IITA-Proyectos/open-soccer-robocup-team2026/docs/competencia/assets/drafts/fig_arbol_fallos.png

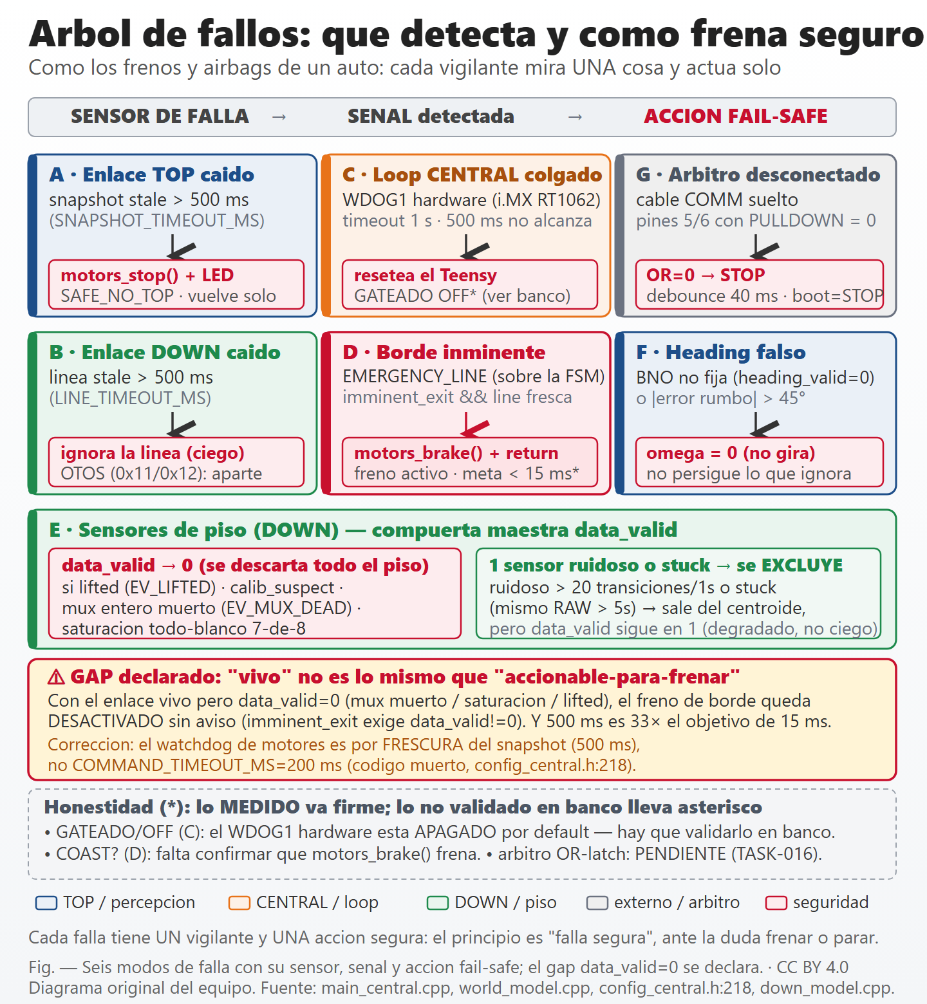
docs/competencia/assets/drafts/fig_arbol_fallos.png
