IITA-Proyectos/open-soccer-robocup-team2026/docs/competencia/assets/drafts/fig_capas_abstraccion.png

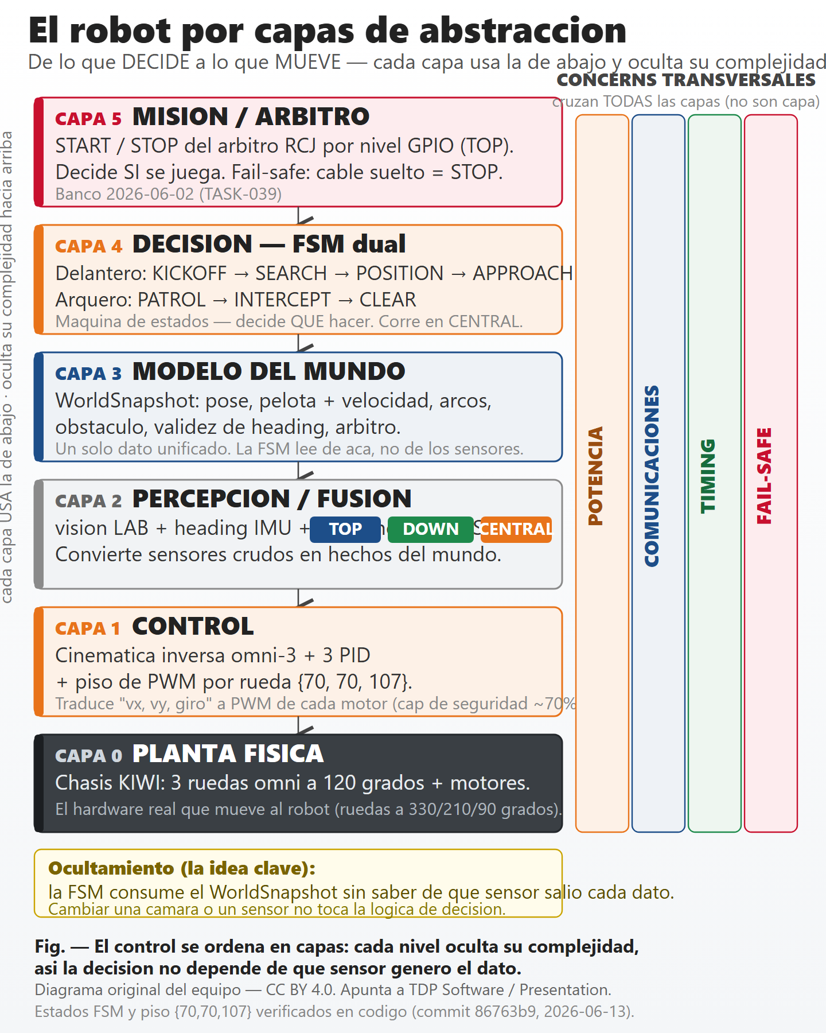
docs/competencia/assets/drafts/fig_capas_abstraccion.png
