IITA-Proyectos/open-soccer-robocup-team2026/hardware/electrical/README.md

# Sistema eléctrico

Documentación de baterías, motores, drivers y distribución de potencia.

## Contenido esperado

- Especificaciones de baterías (tipo, voltaje, capacidad, carga)
- Especificaciones de motores (TT motors, servos, solenoides)
- Drivers de motor (H-bridge, especificaciones, conexiones)
- Diagrama de distribución de potencia
- Cálculos de consumo y autonomía

## Del equipo 2025

Se usaron motores TT con drivers H-bridge. Revisar `legacy/2025-season/` para detalles.
