IITA-Proyectos/open-soccer-robocup-team2026/competition/rules/README.md

# Reglas de la competencia

Documentación de reglas vigentes para la temporada 2026.

## Reglas internacionales

- **[Reglas Soccer 2026 DRAFT](https://robocup-junior.github.io/soccer-rules/2026-soccer-draft-rules/rules.html)** ← USAR ESTAS
- [Reglas Soccer estables (master)](https://robocup-junior.github.io/soccer-rules/master/rules.html)
- [Scoring (puntaje)](https://robocup-junior.github.io/soccer-rules/master/scoring.html)
- [Especificaciones del campo](https://robocup-junior.github.io/soccer-rules/master/field_specification.html)
- [Especificaciones de la pelota](https://robocup-junior.github.io/soccer-rules/master/ball_specification.html)
- [Reglas SuperTeam](https://robocup-junior.github.io/soccer-rules/master/superteam_rules.html)
- [Reglas generales RoboCupJunior](https://junior.robocup.org/robocupjunior-general-rules/)

## NOTA: Nombre de la liga

A partir de 2026, Soccer Open se llama **Soccer Vision** y Soccer Lightweight se llama **Soccer Infrared**. Nuestro equipo compite en **Soccer Vision**.

## Restricciones físicas del robot (Soccer Vision)

| Parámetro | Límite | Recomendación |
|---|---|---|
| Diámetro | **18.0 cm** (cilindro) | ≤17.7 cm para inspecciones suaves |
| Altura | **18.0 cm** | ≤17.7 cm (sin contar handle ni top marker) |
| Peso | **Sin límite** | Minimizar para agilidad |
| Zona captura pelota | **1.5 cm** | ⚠️ Reducido de 3.0cm. Revisar dribbler |
| Voltaje máximo | 48V DC / 25V AC | Puntos de medición accesibles |
| Comunicación | 2.4 GHz, ≤100 mW EIRP | No garantizado |

## Communication Module — OBLIGATORIO

- Provisto por los organizadores en la competencia internacional
- Interfaz: **1 pin GPIO de 2.54mm** (start/stop)
- Alimentación: directo a batería (5.3V-25V) sin switch, 500mA mínimo
- Siempre encendido (incluso con robot fuera del campo)
- Debe estar a ≥1cm del borde exterior
- No cuenta para peso ni altura máxima
- Más info: https://github.com/robocup-junior/soccer-communication-module

## Handle (asa) — OBLIGATORIO

- Debe permitir levantar el robot
- **5 cm de clearance** entre parte más alta del robot y el asa
- Puede exceder el límite de altura
- Su peso cuenta en el total

## Top Marker — OBLIGATORIO

- Círculo plástico blanco, **≥4 cm de diámetro**
- Montado horizontal en la parte superior
- El árbitro escribe números con marcador
- Puede exceder el límite de tamaño
- Sin top marker = no puede jugar

## Documentación obligatoria para RoboCup 2026

| Entregable | Detalle | Deadline estimado |
|---|---|---|
| BOM | Componentes, proveedor, nuevo/reusado, kit/custom, precio | Antes de competencia |
| Poster A1 | 60×84cm, resumen del diseño | Llevar impreso |
| Video técnico | Demo funcional + proceso de diseño | Antes de competencia |
| Portfolio digital | Hardware + software completo | Antes de competencia |
| Código compartido | En GitHub repos oficiales de RoboCupJunior | Antes de competencia |

## Reglas nacionales (Argentina)

- [Reglas nacionales (Google Docs)](https://docs.google.com/document/d/10VgMxnmTzKQiAOIgHjWHb9KzwLUDc66N0ZvooTC_tL8/edit?tab=t.0)

**TODO**: Traducir los cambios de las reglas 2026 al castellano.
