IITA-Proyectos/open-soccer-robocup-team2026/hardware/electronics/MAPA-CONEXIONES-3-PLACAS.md

---
title: "Mapa único de conexiones — las 3 placas (UART + I²C + USB)"
date: 2026-06-02
status: vigente
area: hardware / firmware
tipo: referencia-consolidada
---

# Mapa de conexiones — TOP · CENTRAL · DOWN

> Referencia ÚNICA de qué puerto usa cada placa y para qué. Consolida lo que estaba
> disperso en los pinouts por placa. **La verdad de pines vive en el código**
> (`src/top/pinout_common.h` + `pinout_robotN.h`, `src/central/config_central.h`,
> `src/down/config_down.h`); si algo acá contradice al código vivo, gana el código.

## 0. ⚠️ Lo más importante: "Serial" NO es uno solo

En Teensy hay **dos cosas distintas** que se llaman "serial", y **no chocan entre sí**:

| Nombre | Qué es | Para qué |
|---|---|---|
| **`Serial`** | El **USB** (el conector + cable). Hardware aparte. | **Flashear y monitorear** (`pio device monitor`, `Serial.print` de debug). |
| **`Serial1`…`Serial8`** | Los **UART por pines** del Teensy. | Comunicación **entre placas**. |

👉 **Conclusión clave:** el USB (`Serial`) está **siempre disponible** para programar y
monitorear las **3 placas a la vez**, y **NO consume ningún pin** ni interfiere con los
enlaces entre placas. **No hay ningún UART que "liberar"** para simplificar la
programación — ya es independiente. (Teensy 4.0 tiene 7 UART y la 4.1 tiene 8; sobran.)

---

## 1. UART por placa

### TOP — Teensy 4.0 (master: visión + IMU + ToF + árbitros + fusión)
| Puerto | RX | TX | Conecta con | Baud | Para qué |
|---|----|----|---|---|---|
| **`Serial`** (USB) | — | — | PC | — | flasheo + monitor (debug) |
| **`Serial1`** | 0 | 1 | ← DOWN | 230400 | recibe odometría OTOS (pose + vel) + línea (`LineStatusV2`, broadcast; cacheada, no consumida aún) |
| **`Serial2`** | 7 | 8 | ↔ COMM (ESP32-C6) | 115200 | **partner ESP-NOW / status** (el árbitro NO viene por acá; ver §1.1) |
| **`Serial3`** | 15 | 14 | ← cámara **frontal** (U8) | 19200 | blobs pelota/arcos (11 bytes, contrato v2 CRC8) |
| **`Serial4`** | 16 | 17 | → CENTRAL | 230400 | envía `WORLD_SNAPSHOT` (100 Hz) |
| **`Serial5`** | 21 | 20 | ← cámara **trasera** | 19200 | blobs pelota/arcos (11 bytes, contrato v2 CRC8) |

> **⚠️ FIX 2026-06-02 (Gustavo, banco):** el Teensy 4.0 del TOP **NO expone `Serial7` (28/29)
> en el borde** — son pads SMD traseros, no cableables con header. TASK-204 había puesto el
> enlace a CENTRAL en `Serial7` por error y el TOP **nunca le llegaba** a la CENTRAL
> (`snap_fresh=N`). Mapeo REAL del TOP: **`Serial2` (7/8) = COMM**, **`Serial4` (16/17) =
> CENTRAL**. El lado CENTRAL (Teensy **4.1**) SÍ tiene 28/29 en el borde → su `Serial7` queda igual.

*Libres:* `Serial6` (24/25) no se usa como UART (esos pines los toma **`Wire2`** = LPI2C4, el bus del BNO055 primario; ver §3) · `Serial7` (28/29) = pads traseros del 4.0, **no usables**.

#### 1.1 Árbitro RCJ (START/STOP) — **NIVEL GPIO, no UART**
*(fix 2026-06-02 / TASK-039: el árbitro es NIVEL GPIO en pines 5/6 del TOP, no UART)*

El comando del árbitro RCJ (PLAY/STOP del partido) llega al TOP como **nivel digital GPIO**, **NO por UART**:

| Pin TOP | Señal | Nivel |
|---|---|---|
| **5** | OUT1 (PLAY/STOP) | **0 = juego PARADO · 1 = juego EN CURSO (3.3 V)** |
| **6** | OUT2 (segunda salida — **NO es espejo**: en PLAY sube SOLO uno de los dos) | misma semántica que OUT1; el firmware combina por **OR** |

- Firmware (`src/top/comm_arbiter.cpp`): `read_referee_gpio()` lee los pines 5/6 con `INPUT_PULLDOWN`; `match_running = (pin5 O pin6)` en alto (**OR**). En PLAY el COMM sube **solo uno** de los dos pines (5 *o* 6) y el otro queda en 0 (probado en banco 2026-06-02, Gustavo): por eso el viejo AND nunca daba GO y el OR sí. Sigue siendo *fail-safe*: si se desconecta el cable del COMM, ambos pines leen 0 por el `INPUT_PULLDOWN` → `match_running=false` (STOP).
- El `Serial2` (7/8) del enlace a COMM queda **SOLO para partner ESP-NOW / status**; el viejo frame `COMM_REFEREE_CMD` por UART quedó **obsoleto**.
- ⚠️ **El cambio es solo la FUENTE en el TOP.** El `match_running` / `referee_cmd` sigue viajando **dentro del `WORLD_SNAPSHOT`** que el TOP manda a la CENTRAL; la CENTRAL y la strategy lo consumen igual que antes.

### CENTRAL — Teensy 4.1 sobre Zircon Rev v15 (cerebro: FSM + PIDs + motores)
| Puerto | RX | TX | Conecta con | Baud | Para qué |
|---|----|----|---|---|---|
| **`Serial`** (USB) | — | — | PC | — | flasheo + monitor (debug) |
| **`Serial7`** | 28 | 29 | ← TOP | 230400 | recibe `WORLD_SNAPSHOT` |
| **`Serial1`** | 0 | 1 | ← DOWN | 230400 | recibe `LINE_URGENT` / `LineStatusV2` + odometría OTOS (`Pose2D`/`Velocity2D`, broadcast; OTOS para control de movimiento — Capa 2) |

*Motores:* GPIO directo (INA/INB/PWM), **no UART**. *Kicker:* **no existe** — el robot no tiene kicker físico; el delantero empuja la pelota por inercia (TASK-011 cancelada 2026-06-03).
*✅ Reasignado 2026-05-31 (decisión Gustavo, cableado en banco):* el link a **TOP usa `Serial7` (28/29)** y el de **DOWN usa `Serial1` (0/1)**. Así `Serial2` (pines 7/8) queda **LIBRE para el driver del motor 2 (U17)** → el viejo conflicto **F8/TASK-036 está RESUELTO** (ya no hay UART en 7/8).

### DOWN — Teensy 4.0 (sensores de piso: 32 línea + 2 OTOS)
| Puerto | RX | TX | Conecta con | Baud | Para qué |
|---|----|----|---|---|---|
| **`Serial`** (USB) | — | — | PC | — | flasheo + monitor (debug) |
| **`Serial1`** | 0 | 1 | → CENTRAL | 230400 | difunde línea (`LineStatusV2`) + odometría OTOS (broadcast) |
| **`Serial5`** | 21 | 20 | → TOP | 230400 | difunde línea (`LineStatusV2`) + odometría OTOS (broadcast) |

---

## 2. Enlaces entre placas (las dos puntas)

> Cada enlace usa un **nombre de Serial distinto en cada punta** (son Teensy distintos
> en placas separadas; lo único que importa es el **pin físico + GND común**). Hay dos
> "Serial5" y dos "RX en pin 0" en el sistema — **no colisionan** porque están en placas
> distintas.

| Enlace | TX (placa · puerto · pin) | RX (placa · puerto · pin) | Baud | Estado |
|---|---|---|---|---|
| **TOP → CENTRAL** (snapshot) | TOP · `Serial4` · **pin 17** (TX4) | CENTRAL · `Serial7` · **pin 28** (RX7) | 230400 | 🔧 fix 2026-06-02 (era `Serial7` en el TOP, inexistente en el borde del 4.0) |
| **DOWN → TOP** (línea + odometría OTOS) | DOWN · `Serial5` · **pin 20** | TOP · `Serial1` · **pin 0** | 230400 | ⚠️ sin cablear |
| **DOWN → CENTRAL** (línea + odometría OTOS) | DOWN · `Serial1` · **pin 1** | CENTRAL · `Serial1` · **pin 0** | 230400 | ✅ cable validado (DOWN→CENTRAL OK en banco 2026-06-02) |
| **TOP ↔ COMM** (partner ESP-NOW / status) | TOP · `Serial2` · **7/8** | COMM (ESP32-C6) | 115200 | 🔧 fix 2026-06-02 (era `Serial4`) · el árbitro NO viaja por acá: es NIVEL GPIO en pines 5/6 del TOP (TASK-039, ver §1.1) |
| **cámara frontal → TOP** | cam · UART3 | TOP · `Serial3` · pin 15 | 19200 | ✅ FORMATO OK |
| **cámara trasera → TOP** | cam · UART3 | TOP · `Serial5` · pin 21 | 19200 | ✅ FORMATO OK |

**Siempre:** cada enlace necesita **GND común** entre las dos placas.

---

## 3. I²C (ToF, BNO, OTOS) — NO son UART

I²C es un **bus**: muchos chips comparten **los mismos 2 pines** (SDA + SCL) y se
distinguen por **dirección**, no por pin. "Comparten pines" a propósito. Es un
periférico distinto de los UART y del USB.

### TOP — 3 buses I²C del Teensy 4.0
> **🔧 CORRECCIÓN 2026-06-09 (i2c scan en banco, commit 9da8e9e):** el Teensy 4.0 tiene
> **3 buses I²C**: `Wire` (LPI2C1, pines 18/19) · `Wire1` (LPI2C3, pines 16/17) · `Wire2`
> (LPI2C4, pines **24/25**). El 2º BNO055 del TOP está **físicamente en los pines 24/25**
> (pads traseros, "debajo" del Teensy) = bus **`Wire2`**. El repo lo llamaba mal "Wire1"
> porque 24/25 se confundían con Wire1; el bus real de 24/25 es **`Wire2`**. `Wire1` (16/17)
> queda vacío.

| Bus | SDA | SCL | Chips (dirección) |
|-----|-----|-----|---|
| **`Wire`** (LPI2C1) | **18** | **19** | BNO055 **SECUNDARIO** (0x28) + **4 ToF** VL53L7CX (0x2A · 0x2B · 0x2C · 0x2D) |
| **`Wire2`** (LPI2C4) | **25** | **24** | BNO055 **PRIMARIO** (0x28) — solo en su bus, sin ToF |
| `Wire1` (LPI2C3) | 16 | 17 | **vacío** (pines tomados por Serial4 = UART a CENTRAL) |

- **El BNO055 primario está SOLO en `Wire2` (24/25)** y el secundario comparte `Wire`
  (18/19) con los 4 ToF. Ambos son 0x28 (no chocan porque están en buses distintos).
- **Convención primario/secundario (decisión Gustavo 2026-06-09):** el BNO que está **solo
  en su bus** (`Wire2`, sin ToF) **no sufre contención I²C con los ToF** → es el **más
  confiable** y la **fuente de heading preferida** = **PRIMARIO**. El que comparte bus con
  los 4 ToF es el que se **congela** cuando el read del BNO choca con los ToF → es el
  **respaldo** = **SECUNDARIO**. (Esto define además el fix de fondo de ROBOT1: hoy ROBOT1
  tiene 1 BNO en `Wire` con los ToF = posición "secundaria"; el fix es agregarle un BNO en
  `Wire2` solo, como primario.)
- Los 4 ToF arrancan todos en 0x29 (chocarían) → cada uno tiene una pata **LP** a un
  GPIO (**pines {9, 10, 11, 12}**, eso **NO es I²C**, es GPIO) que al boot los despierta
  de a uno y les reasigna 0x2A..0x2D. ⚠️ Las direcciones **persisten con 3V3** →
  **power-cycle obligatorio** al re-enumerar.
- ⚠️ **pin 10** (LP del ToF[1]) choca con el dipswitch de rol del TOP → resolver (F7).

### CENTRAL — sin I²C
**No hay BNO ni ningún chip I²C en la CENTRAL** (los 2 BNO están en el TOP). El heading
absoluto del robot llega desde el TOP por `WORLD_SNAPSHOT`. *(El módulo `imu_zircon` del
firmware queda como compat: si no hay sensor, `imu_init()` cae por timeout y no se usa.)*

### DOWN — 2 OTOS en 2 buses separados
| Bus | SDA | SCL | Chip (dirección) |
|-----|-----|-----|---|
| **`Wire`** (I²C0) | **18** | **19** | OTOS **U5** (0x17) |
| **`Wire1`** (I²C1) | **17** | **16** | OTOS **U6** (0x17) |

- Los 2 OTOS tienen la **misma dirección fija 0x17** (no se puede cambiar) → **no pueden
  ir en el mismo bus** → van en **dos buses distintos** (`Wire` + `Wire1`). (Es lo
  opuesto a los ToF, que sí reasignan dirección y por eso comparten un bus.)
- Los 32 sensores de línea NO son I²C: son 4 muxes CD4051 con 12 pines SEL (pines 2–13) + 4 entradas ADC.

---

## 4. ¿Hay algún pin compartido problemático?

- **I²C vs UART:** en ninguna placa se pisan. TOP: I²C en 18/19 (`Wire`) + 24/25 (**`Wire2`**, BNO055 primario), UART en 0/1·7/8·14/15·16/17·20/21. DOWN: I²C en 18/19 (`Wire`) + 16/17 (`Wire1`), UART en 0/1·20/21. CENTRAL: sin I²C.
- **USB vs todo:** el USB (`Serial`) es independiente — nunca compite con UART ni I²C.
- **✅ Conflicto 7/8 RESUELTO (2026-05-31):** en la **CENTRAL**, el link DOWN→CENTRAL se movió a `Serial1` (0/1), así que los pines 7/8 quedan para el motor 2 (U17). ⚠️ Ojo: el "7/8" del **TOP** es otra cosa — ahí `Serial2` (7/8) = COMM; son placas distintas, no colisionan.
- **🔧 FIX UART TOP (2026-06-02):** el Teensy 4.0 del TOP no expone `Serial7` (28/29 = back-pads). Mapeo corregido: **COMM → `Serial2` (7/8)**, **CENTRAL → `Serial4` (16/17)**. **No quedan conflictos de UART abiertos.**

---

## 5. Dónde está el detalle por placa (docs canónicos)
- **TOP:** [`top-board-pack/01-pinout-y-hardware.md`](top-board-pack/01-pinout-y-hardware.md) §2.
- **DOWN:** [`down-board-pack/01-pinout-y-posiciones.md`](down-board-pack/01-pinout-y-posiciones.md).
- **CENTRAL:** [`central-board-pack/01-pinout-y-hardware.md`](central-board-pack/01-pinout-y-hardware.md) + `src/central/config_central.h`.
- **Flujo de datos / arquitectura:** [`../../docs/ARQUITECTURA-3-PLACAS-2026.md`](../../docs/ARQUITECTURA-3-PLACAS-2026.md).
- **Protocolo de los enlaces:** `src/shared/proto.h` (START / CRC16 / SEQ / END) + `docs/firmware/CONTRATO-DATOS-*.md`.
