IITA-Proyectos/open-soccer-robocup-team2026/hardware/electronics/top-board-pack/02-funcionalidad.md

---
title: "Placa TOP — Especificación funcional (qué hace y cómo)"
date: 2026-05-24
status: vigente
parte-de: top-board-pack
basado-en: docs/firmware/FIRMWARE-PLACA-ARRIBA.md (curado, separando Nivel 1+2 vivo de Nivel 3+ aspiracional)
---

# Placa TOP — Especificación funcional

> Para el pinout completo del Teensy 4.0 master ver [`01-pinout-y-hardware.md`](01-pinout-y-hardware.md).
> Para el contrato binario del WorldSnapshot que TOP envía a CENTRAL ver [`03-contrato-datos-top.md`](03-contrato-datos-top.md).
> Para el protocolo de las cámaras OpenMV ver [`04-contrato-datos-camaras.md`](04-contrato-datos-camaras.md).
> Para el diseño general de comunicaciones de las 3 placas ver [`05-protocolo-comunicaciones.md`](05-protocolo-comunicaciones.md).
> Para el contexto general de las 3 placas ver [`06-arquitectura-3-placas.md`](06-arquitectura-3-placas.md).

## 1. Qué es la placa TOP

La placa TOP es el **cerebro sensorial** del robot. No toma decisiones tácticas
ni controla motores — su trabajo es **ver, fusionar y entregar conocimiento**.

**Entrega al CENTRAL cada 10 ms (100 Hz)** un único struct `WorldSnapshot`
(27 B, v2) con:
- **Pose propia**: x, y, heading + vx, vy, omega + confianza 0–100.
- **Pelota**: posición + velocidad estimada + confianza. Si no es visible, se
  predice por inercia con confianza decayente.
- **Compañero** (futuro): pose recibida vía ESP-NOW.
- **Rivales** (futuro): hasta 2 oponentes estimados.
- **Arcos**: posiciones fijas conocidas, confirmadas cuando se ven.
- **Comando árbitro**: start/stop/halftime recibido por la placa COMM.
- **Flags**: match_running, in_own_penalty_area, partner_alive, partner_sees_ball, IMU degradado, etc.

## 2. ⚙️ Estado de implementación (lo vivo vs lo aspiracional)

**Esta es la separación más importante del doc**, porque la versión histórica
de `FIRMWARE-PLACA-ARRIBA.md` describe Nivel 3+ ambicioso que NO está
implementado todavía.

| Subsistema | Nivel | Estado | Dónde |
|---|---|---|---|
| Parser OpenMV (2 cámaras) | 1 | ✅ vivo | `firmware/top/cameras.{h,cpp}` |
| Fusión cámaras (front + back, rot 180°, watchdog) | 2 | ✅ vivo + 16 tests | `firmware/shared/cameras_fusion.{h,cpp}` + `firmware/top/cameras_runtime.{h,cpp}` |
| BNO055 dual (lectura + consistencia) | 2 | ✅ vivo | `firmware/top/sensors_imu.{h,cpp}` |
| HC-SR04 (frontal) | 1 | ✅ vivo (bloqueante 25 ms) | `firmware/top/sensors_tof.{h,cpp}` |
| **ToF VL53L7CX** | 4 (HW) | ⚠️ HW OK (enumeran 0x2A..0x2D), firmware lee 1 (Sprint B pendiente) | `firmware/top/sensors_tof.{h,cpp}` |
| Comm con COMM (Serial2) | 1 | ✅ vivo (arbiter) | `firmware/top/comm_arbiter.{h,cpp}` |
| Comm con DOWN (Serial1) | 1 | ✅ vivo | `firmware/top/comm_down.{h,cpp}` |
| Comm con CENTRAL (**Serial4**, fix 2026-06-02) | 1 | ✅ vivo | `firmware/top/comm_central.{h,cpp}` |
| **WorldSnapshot v2 con `ball_vx/vy`** | 2 | ⚠️ struct definido pero `cameras_runtime` no llena los campos (quedan en 0) | `firmware/shared/types.h` + tests `test_central_contract` |
| EKF de pose absoluta | 3 | ⏳ futuro | — |
| Kalman pelota (predicción cuando no se ve) | 3 | ⏳ futuro | — |
| Trilateración con ToF para pose XY | 3 | ⏳ futuro (requiere ToF activos) | — |
| Partner comm (ESP-NOW) | 3 | ⏳ **decisión: NO implementar para Incheon** | `docs/decisions/2026-05-17-comunicacion-inter-robot-superteam.md` |
| Estimación de rivales | 4 | ⏳ futuro (Mundial 2027) | — |

## 3. Responsabilidades funcionales

| # | Responsabilidad | Estado | Frecuencia |
|---|---|---|---|
| R1 | Inicializar y mantener los 2 BNO055 (modo IMUPLUS) | ✅ | 100 Hz |
| R2 | Detectar discrepancias entre los 2 BNO055 | ✅ | 100 Hz |
| R3 | Estrategia de reseteo del IMU ante impacto detectado | ⚠️ parcial | evento |
| R4 | Inicializar y leer los 4 ToF multizona | ❌ STUB | 15–30 Hz |
| R5 | Procesar matriz 8×8 de cada ToF para detectar paredes | ❌ futuro | 15–30 Hz |
| R6 | Trilateración con ToF → pose XY del robot | ❌ futuro | 15–30 Hz |
| R7 | Parser robusto del protocolo OpenMV (2 cámaras) | ✅ | ~30 Hz |
| R8 | Fusionar visión dual (frente + atrás) | ✅ | 30 Hz |
| R9 | Recibir ODOM_POSE/VEL del DOWN | ✅ | 100 Hz |
| R10 | Fusión sensorial EKF → pose propia con confianza | ❌ futuro | 100 Hz |
| R11 | Predicción Kalman de pelota | ❌ futuro | 100 Hz |
| R12 | Estimación de rivales | ❌ futuro | 30 Hz |
| R13 | Comm con placa COMM (recibir árbitros) | ✅ | 100 Hz |
| R14 | Recibir partner via COMM (ESP-NOW) | ❌ no para Incheon | 10 Hz |
| R15 | Construir `WorldSnapshot` y enviar a CENTRAL | ✅ | 100 Hz |
| R16 | Recibir comandos administrativos del CENTRAL | ✅ | eventos |
| R17 | Detección de IMU/cámara fallando | ✅ parcial | continuo |
| R18 | Recovery: degradación elegante si una fuente cae | ✅ | continuo |
| R19 | Diagnóstico USB + LED de estado | ✅ | 1 Hz |
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
