IITA-Proyectos/open-soccer-robocup-team2026/docs/competencia/assets/drafts/fig_arbol_salud.png

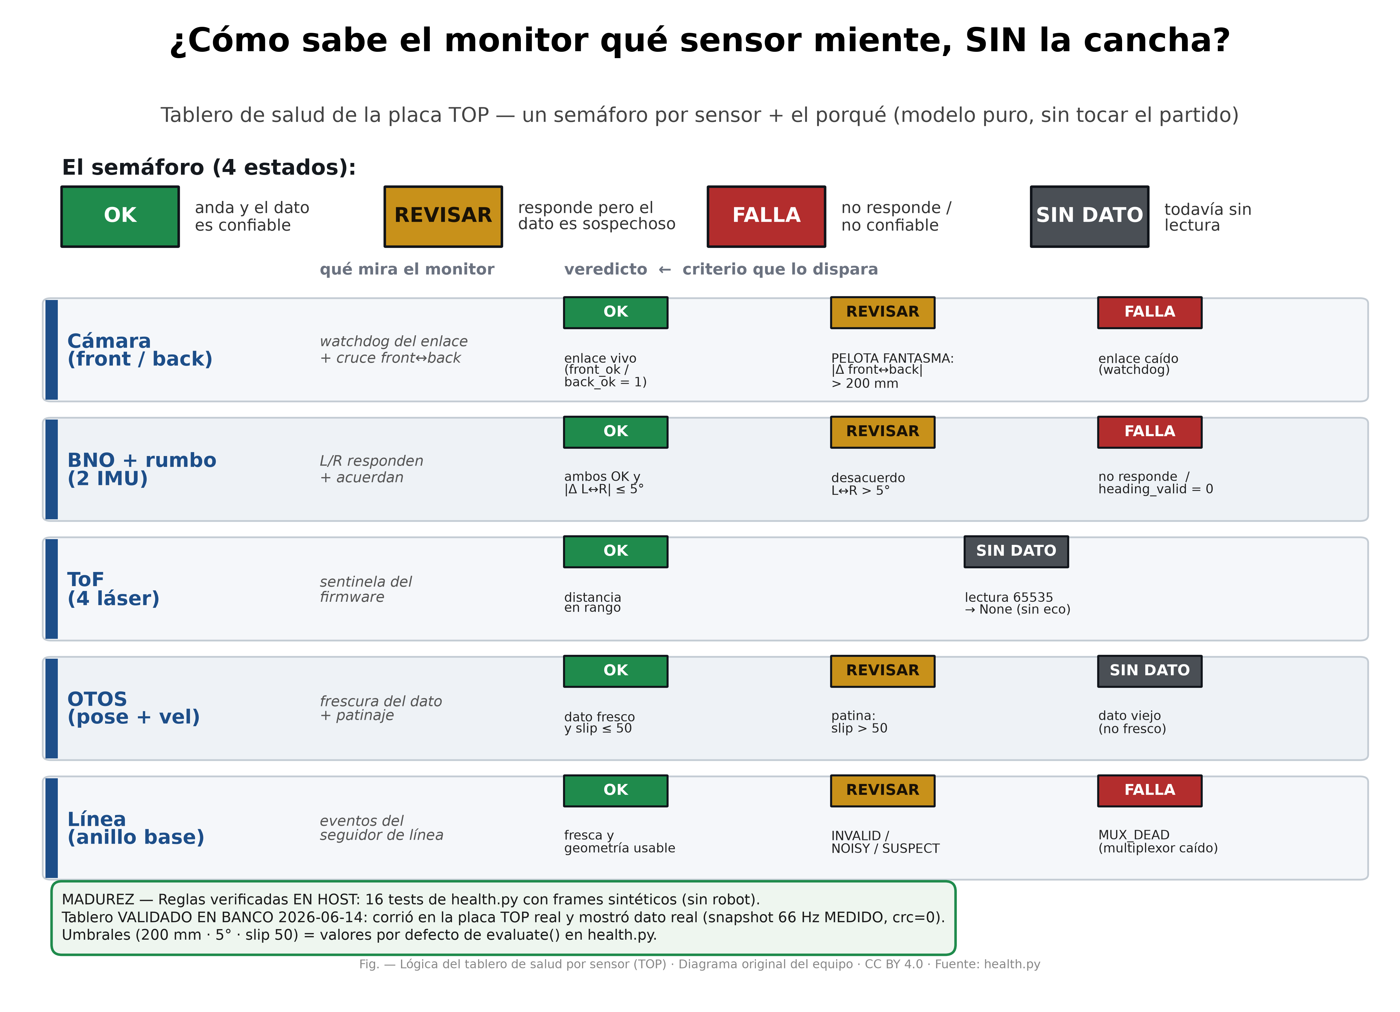
docs/competencia/assets/drafts/fig_arbol_salud.png
