IITA-Proyectos/open-soccer-robocup-team2026/docs/competencia/assets/drafts/fig_electrico_distribucion.png

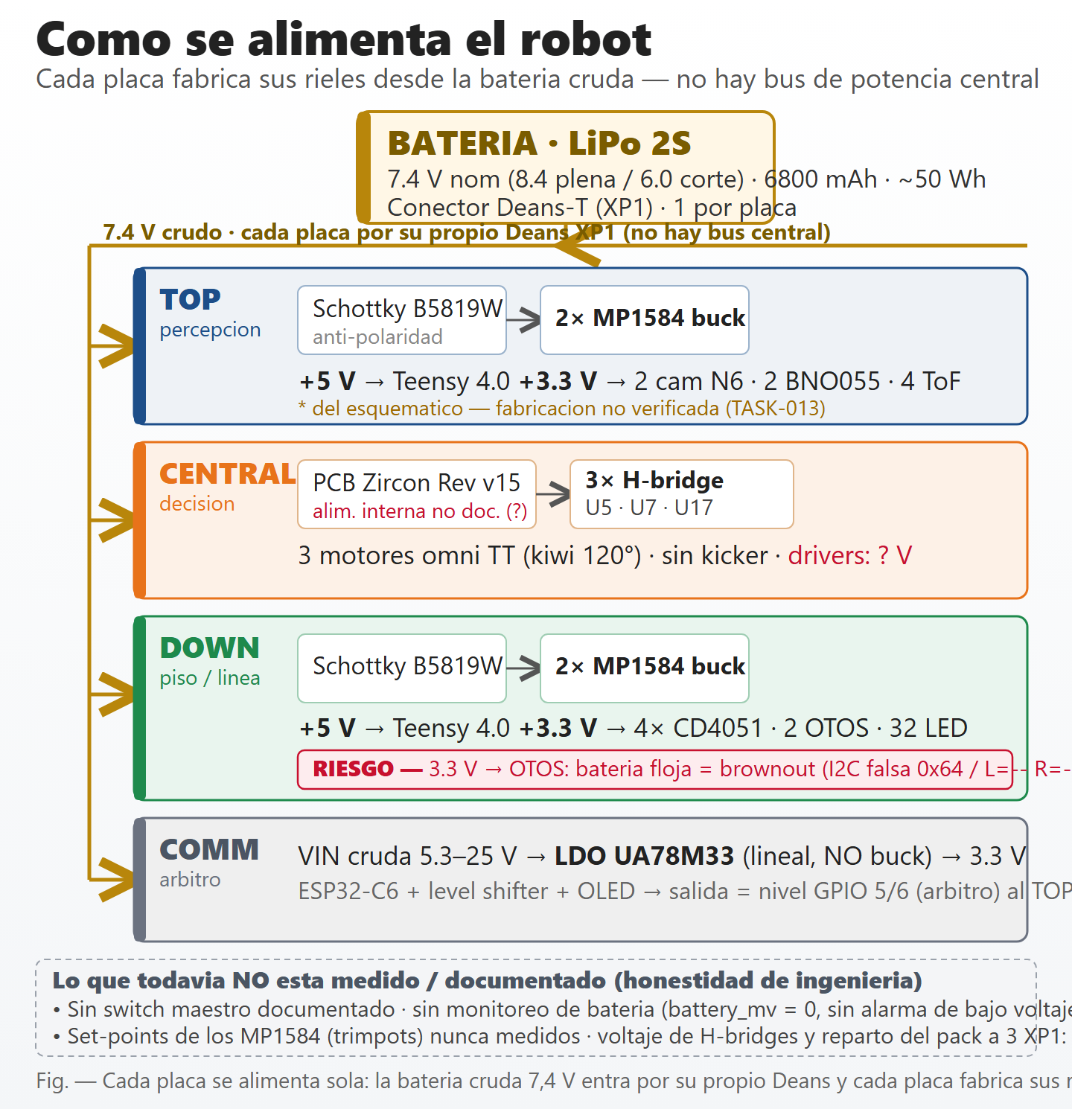
docs/competencia/assets/drafts/fig_electrico_distribucion.png
