IITA-Proyectos/open-soccer-robocup-team2026/docs/competencia/assets/drafts/fig_frame_uart_errores.png

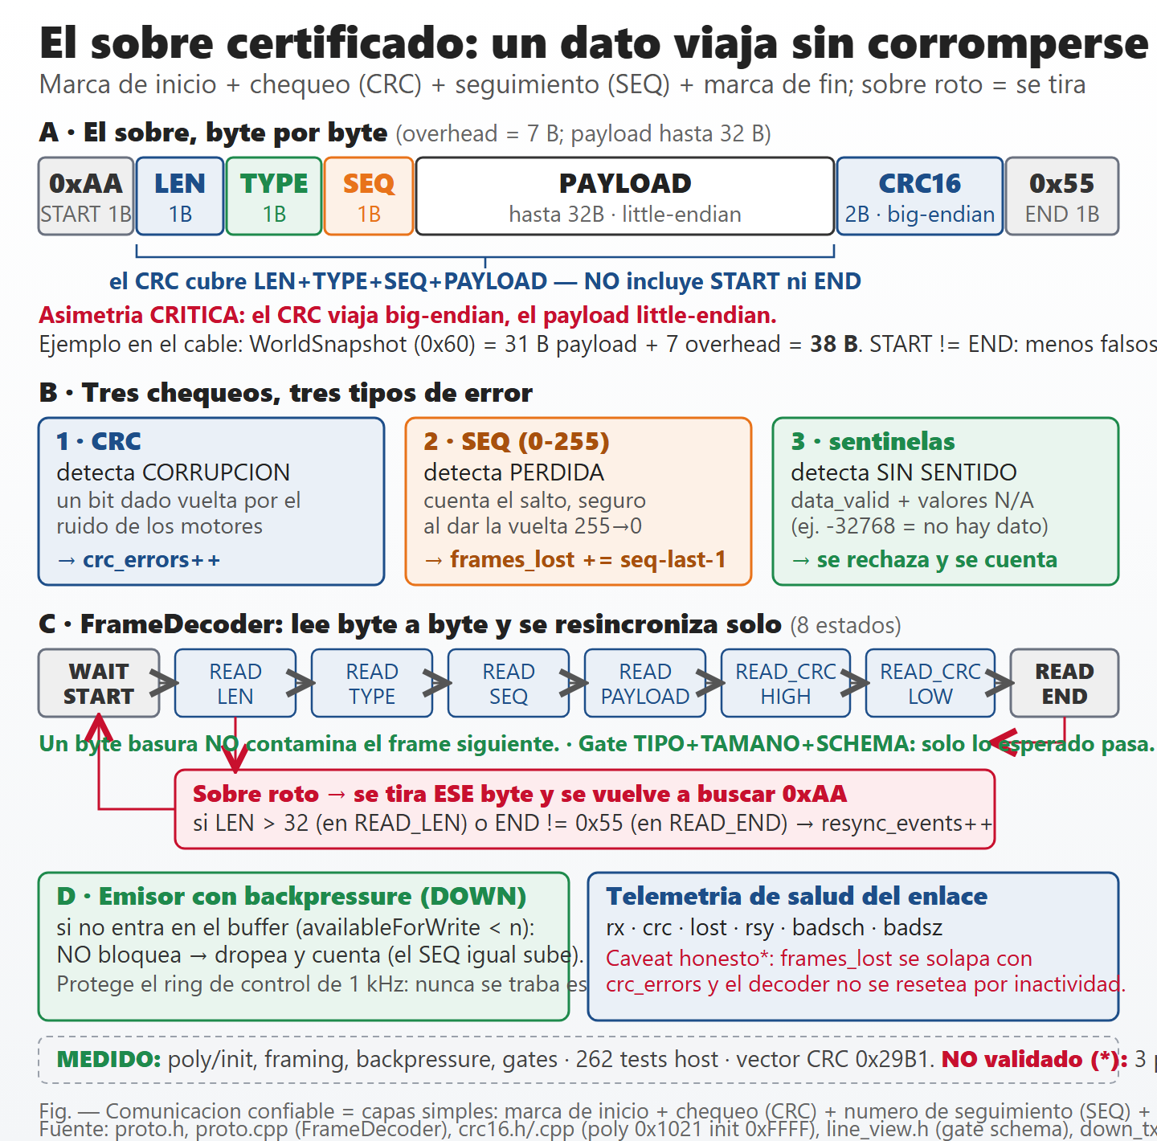
docs/competencia/assets/drafts/fig_frame_uart_errores.png
