IITA-Proyectos/open-soccer-robocup-team2026/docs/competencia/assets/drafts/fig_fsm_dual.png

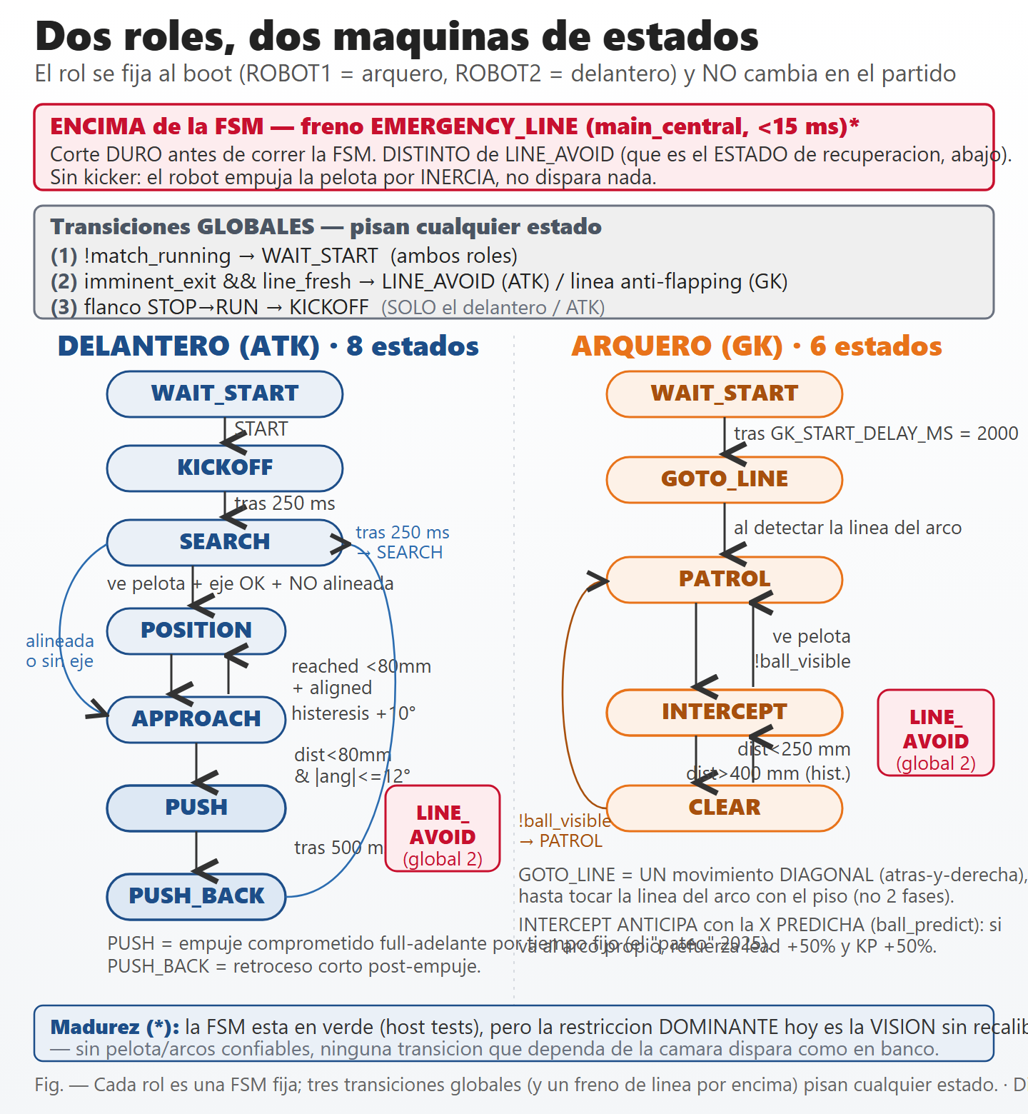
docs/competencia/assets/drafts/fig_fsm_dual.png
