IITA-Proyectos/open-soccer-robocup-team2026/docs/competencia/assets/drafts/fig_funcionamiento_2modulos.png

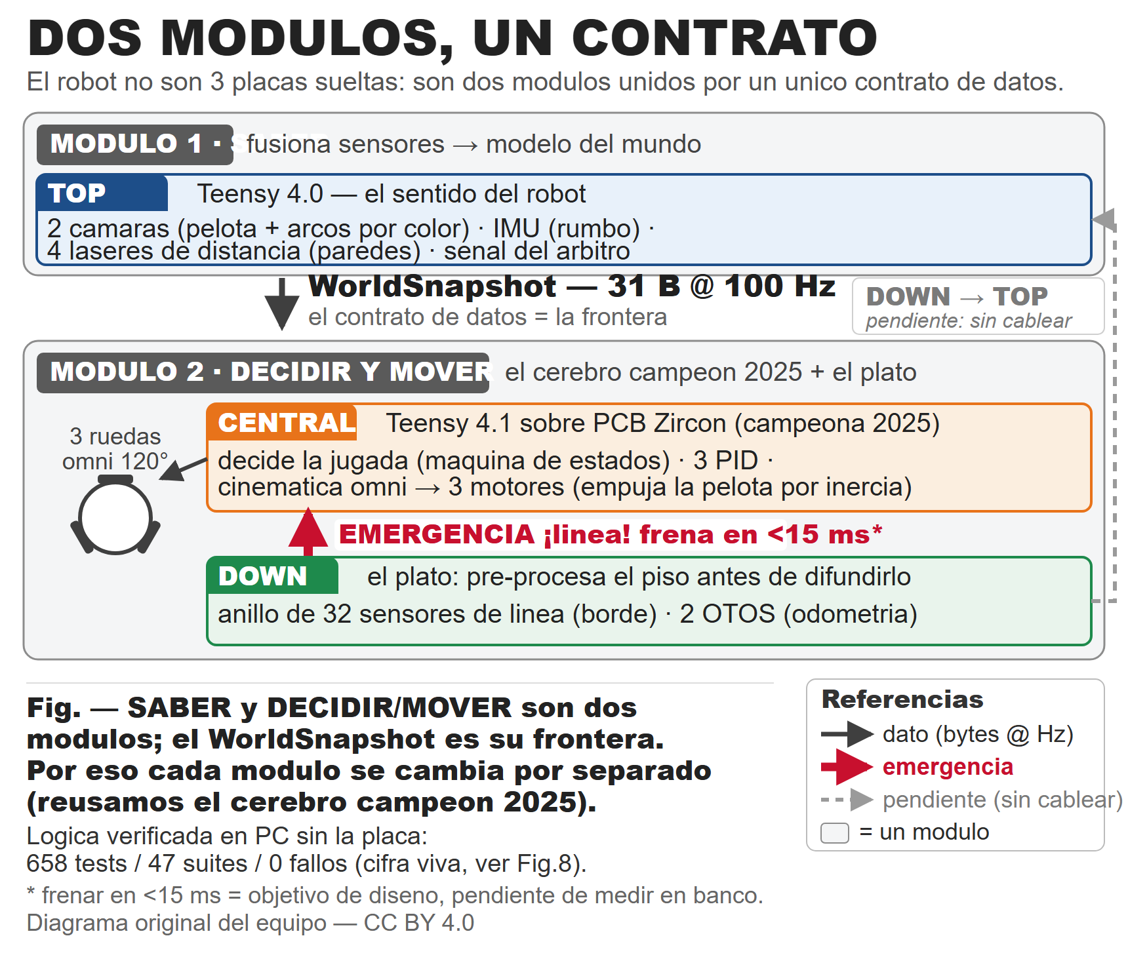
docs/competencia/assets/drafts/fig_funcionamiento_2modulos.png
