IITA-Proyectos/open-soccer-robocup-team2026/docs/competencia/assets/drafts/fig_fusion_snapshot.png

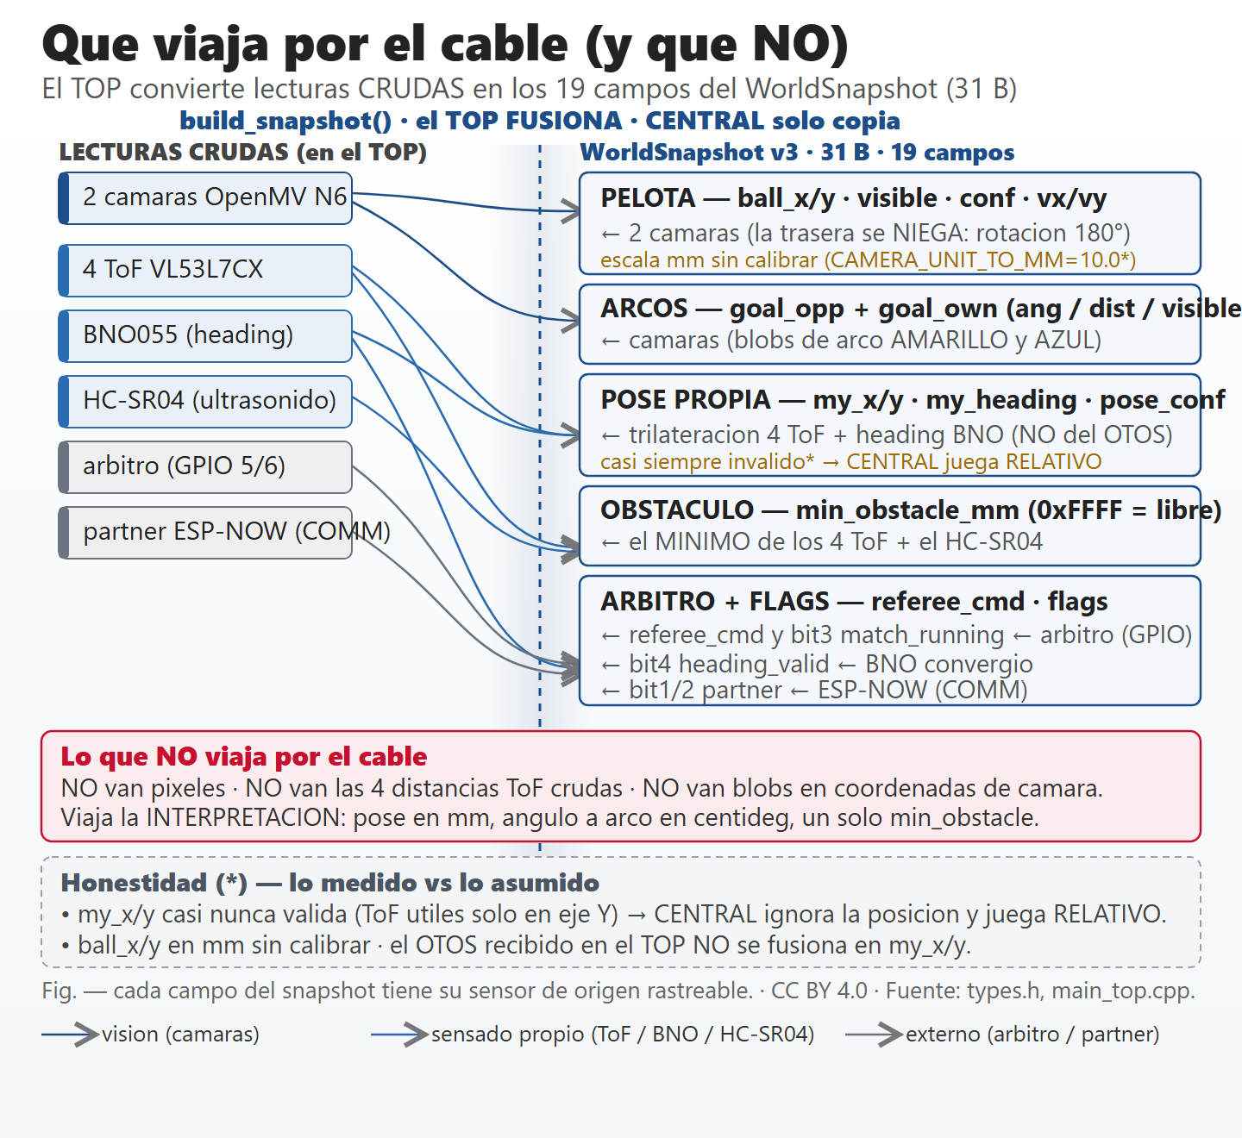
docs/competencia/assets/drafts/fig_fusion_snapshot.png
