IITA-Proyectos/open-soccer-robocup-team2026/docs/competencia/assets/drafts/fig_layout_cobertura.png

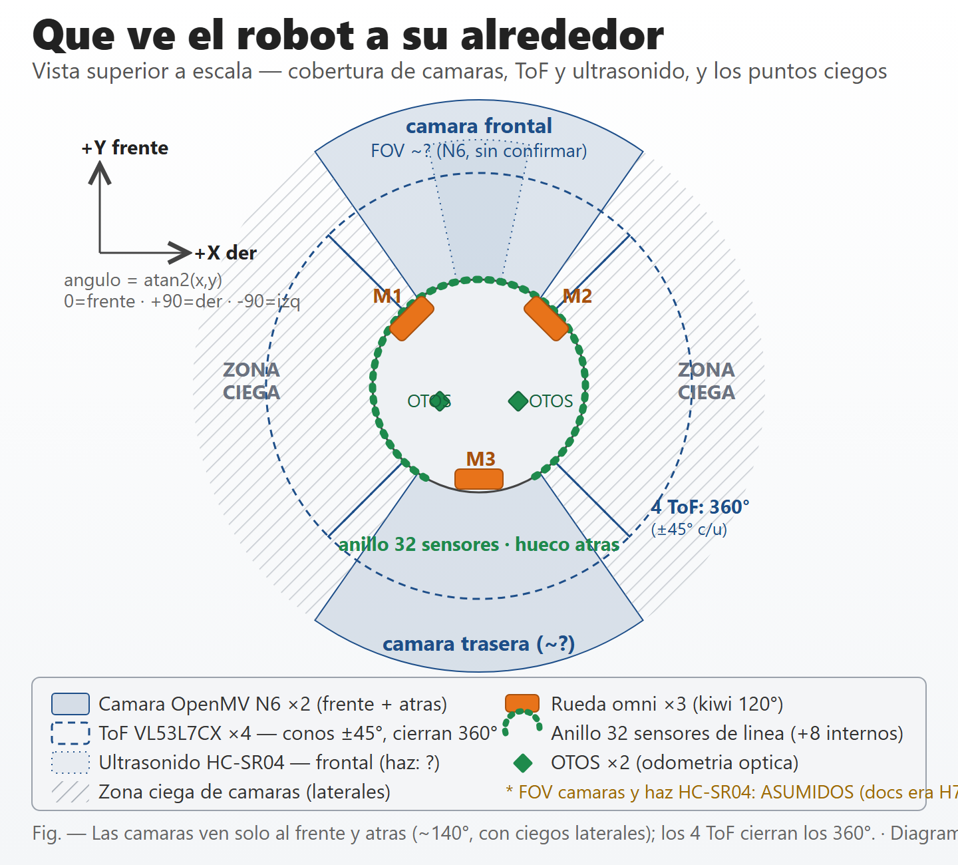
docs/competencia/assets/drafts/fig_layout_cobertura.png
