IITA-Proyectos/open-soccer-robocup-team2026/docs/competencia/assets/drafts/fig_localizacion_fusion.png

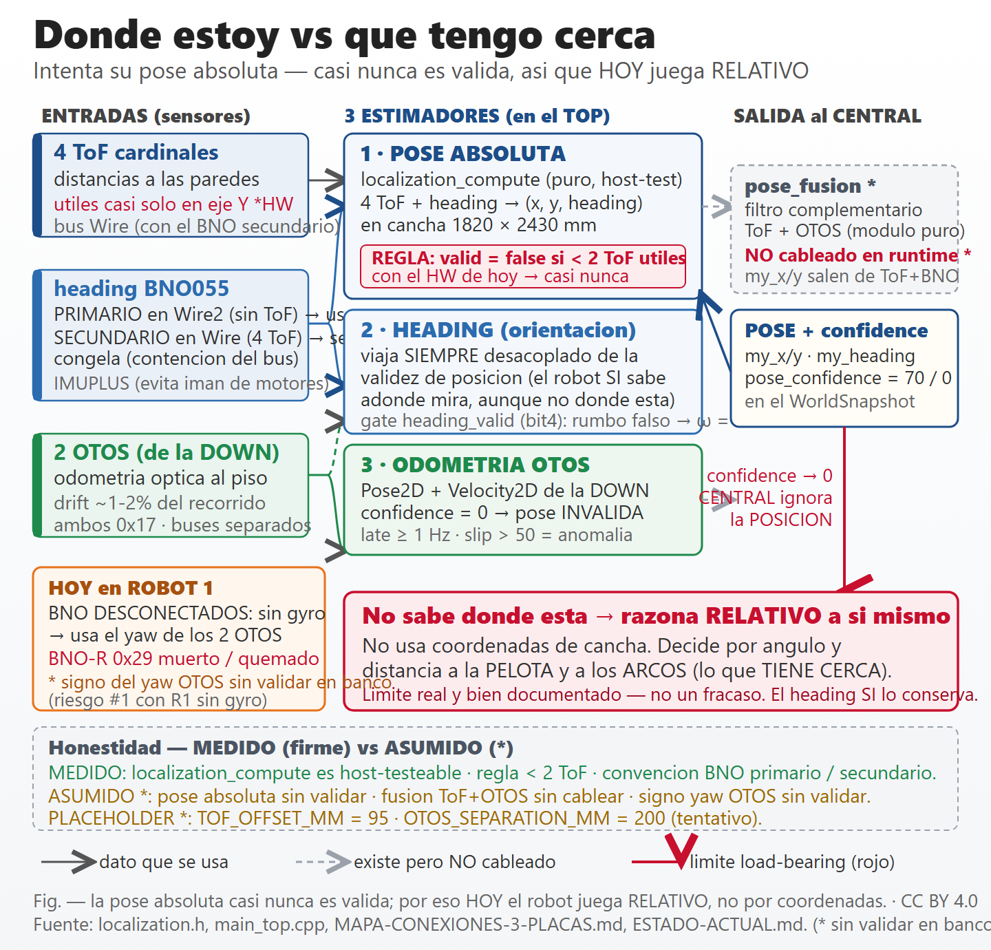
docs/competencia/assets/drafts/fig_localizacion_fusion.png
