IITA-Proyectos/open-soccer-robocup-team2026/docs/competencia/assets/drafts/fig_madurez_escalera.png

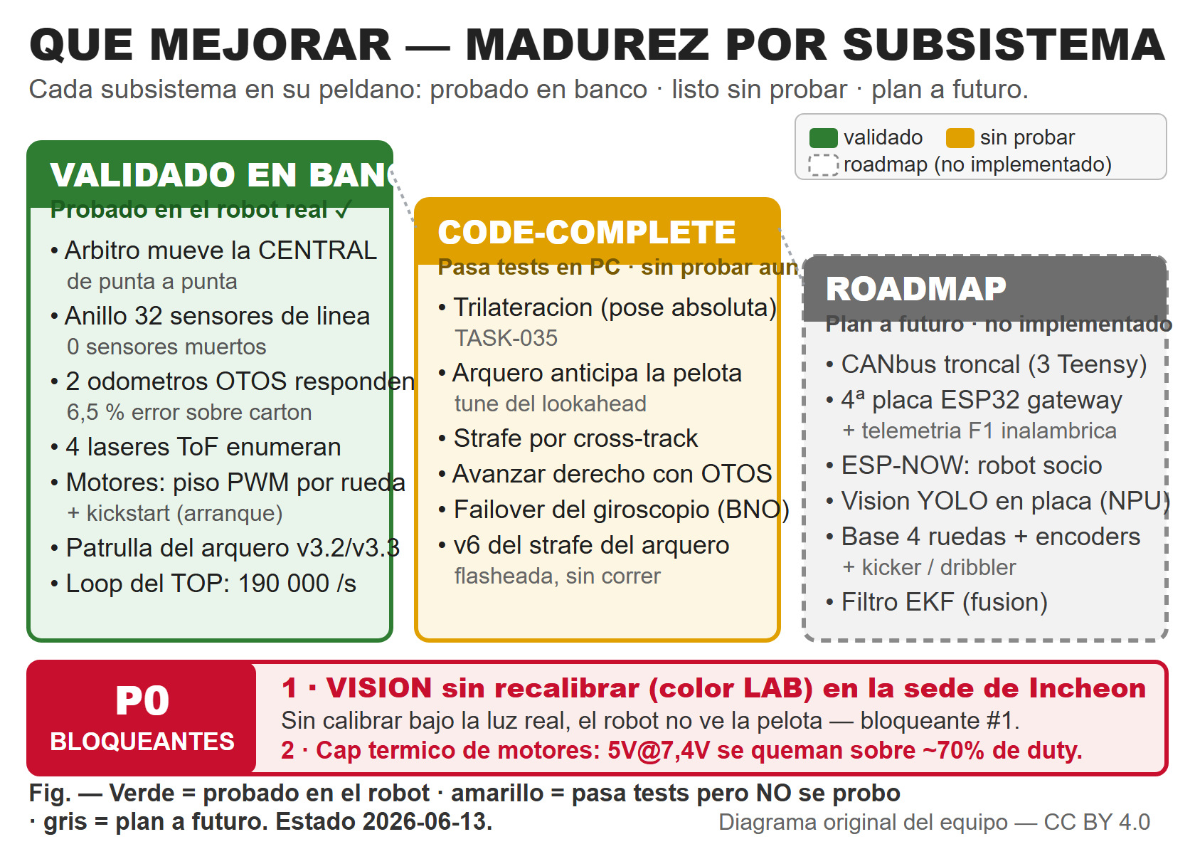
docs/competencia/assets/drafts/fig_madurez_escalera.png
