IITA-Proyectos/open-soccer-robocup-team2026/docs/competencia/assets/drafts/fig_pila_placas_lateral.png

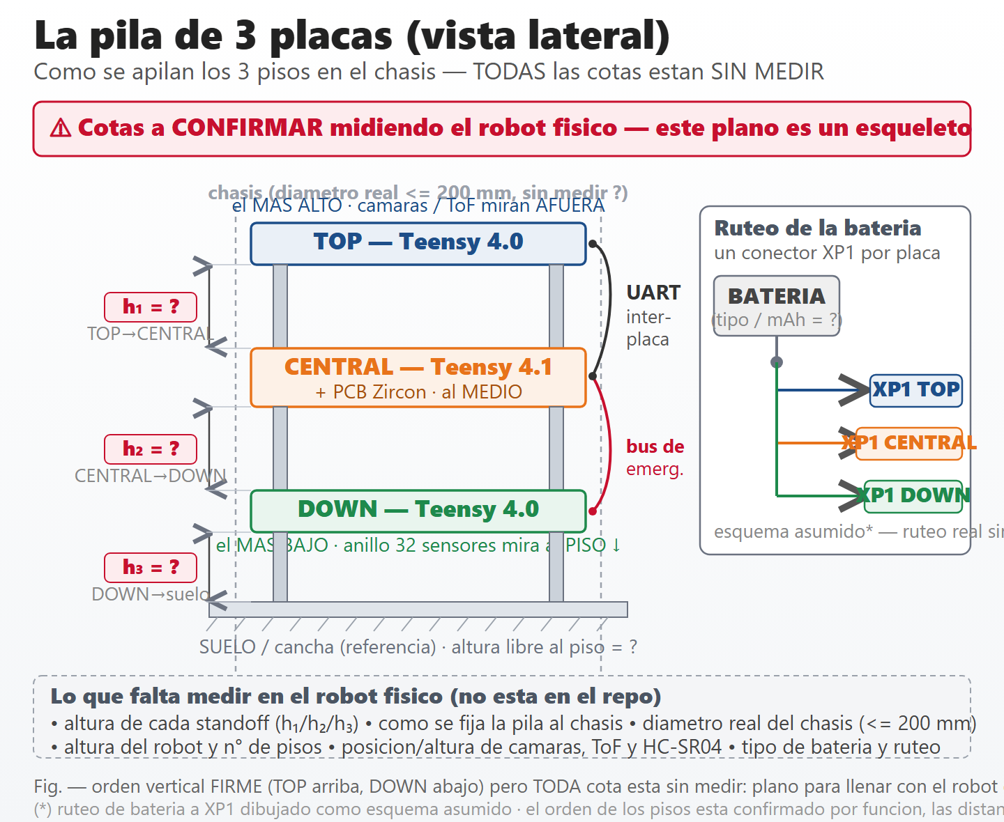
docs/competencia/assets/drafts/fig_pila_placas_lateral.png
