IITA-Proyectos/open-soccer-robocup-team2026/docs/competencia/assets/drafts/fig_pipeline_vision.png

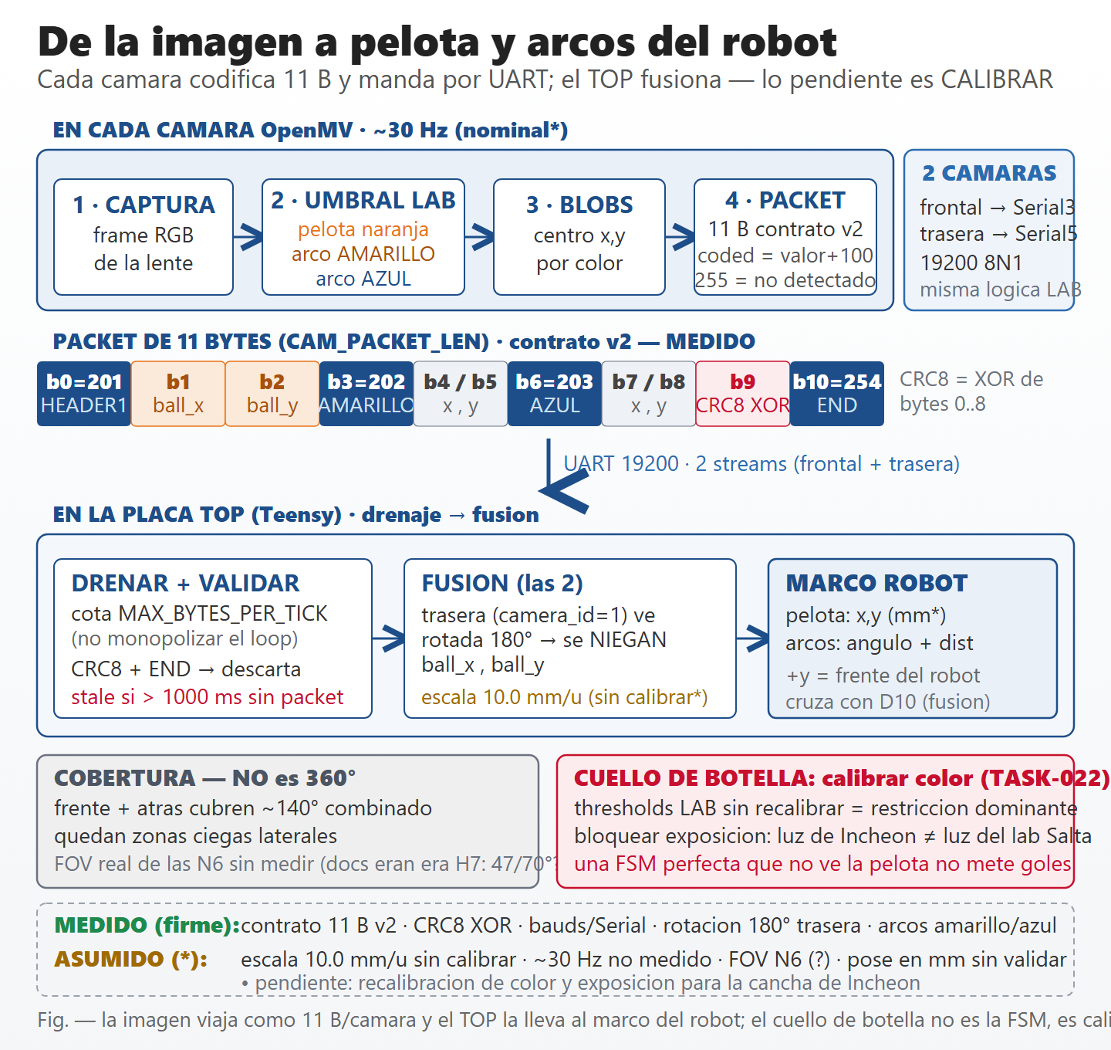
docs/competencia/assets/drafts/fig_pipeline_vision.png
