IITA-Proyectos/open-soccer-robocup-team2026/docs/competencia/assets/drafts/fig_presupuesto_temporal.png

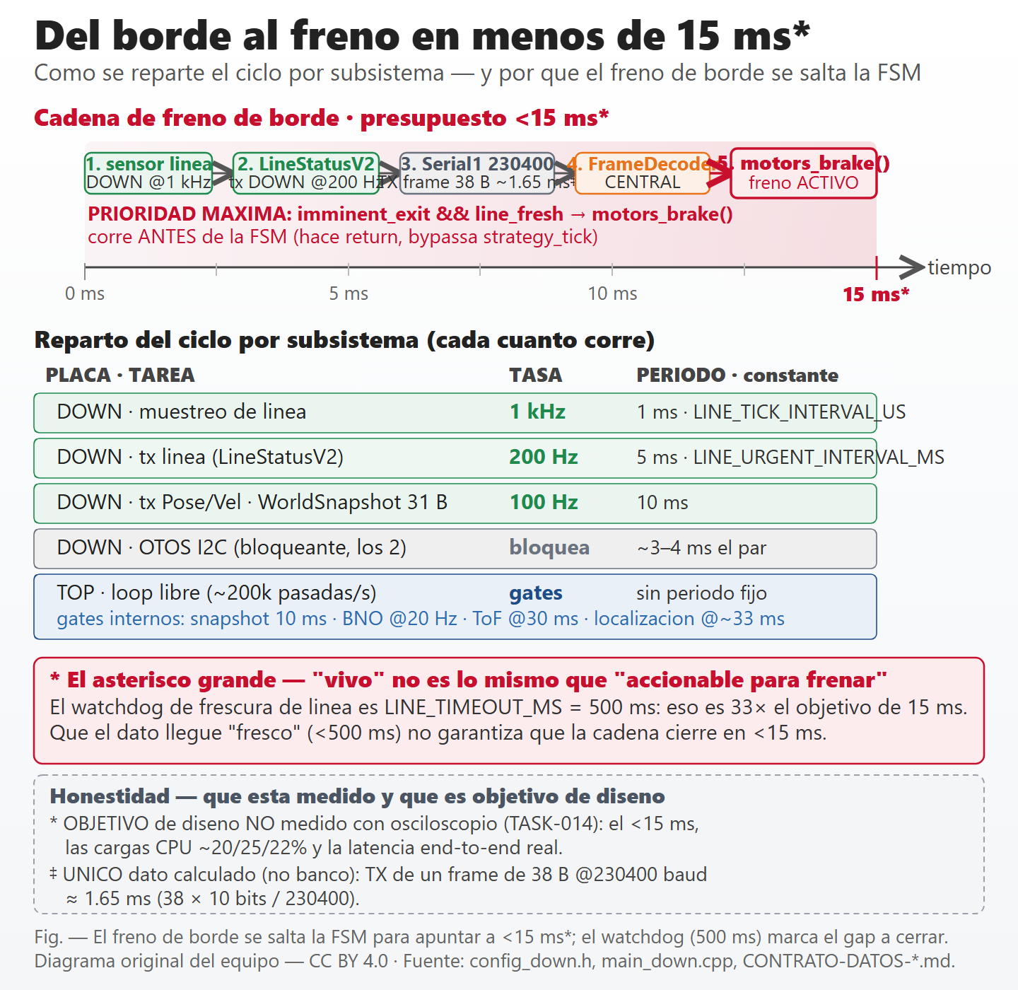
docs/competencia/assets/drafts/fig_presupuesto_temporal.png
