IITA-Proyectos/open-soccer-robocup-team2026/docs/competencia/assets/drafts/fig_r1_vs_r2.png

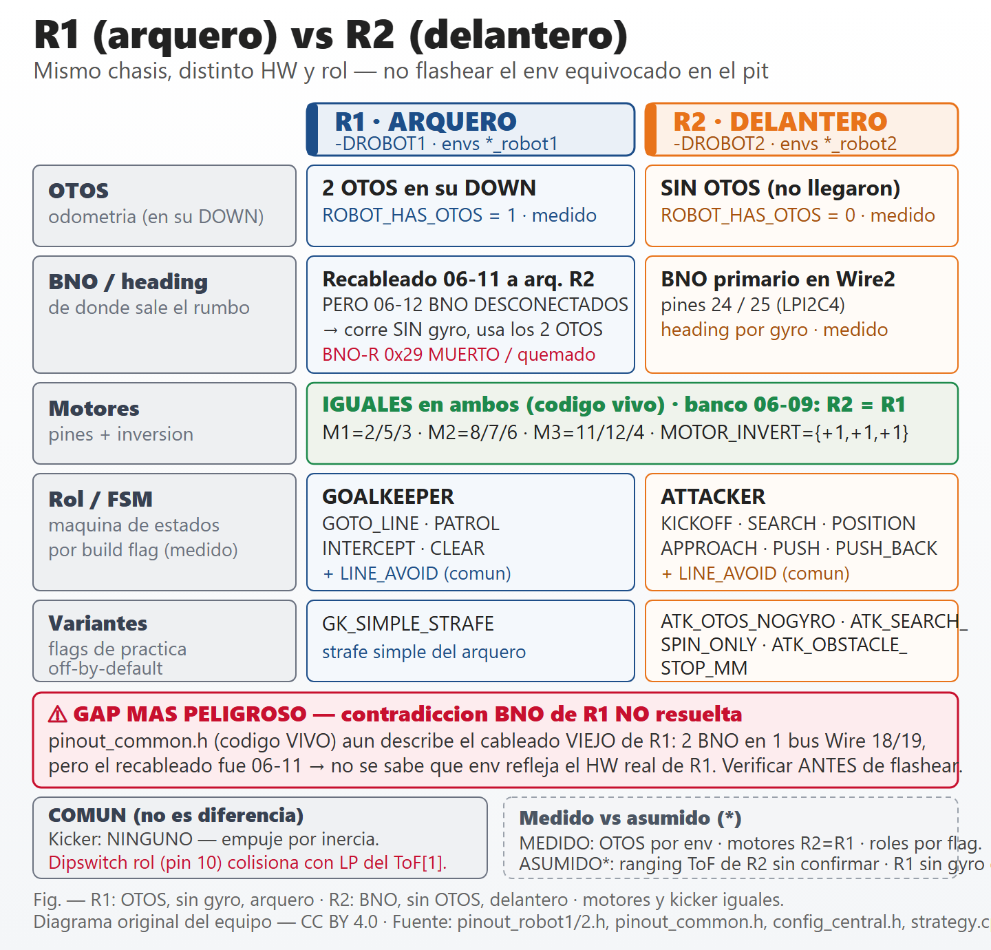
docs/competencia/assets/drafts/fig_r1_vs_r2.png
