IITA-Proyectos/open-soccer-robocup-team2026/docs/competencia/assets/drafts/fig_roadmap_fases.png

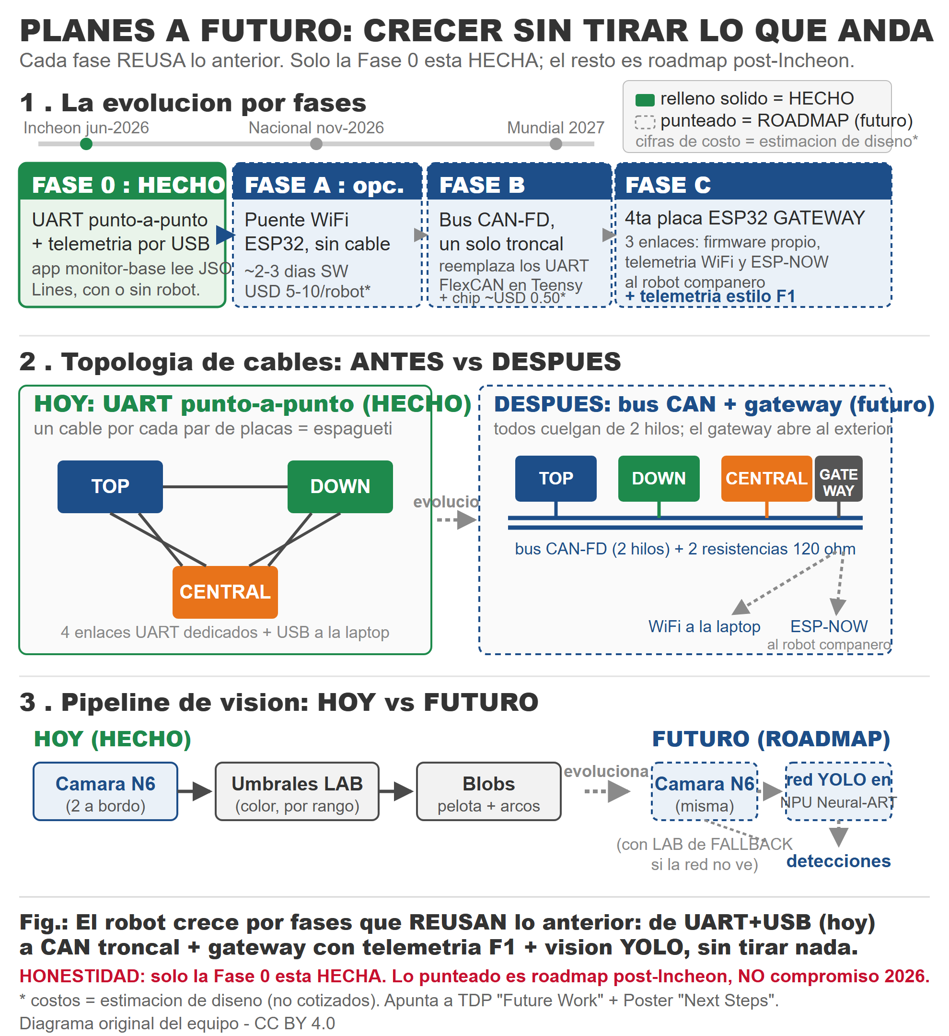
docs/competencia/assets/drafts/fig_roadmap_fases.png
