IITA-Proyectos/open-soccer-robocup-team2026/docs/competencia/assets/drafts/fig_topologia_3placas.png

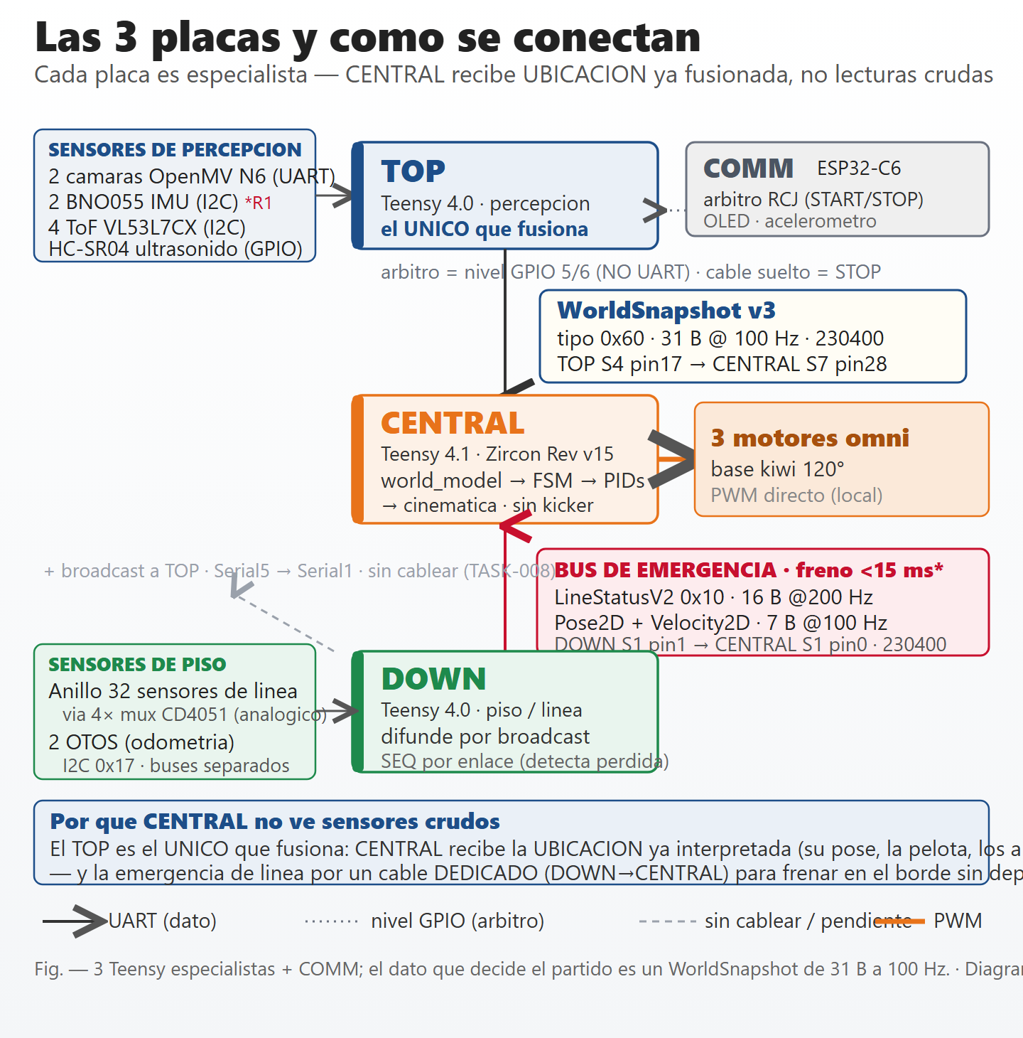
docs/competencia/assets/drafts/fig_topologia_3placas.png
