IITA-Proyectos/open-soccer-robocup-team2026/docs/competencia/assets/drafts/fig_zonas_tof_4x4.png

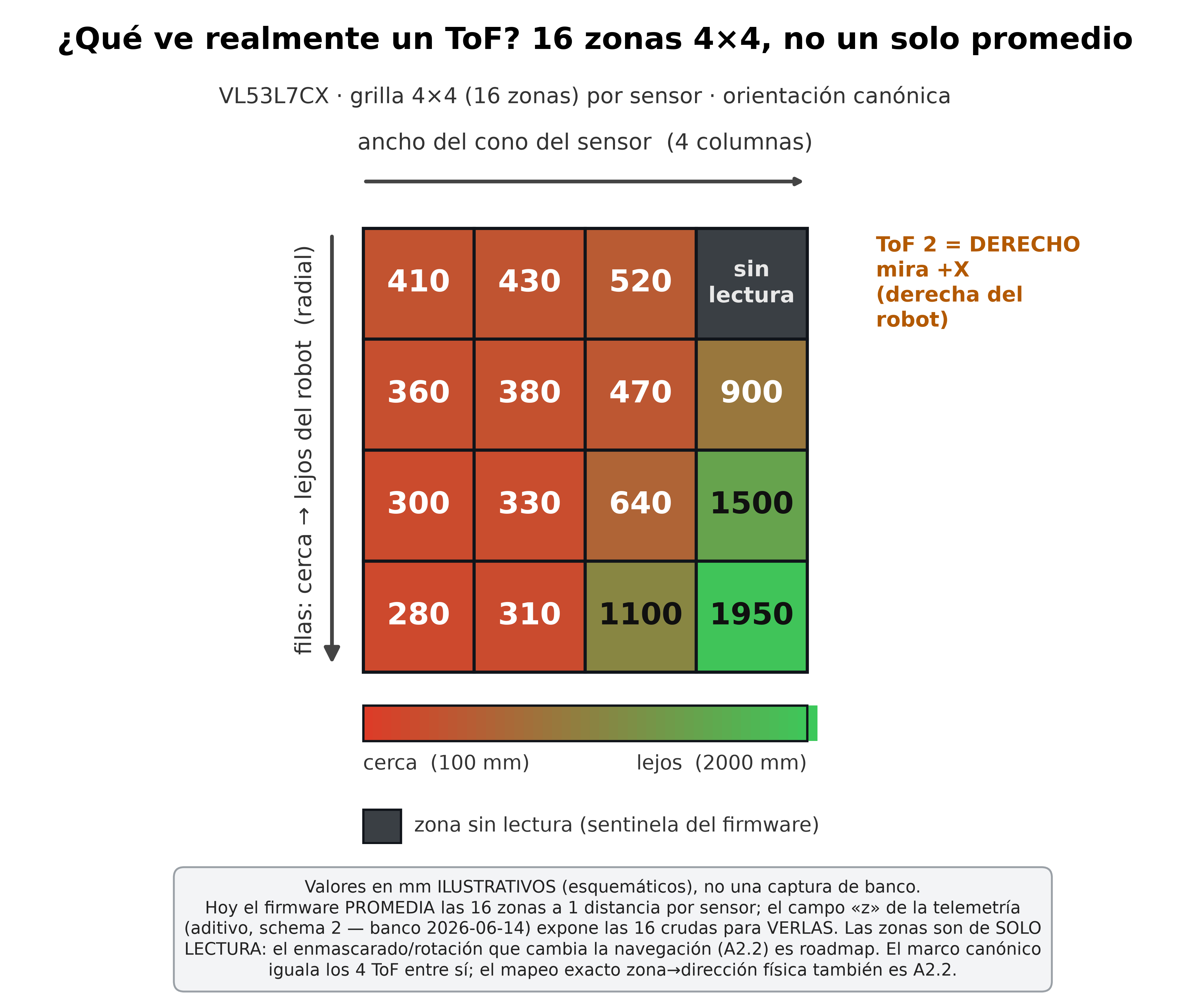
docs/competencia/assets/drafts/fig_zonas_tof_4x4.png
