IITA-Proyectos/open-soccer-robocup-team2026/docs/competencia/assets/fig2_dataflow.png

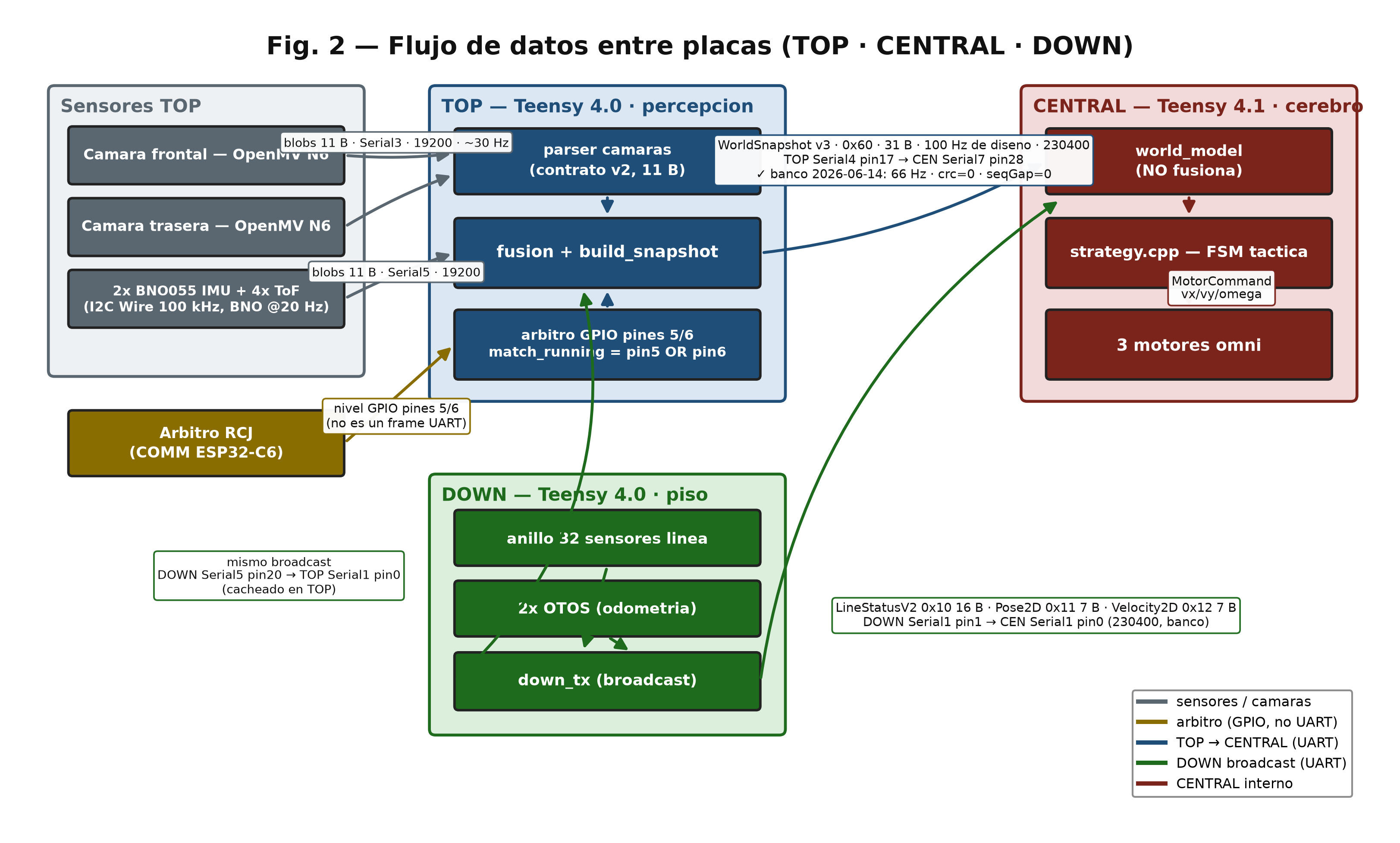
docs/competencia/assets/fig2_dataflow.png
