IITA-Proyectos/open-soccer-robocup-team2026/docs/competencia/assets/fig4_fsm.png

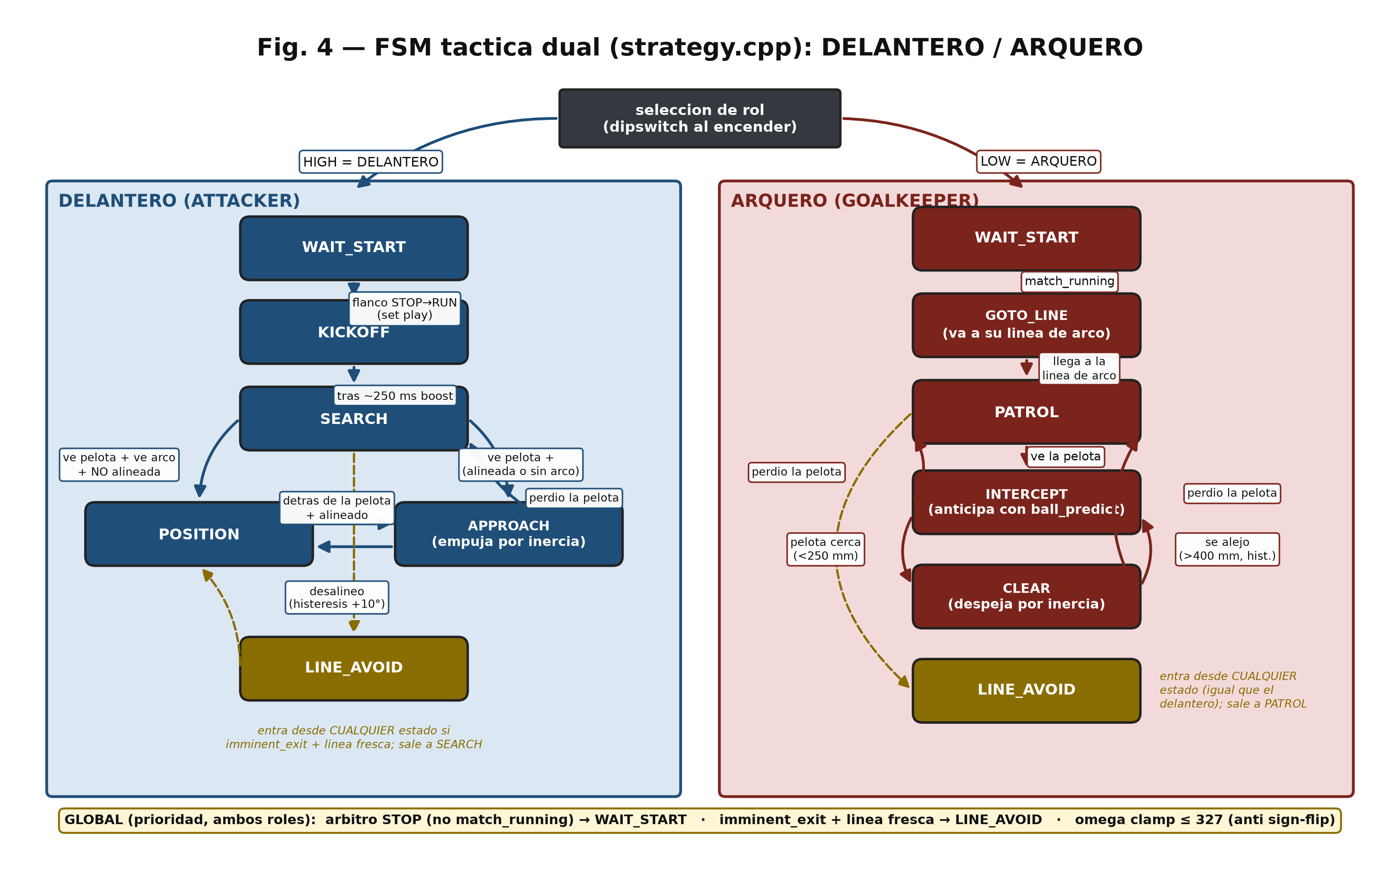
docs/competencia/assets/fig4_fsm.png
