IITA-Proyectos/open-soccer-robocup-team2026/docs/competencia/assets/fig9_otos_error.png

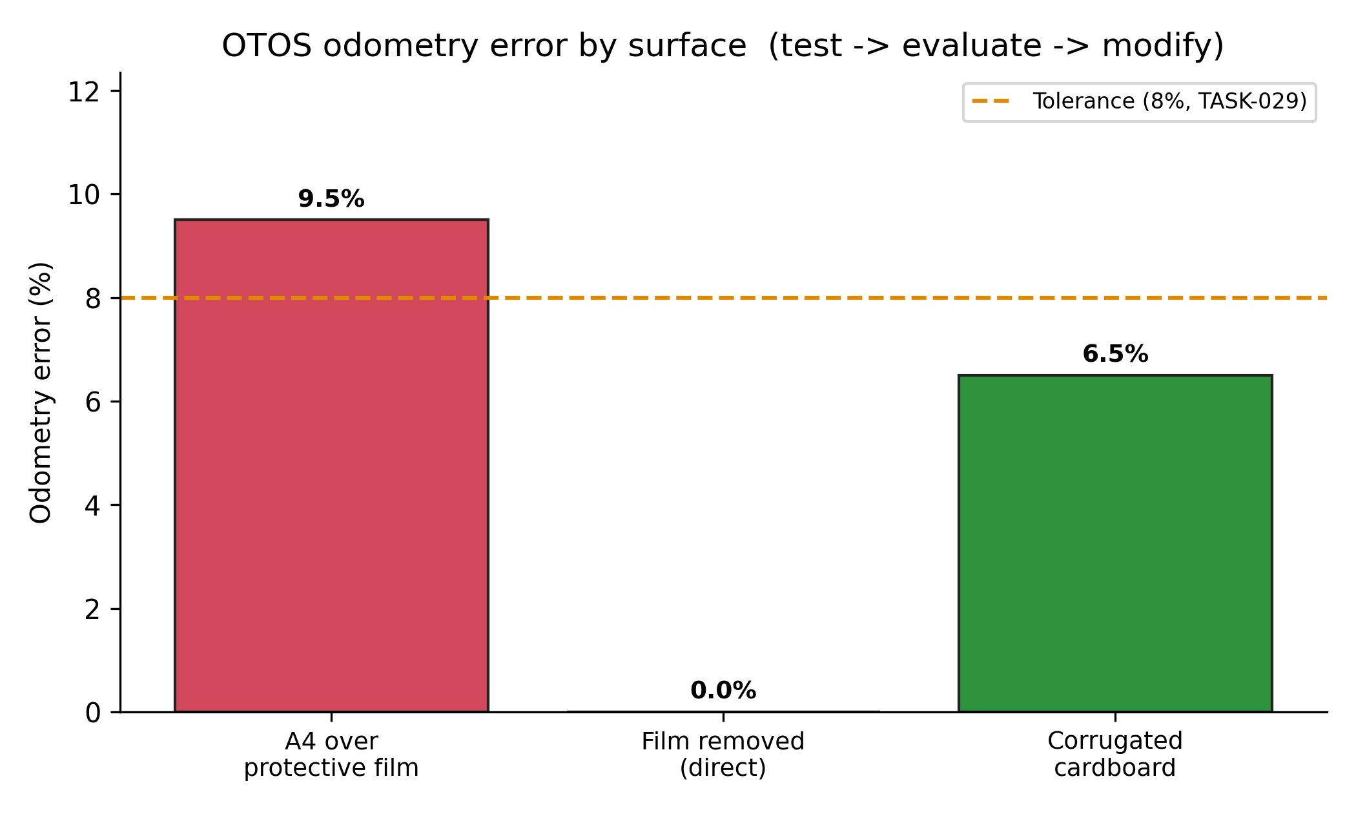
docs/competencia/assets/fig9_otos_error.png
