IITA-Proyectos/open-soccer-robocup-team2026/hardware/electronics/top-board-pack/ground-truth/BOM_Roboliga2026_TOP_2026-04-12.csv

ID | Name | Designator | Footprint | Quantity | Manufacturer Part | Manufacturer | Supplier | Supplier Part | Price
1 | B5819W_C8598 | D1,D2 | SOD-123_L2.7-W1.6-LS3.7-RD-1 | 2 | B5819W SL | CJ(江苏长电/长晶) | LCSC | C8598 | 0.024
2 | 2541WV-06P | U1 | HDR-TH_6P-P2.54-V-M | 1 | 2541WV-06P | HanElectricity(瀚源) | LCSC | C5383115 | 0.02
3 | TOF_#3 | U2,U3,U5,U17 | TOF_#3 | 4
4 | ULTRASOUND_HCSR04 | U6 | HUELLA_HCSR04 | 1
5 | 2541WV-04P | U7 | HDR-TH_4P-P2.54-V-M-1 | 1 | 2541WV-04P | HanElectricity(瀚源) | LCSC | C5383113 | 0.014
6 | UART-CAMERA1 | U8 | UART | 1 | UART |  |  | UART
7 | UART-CAMERA2 | U9 | UART | 1 | UART |  |  | UART
8 | BNO055 COPY | U10,U11 | BNO055 | 2
9 | MP1584EN 4-Pin SIP Module | U12,U13 | MP1584EN-MINI-4-PIN | 2
10 | TEENSY 4.0 | U14 | COMM-TH_34P-L35.6-W17.8-P2.54_C9900133251 | 1 | Teensy 4.0 | null | LCSC | C9900133251
11 | UART_COMM_OUT | U15 | UART | 1 | UART |  |  | UART
12 | UART_COMM_IN | U16 | UART | 1 | UART |  |  | UART
13 | Dean-T-F | XP1 | DEAN-T-F | 1
