IITA-Proyectos/open-soccer-robocup-team2026/hardware/electronics/gerber_file/Placas/Comm/BOM_Board1_PCB1_2026-04-20.xlsx

No. | Quantity | Comment | Designator | Footprint | Value | Manufacturer Part | Manufacturer | Supplier Part | Supplier
1 | 2 | 330nF | C1,C9 | C0805 | 330nF | 0805B334K500NT | FH(风华) | C1740 | LCSC
2 | 7 | 100nF | C2,C3,C4,C5,C6,C7,C11 | C0603 | 100nF | 0603B104K500NT | FH(风华) | C30926 | LCSC
3 | 1 | 100uF | C10 | CAP-SMD_L3.5-W2.8-R-RD | 100uF | CA45-B-6.3V-100uF-K | CEC(振华新云) | C129289 | LCSC
4 | 2 | TS-1088-AR02016 | CONNECT,PROG | SW-SMD_L3.9-W3.0-P4.45 |  | TS-1088-AR02016 | XUNPU(讯普) | C720477 | LCSC
5 | 5 | 10kΩ | R1,R2,R3,R4,R5 | R0603 | 10kΩ | 0603WAF1002T5E | UNI-ROYAL(厚声) | C25804 | LCSC
6 | 2 | 1kΩ | R6,R7 | R0603 | 1kΩ | 0603WAJ0102T5E | UNI-ROYAL(厚声) | C25585 | LCSC
7 | 1 | ESP32-C6-MINI-1-N4 | U1 | WIFIM-SMD_61P-L16.6-W13.2-P0.80-ESP32-C6-MINI-1-N4 |  | ESP32-C6-MINI-1-N4 | ESPRESSIF(乐鑫) | C5736265 | LCSC
8 | 1 | UA78M33CDCYR | U2 | SOT-223_L6.5-W3.5-P2.30-LS7.0-BR |  | UA78M33CDCYR | TI(德州仪器) | C49036 | LCSC
9 | 1 | 2541WV-06P | U3 | HDR-TH_6P-P2.54-V-M |  | 2541WV-06P | HanElectricity(瀚源) | C5383115 | LCSC
10 | 2 | 2541WV-04P | U4,U5 | HDR-TH_4P-P2.54-V-M-1 |  | 2541WV-04P | HanElectricity(瀚源) | C5383113 | LCSC
11 | 1 | TXS0102DCUR | U6 | VSON8_L2.0-W2.3-P0.50-LS3.1-BL |  | TXS0102DCUR | TI(德州仪器) | C53434 | LCSC
12 | 1 | LIS3DHTR | U7 | LGA-16_L3.0-W3.0-P0.50-TL |  | LIS3DHTR | ST(意法半导体) | C15134 | LCSC
