IITA-Proyectos/open-soccer-robocup-team2026/hardware/electronics/gerber_file/Placas/Base/BOM_Roboliga_2026_Futbol_2026-04-20.csv

ID | Name | Designator | Footprint | Quantity | Manufacturer Part | Manufacturer | Supplier | Supplier Part | Price
1 | SparkFun OTOS | U5,U6 | SPARFUN OTOS HEADER | 2 |  | Sparkfun
2 | LED402O | LED32,LED7,LED8,LED9,LED10,LED11,LED12,LED13,LED14,LED15,LED16,LED17,LED18,LED19,LED20,LED21,LED22,LED23,LED24,LED25,LED26,LED27,LED28,LED29,LED30,LED31,LED1,LED2,LED3,LED4,LED5,LED6 | LED-SMD_YLED0402O | 32 | YLED0402O | YONGYUTAI(永裕泰) | LCSC | C28310436 | 0.016
3 | ALSPT19 | F1,F2,F3,F4,F5,F6,F7,F8,F9,F10,F11,F12,F13,F14,F15,F16,F17,F18,F19,F20,F21,F22,F23,F24,F25,F26,F27,F28,F29,F30,F31,F32 | SENSORS-SMD_ALS-PT19 | 32 | ALS-PT19-315C/L177/TR8 | EVERLIGHT(亿光) | LCSC | C146233 | 0.118
4 | 330 | R1,R2,R3,R4,R5,R6,R7,R8,R9,R10,R11,R12,R13,R14,R15,R16,R17,R18,R19,R20,R21,R22,R23,R24,R25,R26,R27,R28,R29,R30,R31,R32 | R0603 | 32
5 | 10k | R33,R34,R35,R36,R37,R38,R39,R40,R41,R42,R43,R44,R45,R46,R47,R48,R49,R50,R51,R52,R53,R54,R55,R56,R57,R58,R59,R60,R61,R62,R63,R64 | R0603 | 32
6 | TEENSY 4.0 | U7 | COMM-TH_34P-L35.6-W17.8-P2.54_C9900133251 | 1 | Teensy 4.0 | null | LCSC | C9900133251
7 | MP1584EN 4-Pin SIP Module | U8,U9 | MP1584EN-MINI-4-PIN | 2
8 | Dean-T-F | XP1 | DEAN-T-F | 1
9 | 100nF | C1,C2,C3,C4,C5,C6 | C0603 | 6
10 | B5819W_C8598 | D1,D2 | SOD-123_L2.7-W1.6-LS3.7-RD-1 | 2 | B5819W SL | CJ(江苏长电/长晶) | LCSC | C8598 | 0.024
11 | CD4051BM | U1,U2,U3,U4 | SOIC-16_L9.9-W3.9-P1.27-LS6.0-BL | 4 | CD4051BM | TI(德州仪器) | LCSC | C353976 | 0.96
12 | 2541WV-04P | U10,U11 | HDR-TH_4P-P2.54-V-M-1 | 2 | 2541WV-04P | HanElectricity(瀚源) | LCSC | C5383113 | 0.015
