IITA-Proyectos/open-soccer-robocup-team2026/docs/competencia/assets/drafts/fig_proceso_constructivo_timeline.png

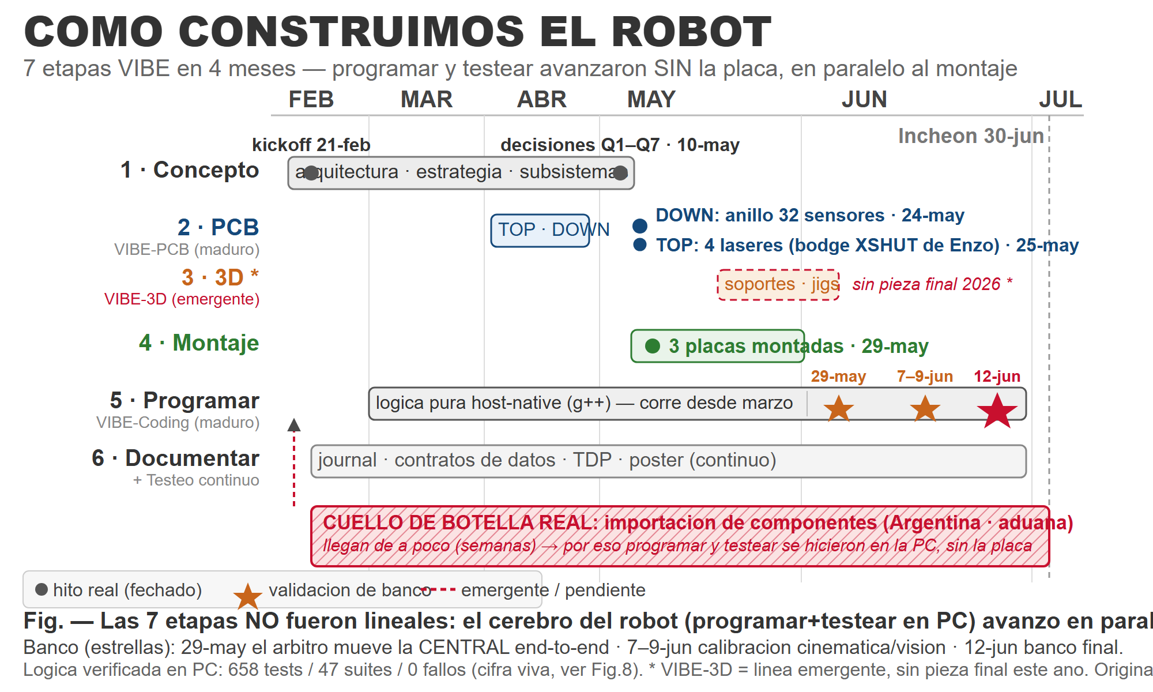
docs/competencia/assets/drafts/fig_proceso_constructivo_timeline.png
