IITA-Proyectos/open-soccer-robocup-team2026/team-tasks/2026-06-06-task-304-down-firmware-debug-telemetria-calibracion.md

---
id: TASK-304
title: "Modo DEBUG/telemetría + calibración automática en el firmware de DOWN (stream USB)"
date_created: 2026-06-06
assigned: [mariaviollaz, gviollaz]
priority: P0
status: in-progress
estimated_hours: 10
blocks: [TASK-305]
status_note: "v1 implementada — módulo+protocolo+test host verde; glue Arduino + env pio-pendientes (banco)"
tags: [firmware, down, tooling, telemetria, calibracion, prioritaria]
---

# TASK-304 — Modo DEBUG/telemetría + calibración en el firmware de DOWN

## 1. Resumen
Agregar al **firmware de competencia de DOWN** un **modo DEBUG** (gateado, byte-idéntico OFF) que **emita telemetría estructurada por USB** y acepte **comandos de calibración**, para que una app de PC (TASK-305) muestre en vivo los 32 sensores de luz, lo que ve de las líneas y **la interpretación real que DOWN manda a CENTRAL** (LineStatusV2).

## 2. Contexto
Es el **próximo desarrollo PRIORITARIO** del equipo (pedido 2026-06-06). Hoy el diagnóstico de línea es por texto (`diag_down`, `diag_down_calibracion`). Queremos ver gráficamente, en banco, moviendo el robot sobre las líneas: (a) que los 32 sensores funcionan, (b) qué líneas ve, (c) **qué LineStatusV2 está enviando** a CENTRAL/TOP. Debe ser un modo del **firmware real** (no un sketch aparte) para ver exactamente lo que el robot "piensa". Diseño completo: `research/in-progress/2026-06-06-diseno-monitoreo-telemetria-usb-y-apps-pc.md`. Conecta con el roadmap de telemetría F1 (CANbus, MEJORAS-PENDIENTES (e) E4) como su versión USB de hoy.

## 3. Pasos concretos
1. Definir el **esquema de telemetría v1** (recomendado: líneas de texto CSV/JSON por frame, versionado). Campos: `raw[32]`, `white[32]`, calib (`carpet[32]`, `white_cal[32]`, `threshold[32]`) y la **LineStatusV2** que arma `dm_update` (line_angle, escape_angle, penetration, cross_track, line_present, sensors, quality, sample_age).
2. Extraer la **serialización del frame de telemetría** y el **parser de comandos** a un **módulo PURO host-testeable** en `src/shared/` (+ su test) — el gate lo verifica. El glue de `Serial` queda en `src/down/`.
3. Agregar el **modo debug** en `main_down.cpp`, gateado por `-DDOWN_DEBUG_TELEMETRY` (DEFAULT OFF → competencia byte-idéntico) y/o activable por comando USB. Cuando activo: emitir el frame a 20–50 Hz por `Serial` (USB CDC, NO los UART inter-placa).
4. Implementar **comandos por USB** (host→DOWN): start/stop stream, calibrar carpet, calibrar blanco, **auto-calib** (capturar min/máx por sensor mientras se pasa el robot por las líneas y computar umbral), **guardar calib a EEPROM**. Reusar `line_ring_calibrate_carpet/white/set_calibration` + `calib_storage`/`ec_*`.
5. Agregar `[env:down_debug_telemetry]` (extends `env:down` + `-DDOWN_DEBUG_TELEMETRY`), aditivo.
6. Documentar el protocolo (esquema versionado) junto al diseño.

## 4. Criterio de cierre
- [ ] `pio run -e down` (competencia) compila y el binario es byte-idéntico al actual (flag OFF). *(pendiente: verificar con pio en banco — el gate host no compila Teensy)*
- [ ] `pio run -e down -t upload` emite el stream por USB a tasa estable (telemetría en el binario de competencia, flag `-DDOWN_USB_MONITOR`; se activa al conectar la app `tools/monitor-base` o con un ENTER en monitor serie crudo). *(glue implementado; pendiente compilar/flashear)* [NOTA 2026-06-13: `down_debug_telemetry` eliminado → usar `down`; ver `platformio.ini`]
- [x] El stream incluye raw[32], white[32], calib y la LineStatusV2 real (la misma que va a CENTRAL). *(cubierto por el módulo puro + golden)*
- [ ] Comandos de calib (carpet/blanco/auto/guardar-EEPROM) funcionan vía USB. *(parser puro listo y testeado; falta validar la ejecución del glue en banco)*
- [x] Módulo puro de (de)serialización del frame con test host en verde (gate). *(`test_telemetry_down`, 16 tests; gate 50 envs / 705 tests / 0 fallos)*
- [x] Protocolo documentado y versionado. *(`docs/firmware/TELEMETRIA-DOWN.md`, schema v1)*

## 5. Notas / decisiones
- **2026-06-07 — v1 implementada.** Arquitectura del diseño (§3) seguida al pie: módulo puro
  host-testeable + glue Arduino gateado + protocolo versionado.
  - Módulo PURO: `src/shared/telemetry_down.{h,cpp}` (serializa snapshot DOWN → 1 línea **JSON
    Lines**; parsea comandos host→firmware con `td_parse_command`).
  - Test host: `test/test_telemetry_down/test_main.cpp` (16 tests, en el gate **50 envs / 705
    tests / 0 fallos**) con **golden frame** byte-idéntico = contrato cross-lenguaje con la app PC.
  - Glue Arduino: `src/down/down_telemetry_serial.{cpp,h}` + env `[env:down_debug_telemetry]`,
    **gateado con `-DDOWN_DEBUG_TELEMETRY`** → competencia byte-idéntico (flag OFF).
  - Contrato: `docs/firmware/TELEMETRIA-DOWN.md` (schema v1, USB CDC `Serial` @115200; anillo de
    32 sensores + LineStatusV2 a CENTRAL + odometría OTOS + comandos STREAM/RATE/CAL/OTOS).
- **Host-verificado:** módulo puro + gate verde. **pio-pendiente (banco):** glue Arduino + env
  (`pio run -e down_debug_telemetry`) — acá no compila Teensy.
- Issues relacionadas: #14 / #15 / #16.

## 6. Cambios de estado
- 2026-06-06 — creada (pending). Pedido del coach como desarrollo prioritario.
- 2026-06-07 — **in-progress / v1 implementada** (módulo + protocolo + test host verde; glue
  Arduino + env `down_debug_telemetry` pendientes de `pio` por el equipo en banco).
