IITA-Proyectos/open-soccer-robocup-team2026/team-tasks/2026-05-10-task-010-verificar-firmware-rcj-esp32c6.md

---
id: TASK-010
title: "Verificar si el firmware oficial RCJ Communication Module es compatible con ESP32-C6 (vs ESP32 clásico)"
date_created: 2026-05-10
date_closed: 2026-05-15
assigned: [virginia, elias]
priority: P0
status: done
estimated_hours: 4
actual_hours: 1
blocks: [TASK-006 (cargar firmware RCJ), homologación Incheon]
tags: [firmware, esp32, comm-board, rcj-official]
depends_on: [TASK-006]
---

# TASK-010 — Compatibilidad firmware RCJ con ESP32-C6

## Por qué importa

El BOM de la placa COMM (revelado hoy 2026-05-10 en el commit `343c420` de Enzo) confirma que el MCU es **ESP32-C6-MINI-1-N4** (Espressif), no el ESP32 clásico.

Diferencias críticas:

| Característica | ESP32 clásico | ESP32-C6 |
|---|---|---|
| CPU | Xtensa LX6 (dual core) | **RISC-V** (single core) |
| Arduino SDK target | `esp32` (default) | `esp32c6` (más nuevo, soporte parcial) |
| WiFi | 4 (802.11n) | **6 (802.11ax)** |
| BLE | 4.2 | **5.0 LE** |
| GPIO | 34 (clásico) | 22 (C6) — **menos pines** |
| Thread / Zigbee | No | Sí |

**El firmware oficial RCJ** (https://github.com/robocup-junior/soccer-communication-module) fue diseñado y testeado en **ESP32 clásico**. Compilarlo para ESP32-C6 requiere:

1. Cambio de target SDK (`espressif32` → `espressif32` con board `esp32-c6-devkitm-1` o similar).
2. Revisar GPIO mapping — el ESP32-C6 tiene menos pines y otras numeraciones.
3. Revisar APIs usadas — algunas librerías clásicas no compilan en RISC-V sin updates.
4. Testear conexión a árbitros oficial (¿el protocolo se mantiene?).

Si la homologación de Incheon exige el firmware oficial **exactamente como está publicado**, hay un problema serio.

## Pasos concretos

### Fase 1 — Investigación (2 horas)

1. Clonar el repo del firmware oficial:
   ```
   git clone https://github.com/robocup-junior/soccer-communication-module
   ```
2. Leer `README.md` del firmware oficial. ¿Mencionan ESP32-C6, o solo ESP32 clásico?
3. Revisar `platformio.ini` o `.ino` files: identificar `board = ...` o `#include` de librerías específicas (`<WiFi.h>` vs `<WiFi_C6.h>`).
4. Buscar issues / PRs del repo oficial: alguien más puede haber portado ya al C6 (esto es lo más probable porque el módulo oficial RCJ pudo haber migrado a C6 también).
5. Verificar en RCJ Forum / Discord si **hay equipos usando C6** ya en competencia 2026 o si el módulo oficial siguió en clásico.

### Fase 2 — Compilación experimental (1 hora)

1. Instalar PlatformIO si no está.
2. Intentar compilar el firmware oficial con `board = esp32-c6-devkitm-1`.
3. Listar errores de compilación. Si son pocos, hay esperanza. Si son muchos (cambios profundos de API), considerar Plan B.

### Fase 3 — Decisión (1 hora)

Según hallazgo, decidir:

- **(a) Plan A**: el firmware oficial soporta C6 → cargarlo y testear (TASK-006).
- **(b) Plan B**: hay port no-oficial documentado → usar ese (verificar que pasa homologación).
- **(c) Plan C**: portar nosotros el firmware oficial al C6 (~2-3 días de trabajo).
- **(d) Plan D**: implementar firmware propio que respete el **protocolo RCJ** del módulo. Más rápido pero hay que documentar bien para homologación.

## Criterio de cierre

- [x] Investigación documentada en `journal/2026-05-15-firmware-comm-c6-flash-procedure.md`.
- [x] Compilación experimental NO requerida — el firmware oficial ya es nativo C6.
- [x] Decisión tomada: **Plan A** (cargar firmware oficial sin modificar).
- [x] TASK-006 actualizado a P0 con el procedure descubierto.

## Notas / decisiones

### 2026-05-15 — TASK cerrada como done (resuelto sin trabajo de portabilidad)

**Resolución**: la premisa de esta TASK era incorrecta. La tabla "ESP32 clásico vs
C6" del cuerpo arriba asumía que el firmware oficial **estaba diseñado para ESP32
clásico**. Eso ya no es cierto desde el 2024-03-29.

**Evidencia**:

1. **Foro oficial RCJ** (mensaje #5 del thread `documentation-communication-module/3269`,
   29-mar-2024):
   > "there will be a few modifications like using ESP32 C6"

   El staff del módulo de comunicación confirma migración a ESP32-C6 desde marzo
   2024. Las revisiones de placa subsiguientes ya son nativas C6.

2. **Firmware actual del repo oficial** (verificado 2026-05-15):
   `firmware/RCj_comm_module/definitions.h` tiene un comentario `//ESP-C5` (típica
   confusión C5/C6 — el chip es C6 según BOM, gerbers y foro), y los pines GPIO
   asignados (2, 3, 7, 8, 9, 10) son consistentes con el mapping del C6.

3. **Estructura del firmware**: Arduino IDE puro (no PlatformIO, no ESP-IDF). El
   `.ino` compila contra Arduino-ESP32 core ≥3.0 con board `ESP32C6 Dev Module`
   directamente — sin port manual.

4. **Versión actual del firmware**: v0.91 (`FW_VERSION_MAJOR=0`, `FW_VERSION_MINOR=91`).

**Conclusión**: NO hace falta portar, NO hace falta evaluar Plan B/C/D. Plan A
(cargar tal cual) es viable y es lo que TASK-006 ahora ejecuta.

**Lo que SÍ quedó pendiente y se movió a TASK-006**: el procedure correcto de
flash (la placa no tiene RESET físico, hay que hacer unplug+BOOT+replug). Eso es
un tema operativo de "cómo entrar al bootloader del C6 sin reset físico", no de
compatibilidad de firmware.

## Cambios de estado

- 2026-05-10: creado por Claude tras descubrir ESP32-C6 en el BOM Comm 04-20.
- 2026-05-15: **cerrada como done**. Premisa incorrecta — el firmware oficial ya
  es nativo C6 desde 2024-03-29. Tiempo real de investigación: 1 h (vs 4 h
  estimadas). TASK-006 absorbe el procedure operativo de flash.
- 2026-05-17: **matiz importante (decisión SE MANTIENE, evidencia corregida).**
  El veredicto sigue siendo correcto: NO hace falta portar, Plan A es viable.
  PERO el soporte C6 **no** está en `master` (master compila para **C5**; el
  comentario `//ESP-C5` NO era typo). El C6 nativo está en un **branch
  dedicado `esp32-c6`** (commit `ffb4e3c`). El pin map que esta TASK pasó a
  TASK-006 era el de C5 y estaba equivocado. Corrección y pin map C6 correcto
  en `journal/2026-05-17-analisis-3-placas-y-correccion-firmware-c6.md` y
  `hardware/electronics/comm-board/`. La TASK queda `done` (la decisión
  Plan A no cambia); la corrección operativa vive en TASK-006.
