IITA-Proyectos/open-soccer-robocup-team2026/docs/pruebas-banco/CAJA-NEGRA.md

# CAJA NEGRA de la CENTRAL — log completo de corridas para análisis y calibración

> **Origen (2026-06-11, Gustavo):** "el delantero se mueve para todos lados, muy
> rápido, no lo puedo probar a ojo y no siempre tengo cancha. Quiero un log de
> corrida COMPLETO que pueda bajar y pasarte para que analices qué está pasando."
> Diseñado como experimento de ingeniería: capturar TODO lo que el robot vio,
> decidió y aplicó, con timestamps, para reconstruir la corrida offline.

## Decisión de diseño: dónde se guarda y por qué

| Opción | Veredicto |
|---|---|
| **RAM + volcado USB post-corrida (v1, IMPLEMENTADO)** | ✅ Cero hardware nuevo, cero riesgo al loop de 100 Hz (escribir en RAM cuesta ~ns), 90 s de historia circular. El USB del Teensy es ~1 MB/s: volcar 90 s tarda <1 s. El "cable lento" no aplica: el cable se conecta DESPUÉS de la corrida (o queda puesto en pruebas de escritorio). |
| microSD en la CENTRAL (fase 2) | La CENTRAL es **Teensy 4.1 con ranura microSD integrada** → sesiones de horas y partidos completos en Incheon. Requiere SdFat + buffer (las escrituras SD tienen picos de 10-50 ms que NO pueden tocar el loop). Se hace post-demo si la v1 queda corta. |
| Streaming USB en vivo | Ya existe para sensores del TOP (`TOP_DEBUG_TELEMETRY` + app `tools/monitor-base`). Sirve en escritorio; en cancha el cable arrastrado molesta. La caja negra lo complementa con la mitad que faltaba: **las decisiones de la CENTRAL**. |
| Radio (ESP32, telemetría F1) | Roadmap 2027 (ya en TDP §4.6) — no para esta semana. |

## Qué graba (cada 20 ms = 50 Hz, los últimos ~90 s)

Una fila por muestra con TODO lo que la CENTRAL ve y hace:

| Columna | Qué es |
|---|---|
| `t_ms` | reloj del robot (millis) |
| `state` | estado FSM exacto (`ATK_SEARCH`, `ATK_POSITION`, `ATK_PUSH`, `GK_PATROL_MOVE`...) |
| `match,snap,ball_vis,goal_vis,hdg_valid,line,imminent` | flags 0/1 (juez, snapshot fresco, pelota/arco vistos, heading válido, línea pisada, borde inminente) |
| `hdg_deg` | rumbo del BNO (vía TOP) |
| `ball_x,ball_y` | pelota en mm, frame robot (lo que las CÁMARAS dijeron) |
| `ball_vx,ball_vy` | velocidad estimada de la pelota (mm/s) |
| `goal_deg` | ángulo al arco rival (cámara) |
| `cmd_vx,cmd_vy,cmd_w_dps` | lo que la FSM ORDENÓ (mm/s y °/s) |
| `pwm1,pwm2,pwm3` | lo que REALMENTE llegó a cada motor (signed, post-pisos/impulso) |
| `line_deg` | ángulo de la línea (DOWN) |
| `min_obst` | obstáculo más cercano (min de 4 ToF + HC-SR04 frontal, mm; 65535 = sin lectura) |
| `emerg` | 1 = esta muestra cayó durante el FRENO DE BORDE (v1.1) |
| `otos_fresh,otos_x,otos_y,otos_hdg` | odometría de piso de DOWN (v1.2, práctica 2026-06-12): pose fresca 0/1, posición en mm desde el arranque y yaw en grados. **En R1 sin BNO, `otos_hdg` ES el rumbo del delantero** — el detector "EMPUJE TORCIDO" del analizador compara el yaw al inicio y fin de cada `ATK_PUSH`. En R2 (sin OTOS) vienen en 0 con `otos_fresh=0`. |
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
