IITA-Proyectos/open-soccer-robocup-team2026/docs/competencia/assets/fig8_test_growth.png

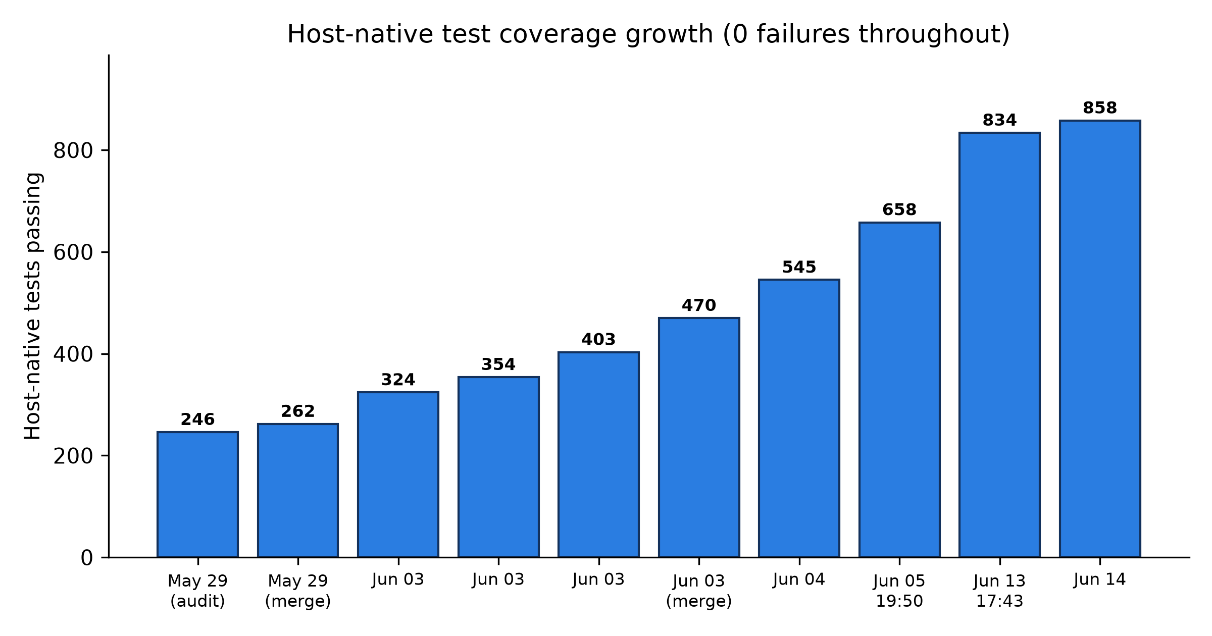
docs/competencia/assets/fig8_test_growth.png
