IITA-Proyectos/open-soccer-robocup-team2026/CHANGELOG.md

# Changelog

Todos los cambios notables en este proyecto se documentan acá.

Formato basado en [Keep a Changelog](https://keepachangelog.com/es/1.0.0/).

> ⚠️ **Este CHANGELOG no es la fuente de verdad del estado del proyecto.** Quedó
> congelado en 2026-03-20 y **no** se mantiene día a día. Para el estado vivo del
> robot y el historial real de trabajo, usar:
> - **[`docs/ESTADO-ACTUAL.md`](docs/ESTADO-ACTUAL.md)** — qué corre hoy, qué bloquea, qué deudas hay.
> - **[`journal/`](journal/)** — diario de ingeniería cronológico (cada sesión deja entrada).
>
> Este archivo se conserva sólo como registro de los hitos iniciales del repo.

## [Unreleased]

### Added
- Estructura de documentación `docs/official/` y `docs/internal/` (2026-03-20)
- Análisis del código del arquero legacy 2025 (2026-03-20)
- Normalización ICRS: LICENSE, CHANGELOG, REFERENCE, issue templates, PR template, traducción automática (2026-03-20)

### Changed
- PR template actualizado según estándar ICRS con sección de IA/fuentes

---

## [0.0.1] - 2026-02-21

### Added
- Estructura inicial del repositorio
- Migración de código legacy temporada 2025
- CONTRIBUTING.md, AI-INSTRUCTIONS.md
- CODEOWNERS, pull_request_template.md
