IITA-Proyectos/open-soccer-robocup-team2026/journal/2026-06-21-arqueromix-patrulla-por-arco-propio.md

---
title: "arqueromix — la patrulla rebota por el ARCO PROPIO (cámara trasera), no por la línea"
date: 2026-06-21
author: "Claude (Opus 4.8, 1M context) — coach, pedido de Virginia (banco)"
status: COMPILA · NO validado en banco · RIESGO marcado (goal_own no validado)
scope: software/teensy/Soccer 2026/src/arqueromix/
tipo: feature-banco
---

# arqueromix — patrulla por arco propio

## Pedido (Virginia)

Cambiar el patrullaje: que NO rebote hasta la línea, sino que rebote cuando vea el **arco propio** a
cierto **ángulo** (= llegar al borde del arco) y se vaya al otro lado. Misma lógica de la línea, pero
con la **cámara trasera** siguiendo el arco propio. **Decisión Virginia (preguntada): REEMPLAZAR la
línea del todo en la patrulla** (riesgo aceptado, ver abajo).
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
