IITA-Proyectos/open-soccer-robocup-team2026/hardware/electronics/down-board-pack/ground-truth/Schematic_Roboliga_2026_Futbol_2026-04-12.pdf

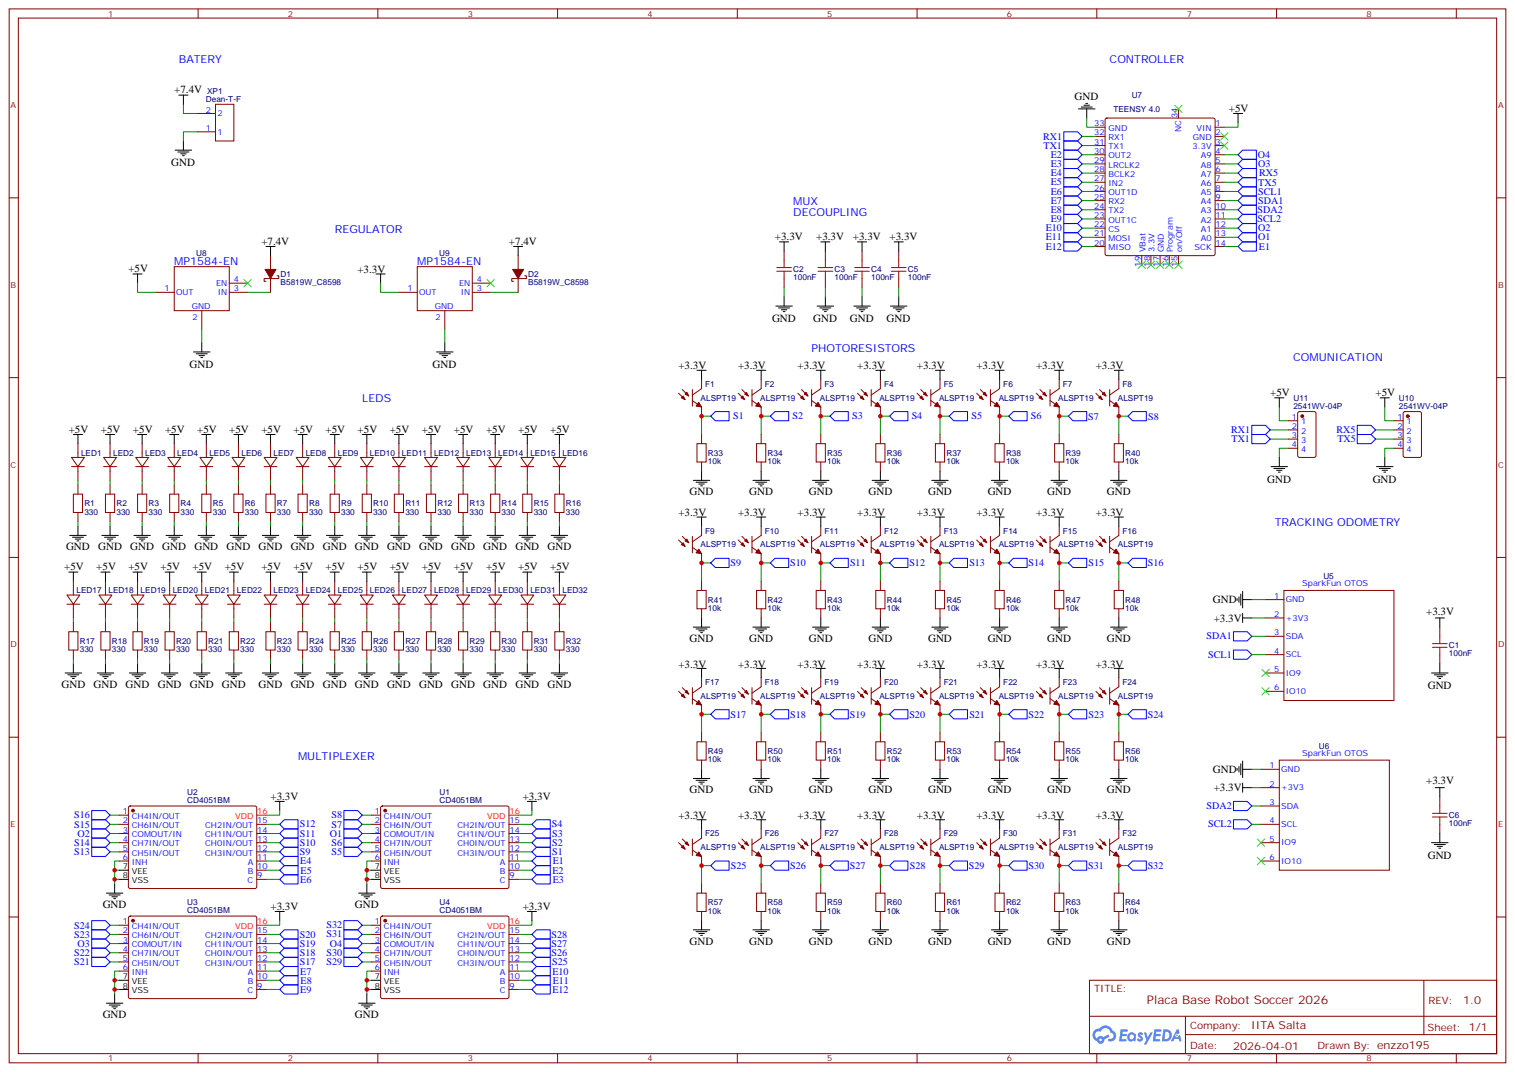
[picture p25: page 1]

on/Off 15 Program 16 GND 17 3.3V 18 VBat 19 NC 34
