IITA-Proyectos/open-soccer-robocup-team2026/hardware/electronics/top-board-pack/ground-truth/Schematic_Roboliga2026_TOP_2026-04-12.pdf

## BATERY

## REGULATOR

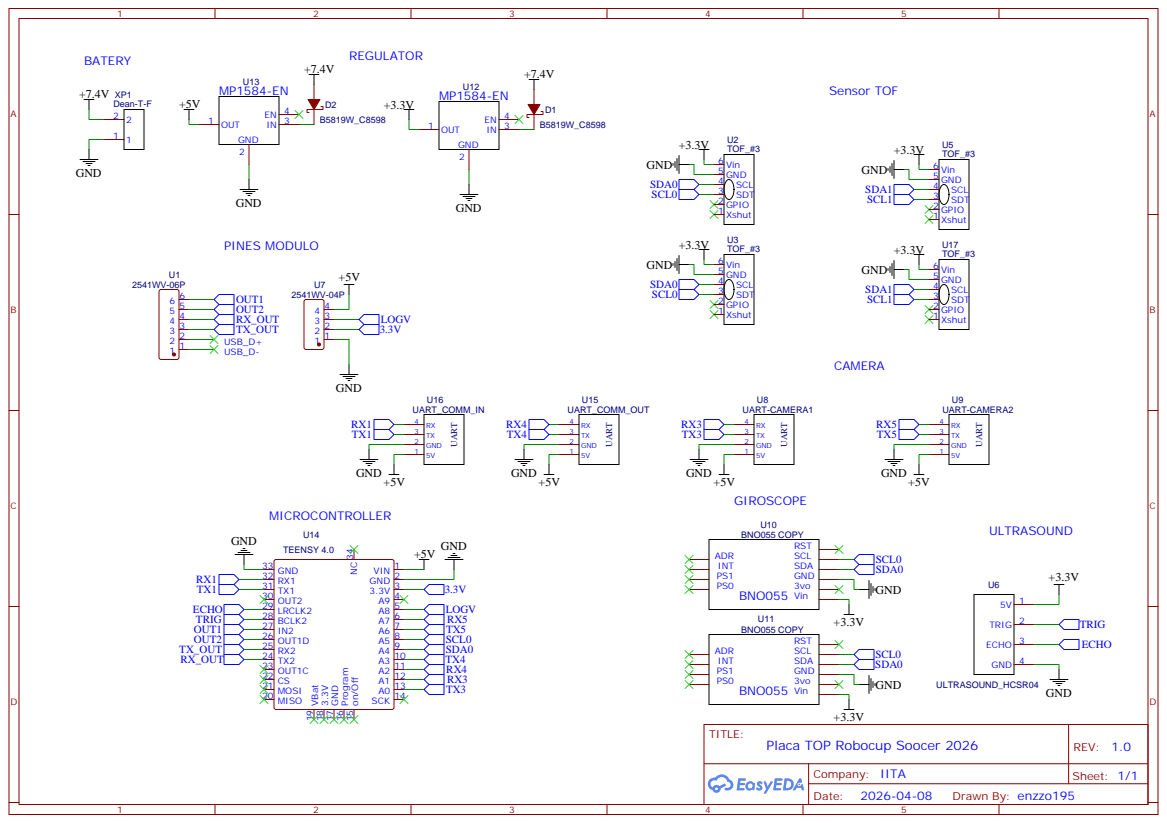
[picture p26: page 1]
