IITA-Proyectos/open-soccer-robocup-team2026/hardware/electronics/Zircon.pdf

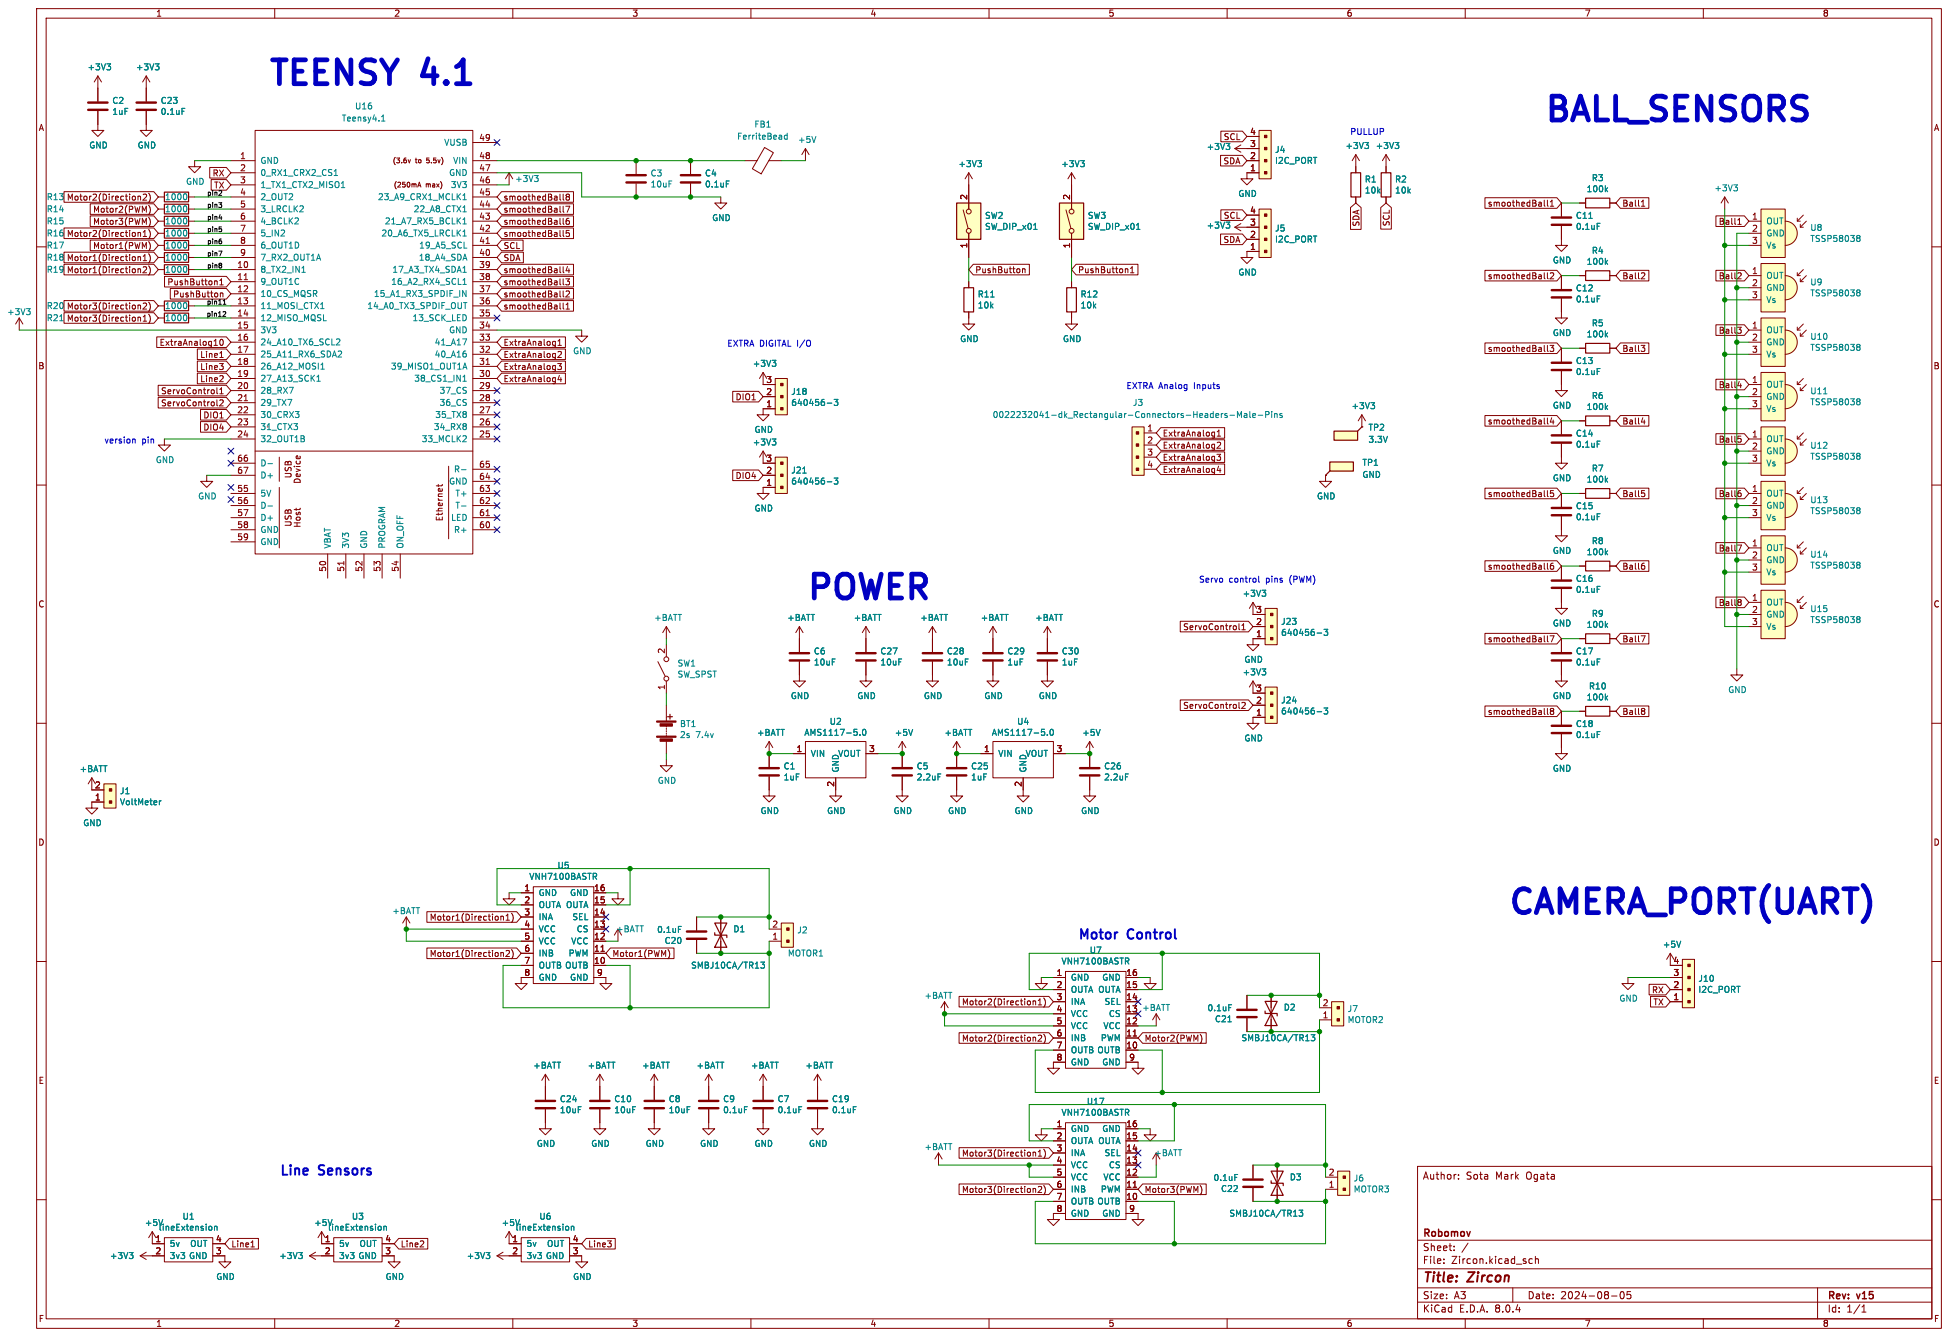
[picture p27: page 1]
