IITA-Proyectos/open-soccer-robocup-team2026/(list of files, drawings)

Other design files:
hardware/electronics/down-board-pack/ground-truth/PCB_PCB_Roboliga_2026_Futbol_2026-04-12.json
hardware/electronics/down-board-pack/ground-truth/SCH_Roboliga_2026_Futbol_2026-04-12.json
hardware/electronics/top-board-pack/ground-truth/PCB_PCB_Roboliga2026_TOP_2026-04-12.json
hardware/electronics/top-board-pack/ground-truth/SCH_Roboliga2026_TOP_2026-04-12.json
