IITA-Proyectos/open-soccer-robocup-team2026/software/teensy/Soccer 2026/src/central/config_central.h

// config_central.h — Constantes del firmware del Zircon (motor server)
//
// El Zircon Rev v15 con Teensy 4.1 ejecuta el firmware "motor server":
//   - Recibe WORLD_SNAPSHOT por Serial7 (pin 28) desde la placa TOP.
//   - Aplica cinemática inversa omni-3.
//   - Aplica PWM a los 3 drivers H-bridge.
//   - Reporta status básico al TOP.
//
// Selección de robot por compilación:
//   pio run -e central_robot1   → arquero (#define ROBOT1)
//   pio run -e central_robot2   → delantero (#define ROBOT2)
//
// Pinout basado en hardware/electronics/mapa-pines-teensy-ambos-robots.md
// (documento del 2026-03-20). NO MODIFICAR sin coordinar con Enzo + verificar
// con el journal 2026-03-20-diferencias-pines-motores-arquero-delantero.md.

#pragma once

namespace iitasoccer {

// ============================================================
// Pinout de motores — depende del robot
// ============================================================
#if defined(ROBOT1)  // Arquero
    constexpr int PIN_INA1 = 2;
    constexpr int PIN_INB1 = 5;
    constexpr int PIN_PWM1 = 3;

    constexpr int PIN_INA2 = 8;
    constexpr int PIN_INB2 = 7;
    constexpr int PIN_PWM2 = 6;

    constexpr int PIN_INA3 = 11;
    constexpr int PIN_INB3 = 12;
    constexpr int PIN_PWM3 = 4;

    // Sentido por motor (+1 normal, -1 invertido por hardware).
    // VALIDADO en banco (María/Elías, diag_central_line_sweep_robot1): el motor 2
    // (driver U17, pines 8/7/6) tiene INA/INB cruzados por HW → va invertido.
    // Fuente: docs/firmware/DIAG-CENTRAL-MOTORS.md + journal 2026-05-29 / 2026-06-01.
    // + RE-CONFIRMADO banco 2026-06-06 (commit 8956d10) tras rearmar el robot: se mueve derecho + esquiva la línea.
    // 🔧 BANCO R1 2026-06-11 (post-REPARACIÓN): el M2 quedó RECABLEADO DERECHO — con la
    // compensación histórica -1 giraba al revés en el piso (y las delanteras se cancelaban
    // entre sí: "apenas se mueven y la trasera les gana"). El -1 era para el cableado
    // PRE-reparación (U17 INA/INB cruzados de fábrica, ver historia abajo). Si alguna vez
    // se recablea como estaba, volver a {+1,-1,+1}.
    constexpr int MOTOR_INVERT[3] = { +1, +1, +1 };
    // Piso de PWM POR RUEDA (deadzone bajo carga). Física (banco R1 06-08 + R2 06-09, Gustavo):
    // el PWM mínimo para que la rueda ARRANQUE depende de la fricción que ve ESA rueda — las
    // DELANTERAS (idx0/idx1) trabajan OBLICUAS a 60° (sus rodillos ruedan de costado) → MUCHA
    // más fricción → necesitan MÁS piso. La TRASERA (idx2/M3) va ALINEADA al strafe → menos
    // fricción. (El PWM NO es proporcional a la velocidad real y es DISTINTO por rueda.)
    // ⚠️ DOBLE HISTORIA del idx2 (trasera) — leer ANTES de tunear:
    // (a) Banco R1 2026-06-08: idx2 se BAJÓ a 42 porque con piso alto el robot ROTABA en el
    //     strafe (la trasera, con menos fricción, se adelantaba a las delanteras).
    // (b) Banco R2 2026-06-09 (diag_central_strafe_robot2_kick, barrido 42→50→70→85→95→100→
    //     105→107): la trasera necesita ~107 para SOSTENER la relación 2:1 de velocidad del
    //     strafe (cinemática: fronts 0.5·vx, rear 1.0·vx). Por ser rueda alineada (menos
    //     fricción que las oblicuas) lo logra con ~1.5x el PWM de las delanteras (107 vs 70),
    //     no 2x.
    // (c) Decisión Gustavo 2026-06-09: R1 PARTE de los valores validados en banco R2.
    // ⚠️ A VERIFICAR EN BANCO R1: si R1 ROTA en el strafe con 107, bajar idx2 GRADUALMENTE
    //    (107→95→85→…); la historia del 42 está en git.
    // 🔧 TUNEAR: delanteras (idx0/idx1) → SUBÍ si no empujan el robot en el piso (70→90…).
    // ⚠️ NO pasar ~150 (motores brushed 5V a 7.4V se queman > ~70%). Orden {M1, M2, M3}.
    constexpr int MOTOR_MIN_PWM[3] = { 70, 70, 107 };  // ✅ BANCO R1 2026-06-11: vuelto a los valores
    // de R2 tras descubrir que el "delanteras débiles" era el M2 RECABLEADO (invert -1→+1, ver
    // MOTOR_INVERT arriba): con M2 al revés las delanteras se cancelaban entre sí. Con 90 las
    // delanteras sobraban (frente girando: ratio 90/107 ≈ 0.84 vs ideal 0.5). {70,70,107} = mix R2.
    // Eficiencia relativa PWM→velocidad por rueda (×100) — para el piso por ESCALADO
    // UNIFORME (-DCENTRAL_FLOOR_SCALE, motor_floor_scale.h). Derivada del banco R2:
    // la trasera alineada rinde ~1.31× más velocidad por PWM que las oblicuas
    // (2:1 de velocidad con 107/70=1.53 de PWM → 2/1.53≈1.31). ⚠️ R1 A VERIFICAR.
    constexpr int MOTOR_EFF_X100[3] = { 100, 100, 131 };
#elif defined(ROBOT2)  // Delantero
    // ✅ BANCO 2026-06-09 (Gustavo, diag_central_motors en robot2 armado): la DISPOSICIÓN
    // resultó IGUAL a ROBOT1 — M1=U5(2/5/3)=delantera-IZQUIERDA · M2=U17(8/7/6)=delantera-
    // DERECHA · M3=U7(11/12/4)=TRASERA — y los 3 giraron HORARIO (desde el centro) con el
    // drive directo del diag (sin inversión). DOS correcciones vs lo que asumía el repo:
    //   1. Los pines NO están rotados (la suposición "U17 = motor 1" venía del delantero
    //      2025 y es FALSA en el robot2 2026 → tabla de pines = la de ROBOT1).
    //   2. El U17 de ESTA placa NO está invertido por HW (en la Zircon de R1 lo
    //      ESTABA hasta el recableado de la reparación 2026-06-11; hoy tampoco) →
    //      MOTOR_INVERT neutro {+1,+1,+1}.
    constexpr int PIN_INA1 = 2;     // M1 = U5  → delantera IZQUIERDA
    constexpr int PIN_INB1 = 5;
    constexpr int PIN_PWM1 = 3;

    constexpr int PIN_INA2 = 8;     // M2 = U17 → delantera DERECHA (acá SIN inversión HW)
    constexpr int PIN_INB2 = 7;
    constexpr int PIN_PWM2 = 6;

    constexpr int PIN_INA3 = 11;    // M3 = U7  → TRASERA
    constexpr int PIN_INB3 = 12;
    constexpr int PIN_PWM3 = 4;

    constexpr int MOTOR_INVERT[3] = { +1, +1, +1 };  // ✅ banco 2026-06-09: los 3 horario sin invertir
    // Piso de PWM por rueda — ACTIVADO en banco 2026-06-09: en el strafe de robot2 la trasera
    // movía pero las DELANTERAS no rompían la inercia (~19 PWM, mitad geométrica del strafe).
    // Mismo síntoma y mismo fix que el arquero. Punto de partida = los valores de R1.
    // 🔧 TUNEAR: delanteras (idx0/idx1) ↑ si no empujan el robot en el piso (70→90…);
    //            trasera (idx2) ↓ si el robot ROTA en el strafe. ⚠️ NO pasar ~150 (queman).
    constexpr int MOTOR_MIN_PWM[3] = { 70, 70, 107 }; // ✅ REVERTIDO 120→107 (banco María 2026-06-14):
    // subir la trasera a 120 EMPEORÓ la medialuna, NO la arregló. El modelo MEDIDO (skill
    // dinamica-omni-3-ruedas) dice que {70,70,107} da strafe DERECHO y estable a 200 mm/s con ω=0
    // (validado banco R2 2026-06-09). Con FLOOR_SCALE, subir el piso de la rueda DOMINANTE del strafe
    // sobre-escala el vector de forma ASIMÉTRICA → yaw parásito direccional = medialuna PEOR. 107 = valor
    // validado; la deriva sistemática residual la cancela el integrador del PFM (env con rumbo).
    // ⚠️ NO pasar ~150 (motores 5V a 7.4V se queman). ⚠️ Afecta R2 arquero Y delantero (config compartida).
    // Eficiencia relativa PWM→velocidad por rueda (×100) — piso por ESCALADO UNIFORME
    // (-DCENTRAL_FLOOR_SCALE, motor_floor_scale.h). ✅ DERIVADA DEL BANCO R2 2026-06-09:
    // la trasera (alineada al strafe) rinde ~1.31× más velocidad por PWM que las
    // delanteras oblicuas: el strafe derecho salió con PWM 107/70 = 1.53 cuando la
    // cinemática pide velocidad 2:1 → eficiencia = 2/1.53 ≈ 1.31.
    // 🔧 A/B BANCO 2026-06-14 (María, arquero SIN BNO): 131→115 = MÁS potencia a la trasera (M3),
    // SIMÉTRICA (bajar la eff → más PWM a la trasera a AMBOS lados; NO toca el piso → SIN la
    // asimetría que metía subir el piso). Objetivo: enderezar el strafe open-loop (deriva ~8°/s,
    // signo sugiere trasera floja). 🔧 TUNEAR: bajar (115→110…) = aún más trasera; si rota al OTRO
    // lado (la trasera se adelanta) → SUBIR de vuelta hacia 131. REVERTIR = 131 (valor medido).
    // Solo afecta builds con -DCENTRAL_FLOOR_SCALE (el arquero). En escape (470) la trasera se capa
    // sola a ~150 (no se quema), solo baja un toque el escape.
    constexpr int MOTOR_EFF_X100[3] = { 100, 100, 115 };
                                                      // OJO: en el strafe la trasera DEBE ir al
                                                      // DOBLE de velocidad que las delanteras
                                                      // (cinemática: fronts 0.5·vx, rear 1.0·vx);
                                                      // los pisos aplanaban esa relación 2:1 → la
                                                      // trasera quedaba lenta y el strafe arquea.
                                                      // Ideal geométrico con fronts=70 → rear=140.
#else
    #error "Debe definirse ROBOT1 (arquero) o ROBOT2 (delantero) en build_flags"
#endif

// ============================================================
// BNO055 — ⚠️ YA NO SE CONECTA EN CENTRAL (2026-05-31).
// Los 2 BNO están en el TOP; el heading llega por WORLD_SNAPSHOT de ARRIBA. Estas
// constantes + el módulo imu_zircon quedan como compat: solo se usan si se compila
// con -DCENTRAL_HAS_LOCAL_BNO (ver main_central.cpp). Default: OFF.
// ============================================================
constexpr int    BNO055_I2C_ADDR    = 0x28;
constexpr int    BNO055_INIT_TIMEOUT_MS = 3000;
constexpr int    BNO055_STABILIZE_MS    = 1000;
constexpr int    BNO055_GYRO_CALIB_MS   = 2000;
constexpr int    BNO055_HEADING_SAMPLES = 10;

// ============================================================
// Cinemática del robot — ÁNGULOS CALIBRADOS 2026-06-08 con la disposición física real (Gustavo).
// (Pendiente SOLO confirmar el SENTIDO en banco con diag_central_strafe; el sentido/identidad de los
//  motores ya estaba validado por MOTOR_INVERT. Ver el detalle en WHEEL_ANGLES_DEG abajo.)
// ============================================================
constexpr float PI_F            = 3.14159265358979323846f;
constexpr float WHEEL_RADIUS_MM = 100.0f;   // distancia del centro a cada rueda

// ✅ CALIBRADO 2026-06-08 con la DISPOSICIÓN FÍSICA REAL (Gustavo): 3 ruedas omni a 120°.
// θ = ángulo de POSICIÓN de cada rueda desde +X (derecha), antihorario (lo que usa inverse_kinematics).
//   M1 (idx0) = delantera IZQUIERDA → posición 150° desde +X
//   M2 (idx1) = delantera DERECHA   → posición  30° desde +X
//   M3 (idx2) = TRASERA (centro)    → posición 270° desde +X
// ⚠️ Los 3 motores giran HORARIO mirados desde el centro (= positivo) → OPUESTO a la convención
// antihoraria de la fórmula → se suma 180° a cada uno: {150,30,270}+180 = {330,210,90}. Eso convierte
// vx/vy en TRASLACIÓN (el viejo {60,-60,180} estaba expresado en eje +Y → la fórmula usa +X → daba
// CÍRCULOS). ⚠️ VERIFICAR SENTIDO en banco con diag_central_strafe_robot1: si traslada AL REVÉS,
// sacar el +180 → {150.0f, 30.0f, 270.0f} (el giro YA queda arreglado igual; esto es solo dirección).
constexpr float WHEEL_ANGLES_DEG[3] = { 330.0f, 210.0f, 90.0f };  // M1=del-IZQ · M2=del-DER · M3=trasera (omni 120°)

// ⚠️ SIGNO DEL TÉRMINO DE GIRO (banco robot2 2026-06-09 — hallazgo clave): el +180°
// sumado a WHEEL_ANGLES corrige la TRASLACIÓN (sin/cos cambian de signo) pero el
// término de giro ω·R de la cinemática NO depende del ángulo → quedó SIN corregir.
// Con motores que giran HORARIO-desde-el-centro a comando positivo, una ω positiva
// (CCW) del cerebro producía rotación física OPUESTA → todo PID de rumbo AMPLIFICABA
// el error en vez de corregirlo (banco: hdg −3.7→−71.5 con el gyro-hold ACTIVO,
// clavándose justo en el bail-out de 45° = la firma de la realimentación positiva;
// explica las J/U/círculos del día y, retroactivamente, parte de los "círculos"
// históricos de robot1). Fix: el mixer invierte ω. Aplica a AMBOS robots (ambos con
// los 3 motores horario validados en banco).
constexpr float OMEGA_SIGN = -1.0f;

// ============================================================
// Control de motores
// ============================================================
constexpr int MAX_PWM           = 255;    // Arduino analogWrite range
constexpr float MAX_SPEED_MM_S  = 1000.0f; // velocidad máxima estimada del robot

// Piso de PWM (deadzone compensation) — porta el IMPULSO_INICIAL del delantero 2025.
// A vx/vy bajos el PWM de rueda cae en la zona muerta del motor → raspa / se queda
// stalled (banco: "a vx=150 solo gira el motor 1"). apply_pwm_floor() (kinematics.h)
// eleva todo PWM no-nulo por debajo del piso hasta ese piso (conservando el signo) y
// manda 0 cuando |pwm| <= MOTOR_PWM_NOISE_THRESH.
//
// ⚠️ EL PISO ES POR RUEDA: MOTOR_MIN_PWM[3] está definido POR-ROBOT arriba, en el bloque
// #if (R2 = {70,70,107} validado banco 2026-06-09; R1 parte de esos mismos valores —
// ⚠️ A VERIFICAR EN BANCO R1, ver la doble historia del idx2 arriba). Es por rueda porque
// la fricción que ve cada una es distinta: las DELANTERAS van oblicuas (más fricción →
// piso más alto) y la TRASERA paralela (menos → piso más bajo, si no se adelanta y rota).
// 🔧 Tuneo del arquero: cambiar MOTOR_MIN_PWM[idx] en la rama ROBOT1 del #if de arriba.
// MOTOR_PWM_NOISE_THRESH (abajo) es global (filtra el jitter del comando para no zumbar parado).
constexpr int MOTOR_PWM_NOISE_THRESH = 5;   // |pwm| <= esto → 0 (filtra ruido, no zumba parado)

// ============================================================
// UARTs inter-placa (reasignados 2026-05-31 — ver MAPA-CONEXIONES-3-PLACAS.md)
//   • TOP→CENTRAL  (WORLD_SNAPSHOT): Serial7  RX7=pin 28, TX7=pin 29
//   • DOWN→CENTRAL (LINE_URGENT):    Serial1  RX1=pin 0,  TX1=pin 1
//   • Serial2 (7/8) queda LIBRE para el driver del motor 2 (U17) → conflicto F8 RESUELTO.
// ============================================================
constexpr long  UART_TOP_BAUD   = 230400;
// #17: las 4 constantes de pin de abajo son INFORMATIVAS (mapa de cableado). En
// Teensy 4.1 los pines de Serial7/Serial1 son FIJOS — comm_top.cpp/comm_down.cpp
// llaman Serial7.begin()/Serial1.begin() sin pasar pines, así que editar estos
// números acá NO reasigna nada. Si cambia el cableado, se cambia de Serial, no el pin.
// ⚠️ 28/29 son los pines de Serial7 EN EL TEENSY 4.1 (esta placa, CENTRAL): ahí SÍ
// son pines de borde reales. En el TOP (Teensy 4.0) NO confundir: el Serial7 del 4.0
// NO sale a pines de borde — son back-pads soldados por debajo, NO existe un "pin 28/29"
// físico en el 4.0. El número 28/29 vale como pin SOLO acá (4.1), no como pin del TOP.
constexpr int   UART_TOP_RX     = 28;  // Serial7 RX7 (TOP→CENTRAL)  [informativo]
constexpr int   UART_TOP_TX     = 29;  // Serial7 TX7                [informativo]
constexpr int   UART_DOWN_RX    = 0;   // Serial1 RX1 (DOWN→CENTRAL) [informativo]
constexpr int   UART_DOWN_TX    = 1;   // Serial1 TX1                [informativo]

// ============================================================
// Timeout de datos (snapshot stale → motors_stop) — NO es un watchdog de HW
// ============================================================
// OJO: esto NO es un watchdog de hardware. Es un TIMEOUT DE FRESCURA DE DATOS.
// El timeout REAL del snapshot vive en world_model.cpp (SNAPSHOT_TIMEOUT_MS = 500 ms):
// si no llega WORLD_SNAPSHOT del TOP en ese tiempo, main_central frena los motores.
// ⚠️ Este timeout SÓLO cubre la MUERTE del TOP (que dejen de llegar snapshots), NO un
// cuelgue del PROPIO loop de CENTRAL: si el loop de CENTRAL se traba, este chequeo vive
// DENTRO del mismo loop colgado y nunca llega a frenar los motores.
// El watchdog de HARDWARE de CENTRAL (que SÍ cubre el cuelgue del propio loop) es el
// WDOG1 del i.MX RT1062, gateado por -DCENTRAL_ENABLE_WDT (ver main_central.cpp,
// env central_robot1_wdt). DEFAULT OFF → sin el flag, el binario es idéntico (audit
// 2026-06-05 R2: WDOG1 portado del TOP a CENTRAL).
// (#15: se removió COMMAND_TIMEOUT_MS=200 — era código muerto + heredado del rol viejo
//  de "motor-server"; la CENTRAL ya NO recibe MotorCommand del TOP, arma el comando local.)
//
// merge 2026-06-03: el bloque KICKER que traía la rama del agente NO se reintegra
// — el robot NO tiene kicker físico (ya removido en main, TASK-011 cancelada). No
// reintroducir PIN_KICKER_SOL / KICKER_*.

// ============================================================
// Arranque manual fail-safe (F3) — SOLO banco, gateado por CENTRAL_ENABLE_MANUAL_START
// ============================================================
// Juez desde la PC para cuando la app del juez no funciona (bench testing):
// con el monitor serie de la CENTRAL abierto, ENTER o 'g' = GO y 's' = STOP
// (la FSM vuelve a WAIT_START y un 'g' nuevo re-arranca la secuencia completa).
// ⚠️ BOTÓN FÍSICO (pin 9): DESHABILITADO POR DEFAULT (fail-safe, 2026-06-14). En ambos
// robots el pulsador onboard del Zircon dio GO espurio (pin clavado / polaridad
// sospechada). El arranque va por el ÁRBITRO (competencia) o el TECLADO serie 'g'/'s'
// (banco) — ninguno usa este pin. El botón SOLO se lee si se compila con
// -DCENTRAL_ENABLE_PHYSICAL_BUTTON (opt-in explícito; ver main_central.cpp). El flag
// viejo CENTRAL_MANUAL_START_NO_BUTTON quedó muerto (el default ya es seguro).
// NUNCA activar CENTRAL_ENABLE_MANUAL_START en competencia (arrancar sin árbitro viola RCJ).
constexpr int PIN_MANUAL_START_BUTTON = 9;

// ============================================================
// LED de estado
// ============================================================
constexpr int PIN_LED_STATUS = 13;  // LED_BUILTIN del Teensy 4.1

}  // namespace iitasoccer
