IITA-Proyectos/open-soccer-robocup-team2026/software/teensy/Soccer 2026/src/arqueromix/amix_config.h

// amix_config.h — Constantes del programa AUTOCONTENIDO "arqueromix".
//
// CONTRATO. Es el HERMANO ARQUERO de centralmix: un PORT del ARQUERO 2025
// (software/_deprecated-2025/robot-arquero/definitivo-arquero_6-9-2026, rama
// #define ROBOT1 = ARQUERO), con el mismo enfoque que centralmix (delantero):
//   - FSM 2025 portada fiel + PRIMITIVAS DE MOTOR DIRECTAS (analogWrite/digitalWrite),
//   - alimentado por TOP/DOWN (NO por los sensores locales del 2025),
//   - SIN world_model (variables planas estilo 2025, ver amix_io.h).
//
// QUÉ REEMPLAZA (pedido de Virginia, igual que el delantero del viernes):
//   - BNO local del 2025        → HEADING del SNAPSHOT del TOP (por serie).
//   - cámara local v1 del 2025  → pelota/arcos del SNAPSHOT del TOP (por serie).
//   - 3 sensores de luz locales → LÍNEA del DOWN (LineStatusV2, por serie).
//
// PINES de motor = ZIRCON ACTUAL (R1 y R2 comparten layout en 2026):
//   M1 = INA2 / INB5 / PWM3   (delantera IZQUIERDA, U5)
//   M2 = INA8 / INB7 / PWM6   (delantera DERECHA,   U17)
//   M3 = INA11 / INB12 / PWM4 (TRASERA,             U7)
//   MOTOR_INVERT = {+1, +1, +1}  (banco 2026, ambos robots)
//
// ⚠️ OJO MAPEO 2025↔2026: el arquero 2025 era #define ROBOT1 con pines
// M1=2/5/3, M2=8/7/6, M3=11/12/4 (FIEL §3.1). Coincide con el layout 2026 → se usan
// esos. Pero el SENTIDO FÍSICO de cada primitiva se RE-VERIFICA en banco (compila != anda).
//
// ⚠️ NO TESTEADO EN HARDWARE. Los valores numéricos son el port 1:1 del 2025
// (docs/internal/ANALISIS-FIEL-ARQUERO-2025.md); el sentido y los umbrales en mm se
// validan/re-tunean en banco (TASK del equipo).

#pragma once
#include <stdint.h>

namespace iitasoccer {
namespace arqmix {

// ============================================================
// Pines de motor — Zircon 2026 (espejo de config_central.h + centralmix/mix_config.h).
// ============================================================
constexpr int AMIX_PIN_INA1 = 2;   // M1 delantera IZQUIERDA (U5)
constexpr int AMIX_PIN_INB1 = 5;
constexpr int AMIX_PIN_PWM1 = 3;
constexpr int AMIX_PIN_INA2 = 8;   // M2 delantera DERECHA (U17)
constexpr int AMIX_PIN_INB2 = 7;
constexpr int AMIX_PIN_PWM2 = 6;
constexpr int AMIX_PIN_INA3 = 11;  // M3 TRASERA (U7)
constexpr int AMIX_PIN_INB3 = 12;
constexpr int AMIX_PIN_PWM3 = 4;

// Sentido por motor ({+1,+1,+1} banco 2026). [0]=M1, [1]=M2, [2]=M3.
constexpr int AMIX_MOTOR_INVERT[3] = { +1, +1, +1 };
constexpr int AMIX_MAX_PWM = 255;

// ============================================================
// ESCALA GLOBAL DE POTENCIA +6% (test María 2026-07-04, gateado -DARQMIX_POWER_106).
// ----------------------------------------------------------------------------------
// Sube TODAS las potencias del camino VIVO del modo quieto en la MISMA proporción (+6%):
// así no cambia la geometría de ningún patrón de movimiento (la relación entre ruedas y
// entre movimientos se conserva), solo la velocidad general. Pedido María: "subir la
// velocidad de forma proporcional".
// El factor se aplica UNA sola vez por valor: en los PWM fijos de las primitivas y en los
// factores `pd` (AMIX_PD_BASE/BALL). A los AMIX_PROP_* NO se les aplica (ya los multiplica
// el `pd` en runtime → sería escalar DOS veces). Tampoco escala: AMIX_ATRAS ni el impulso
// inicial (código muerto en modo quieto), FORWARD_BIAS (off), ROT_MAX/KP_RUMBO (sin uso en
// el camino quieto).
// ⚠️ Con el flag OFF el factor es 1.0 → todos los valores quedan EXACTOS como antes
// (checkpoints 1-7 byte-idénticos). <TITRAR EN BANCO>: si algo se pasa de largo (en
// especial el retroceso a la línea, que se bajó a 80 a propósito), volver al env sin
// este flag o bajar el valor puntual.
// ============================================================
#ifdef ARQMIX_POWER_106
constexpr double AMIX_POWER_SCALE = 1.06;   // +6% parejo a todo el camino vivo
#else
constexpr double AMIX_POWER_SCALE = 1.0;    // sin flag: potencias históricas intactas
#endif
// Redondeo al entero más cercano (con 1.0 devuelve el valor original exacto).
constexpr int amix_pow(int v) { return (int)(v * AMIX_POWER_SCALE + 0.5); }

// ============================================================
// PATRULLA — adproporcional() / aiproporcional() (FIEL §5, código 2025 L186-233).
// Strafe lateral con CORRECCIÓN DE RUMBO en 3 bandas según el signo de `error`
// (error = heading - heading_inicial). Las delanteras (M1,M2) van al MISMO sentido;
// la trasera (M3) al opuesto, y su magnitud cambia por banda para enderezar.
// Valores 2025 (multiplicados por `pd` en runtime). Los comentarios //NN del 2025 eran
// valores ANTIGUOS (no activos) — acá van los ACTIVOS.
// ============================================================
//  Banda CENTRADA (-1 < error < 1):
constexpr int AMIX_PROP_FRONT_CENTER = 50;   // M1 y M2
constexpr int AMIX_PROP_REAR_CENTER  = 89;   // M3
//  Banda error > 0:
constexpr int AMIX_PROP_FRONT_EPOS   = 50;   // M1 y M2 (ambas funciones)
constexpr int AMIX_AD_REAR_EPOS      = 100;  // adproporcional (derecha) M3
constexpr int AMIX_AI_REAR_EPOS      = 40;   // aiproporcional  (izquierda) M3
//  Banda error < 0 (M1 y M2 difieren entre sí):
constexpr int AMIX_PROP_M1_ENEG      = 40;   // "motor derecho" (idx0=M1) 2025
constexpr int AMIX_PROP_M2_ENEG      = 65;   // "motor izquierdo" (idx1=M2) 2025
constexpr int AMIX_AD_REAR_ENEG      = 40;   // adproporcional M3
constexpr int AMIX_AI_REAR_ENEG      = 75;   // aiproporcional M3 — REVERTIDO a 75 (banco Virginia 2026-06-21: la versión 65 + sesgo forward hacía MEDIALUNA a la izquierda → se volvió al estado anterior que andaba mejor). 100→75. (1.875× la derecha=40.)

// `pd` (factor proporcional): patrulla base, ×1.5 con pelota desviada.
// BAJADO 1.0→0.85 (banco Virginia 2026-06-21): patrulla más LENTA (-15%) sin caer en zona muerta (el
// patrón de PWM se escala parejo). ⚠️ NO bajar de 0.80 o las delanteras (piso ~70) stallean → si a
// 0.85 se traba/espasmódico, SUBIR a 0.90 (no bajar).
// (×AMIX_POWER_SCALE: el +6% gateado entra por acá para los strafes — NO tocar los PROP_*.)
constexpr float AMIX_PD_BASE = (float)(0.85 * AMIX_POWER_SCALE);  // 0.85 histórico (0.901 con +6%)
constexpr float AMIX_PD_BALL = (float)(1.5  * AMIX_POWER_SCALE);  // 1.5 histórico (1.59 con +6%)

// SESGO HACIA ADELANTE de la patrulla (pedido Virginia 2026-06-21: el arquero deriva hacia ATRÁS y se
// mete al área/corner; quiere "tendencia a avanzar en la cancha"). Es un micro-empuje RECTO al frente
// sumado al strafe: en la geometría omni-3 (M1 del-IZQ, M2 del-DER, M3 trasera), avanzar = M1=+, M2=-,
// así que el sesgo SUMA al M1 y RESTA al M2 con signos FIJOS (no sigue el signo del strafe). Lo aplican
// ad/aiproporcional → vale en patrulla y en el rebote (ayuda a no quedar atrás). 0 = off.
// ⚠️ A VALIDAR EN BANCO: subir si sigue derivando atrás; bajar si se va para adelante / se sale del arco.
// -DARQMIX_NO_FORWARD_BIAS lo apaga.
// ⚠️ REVERTIDO A OFF por default (banco Virginia 2026-06-21): con el sesgo en 10 el arquero hacía una
// MEDIALUNA a la izquierda (combinado con el rumbo sin corregir bien). Queda como OPT-IN: prender con
// -DARQMIX_FORWARD_BIAS si se quiere experimentar la "tendencia a avanzar".
#ifdef ARQMIX_FORWARD_BIAS
constexpr int AMIX_FORWARD_BIAS_PWM = 10;   // ~3-4% de empuje neto al frente (experimental)
#else
constexpr int AMIX_FORWARD_BIAS_PWM = 0;    // DEFAULT OFF (= comportamiento "de antes", sin medialuna)
#endif

// ============================================================
// Impulso inicial / anti-traba del borde (FIEL §2, L1018-1020 + impulso_*).
// ============================================================
// impulso_inicial (arquero, estado inicial): strafe corto 40 ms para despegarse.
//   2025: M1=M2=90, M3=153. BAJADO 2026-06-21 (banco Virginia): el arranque daba un tirón
//   fuerte; 153 rozaba el techo térmico. Más suave para que el inicio sea prolijo y verificable.
constexpr int AMIX_IMP_INI_FRONT = 70;   // M1, M2 (era 90)
constexpr int AMIX_IMP_INI_REAR  = 110;  // M3 (era 153)

// ============================================================
// Avance / despeje (FIEL §2/§5).
// ============================================================
// avanzar(): M1=100, M2=100(sentido opuesto), M3=0. (L152-154)
constexpr int AMIX_AVANZAR = amix_pow(100);  // 100 histórico (106 con +6%)
// avanzar_patear() (arquero): RAMPA DE ACELERACIÓN como el DELANTERO (centralmix), pedido Virginia
// 2026-06-21 (el despeje fijo asimétrico "no apuntaba bien" → veraba). Sube la velocidad de a pasos
// desde 0 hasta VEL_FINAL → el golpe arranca suave y sale parejo. Patrón SIMÉTRICO M1=+vel, M2=-vel,
// M3=0 = avance RECTO al frente (a diferencia del 250/150 asimétrico del 2025 que torcía).
// Misma receta que el delantero (mix_config.h KICK_*). Potencia moderada (pedido previo de bajarla).
constexpr int AMIX_KICK_VEL_FINAL    = amix_pow(180);  // 180 histórico (191 con +6%) — pico del golpe; subir si no llega a despejar
constexpr int AMIX_KICK_PASO         = 20;   // incremento de PWM por escalón de la rampa
constexpr int AMIX_KICK_INTERVALO_MS = 10;   // ms entre escalones (rampa 0→180 en ~90 ms)
#ifdef ARQMIX_KICK_TRIM
// TRIM DEL GOLPE (test María 2026-07-04, gateado -DARQMIX_KICK_TRIM): en banco el despeje se DESVÍA
// SIEMPRE A LA IZQUIERDA aunque el patrón M1=+vel/M2=-vel es simétrico (asimetría física: eficiencia
// de motores/fricción/peso). Mismo remedio que el delantero (mix_config.h MIX_KICK_FWD_TRIM): un
// diferencial de PWM en la delantera IZQUIERDA (M1) que escala CON la rampa (a mitad de rampa aplica
// la mitad; el valor nominal es el del PICO). SIGNO: se desvía a la IZQUIERDA → trim POSITIVO (la
// izquierda empuja más → endereza); si sobre-corrige y ahora tira a la DERECHA → BAJAR; si con el
// máximo de titración sigue yendo a la izquierda → SUBIR de a 5. <TITRAR EN BANCO>
constexpr int AMIX_KICK_TRIM_PWM = 8;   // PWM extra de M1 en el pico del golpe. TITRACIÓN (banco María
                                        // 2026-07-04): 0 = se iba a la IZQUIERDA · 15 = se pasó (DERECHA)
                                        // → 8 (bisección). Si aún derecha → 5; si volvió a izquierda → 11.
#endif
// PATEANDO_atras_arquero (inline 2025, L1186-1188): retroceso recto M1=ATRAS, M2=ATRAS, M3=0.
constexpr int AMIX_ATRAS = 120;      // retroceso del despeje (PATRULLA) — NO tocar (queda como andaba)
// Retroceso del modo QUIETO — MÁS LENTO que la patrulla (banco Virginia 2026-06-21: a 120 el arquero se
// METÍA en el área chica porque cruzaba la línea por inercia + latencia antes de frenar). Más lento = para
// más JUSTO en la línea sin cruzarla. Separado de AMIX_ATRAS para NO tocar el retroceso de la patrulla.
// ⚠️ A 80 está sobre el piso de las delanteras (70) → se mueve. Si AÚN se mete → bajar a 75; si NO arranca
// (tironea) → subir. <TITRAR EN BANCO>
constexpr int AMIX_ATRAS_QUIETO = amix_pow(80);  // 80 histórico (85 con +6%) ⚠️ el más sensible del +6%: se bajó a 80 para NO cruzar la línea
#ifdef ARQMIX_RETRO_CUT_BALL
// CORTE DEL RETROCESO POR PELOTA (test María 2026-07-04, gateado -DARQMIX_RETRO_CUT_BALL): si mientras
// RETROCEDE tras el despeje (PATEANDO_atras) VE la pelota, CORTA el retroceso y vuelve a esperar_quieto
// (que ya sabe seguirla/posicionarse/despejar). Pedido María: "si ve pelota que corte el retroceso y
// vaya y busque la pelota y se posicione". SOLO aplica al retroceso POST-PATEO — NO al homing del GO
// (al arrancar el partido la pelota está en el centro y SIEMPRE se ve → cortaría el homing y el arquero
// nunca llegaría a su arco). Knob: distancia máxima de la pelota para cortar; 9999 = corta con CUALQUIER
// pelota vista (pedido literal). ⚠️ Riesgo a titrar: con pelota LEJANA visible el arquero no vuelve a la
// línea (queda adelantado). Si en banco se ve eso → BAJAR a ~800-1000 mm (corta solo con pelota cerca).
constexpr float AMIX_RETRO_CUT_DIST_MM = 9999.0f;
#endif
// FRENO DE PATADA (SOLO modo quieto, banco Virginia 2026-06-22): si detecta LÍNEA mientras patea, parar() NO
// alcanza —la INERCIA del golpe lo saca de la cancha—. Da un contra-empuje FUERTE hacia atrás (plugging) por
// un tiempo CORTO para MATAR el impulso y despegarse de la línea, y recién después sigue la secuencia
// post-patada (pausa → orientar → retroceder). Fuerte y corto a propósito.
constexpr int           AMIX_FRENO_PATADA_PWM = amix_pow(200);  // 200 histórico (212 con +6%) — PWM del freno-retroceso (alto = frena rápido). Subir si igual se sale; bajar si rebota mucho atrás.
constexpr unsigned long AMIX_T_FRENO_PATADA   = 250;  // ms del freno (corto, estilo plugging 2025). Subir si no frena a tiempo; bajar si se va de atrás.

// RETROCESO POST-PATEO "HASTA LA LÍNEA + ESCAPE ADELANTE" (SOLO modo quieto, gateado, pedido María 2026-07-01):
// al VOLVER hacia atrás tras patear (PATEANDO_atras) el arquero se metía / cruzaba la línea. FIX espejo del
// HOMING del arranque: (1) el retroceso va HASTA detectar la línea (sin el gate de frescura ni el safety corto
// que lo cortaban antes; queda solo una red anti-cuelgue grande) y (2) al pisar la línea AVANZA al frente HASTA
// despegarse (estado escapar_adelante, condición NO tiempo). Reusa la primitiva/constantes del homing.
#ifdef ARQMIX_RETRO_BRAKE_ON_LINE
// RED DE ÚLTIMO RECURSO del retroceso post-pateo (banco María 2026-07-01): el retroceso termina SÓLO al DETECTAR
// la línea (como el homing del inicio, que "siempre anda bien") — se le SACARON el gate de frescura de DOWN y el
// safety corto de 4 s, que lo cortaban ANTES de pisar la línea. Esto queda SÓLO como red anti-cuelgue: NO debería
// dispararse nunca en juego; sólo evita retroceder infinito si DOWN muriera y la línea NUNCA se viera. Grande a
// propósito (~ el del homing). Para sacarlo del todo (retroceso 100% "hasta la línea") subirlo aún más.
constexpr unsigned long AMIX_T_ATRAS_SAFETY_RETRO = 50000;  // ms (RED, no un corte normal). <banco: no tocar salvo que corte antes de la línea>
// El ESCAPE tras tocar la línea = AVANZAR al frente HASTA despegarse (estado escapar_adelante), espejo del homing:
// reusa las constantes AMIX_T_INICIO_AVANCE_MIN/SAFETY y la primitiva avanzar_inicio() — no necesita propias.
#endif

// ============================================================
// ALINEAR AL ARCO RIVAL antes de despejar (pedido Gustavo 2026-06-21).
// ----------------------------------------------------------------------------------
// Antes de patear, el arquero GIRA en el lugar para apuntar su FRENTE al ARCO RIVAL (goal_opp) y
// despejar HACIA AHÍ (no sólo "lejos / recto"). Quién es el arco rival lo resolvió la placa TOP
// (goal_polarity, por ángulo); el arquero NO pregunta el COLOR. Si NO ve el arco rival, patea
// RECTO al frente (comportamiento del arquero 2025 = fallback). Acotado por tolerancia + timeout
// para no demorar el despeje ni sacar al arquero de su arco.
// ============================================================
constexpr float AMIX_TOL_ARCO_OPP_DEG = 12.0f;  // |áng al arco rival| <= esto → ALINEADO → patea.
                                                // Más amplio = patea antes pero menos preciso. <RE-TUNE>
constexpr int   AMIX_GIRO_ALINEAR_PWM = amix_pow(90);  // 90 histórico (95 con +6%) — PWM del giro de alineación (suave/controlado). <RE-TUNE>
constexpr unsigned long AMIX_T_ALINEAR_OPP = 300; // tope girando: si no logra alinear, patea igual (no
                                                  // demora el despeje). ARRANCA CONSERVADOR (300 ms) para NO
                                                  // sacar al arquero de su arco ni perder la pelota durante el
                                                  // giro; SUBIR en banco si no llega a apuntar. <tunable>
// SENTIDO del giro: ang>0 (arco a la derecha) debe girar para traer el arco al frente. El sentido
// físico de girar() depende del cableado 2026 → se RE-VERIFICA en banco. -DARQMIX_FLIP_GIRO_ALINEAR
// lo invierte si el arquero gira para el lado CONTRARIO al arco.
#ifdef ARQMIX_FLIP_GIRO_ALINEAR
constexpr int AMIX_GIRO_ALINEAR_SIGN = -1;
#else
constexpr int AMIX_GIRO_ALINEAR_SIGN = +1;
#endif

// ============================================================
// Tolerancias de la pelota — POR ÁNGULO (como centralmix usa la cámara). FIX 2026-06-21.
// ----------------------------------------------------------------------------------
// PROBLEMA que arregla (banco Virginia): con umbrales en mm (CENTRADO=30/DESVIO=50/
// CERCANIA=140) la pelota caía en la BANDA MUERTA para la escala REAL del snapshot
// (CAMERA_UNIT_TO_MM=10 sin calibrar) → el FSM hacía parar() → la cámara veía la pelota
// pero el robot NO se movía (freeze).
// FIX: el arquero SIGUE la pelota por su ÁNGULO (g_aio.angulo_pelota_deg = atan2(x,y)),
// que NO depende de la escala — igual que el delantero (centralmix). La banda muerta
// angular es ANGOSTA → el arquero trackea cualquier pelota off-center.
//   angulo_pelota_deg: 0=frente, >0=derecha, <0=izquierda.
// ============================================================
#ifdef ARQMIX_CENTRADO_FINO
// CENTRADO FINO (test María 2026-07-03, gateado): banda muerta angular MÁS ANGOSTA. PROBLEMA que ataca
// (banco María, _evita_lejos): como la banda es POR ÁNGULO, el corrimiento lateral que acepta crece con
// la distancia (≈ distancia × tan(tol): a 8° ≈ 14% → pelota a 1,5 m = hasta ~21 cm corrido y el FSM lo da
// por "centrado"). A 5° el corrimiento baja a ≈ 9% (~13 cm a 1,5 m). Riesgo: banda angosta + piso de PWM
// = "caza" la pelota lejana con micro-strafes que no terminan (oscilación). <TITRAR EN BANCO>: si oscila
// sin parar → subir a 6; si sigue quedando corrido → bajar a 4 (no menos: ruido angular de la cámara). Era 8.
constexpr float AMIX_TOL_CENTRADO_DEG = 5.0f;
#else
constexpr float AMIX_TOL_CENTRADO_DEG = 8.0f;   // |áng| <= esto → ALINEADO (mantiene posición).
                                                // |áng| > esto  → SIGUE la pelota (strafe a su lado).
#endif
constexpr float AMIX_TOL_KICK_DEG     = 30.0f;  // para DESPEJAR: la pelota debe estar dentro de
                                                // este ángulo (más amplio que CENTRADO) Y cerca.
constexpr float AMIX_TOL_CERCANIA_MM  = 250.0f; // DESPEJA si la distancia euclídea a la pelota
                                                // (sqrt(x²+y²)) <= esto. ⚠️ EL knob de tuning
                                                // principal (la escala del snapshot está sin
                                                // calibrar): subir si nunca despeja, bajar si
                                                // despeja de lejos. <RE-TUNE EN BANCO>

// ============================================================
// Tiempos / timeouts del ARQUERO (FIEL §3.5) — ms. Iguales 2025.
// ============================================================
// MOVIMIENTO LATERAL INICIAL (SOLO modo quieto, pedido Virginia 2026-06-21): al GO, ANTES del homing,
// el arquero se mueve un poco a la IZQUIERDA durante este tiempo y recién después va hacia atrás.
constexpr unsigned long AMIX_T_INICIO_LATERAL = 1600;  // cuánto se mueve a la izquierda al arrancar (a ciegas). "un poco".
// AVANCE al BUSCAR la pelota y tocar LÍNEA lateral (SOLO modo quieto, banco Virginia 2026-06-22): en vez de
// seguir lateral (se metía al área), AVANZA al frente. Para despegarse BIEN del borde, sigue avanzando ESTE
// tiempo DESPUÉS de dejar de ver la línea (avance "un poco más grande"). Subir si queda pegado al borde.
#ifdef ARQMIX_BUSCAR_AVANCE_LARGO
// ESCAPE DE LÍNEA AL BUSCAR más GRANDE (test María 2026-07-03, gateado): avanza más tiempo tras tocar la línea
// para despegarse mejor del borde. Subir más si queda pegado; bajar si se mete al campo. Era 400.
constexpr unsigned long AMIX_T_BUSCAR_AVANCE = 500;
#else
constexpr unsigned long AMIX_T_BUSCAR_AVANCE = 400;
#endif

// RE-HOMING POR PÉRDIDA DE PELOTA (test María 2026-07-03, gateado -DARQMIX_REHOME_NO_BALL): si pasan estos ms SIN
// ver la pelota (esperando quieto), el arquero vuelve una vez hacia atrás HASTA detectar la línea + se acomoda
// (escape), y sigue esperando. Subir/bajar para cambiar cada cuánto se re-acomoda si perdió la pelota.
#ifdef ARQMIX_REHOME_NO_BALL
#ifdef ARQMIX_REHOME_RAPIDO
// RE-HOMING RÁPIDO (test María 2026-07-04, gateado -DARQMIX_REHOME_RAPIDO): pedido "pasados 5 segundos
// que no ve la pelota que vaya hacia atrás hasta la línea". Baja el timer 15 s → 5 s, y además el
// retroceso del RE-HOMING corta si VE la pelota (ver amix_fsm.cpp: solo el del re-homing — el homing
// del GO NO corta, porque al arrancar el partido la pelota del centro siempre se ve).
constexpr unsigned long AMIX_T_REHOME_NO_BALL = 5000;   // 5 s sin ver la pelota → re-homing. <TITRAR>
#else
constexpr unsigned long AMIX_T_REHOME_NO_BALL = 15000;  // 15 s sin ver la pelota → re-homing. <TITRAR>
#endif
#endif

// ACOMODARSE antes de quedar quieto (2 estados nuevos, pedido Virginia 2026-06-22): (1) acomodar_linea =
// si TOCA línea (lateral o atrás), despegarse "un poco" hacia el lado OPUESTO; (2) acomodar_orientar =
// re-orientar al FRENTE con el BNO (heading→0, mismo bang-bang que orientar_frente). Así, cuando queda
// quieto, NUNCA está sobre la línea y SIEMPRE mira al frente. Van tras el homing Y tras el retroceso.
constexpr float         AMIX_ACOMODAR_ATRAS_DEG      = 90.0f;  // |line_angle| >= esto → línea ATRÁS → AVANZAR; si no → strafe lateral OPUESTO
constexpr unsigned long AMIX_T_ACOMODAR_LINEA_SAFETY = 1500;   // tope despegándose de la línea (no quedarse atascado)
// SIGNO del lado de la línea: la convención de line_angle del DOWN NO está validada en banco. Si en
// acomodar_linea el arquero despega para el lado EQUIVOCADO → invertir con -DARQMIX_FLIP_ACOMODAR_LINEA.
#ifdef ARQMIX_FLIP_ACOMODAR_LINEA
constexpr float AMIX_ACOMODAR_LINEA_SIGN = -1.0f;
#else
constexpr float AMIX_ACOMODAR_LINEA_SIGN = +1.0f;
#endif
// ORIENTAR AL ARCO RIVAL tras el despeje (SOLO modo quieto). FASE 1 (pedido Virginia 2026-06-21): se
// orienta por GIROSCOPIO (heading_error_deg → 0), NO por cámara (goal_opp se ensucia al girar y llega a
// ~4 Hz). Control BANG-BANG con BANDA ANCHA (skill control-pid-zona-muerta): gira al piso
// (AMIX_GIRO_FRENTE_PWM) o para — nunca pide una corrección por debajo del piso (esa era la zona muerta que
// hacía serpentear). El cero del heading = "mirando al rumbo de colocación" = al arco rival (MISMA
// referencia que el strafe lateral que YA anda). Gateado por heading_valid: sin heading bueno NO gira a ciegas.
constexpr unsigned long AMIX_T_ORIENTAR_SAFETY = 3000;  // tope girando: si no logra orientarse, sigue igual
// BANDA MUERTA de orientación: |heading_error| <= esto → "mirando al oponente", para. ANCHA a propósito:
// a ~4-6 Hz (latencia del heading del TOP) girando al piso el robot rota varios grados por ciclo; una banda
// fina (±2°) haría overshoot y serpenteo. ±8° = misma tolerancia que el resto del arquero
// (AMIX_TOL_CENTRADO_DEG). SUBIR si serpentea alrededor del cero; bajar si queda muy torcido. <TITRAR>
constexpr float AMIX_TOL_ORIENTAR_DEG = 8.0f;
// PWM del giro de orientación (FASE 1: BANG-BANG por giroscopio). Gira a ESTE PWM fijo hacia el rumbo
// objetivo mientras |heading_error| > AMIX_TOL_ORIENTAR_DEG, y para dentro de la banda. Es "continuo y
// lento" (gira al piso del motor) SIN caer en zona muerta (bang-bang, no proporcional fino: o gira al piso
// o para).
// BANCO Virginia 2026-06-21: a 70 giraba continuo pero MUY rápido; bajado a 50 (la velocidad "tal vez está
// bien"). Si TIRONEA (stick-slip = por debajo del piso) → subir de a 5; si gira muy rápido → no se puede más
// lento en continuo (es el piso del motor en rotación). <TITRAR EN BANCO>
constexpr int AMIX_GIRO_FRENTE_PWM = amix_pow(50);  // 50 histórico (53 con +6%) — PWM fijo del giro de orientación (bang-bang). Si tironea, subir; no baja del piso.
// (OBSOLETAS: el giro ya NO es pulsado. Se conservan por si se decide volver al esquema PFM.)
constexpr unsigned long AMIX_T_GIRO_VENTANA = 350;  // [sin uso] ventana del pulso PFM viejo
constexpr unsigned long AMIX_T_GIRO_ON      = 90;   // [sin uso] ON del pulso PFM viejo
// RETROCESO CON RUMBO al arco rival (SOLO modo quieto, pedido Virginia 2026-06-21: al frenar la
// alineación, la INERCIA lo desalineaba; ahora el retroceso MANTIENE el frente al arco rival con un
// control PROPORCIONAL). Guía skill control-pid-zona-muerta: P con BANDA MUERTA + TOPE (sin D contra
// actuador cuantizado; I sólo si deriva). La autoridad de rotación sale del desbalance M1/M2 (el M3
// queda bajo su piso). Valores de arranque ~ los validados del arquero (kp 2.0, trim_max 30).
constexpr float AMIX_KP_RUMBO_OPP    = 2.0f;  // ganancia proporcional (PWM por grado de error al arco rival). Subir si no alcanza a corregir; bajar si serpentea.
constexpr float AMIX_DEADBAND_OPP_DEG = 5.0f; // banda muerta: |áng al arco| < esto → corrección 0 (no perseguir ruido)
constexpr int   AMIX_ROT_MAX          = 30;   // tope de la corrección de rotación (PWM). Sumado al retroceso M1/M2.
// INICIO — homing al área chica (banco Virginia 2026-06-21): retrocede hasta ver la línea del
// área, avanza un poco a ciegas, y recién ahí patrulla.
// ⚠️ SAFETY a 50 s TEMPORAL (pedido Virginia, para observar el retroceso): después bajar a ~4 s.
constexpr unsigned long AMIX_T_INICIO_RETRO_SAFETY = 50000; // TEMP 50 s (era 4000) — bajar luego
// Avance de SALIDA de la línea del área (homing). Banco Virginia 2026-06-21: con tiempo FIJO a veces
// el arquero quedaba muy cerca de la línea de fondo / medio metido en el área chica. FIX: el arranque
// NO termina por reloj — avanza el impulso MÍNIMO y sale recién cuando YA NO PISA la línea (no ve
// blanco), con un TOPE de seguridad para no quedarse trabado si la línea nunca se "apaga". El avance es
// recto al frente (hacia el campo, lejos del fondo) → es la dirección que lo SACA del área.
constexpr unsigned long AMIX_T_INICIO_AVANCE_MIN    = 400;   // REVERTIDO a 400 (volvió al estado que andaba mejor; era 500). Impulso mínimo del avance de salida de la línea. Sube si parpadea la línea / queda cerca del fondo.
constexpr unsigned long AMIX_T_INICIO_AVANCE_SAFETY = 1200;  // TOPE de seguridad: si a los 1200 ms sigue viendo línea, patrulla igual
// VELOCIDAD del avance del homing (el movimiento a ciegas tras detectar la línea). Banco Virginia
// 2026-06-21: "anda de golpe / fuerte" → SOLO se baja la velocidad (90→75... acá 75). MISMO sentido y
// MISMOS 400 ms que el base; lo ÚNICO distinto vs avanzar() es el PWM. 75 queda apenas sobre el piso
// de las delanteras (70): si STUTTEA/no arranca, subir hacia 85; bajar más NO lo hace más suave (zona
// muerta → tironea). Si aún va "de golpe" el tema es el arranque sin rampa, no el PWM (avisar).
constexpr int AMIX_INICIO_AVANCE_PWM = amix_pow(75);  // 75 histórico (80 con +6%)
// Retroceso del homing: primitiva DEDICADA con PWM propio (no acoplada al despeje) y dirección
// flippable. retroceder_inicio() = M1=-PWM, M2=+PWM (= patrón patear_atras = hacia ATRÁS) × SIGN.
// ⚠️ Si al GO el robot va hacia ADELANTE en vez de atrás → flashear con -DARQMIX_FLIP_INICIO_RETRO.
constexpr int AMIX_INICIO_RETRO_PWM = amix_pow(100);  // 100 histórico (106 con +6%) — retroceso de inicio (controlado, no a tope)
#ifdef ARQMIX_FLIP_INICIO_RETRO
constexpr int AMIX_INICIO_RETRO_SIGN = -1;  // invierte la dirección del retroceso de inicio
#else
constexpr int AMIX_INICIO_RETRO_SIGN = +1;
#endif
constexpr unsigned long AMIX_T_PAT_PAUSA_INI = 200;   // PATEANDO_pausa_inicial_arquero
#ifdef ARQMIX_KICK_FAR
// GOLPE MÁS LARGO (test María 2026-07-03, gateado -DARQMIX_KICK_FAR): la pelota va MÁS LEJOS porque el arquero
// EMPUJA más tiempo (misma fuerza AMIX_KICK_VEL_FINAL=180, más duración). Subir más si aún queda corto; bajar
// si el arquero se impulsa demasiado al frente y se despega mucho de su arco. <TITRAR EN BANCO>
constexpr unsigned long AMIX_T_PAT_ADELANTE  = 550;   // golpe MÁS LARGO (era 450)
#else
constexpr unsigned long AMIX_T_PAT_ADELANTE  = 450;   // PATEANDO_adelante_arquero (golpe COMPLETO)
#endif
#ifdef ARQMIX_KICK_SHORT_ON_LINE
// Golpe CORTO cuando el despeje arranca SOBRE la línea (gateado, pedido Virginia 2026-06-29): menos tiempo de
// empuje → menos envión hacia adelante → no se sale de la cancha. ~250 ms (vs 450). Subir si no despeja la
// pelota lo suficiente; bajar si todavía se sale. <TITRAR EN BANCO>
constexpr unsigned long AMIX_T_PAT_ADELANTE_CORTO = 250;
#endif
constexpr unsigned long AMIX_T_PAT_PAUSA     = 1000;  // PATEANDO_pausa_arquero
// (PATEANDO_atras_arquero NO tiene timeout en 2025: retrocede hasta ver blanco. Acá se
//  agrega un timeout de SEGURIDAD para no colgarse — ver amix_fsm. <MEJORA 2026>)
constexpr unsigned long AMIX_T_ATRAS_SAFETY  = 4000;  // tope de seguridad del retroceso (NO estaba en 2025)

// MODO "RETROCESO POR TIEMPO" (test María 2026-07-02, gateado -DARQMIX_RETRO_BY_TIME): en esta cancha la línea
// NO se detecta confiable (el robot da "lifted" / calibración vieja) — así que los DOS retrocesos que dependían
// de la línea pasan a ser por TIEMPO FIJO y NO leen la línea. (1) el retroceso del arranque/homing
// (inicio_retroceder) y (2) el retroceso post-pateo (PATEANDO_atras). El resto del arquero NO cambia.
#ifdef ARQMIX_RETRO_BY_TIME
constexpr unsigned long AMIX_T_INICIO_RETRO_FIXED = 400;   // ms del retroceso inicial (homing) POR TIEMPO. <TITRAR>  (era 1500, bajado a 400 — María 2026-07-02)
constexpr unsigned long AMIX_T_ATRAS_FIXED        = 1300;  // ms del retroceso post-pateo POR TIEMPO. <TITRAR>
#endif

// ============================================================
// Línea (de DOWN) — reemplaza los 3 sensores de luz locales del 2025.
// El 2025 detectaba el borde con s1>=blanco1 || s2>=blanco2 (no s3) durante la
// patrulla, y s1||s2||s3 para "volví a la línea" tras el retroceso. Acá la línea
// llega como line_present/line_depth (amix_io, de DOWN). line_depth>=TRIGGER = tocando.
// ============================================================
constexpr uint8_t AMIX_LINE_DEPTH_TRIGGER = 1;  // ≥1 sensor en blanco = línea presente

// ============================================================
// ANTI-CHOQUE con el ULTRASONIDO (gateado -DARQMIX_AVOID_OBSTACLE, pedido María 2026-07-01).
// ----------------------------------------------------------------------------------
// Si min_obstacle_mm del snapshot del TOP (= min(4 ToF + HC-SR04); top_robot2_pri trae -DTOP_ENABLE_MULTI_TOF)
// detecta algo a <= este umbral al FRENTE, el arquero FRENA y espera (no se mueve hacia el rival, incluido el
// despeje). Cuando el obstáculo se aleja/desaparece (0xFFFF), sigue normal solo. "Frenar y esperar" (decisión
// María), NO retroceder. KILL-SWITCH: 0 = apagado.
// ⚠️ SUPUESTO + CHEQUEO BLOQUEANTE: este anti-choque asume que en R2 min_obstacle es EFECTIVAMENTE sólo el
// ULTRASONIDO (montado alto → no ve la pelota). Eso SÓLO se cumple si los ToF están DESHABILITADOS en la EEPROM
// del TOP; el HC-SR04 no ve la pelota, pero los ToF van más bajo y SÍ podrían verla. **CONFIRMAR EN BANCO** que
// la PELOTA no baja min_obstacle_mm de este umbral (leer snap_min_obstacle_mm por telemetría acercando SÓLO la
// pelota). Si se dispara con la pelota, el arquero no despejaría → deshabilitar/enmascarar los ToF frontales en
// la config del TOP (g_top_cfg.tof[i].enabled/zone_mask), NO se arregla desde acá.
#ifdef ARQMIX_AVOID_OBSTACLE
constexpr uint16_t ARQMIX_OBST_STOP_MM = 150;  // <15 cm al frente → parar y esperar. 0 = apagado. <TITRAR EN BANCO>
#endif


// ============================================================
// Comunicación — enlaces TOP (Serial7) y DOWN (Serial1), 230400 (= comm_top/comm_down).
// ============================================================
constexpr long AMIX_UART_BAUD = 230400;

// ============================================================
// Heading — FUENTE = SNAPSHOT del TOP por default (pedido de Virginia: el BNO se lee
// por serie de la placa superior, NO local). Con -DARQMIX_HEADING_OTOS usa el heading
// crudo del OTOS (Pose2D de DOWN) para A/B. NO se inicializa ningún BNO local.
// ============================================================
#ifdef ARQMIX_HEADING_OTOS
constexpr bool AMIX_HEADING_SOURCE_IS_OTOS = true;
#else
constexpr bool AMIX_HEADING_SOURCE_IS_OTOS = false;  // DEFAULT: heading del TOP (snapshot)
#endif

// SIGNO de la corrección de rumbo de la patrulla (las 3 bandas de error en ad/aiproporcional).
// ✅ VALIDADO EN BANCO (Virginia 2026-06-21): el signo CORRECTO para este robot es -1 (con +1 el
// arquero se daba vuelta 180° mientras patrullaba; con -1 queda derecho). Es el DEFAULT.
// El flag -DARQMIX_HEADING_SIGN_OLD vuelve al +1 viejo (NO usar salvo diagnóstico). Requiere
// heading válido del TOP para que la corrección actúe.
#ifdef ARQMIX_HEADING_SIGN_OLD
constexpr float AMIX_HEADING_CORRECT_SIGN = +1.0f;  // viejo (daba 180°) — solo fallback/diagnóstico
#else
constexpr float AMIX_HEADING_CORRECT_SIGN = -1.0f;  // ✅ CORRECTO (banco Virginia 2026-06-21)
#endif

// ============================================================
// ANTICIPACIÓN (S2) — moverse por el SIGNO de la velocidad de la pelota (banco Virginia 2026-06-22).
// ----------------------------------------------------------------------------------
// PROBLEMA: con la pelota CENTRADA (|áng|≤8°) pero viniendo hacia un lado, el arquero esperaba QUIETO hasta
// que el ÁNGULO cruzaba la banda muerta → reaccionaba 1-2 frames tarde y pasaba por al lado. S2: si la pelota
// se ACERCA con componente LATERAL, arranca el strafe hacia el lado del SIGNO de vx ANTES de que cruce la
// banda. Usa SÓLO el SIGNO (la MAGNITUD de vx/vy NO está calibrada). Gateado por -DARQMIX_ANTICIPA (env
// central_robot2_arqueromix_quieto_anticipa). Default OFF → el candidato de competencia es byte-idéntico.
// ⚠️ Los SIGNOS (qué vx es "derecha", qué vy es "acercándose") NO están validados → flags de inversión.
#ifdef ARQMIX_ANTICIPA
constexpr bool AMIX_ANTICIPA = true;
#else
constexpr bool AMIX_ANTICIPA = false;
#endif
// SIGNO de vx para el LADO: si el arquero anticipa para el lado CONTRARIO → -DARQMIX_FLIP_BALL_VX.
#ifdef ARQMIX_FLIP_BALL_VX
constexpr float AMIX_BALL_VX_SIGN = -1.0f;
#else
constexpr float AMIX_BALL_VX_SIGN = +1.0f;
#endif
// SIGNO de vy para "ACERCÁNDOSE": si anticipa cuando la pelota se ALEJA (al revés) → -DARQMIX_FLIP_BALL_VY.
#ifdef ARQMIX_FLIP_BALL_VY
constexpr float AMIX_BALL_VY_SIGN = -1.0f;
#else
constexpr float AMIX_BALL_VY_SIGN = +1.0f;
#endif
// Umbrales (UNIDADES CRUDAS del snapshot, SIN calibrar) — TITULAR EN BANCO. Evitan reaccionar al ruido de la
// velocidad: subir si anticipa con la pelota casi quieta (falsos positivos); bajar si no reacciona a tiempo.
constexpr float AMIX_ANTICIPA_VX_MIN = 50.0f;  // componente LATERAL mínima para anticipar (|vx| > esto)
constexpr float AMIX_ANTICIPA_VY_MIN = 50.0f;  // componente de ACERCAMIENTO mínima (vy·signo > esto)

#ifdef ARQMIX_EMPUJE_TRASERA
// ============================================================
// EMPUJE CON LA CÁMARA TRASERA (pedido 2026-10-03, gateado -DARQMIX_EMPUJE_TRASERA).
// ----------------------------------------------------------------------------------
// Si la pelota está ATRÁS del arquero (la vio la cámara TRASERA) y el TOP NO ve el arco PROPIO, el arquero
// RETROCEDE empujándola con la cola HASTA DETECTAR LA LÍNEA; después reusa la salida del homing
// (inicio_avanzar → acomodar → esperar). Hoy, con la pelota atrás, sólo se desliza de costado.
// "La vio la trasera" se deduce del ÁNGULO: la CENTRAL no recibe qué cámara la vio, pero las dos cámaras
// miran a lados opuestos → |áng| > 90° sólo puede venir de la trasera. Para que esto sea confiable el TOP
// tiene que darle PRIORIDAD a la delantera (env top_robot2_pri_frontprio): si no, cuando ambas ven
// "pelota" el TOP promedia y el ángulo resultante no dice de qué cámara vino.
// Por qué "sin arco propio": si la trasera VE el arco propio, empujar hacia atrás es empujar hacia el
// arco propio → ahí NO empuja (queda la conducta de hoy: strafe lateral).
// ⚠️ NO validado en banco. Perillas <TITRAR EN BANCO>:
constexpr float         AMIX_EMPUJE_ANG_MIN_DEG = 90.0f;   // |áng pelota| > esto = pelota ATRÁS (de la trasera)
constexpr unsigned long AMIX_T_EMPUJE_SAFETY    = 3000;    // ms: tope si NUNCA ve la línea (no empujar a ciegas para siempre)
constexpr unsigned long AMIX_T_EMPUJE_COOLDOWN  = 2000;    // ms tras terminar un empuje sin poder re-dispararlo:
                                                           // al salir de la línea la pelota queda atrás otra vez →
                                                           // sin esto entraría en loop línea↔adelante. Bajar si tarda
                                                           // en reaccionar a una pelota nueva atrás; subir si "bombea".
#endif

}  // namespace arqmix
}  // namespace iitasoccer
