IITA-Proyectos/open-soccer-robocup-team2026/software/teensy/Soccer 2026/src/shared/pids.cpp

#include "pids.h"

namespace iitasoccer {

// ============================================================================
// Utility
// ============================================================================

float wrap_diff_deg(float a, float b) {
    float d = a - b;
    while (d > 180.0f) d -= 360.0f;
    while (d < -180.0f) d += 360.0f;
    return d;
}

namespace {
    float clamp(float v, float lo, float hi) {
        if (v < lo) return lo;
        if (v > hi) return hi;
        return v;
    }
}

// Convierte grados/s -> centideg/s saturando al rango int16 [-32767, +32767].
// Redondea al entero más cercano y NUNCA cambia de signo (sin overflow/wrap).
//
// Author: Claude Opus 4.8 (Anthropic). Requested-by: Viollaz.
int16_t omega_degps_to_centideg(float omega_deg_s) {
    // Guarda defensiva (SC-01, eval 2026-06-04): un heading corrupto del BNO
    // puede llegar como NaN. Las comparaciones con NaN son TODAS false, así que
    // sin esta guarda el NaN se saltearía los clamps de abajo y `(int16_t)NaN`
    // sería comportamiento indefinido (basura directa al motor). NaN != NaN.
    // ω no-finito ⇒ 0 (sin giro). ±Inf ya satura bien vía los clamps de abajo.
    // Complementa el failover del BNO muerto (IMU-1).
    if (!(omega_deg_s == omega_deg_s)) return 0;
    float centideg = omega_deg_s * 100.0f;
    // Redondeo al entero más cercano conservando el signo.
    centideg = (centideg >= 0.0f) ? (centideg + 0.5f) : (centideg - 0.5f);
    if (centideg > 32767.0f)  return 32767;
    if (centideg < -32767.0f) return -32767;
    return (int16_t)centideg;
}

// ============================================================================
// Heading PID
// ============================================================================

void heading_pid_reset(HeadingPID& pid) {
    pid.integral = 0.0f;
    pid.prev_error = 0.0f;
    pid.primed = false;
}

void heading_pid_set_target(HeadingPID& pid, float target_deg) {
    pid.setpoint_deg = target_deg;
}

float heading_pid_tick(HeadingPID& pid, float current_heading_deg, uint32_t now_ms) {
    // Error con wrap-around.
    float error = wrap_diff_deg(pid.setpoint_deg, current_heading_deg);

    // dt — usar fallback de 10 ms (100 Hz típico) si no hay tick previo.
    float dt = 0.01f;
    if (pid.primed) {
        const uint32_t elapsed = now_ms - pid.last_tick_ms;
        dt = elapsed / 1000.0f;
        if (dt < 0.001f) dt = 0.001f;  // mínimo 1 ms (evitar div by 0)
        if (dt > 0.1f)   dt = 0.1f;    // máximo 100 ms (clamp ante hang)
    }
    pid.last_tick_ms = now_ms;

    // Anti-windup real (conditional integration): acumular tentativamente, pero
    // si el output (pre-clamp) ya está saturado Y el error empuja en la MISMA
    // dirección de la saturación, NO acumulamos este tick (revertimos la suma).
    // Esto evita el windup que producía overshoot al volver al setpoint.
    // El comportamiento NO saturado queda idéntico al clamp simple anterior.
    //
    // Author: Claude Opus 4.8 (Anthropic). Requested-by: Viollaz.
    const float integral_before = pid.integral;
    pid.integral += error * dt;
    pid.integral = clamp(pid.integral, -pid.integral_clamp, +pid.integral_clamp);

    // Derivada (solo si ya tenemos prev_error válido).
    float derivative = 0.0f;
    if (pid.primed) {
        derivative = (error - pid.prev_error) / dt;
    }
    pid.prev_error = error;
    pid.primed = true;

    // Output tentativo (pre-clamp) para decidir conditional integration.
    float output = pid.kp * error + pid.ki * pid.integral + pid.kd * derivative;
    const bool saturated = (output >= pid.output_clamp) || (output <= -pid.output_clamp);
    const bool same_dir = (output > 0.0f && error > 0.0f) || (output < 0.0f && error < 0.0f);
    if (saturated && same_dir) {
        // Revertir la acumulación de este tick y recomputar el output sin ella.
        pid.integral = integral_before;
        output = pid.kp * error + pid.ki * pid.integral + pid.kd * derivative;
    }

    output = clamp(output, -pid.output_clamp, +pid.output_clamp);
    return output;
}

// ============================================================================
// Lateral PID
// ============================================================================

void lateral_pid_reset(LateralPID& pid) {
    pid.integral = 0.0f;
    pid.prev_error = 0.0f;
    pid.primed = false;
}

void lateral_pid_set_target(LateralPID& pid, float target) {
    pid.setpoint = target;
}

float lateral_pid_tick(LateralPID& pid, float measurement, uint32_t now_ms) {
    float error = pid.setpoint - measurement;

    float dt = 0.01f;
    if (pid.primed) {
        const uint32_t elapsed = now_ms - pid.last_tick_ms;
        dt = elapsed / 1000.0f;
        if (dt < 0.001f) dt = 0.001f;
        if (dt > 0.1f)   dt = 0.1f;
    }
    pid.last_tick_ms = now_ms;

    // Anti-windup real (conditional integration) — ver heading_pid_tick.
    // Author: Claude Opus 4.8 (Anthropic). Requested-by: Viollaz.
    const float integral_before = pid.integral;
    pid.integral += error * dt;
    pid.integral = clamp(pid.integral, -pid.integral_clamp, +pid.integral_clamp);

    float derivative = 0.0f;
    if (pid.primed) {
        derivative = (error - pid.prev_error) / dt;
    }
    pid.prev_error = error;
    pid.primed = true;

    float output = pid.kp * error + pid.ki * pid.integral + pid.kd * derivative;
    const bool saturated = (output >= pid.output_clamp) || (output <= -pid.output_clamp);
    const bool same_dir = (output > 0.0f && error > 0.0f) || (output < 0.0f && error < 0.0f);
    if (saturated && same_dir) {
        pid.integral = integral_before;
        output = pid.kp * error + pid.ki * pid.integral + pid.kd * derivative;
    }

    output = clamp(output, -pid.output_clamp, +pid.output_clamp);
    return output;
}

// ============================================================================
// Approach velocity profile
// ============================================================================

float approach_velocity(float distance_mm,
                         float close_threshold_mm,
                         float far_threshold_mm,
                         float max_speed_mm_s,
                         float min_speed_mm_s) {
    if (distance_mm < close_threshold_mm) return 0.0f;
    if (distance_mm >= far_threshold_mm) return max_speed_mm_s;
    // Interpolación lineal entre close y far.
    float range = far_threshold_mm - close_threshold_mm;
    if (range <= 0.0f) return max_speed_mm_s;
    float t = (distance_mm - close_threshold_mm) / range;  // 0..1
    return min_speed_mm_s + t * (max_speed_mm_s - min_speed_mm_s);
}

}  // namespace iitasoccer
