IITA-Proyectos/open-soccer-robocup-team2026/r-d-2027/code/esp32-bridge-firmware/src/main.cpp

// ESP32 Telemetry Bridge v0 — UART ↔ WiFi (UDP).
//
// Lee líneas (JSON Lines) por UART desde el Teensy y las reenvía por UDP al
// laptop. Recibe comandos por UDP del laptop y los reenvía por UART al Teensy.
// Stub opcional de ESP-NOW para inter-robot (apagado por default).
//
// Diseño:
//   - Loop cooperativo, no bloqueante (delay máximo 1 ms).
//   - Buffer software de UART para no perder bursts del Teensy.
//   - Reconexión automática a WiFi si se cae.
//   - LED de diagnóstico (apagado/lento/rápido/fijo según estado).
//
// Ver r-d-2027/specs/esp32-telemetry-bridge-v0-spec.md para la descripción
// completa.

#include <Arduino.h>
#include <WiFi.h>
#include <WiFiUdp.h>
#include "config.h"

#if ESPNOW_ENABLE
  #include <esp_now.h>
  #include <esp_wifi.h>
#endif

#if OTA_ENABLE
  #include <ArduinoOTA.h>
#endif

// ─────────────────────────────────────────────────────────────────────────────
// Estado global
// ─────────────────────────────────────────────────────────────────────────────
static WiFiUDP g_udp_out;     // socket que envía al laptop
static WiFiUDP g_udp_in;      // socket que escucha comandos del laptop
static IPAddress g_target_ip; // resuelve UDP_OUT_TARGET → IP al boot

static HardwareSerial& g_uart = Serial1;  // alias claro

// UART RX state machine (acumula caracteres hasta '\n').
static char     g_rx_line[UART_BUF_SIZE];
static size_t   g_rx_len = 0;

// UDP IN state machine (idem para comandos del laptop).
static char     g_cmd_line[UART_BUF_SIZE];

// Stats
struct Stats {
    uint32_t uart_lines_in   = 0;
    uint32_t udp_out_packets = 0;
    uint32_t udp_in_packets  = 0;
    uint32_t uart_lines_out  = 0;
    uint32_t udp_in_dropped  = 0;   // por filtro o por sobre-largo
    uint32_t wifi_reconnects = 0;
};
static Stats g_stats;
static uint32_t g_last_stats_print_ms = 0;
static uint32_t g_last_traffic_ms = 0;

// ─────────────────────────────────────────────────────────────────────────────
// LED helpers
// ─────────────────────────────────────────────────────────────────────────────
static inline void led_set(bool on) {
    if (LED_ACTIVE_LOW) digitalWrite(LED_PIN, on ? LOW : HIGH);
    else                digitalWrite(LED_PIN, on ? HIGH : LOW);
}

static void led_tick(uint32_t now) {
    // Patrones:
    //   sin WiFi:         apagado
    //   WiFi sin tráfico: parpadeo lento (1 Hz)
    //   tráfico reciente: parpadeo rápido (5 Hz)
    if (WiFi.status() != WL_CONNECTED) { led_set(false); return; }

    const uint32_t since_traffic = now - g_last_traffic_ms;
    if (since_traffic < 500) {
        // 5 Hz: 100 ms on / 100 ms off
        led_set(((now / 100) % 2) == 0);
    } else {
        // 1 Hz: 500 ms on / 500 ms off
        led_set(((now / 500) % 2) == 0);
    }
}
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
