IITA-Proyectos/open-soccer-robocup-team2026/(commit log)

2026-02-21 docs: complete timeline, code review analysis, and additional research topics
    - Detailed week-by-week timeline Feb-Jun 2026 with checkboxes
    - Comprehensive code review of 2025 season (moved to research/completed)
    - Found 6 critical bugs in legacy code documented
    - Added research topics: game strategy, UART protocol improvements
    Author: Claude (Anthropic - Claude Opus 4.6)
    Requested-by: Gustavo Viollaz (@gviollaz)
2026-02-21 feat: sync all updates - team data, rules 2026 analysis, code review, references, timeline
    Syncing IITA-Proyectos repo with all work done today:
    - README: team members, national champions badge, 2026 rules links
    - Rules 2026 analysis COMPLETE: ball-capture zone 1.5cm (was 3.0), comm module mandatory
    - Code review 2025 COMPLETE: 8 bugs found, architecture documented
    - Timeline with real dates: RoboCup 2026 Incheon Jun 30 - Jul 6
    - References: ducc team, TDPs 2025, communication module, Webots sim
    - Backlog: comm module, docs preparation, travel funding, mechanical/vision/electronics
    - Journal: comprehensive kickoff entry
    Requested-by: Gustavo Viol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
2026-02-21 research: complete system architecture analysis — 23 deficiencies, 12 recommendations
    Forensic analysis of all 2025 source code covering:
    - Teensy programs (forward robot, goalkeeper, control)
    - OpenMV vision programs (ball detection, goal detection, UART protocol)
    - Sensor inventory (line sensors, BNO055 gyro, HC-SR04, 8x IR, buttons)
    - Communication protocol (6 bugs identified)
    - Pin conflict map
    - zirconLib library analysis
    - Dribbler integration status
    - Comparison with reference teams (ducc Singapore)
    Findings: 6 critical, 8 high, 9 medium severity issues
    Top 3 priorities: enable gyroscope, redesign UART protocol, verify 1.5cm ball-capture zone
    Author: Claude (Anthropic - Claude Opu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
2026-02-21 research(arquitectura): análisis completo del sistema 2025 — versión final
    Actualización del documento de arquitectura con análisis exhaustivo:
    - 23 puntos de falla documentados (6 críticos, 8 altos, 9 moderados)
    - Tablas completas de pinout Zircon Mark1 vs Naveen1
    - Análisis línea por línea del protocolo UART (3 versiones incompatibles)
    - Inventario de código no migrado del repo 2025
    - Arquitectura de software propuesta para 2026
    - Inventario completo de sensores con estado de uso
    - Mapa de conflictos de pines
    - Recomendaciones priorizadas Feb→Jun 2026
    Reemplaza versión anterior (15KB) con versión completa (28KB).
    Elimina resumen redundante, reemplazado por índice con enlac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
2026-02-21 research(repo): análisis del repositorio — estado, riesgos y plan de acción
    Informe de análisis del repo 2026 cubriendo:
    - Estado actual de la estructura del repositorio
    - Implicancias de reglas 2026 en hardware y software
    - Síntesis del forense 2025 y problemas recurrentes
    - Riesgos principales sin cambios estructurales
    - Plan de acción pragmático "estabilidad primero" (6 pasos)
    - Entregables recomendados (protocol.md, testing, checklist)
    Author: ChatGPT-5.2 Pro (OpenAI)
    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
2026-02-21 research(analisis-cruzado): verificación de hipótesis Claude vs ChatGPT contra código real
    Análisis cruzado que verifica cada hipótesis de ambos análisis contra el
    código fuente real de los repositorios 2025 y 2026:
    - 19 hipótesis confirmadas (73%)
    - 3 parcialmente confirmadas (12%)
    - 1 refutada (colisión header/dato UART - protocolo diseñado correctamente)
    - 3 hallazgos nuevos: conflicto pin RX1 en Naveen1, código migrado
    incompleto (stubs), código de competencia real ausente del repo
    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
2026-03-20 docs: normalizar repo según estándar ICRS
    Referencia: https://github.com/IITA-Proyectos/iita-competition-playbook
    Agregados según ICRS v1.1:
    - LICENSE (MIT)
    - CHANGELOG.md
    - REFERENCE.md (links a playbook, policies, repos hermanos, hardware)
    - .github/ISSUE_TEMPLATE/ (6 forms: bug, feature, hardware-bug,
    research-task, test-protocol, documentation)
    - .github/ISSUE_TEMPLATE/config.yml (link al playbook ICRS)
    - .github/workflows/translate-docs.yml (auto-traducción ES->EN)
    - scripts/translate_docs.py (adaptado de rcj-2026-rescue-line)
    Subsistemas adaptados para Soccer Open (arquero/delantero,
    openmv/vision, zirconlib, comunicacion-uart, etc.)
    Author: Claude (Anthropic - Claude Opus 4.6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
2026-03-20 test: verificar workflow de traducción automática ES->EN
    Archivo de prueba para confirmar que OPENAI_API_KEY y el workflow
    translate-docs.yml funcionan correctamente.
    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
2026-03-20 docs(internal): análisis completo del programa definitivo del delantero
    Análisis de ~900 líneas de código incluyendo:
    - 5 bugs críticos (UART sin sync, rampa de pateo, giróscopo no usado en avance, conflicto zirconLib, headers)
    - 7 problemas de confiabilidad
    - Análisis de legibilidad y estilo (código duplicado masivamente)
    - 5 oportunidades de mejora de desempeño
    - Propuesta de refactoring modular
    - Análisis del programa de visión OpenMV
    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
2026-03-20 docs(internal): análisis completo del programa definitivo del arquero
    Análisis de ~900 líneas incluyendo:
    - 6 bugs críticos (currentYaw raw, gap Yp 3-5, UART, s3 faltante, timeout, zirconLib)
    - 6 problemas de confiabilidad
    - Comparativa detallada arquero vs delantero
    - 7 bugs compartidos a resolver en módulo común
    - Propuesta de estructura unificada para 2026
    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
2026-03-20 docs(internal): análisis técnico completo del giróscopo BNO055
    Investigación a fondo del BNO055 para RoboCup Junior Soccer:
    - Comparativa NDOF vs IMUPLUS (recomendación: usar IMUPLUS por interferencia de motores)
    - 6 problemas identificados en la inicialización actual
    - Procedimiento de inicialización completo propuesto
    - Manejo de drift y recalibración por visión
    - Guardado de offsets en EEPROM (técnica BohleBots)
    - Secuencia de encendido para competencia
    - Referencias externas: datasheets, BohleBots library, foros técnicos
    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
2026-03-20 staging: preparar tests BNO055 para viernes 28/3
    Archivos para probar:
    1. test-bno055-imuplus.ino — test standalone del sensor en IMUPLUS
    2. cambios-bno055-init.md — parches exactos para delantero y arquero
    3. evaluar-bohlebots-bno055.md — evaluación de librería alternativa
    4. README.md actualizado con instrucciones completas de prueba
    Cambios clave:
    - bno.begin() → bno.begin(IMUPLUS) = desactivar magnetómetro
    - Espera de estabilización 1000ms + calibración gyro
    - Promedio de 10 lecturas para heading inicial
    - Timeout en vez de while(1) si BNO055 falla
    - Fix currentYaw→error en arquero
    Ref: docs/internal/giroscopo-bno055-analisis-tecnico.md
    Author: Claude (Anthropic - Claud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
2026-03-20 staging: fix UART sincronización + fix rampa de pateo
    Fix UART (ambos robots + OpenMV):
    - while-peek para descartar bytes basura hasta encontrar header 201
    - Validación de los 3 headers (201+202+203) antes de decodificar
    - Clampeo de coordenadas a 1-200 en OpenMV para evitar colisión con headers
    - Quitar print() que reduce FPS
    Fix rampa de pateo (solo delantero):
    - velocidadActualPateo = 0 antes de entrar a PATEANDO_adelante
    - velocidadActualPateo = 0 antes de entrar a PATEANDO_corto_adelante
    - La rampa de aceleración ahora funciona en CADA patada, no solo la primera
    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
2026-03-20 staging: actualizar README con fix UART y fix rampa de pateo
    Reorganizado en prioridades claras:
    1. Test standalone BNO055
    2. Delantero con TODOS los fixes (gyro + UART + rampa)
    3. OpenMV con clampeo de coordenadas
    4. Arquero con TODOS los fixes (gyro + currentYaw + UART)
    5. (Opcional) BohleBots
    Incluye tabla de documentos de referencia y reglas de prueba.
    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
2026-03-20 docs + staging: cinemática omnidireccional y test de primitivas de movimiento
    docs/internal/cinematica-omnidireccional-movimientos.md:
    - Geometría de ruedas verificada desde código (M1@30°, M2@150°, M3@270°)
    - Modelo cinemático inverso con fórmulas
    - Control PD de heading con giróscopo
    - Función moverRobot(velocidad, dirección, headingObjetivo)
    - Saturación proporcional de motores
    - Problemas y limitaciones sin encoders
    - Referencias académicas (Ribeiro, Rojas FU Berlin, Gregwar, Oliveira)
    staging/shared/test-movimiento-omnidireccional.ino:
    - Programa de test con 9 movimientos secuenciales
    - Botón para avanzar entre tests (3 seg cada uno)
    - Tests: quieto, avanzar, retroceder,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
2026-03-20 staging: agregar test de movimiento omnidireccional con PD heading
    Test interactivo con 9 movimientos secuenciales:
    avanzar, retroceder, lateral, diagonal, girar, orbitar.
    Constantes calibrables: Kp, Kd, L_ROTACION, signos de motor.
    Orden actualizado: BNO055 → movimiento omni → fixes → OpenMV → arquero
    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
2026-03-27 feat(test): implementar cinemática omnidireccional 3 ruedas 120°
    CINEMÁTICA CORRECTA:
    - Fórmula: V_rueda = -sin(θ) * Vx para movimiento lateral
    - Los 3 motores trabajan simultáneamente con diferentes potencias
    - Factores normalizados para que el máximo sea velocidad base
    CONFIGURACIONES PREDEFINIDAS (seleccionar por Serial):
    - 'a' = 30°, 150°, 270° (frontal-der, frontal-izq, trasera)
    - 'b' = 90°, 210°, 330° (frontal, trasera-izq, trasera-der)
    - 'c' = 0°, 120°, 240° (derecha, atrás-izq, atrás-der)
    Para movimiento DERECHA con config A (30°,150°,270°):
    - M1: -0.5 (hacia atrás)
    - M2: -0.5 (hacia atrás)
    - M3: +1.0 (hacia adelante)
2026-03-27 feat(test): programa de ajuste MANUAL de velocidades para movimiento lateral
    - Control individual de velocidad por motor (q/a, w/s, e/f = +10/-10)
    - Invertir dirección de cualquier motor (z, x, c)
    - Modos: 'd'=derecha, 'i'=izquierda, 'l'=loop, 'p'=parar
    - Reset a valores por defecto con '0'
    - Muestra configuración actual para copiar una vez encontrado el balance
    OBJETIVO: Ajustar velocidades hasta que el robot vaya RECTO lateralmente
    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
2026-03-27 fix(test): corregir cinemática - M1 y M2 deben girar en direcciones opuestas
    CINEMÁTICA CORRECTA para movimiento lateral:
    - M1 (frontal): adelante (+1)
    - M2 (frontal): atrás (-1) ← OPUESTO a M1
    - M3 (trasero): lateral (+1)
    Los motores delanteros giran en direcciones opuestas entre sí
    para generar el empuje lateral sin rotación.
2026-03-27 feat(test): agregar giróscopo BNO055 y PID al test lateral
    - Giróscopo BNO055 para leer orientación
    - Control PID para corregir desviaciones (Kp=3.0, Ki=0.05, Kd=0.5)
    - La corrección se aplica a M1 y M2 (motores frontales)
    - Reset del PID al cambiar de dirección
    - Muestra heading y corrección en Serial Monitor
    CINEMÁTICA OMNIDIRECCIONAL (confirmada por María):
    - M1: adelante (+1) para ir a derecha
    - M2: atrás (-1) para ir a derecha ← OPUESTO a M1
    - M3: lateral (+1) para ir a derecha
    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
2026-03-27 fix(movimiento): corregir 3 bugs en PID lateral + documentar lecciones
    - Bug 1: PID se calculaba 2 veces por loop (corrompía derivada)
    - Bug 2: constrain(0,255) mataba rueda en vez de invertir dirección
    - Bug 3: M3 no participaba en corrección de heading
    - Agregado: saturación proporcional de los 3 motores
    - Agregado: signos de rotación como parámetros ajustables
    - Agregado: FACTOR_ROTACION para tunear peso del PID
    - Agregado: serial muestra velocidades individuales M1/M2/M3
    - Agregado: documento lecciones-pid-lateral para referencia de IAs
    Valores calibrados por María (VEL, DIR) se mantienen sin cambio.
    Requested-by: Gustavo Viollaz (@gv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
2026-03-28 feat(skills): create Soccer Open skills library — 5 soccer-specific skills
    Complete skills library adapted for RoboCupJunior Soccer Open 2026:
    skills/SKILL.md:
    - Master index with 5 soccer-specific skills
    - Cross-reference to shared library in robosport repo (33 skills)
    - Comparison table Soccer vs RoboSports
    - Team architecture: arquero + delantero + ESP32 comms
    skills/soccer-match-fsm.md:
    - Match state machine: kickoff, search, attack, defend, reposition
    - Different behaviors per role (goalkeeper vs striker)
    - Inter-robot communication struct (10Hz WiFi/BT)
    - Vision fusion from 2 robots
    - Anti-collision (goalkeeper has priority)
    - Referee communication module (2026 GPIO pin)
    skills/go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
2026-03-28 feat(skills/docs): add OmniDriveBase — high-level API for 3-wheel omni robot
    Complete omnidirectional movement system for RoboCupJunior Soccer:
    skills/omni3-drive-base.md:
    - OmniDriveBase C++ class: Pybricks DriveBase-style API for 3 omni wheels
    - Independent translation + rotation (field-centric with gyro)
    - Continuous commands: drive(speed, dir, heading), drive_field(vx, vy, heading)
    - Blocking commands: move(dir, distance), turn(heading), go_to(x, y, heading)
    - Full inverse kinematics for ANY wheel angle configuration
    - Odometry: encoder forward kinematics + gyro heading
    - Motor speed normalization (prevents saturation)
    - ToF position correction integration point
    - Complete usage examp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
2026-03-28 feat(docs/skills): add LiDAR vs ToF analysis for Soccer 2026
    CRITICAL FINDING: 2026 rules changed — LiDAR/ToF now ALLOWED in Soccer
    Vision (ex-Open) league. Restriction is only for Infrared league.
    docs/lidar-tof-slam-analysis.md:
    - Rule change analysis: 2025 (banned both) vs 2026 (banned IR-only)
    - RPLidar A1 vs 8×VL53L1X: specs, size, cost, precision comparison
    - Why full SLAM doesn't make sense (known map, simple env, moving obstacles)
    - What top teams actually use (PCBWay, RoBorregos, CAMBADA, Tech United)
    - Nobody in Junior Soccer has ever used LiDAR (opportunity or risk?)
    - Recommendation: VL53L1X for 2026, RPLidar for 2027+
    - Known-map localization algorithm (NOT SLAM): wall detec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
2026-03-28 feat(docs/skills): add multi-camera world model — vision fusion, occlusion, team comms
    Complete system for building a unified world model from multiple vision sources:
    docs/multi-camera-world-model.md:
    - Problem analysis: single camera (47° FOV) covers only 13% of field
    - Camera configurations: 1, 2, 4 cameras, and catadioptric mirror
    PCBWay team (3rd world 2022) uses 4 cameras for 360°
    - WorldModel data structure: all entities (me, ball, partner, goals, rivals)
    - Multi-camera fusion: resolve ambiguities when 2 cams see same ball
    (convert to field coordinates, cluster by proximity, weighted average)
    - Occlusion handling: Kalman predict when no camera sees ball,
    confidence decay hi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
2026-03-28 feat(skills): update striker with IITA behavior + add kickoff set plays
    striker-strategy.md — Updated with IITA actual behavior:
    - 4-state FSM: SEARCH → APPROACH → POSITION → PUSH
    - Search: roam field scanning with camera, use partner data if available
    - Approach: go toward ball, switch to position when close
    - Position: calculate behind-the-ball point opposite to rival goal,
    orbit if on wrong side (between ball and goal)
    - Push: drive into ball toward rival goal, fire kicker if equipped
    - Search pattern: rotate 120°, advance, rotate -120°, lateral move
    kickoff-set-plays.md — NEW skill: 5 prepared kickoff plays
    - Play A "Direct Shot": sprint and kick to goal (simplest, most re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
2026-05-10 arquitectura coach + firmware Zircon motor server + cinematica omni-3 + sistema de tareas
    A REVISAR POR ENZO. Generado por IA.
    Cambios principales:
    Marco coach + skills:
    - CLAUDE.md (raiz) con frame coach senior y estrategia multi-temporada.
    - .claude/skills/ con 8 skills: rcj-soccer-coach, vibe-mechanical-design,
    vibe-pcb-design, vibe-robotics-coding, rcj-judging-package,
    hardware-test-protocol, engineering-journal, openmv-vision-tuning.
    - docs/coach-system/2026-05-10-fase-0-setup-design.md (plan de 4 fases).
    Analisis y auditorias (research/in-progress/):
    - auditoria-striker-strategy.md (8 temas-a-analizar contra el codigo viejo
    del delantero, con risk-no-fix / risk-fix / tiempo /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
    [cameras.cpp, cameras.h, config_zircon.h, crc16.cpp, crc16.h, imu_zircon.cpp, imu_zircon.h, kinematics.cpp]
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2026-05-11 firmware DOWN (8 archivos) + TOP batch 1 (config + comm_down + motors + sensors_imu)
    Firmware DOWN (placa base, Teensy 4.0 slave de sensores) — completo:
    - src/down/config_down.h: pinout muxes (A/B/C, 4 ADC, INH), pinout OTOS,
    flags DOWN_NUM_MUXES_CONNECTED y DOWN_NUM_OTOS_CONNECTED para soportar
    placa actual 04-12 (1 mux + 1 OTOS) o placa fixeada (4 muxes + 2 OTOS).
    - src/down/line_ring.h+cpp: anillo de N sensores de luz con multiplexacion
    CD4051. Algoritmo de angulo de linea por weighted average de cosenos+senos
    sobre sensores que ven blanco. Calibracion separada para carpet y blanco.
    Polling 1 kHz desde el main loop.
    - src/down/otos.h+cpp: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
    [comm_down.cpp, comm_down.h, comm_top.cpp, comm_top.h, config_down.h, config_top.h, line_ring.cpp, line_ring.h]
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2026-05-11 analisis profundo arquitectura distribuida 3 placas + propuesta topologia
    Documento solicitado por Gustavo en chat 2026-05-11 (post imagen esquema
    de Enzo del issue #9). Analisis de:
    1. Esquema basico de Enzo (STAR centric) vs alternativas.
    2. Funcionalidades por placa (CENTRAL, TOP, DOWN) con carga estimada,
    responsabilidades primarias / secundarias / lo que NO debe hacer.
    3. Anlisis critico de los 3 pedidos de Gustavo:
    - PID lateral local del arquero en DOWN (3 opciones evaluadas,
    recomendado: DOWN sugiere vx al CENTRAL, CENTRAL aplica).
    - Detecccion fin del area chica (NO posible solo desde DOWN, requiere
    pose absoluta del TOP por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
2026-05-11 docs: arquitectura — todos los PIDs corren en CENTRAL, ABAJO entrega solo measurement
    Cambio de diseño solicitado por Gustavo (chat 2026-05-11):
    mover el PID lateral del arquero de ABAJO a CENTRAL. ABAJO queda como
    sensor puro que entrega measurement (ángulo línea + profundidad signed
    mm); CENTRAL calcula error = setpoint - measurement y aplica el PID.
    Justificación:
    - La latencia es idéntica. El cuello de botella es el UART
    (~700µs para 16 bytes a 230400 baud), no el cálculo PID (~1µs).
    Pasar 'error' o 'output_PID' por UART cuesta lo mismo.
    - ABAJO queda como sensor puro: sin estado de control (integral, error
    previo), sin modos, sin l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
2026-05-11 firmware refactor sub-batch 1: proto + types + DOWN bus emergencia
    Primer sub-batch del refactor hacia "STAR centric con bus de emergencia"
    (arquitectura aprobada por defecto en issue #9 comment, asumido SI).
    Cambios:
    shared/proto.h:
    - MsgTypes reorganizados por destino real (DOWN → ARRIBA: solo OTOS;
    DOWN → CENTRAL: LINE_URGENT bus emergencia; ARRIBA → CENTRAL:
    WORLD_SNAPSHOT nuevo). MsgType ID = 0x10 antes era DOWN_LINE_STATUS,
    ahora se llama LINE_URGENT (mismo wire format, distinto destino).
    - Renombrados: TOP_RESET_OTOS -> CENTRAL_RESET_OTOS,
    TOP_CALIB_LINE -> CENTRAL_CALIB_LINE.
    - Aliases retrocompatibles a nivel namespace para no ro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
    [comm_central.cpp, comm_central.h, comm_down.cpp, comm_top.cpp, main_down.cpp, proto.h, types.h]
2026-05-11 firmware refactor sub-batch 2: CENTRAL master (ex-Zircon ampliado) + TOP cerebro sensorial puro
    Refactor estructural completo del firmware hacia arquitectura "STAR
    centric con bus de emergencia" (issue #9, asumido SI). Compila las
    3 placas (top, central_robot1, central_robot2, down, test_native).
    Renombrados / movidos con git mv (preserva historia):
    - src/zircon/ -> src/central/
    - src/zircon/main_zircon.cpp -> src/central/main_central.cpp
    - src/zircon/config_zircon.h -> src/central/config_central.h
    - src/top/strategy.{h,cpp} -> src/central/strategy.{h,cpp}
    - src/top/world_model.{h,cpp} -> src/central/world_model.{h,cpp}
    Eliminados:
    - src/top/motors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
    [comm_central.cpp, comm_central.h, comm_down.cpp, comm_down.h, comm_top.cpp, comm_top.h, config_central.h, imu_zircon.cpp]
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2026-05-11 docs: FIRMWARE-PLACA-ARRIBA — especificacion funcional completa
    Documento de referencia integral del programa de la placa ARRIBA
    (cerebro sensorial, Teensy 4.0). Cubre TODO lo necesario para construir,
    probar y debuggear el firmware mas complejo del robot.
    Secciones (21 en total):
    1-2. Resumen + hardware (BNO055 x2, ToF VL53L7CX x4 multizona 8x8 SPAD,
    2 camaras OpenMV, HC-SR04, placa COMM ESP32-C6).
    3. Responsabilidades funcionales R1-R20.
    4. Modos de operacion (BOOT, NORMAL, DEGRADED_*, LOST). ARRIBA no
    conoce rol del robot — siempre reporta lo mismo.
    5. Procesamiento IMU dual:
    - Modo IMUPLUS (evita interferencia magnetica de mo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
2026-05-11 fix: test_line_filters usa nuevo campo candidate_active en LiftedDetector
    Sin este fix los tests no compilan — referencia a candidate_since_ms
    que ya no existe en el struct (renombrado en commit 1ac52e0 por el
    bug fix del lifted detector con now_ms=0).
    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
2026-05-15 firmware COMM: procedure de flash descubierto + TASK-010 cerrada + TASK-011 nueva
    A REVISAR POR EQUIPO. Generado por IA.
    Sesion de coach (2026-05-15) investigando por que el equipo no podia cargar el
    firmware oficial RCJ al ESP32-C6-MINI-1 de la placa COMM custom (la que
    construyeron siguiendo los gerbers del repo oficial RCJ).
    Diagnostico cerrado:
    1. El firmware oficial RCJ YA es nativo ESP32-C6 desde 2024-03-29 (confirmado en
    thread del foro RCJ documentation-communication-module/3269 mensaje #5 +
    estructura del repo verificada hoy). NO requiere portar. TASK-010 cerrada.
    2. El boton CONNECT de la placa NO es RESET fisico - va a GPIO10 y el firmware
    lo lee como disconnect-button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
2026-05-17 docs+firmware: sync spec FSM Nivel 2, mapa flujo datos, fix bug OTOS velocity
    Avance en los 3 frentes que Gustavo pidio ("hacer los tres"), priorizados
    por lo que se puede cerrar responsablemente sin red/hardware.
    #2 DOCUMENTACION (cerrado 100%):
    docs/firmware/FIRMWARE-PLACA-CENTRAL.md §8:
    - Sincronizada con la FSM Nivel 2 REAL (commit b10c66d). Antes la spec
    describia SEARCH->APPROACH->POSITION->PUSH_KICK por distancia; el codigo
    hace SEARCH->(POSITION|APPROACH) por ANGULO, KICKOFF implementado,
    kicker dentro de APPROACH, LINE_AVOID como estado, GK_CLEAR con
    histeresis 250/400.
    - Bloque "Estado de implementacion" con tabla Nivel 1/2/3.
    - §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
    [otos.cpp]
2026-05-17 docs(comm): analisis 3 placas + correccion firmware COMM a branch esp32-c6
    Analisis exhaustivo del paquete de fab 2026-04-20 (Base/Comm/Tope).
    ESP32 de la placa COMM confirmado: ESP32-C6-MINI-1-N4 (BOM + netlist).
    Pinout de la COMM recuperado exacto del FlyingProbeTesting.json y
    cruzado con el conector 6P de la placa TOP.
    Correccion P0: el firmware correcto NO es master (compila para C5) sino
    el branch esp32-c6 (commit ffb4e3c), core Arduino-ESP32 3.2.2, pin map
    C6 distinto, BLE RCJs-m_<MAC>. Doc previa (journal 2026-05-15, TASK-006,
    TASK-010) corregida sin borrar (banners + notas fechadas).
    Nuevos docs en hardware/electronics/: componentes+circuito+pinout COMM,
    procedimiento de flash con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
2026-05-18 docs(decision): analisis profundo comunicaciones entre placas + diseno objetivo
    Analisis anclado en codigo real (proto.h, comm_*.cpp, cameras*, config_*).
    proto.h solido/testeado; heartbeat NO explicito; camaras unico enlace sin CRC
    (P0); fail-safe de borde se pierde en silencio si cae DOWN->CENTRAL (P0); SEQ
    no verificado; sin observabilidad; bug frescura boot TOP; ventanas 500ms=50x
    periodo; 5 comm_*.cpp casi iguales; config_central obsoleta (C1). Diseno
    objetivo: proto.h unico, heartbeat explicito + maquina OK/STALE/LOST, acciones
    seguras por LOST, SEQ verificado, buffer limpio, modulo Link unico.
    Requested-by: Gustavo Viollaz (@gviollaz)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
2026-05-18 docs(verificacion): validacion adversarial independiente del protocolo de comms
    2 revisores independientes sobre la propuesta. Diagnostico correcto pero plan
    de accion NO ejecutable como esta. Criticos: bajar fail-safe a 150ms es
    peligroso con loop bloqueante (pulseIn 25ms + I2C) -> RX overflow ~23ms y
    paradas espurias; Serial.clear() agrega fallo nuevo; falta histeresis
    (flapping); "quedarse con el ultimo" pierde imminent_exit y comandos one-shot;
    SEQ da falsos packet-loss tras resync; sin static_assert(sizeof) (23!=24B).
    Orden corregido: PRIMERO loop no-bloqueante + medir periodo real; despues
    ventanas. Banner de advertencia en la propuesta. Acertado: proto.h base, P0
    camara-sin-CRC, P0 bo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
2026-05-18 docs(comms): TASK-014..020 + diseno definitivo robusto/confiable/fail-safe
    7 tareas con plan de prueba corregido (stall + EMI + medicion de loop):
    TASK-014 P0 loop no-bloqueante+medicion (fundacional), 015 P0 CRC camara,
    016 P0 fail-safe borde (OR-latch+precedencia), 017 P1 heartbeat+histeresis+
    SEQ, 018 P1 cota drain sin Serial.clear, 019 P1 robustez arranque,
    020 P2 refactor Link+static_assert.
    Diseno definitivo: arquitectura en 6 capas (defensa en profundidad),
    fail-safe by default, taxonomia STREAM/EVENTO/COMANDO (corazon del arreglo),
    FSM de enlace con histeresis, reticula de precedencia de seguridad, umbrales
    derivados de medicion (no inventados). Indice de tareas actualizado.
    Author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
2026-05-18 docs(comms): Capa 6 recuperacion activa (escalera WDT/peer-reset/reset HW) + TASK-021
    Propuesta del equipo (reset por comando en sentido inverso) analizada y elevada
    a escalera de 3 niveles. Verificado en codigo: canales inversos TOP<->DOWN /
    CENTRAL<->DOWN ya existen; CENTRAL_RESET_TOP anticipado sin implementar; camara
    unidireccional; NO hay WDT de hardware en ninguna placa. El peer-reset falla en
    el peor caso (emisor colgado no lee RX) y no puede recuperar a CENTRAL: por eso
    Nivel 1 = WDT por MCU (primario), Nivel 2 = reset por comando, Nivel 3 = linea
    de reset HW, + convergencia anti-tormenta. Diseno definitivo seccion 5.bis;
    TASK-021 P1 con plan de prueba; indice actualizado.
    Author: C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
2026-05-18 docs(estado): evaluacion critica del firmware + TASK-022..024
    4 auditorias independientes sobre codigo real. Veredicto: NO hay 3 programas
    completos (3 esqueletos que compilan con agujeros P0) ni 2 de camara (1 script
    demo con sentinel roto + crash). Robot NO funciona aun; tests verdes = falsa
    seguridad (logica pura; FSM testeada es replica). P0: UARTs cruzados (inerte),
    sentinel camara (fantasma), OTOS/ToF stub, pose hardcodeada 0, escala camara
    sin calibrar, no arranca sin COMM, polaridad arco hardcodeada (autogol), rol
    nunca leido, build sin doc/CI/lib_deps. Camino critico ~2-3 semanas de banco.
    TASK-022 camara operativa, 023 build/tooling/CI, 024 arranque/rol/polaridad.
    Author: Claude (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
2026-05-18 fix(test): test_proto no compilaba — MsgType::DOWN_LINE_STATUS -> DOWN_LINE_STATUS
    DOWN_LINE_STATUS es un alias constexpr a nivel namespace (proto.h:72), no un
    miembro del enum MsgType. La suite test_proto NO compilaba (contradice
    "tests verdes" de la auditoria). Fix: usar el alias sin calificar (hay
    'using namespace iitasoccer'). Verificado: pio test -e test_native -f
    test_proto = 13/13 PASSED.
    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
2026-05-18 docs(contrato): contratos de datos CENTRAL, TOP y CAMARAS (diseño, gaps)
    Trabajo paralelo (no necesita toolchain). 3 contratos precisos, mismo patron
    que CONTRATO-DATOS-DOWN: que recibe/decide/emite cada uno, layout exacto,
    unidades, sentinelas, reglas de interpretacion, diseño de modulos
    (pura testeable vs HW-bound), gaps citados archivo:linea.
    - CENTRAL: master decisor (no motor-server); 15 gaps; safety lattice.
    - TOP: WorldSnapshot byte-a-byte (calc 23 B), pose hardcodeada 0, 19 gaps.
    - CAMARAS: bug sentinel (0,100) documentado, diseño 2 programas OpenMV.
    Pendiente reconciliar tamaño WorldSnapshot (TOP=23 vs comentario viejo=24)
    via static_assert en codigo (ya en gaps/plan).
    Author: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
2026-05-18 test(down): line_geometry — fix misleading-indentation + add centroide tests
    Fixes de code-review de Task 2: split del doble-while (sin -Wmisleading-
    indentation), 2 tests de centroide (right_side, two_sensor_symmetric),
    estilo de test alineado al repo. Verificado: test_down_geometry 6/6 PASSED.
    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
    [line_geometry.cpp]
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2026-05-18 test(down): line_calib — fix misleading-indentation + test clamp alpha>1
    [line_calib.cpp]
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2026-05-18 fix(build): agregar -I src/shared a envs down/top/central (infra pre-existente)
    Bug pre-existente: ningun binario de firmware compilaba — los .cpp de
    src/{down,top,central} hacen #include "types.h"/"line_filters.h" pero el env
    no tenia src/shared en el include path (solo test_native lo tenia). Agregado
    -I src/shared a env:down/top/central_robot1/central_robot2. Ahora shared +
    framework compilan; queda bloqueante aparte: config_down.h:50 (pines A0-A3 de
    mux, pinout "tentativo" pendiente confirmacion HW — TASK-009). Relac. TASK-023.
    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
2026-05-18 fix(down): config_down.h incluye <Arduino.h> (A0..A6 visibles) — DOWN compila
    Fix seguro NO-semantico: agrega #include <Arduino.h> para que las macros de
    pin A0..A3 (PIN_MUX_OUT) esten declaradas. NO cambia ningun numero de pin —
    la correccion de QUE pin es correcto sigue siendo TASK-009 (pinout tentativo,
    pendiente confirmacion HW). Con esto + el fix de include path, `pio run -e
    down` => SUCCESS (firmware.hex generado).
    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
    [config_down.h]
2026-05-18 fix(down): comm_central llena sample_age_ms real + resetea calib en recalibracion (P1 review)
    [comm_central.cpp]
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2026-05-19 feat(central): play_decision — circular/interceptar/desviar
    Recreado en main: el subagente habia commiteado en el worktree muerto
    claude/vibrant-kalam-237bfc por error de CWD. 5/5 PASSED en main.
    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
2026-05-19 fix(central): field_safety — no preemptar con escape invalido (imminent sin geometria)
    [field_safety.cpp]
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2026-05-19 infra: causa raiz Avast/SSL en PlatformIO (TASK-025) + complemento doc setup
    Re-aporte limpio tras reconciliar una divergencia git (mi sesion trabajo
    sobre base vieja; el equipo avanzo 39 commits en paralelo 17-18 may). El
    commit local 4c09e99 (TASK-013 Avast) colisionaba con el TASK-013 del
    equipo; se reseteo main local a origin/main (commit salvo en branch
    wip-avast-ssl-diagnostic, autorizado por Gustavo) y se re-aporta renumerado.
    Diagnostico (valor real, el equipo no lo tenia):
    - pio test fallaba con HTTPClientError. NO es falta de red (git/WebFetch
    andan toda la sesion). Causa raiz: Avast hace MITM/SSL-scanning
    (SSLKEYLOGFILE -> aswMonFltProx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
2026-05-19 docs(TASK-006): apuntar al clon local de _official_fw (no re-clonar)
    Nota corta al header: el repo oficial RCJ ya esta clonado en
    C:\Users\violl\iitasoccer\_official_fw\ con branch esp32-c6 y commit
    ffb4e3c correctos. Virginia/Elias no necesitan git clone — solo abrir
    Arduino IDE en RCj_comm_module.ino del clon local.
    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
2026-05-20 fix(build): Adafruit_BNO055::OPERATION_MODE_IMUPLUS -> OPERATION_MODE_IMUPLUS
    3 de 4 firmware (top, central_robot1, central_robot2) NO compilaban con
    la version actual de Adafruit_BNO055. La lib define OPERATION_MODE_IMUPLUS
    como enum global de typedef adafruit_bno055_opmode_t, NO como member
    estatico de la clase Adafruit_BNO055. El fix correcto es quitar el
    qualifier de clase.
    Verificado en .pio/libdeps/{central_robot1,central_robot2,top}/Adafruit BNO055/
    Adafruit_BNO055.h linea 70:
    typedef enum {
    ...
    OPERATION_MODE_IMUPLUS = 0X08,
    ...
    } adafruit_bno055_opmode_t;
    Y signatura de begin() linea 285:
    bool begin(adafruit_bno055_opmode_t mode = OPERATION_MODE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
    [imu_zircon.cpp, sensors_imu.cpp]
2026-05-20 journal(validacion): 4 firmware OK + 180/180 tests host PASSED
    Resultado del Plan C Nivel 2 (validation work bajo moratoria): preparar
    entorno para hardware-up.
    Builds (post fix IMU del commit e16e0f5):
    top SUCCESS 9.7s
    down SUCCESS 6.1s
    central_robot1 SUCCESS 7.9s
    central_robot2 SUCCESS 7.4s
    Tests host-native (16 suites, despues que Avast quedo excepcionado
    persistente):
    180 test cases: 180 succeeded in 00:01:01.451
    Primera ejecucion real de toda la suite host-native en esta sesion (hasta
    ahora "verificado por lectura cruzada" porque la excepcion Avast no era
    persistente). Cubre: kinematics, pids, line_filters, proto, cameras_fusion,
    behind_ball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
2026-05-22 journal: equipo replico los 53 tests de DOWN en su maquina (53/53 PASSED)
    Gustavo corrio `pio test -e test_native -f "test_down_*" -f test_line_filters`
    en su PowerShell — 53 test cases, 53 succeeded en 1:21. Primera ejecucion
    del proceso de testing por un integrante humano (no una sesion Claude).
    Confirma que el setup de testing funciona en la maquina del equipo:
    - 7 suites DOWN (calib/encode/geometry/model/surface/tracker + line_filters)
    todas verdes.
    - Primera suite 51s (baja Unity + compila), resto ~1s.
    - Con la excepcion Avast aplicada, PlatformIO baja Unity sin problema.
    Seccion "Replicado por el equipo humano" agregada al journal de validacion
    del 2026-05-19.
    Author: Claude Opu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
2026-05-22 fix(diag_down): compilar con 32 sensores (placa fixeada, 4 muxes)
    El default conservador (DOWN_NUM_MUXES_CONNECTED=1, placa 04-12) mostraba
    solo 8 sensores en el diag. La placa real del equipo es la FIXEADA con los
    4 muxes ruteados (32 sensores) — confirmado por Gustavo: "tenes que leer
    los 32 sensores no 8. Los 32 andan."
    Cambio: agregado -DDOWN_NUM_MUXES_CONNECTED=4 al build_flags del env
    diag_down. El env down (firmware de produccion) se deja con default conservador
    hasta decision del equipo de promover a =4 globalmente.
    Tambien dejado comentado -DDOWN_NUM_OTOS_CONNECTED=2 — descomentar cuando
    se confirme que los 2 OTOS estan soldados.
    Requested-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
2026-05-22 journal+TASK-026: diag DOWN fallo por config_down.h tentativo (no era hardware)
    Postmortem honesto del primer test de hardware con el diag_down (commit
    cc2829a + 33ce303). Conclusion: mi diagnostico anterior (16 sensores muertos,
    bug de mux S0=S4) era INCORRECTO. Enzo confirmo que los 32 sensores fisicos
    andan. La causa real: config_down.h tiene los pines del Teensy a los muxes
    CD4051 marcados literal como "tentativos / a confirmar" desde hace semanas,
    line_ring.cpp los usa sin verificar, y diag_down termino toggleando pines
    inventados — lecturas de pines al aire en vez de los muxes reales.
    Mismo patron de error que con Avast ("no hay red" sin verificar): asumi
    que un valor marcado como t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
    [diag_capture.py]
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2026-05-23 docs(down): aclarar conexiones de la placa DOWN (2 UARTs + 2 I2C) — destinos y direcciones
    El doc del pinout describia las conexiones de datos pero con errores y vaguedad:
    - Serial5 estaba marcado bien pero el formato de payload (LineStatusV2 vs los
    3 frames reales LINE_STATUS/OTOS_POSE/OTOS_VEL) estaba mal.
    - Serial1 estaba marcado como "uso a confirmar - debug? otra placa?". Real:
    va a CENTRAL como bus de emergencia (verificado en down/comm_central.{h,cpp}
    y central/comm_down.{h,cpp}, ambos vivos en el binario hoy).
    - Direccion I2C de los OTOS dicha pero sin explicar POR QUE necesitan dos buses
    separados (ambos 0x17 de fabrica, no seleccionable).
    - Nomenclatura I2C confusa ("I2C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
2026-05-24 docs(down): consolidar pack autocontenido para programar la placa DOWN
    Crea hardware/electronics/down-board-pack/ — un solo lugar con TODO lo
    necesario para que la IA (y humanos nuevos al equipo) puedan programar,
    testear y diagnosticar la placa DOWN sin saltar entre 8 directorios del
    repo. Snapshot curado del 2026-05-24, solo informacion vigente y correcta.
    Contenido del pack (47 archivos, 2.4 MB):
    README.md -> indice del pack + regla de oro +
    indice "pregunta -> doc" + lo que NO
    esta y por que
    01-pinout-y-posiciones.md -> copia del doc canonico del pinout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
    [BOM_Roboliga_2026_Futbol_2026-04-12.csv, PCB_PCB_Roboliga_2026_Futbol_2026-04-12.json, SCH_Roboliga_2026_Futbol_2026-04-12.json]
2026-05-24 docs(central): consolidar pack autocontenido para programar la placa CENTRAL
    Equivalente al down-board-pack pero para la placa CENTRAL (Zircon Rev v15
    + Teensy 4.1, cerebro motor del robot). 40 archivos, 362 KB. Snapshot
    curado del 2026-05-24, solo informacion vigente y correcta.
    Contenido del pack:
    README.md -> indice + regla de oro + indice
    "pregunta -> doc" + diferencias
    explicitas con el pack DOWN
    01-pinout-y-hardware.md -> NUEVO: curado de config_central.h +
    mapa-pines-teensy-ambos-robots.md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
    [behind_ball.cpp, behind_ball.h, comm_down.cpp, comm_down.h, comm_top.cpp, comm_top.h, config_central.h, imu_zircon.cpp]
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2026-05-24 fix(down): aplicar pinout schematic-validado a config_down.h + line_ring.cpp
    Hardware-up del anillo de linea de la placa DOWN (sesion 2026-05-24,
    Gustavo + Claude en ejecucion directa, batería conectada). El verdict del
    diag_capture pasa de 16 muertos a 0 muertos: los 32 sensores de luz fisicos
    responden ahora correctamente al firmware.
    Cambios firmware (los 2 bugs detectados durante el test en banco):
    - config_down.h:51 PIN_MUX_OUT[2,3]: { A2, A3 } -> { A8, A9 }.
    A2/A3 estaban en SCL2/SDA2 del OTOS U6; los pull-ups I2C llevaban
    el ADC a 1023 solido para los muxes U3+U4 (range=[1023-1023] exacto).
    Los pines reales de los ADCs U3+U4 segun schematic son A8/A9.
    - config_down.h: PIN_MU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
    [config_down.h, line_ring.cpp]
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2026-05-24 feat(down): OTOS validados cuantitativamente — 6.5% error sobre 300mm (TASK-029 + TASK-030 cerradas)
    Test cuantitativo final de tracking OTOS post-remocion de lamina
    protectora. Sobre carton corrugado con robot deslizado 300 mm reales:
    OTOS reporta desplazamiento neto de 280.4 mm = **6.5% de error**, bajo
    la tolerancia de 8% (25 mm) definida en TASK-029. Trayectoria
    monotonica sin saltos erraticos.
    Tareas cerradas:
    - **TASK-030 (sacar lamina protectora OTOS) → COMPLETED**.
    Gustavo sacó las 2 laminas en la misma sesion sin esperar la tapa
    de proteccion. Cuidado pendiente: cuando este la tapa, montarla para
    evitar dano físico a los lentes.
    - **TASK-029 (validar precisión OTOS)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
2026-05-24 feat(diag): skeleton diag_top_tof + env [env:diag_top_tof] compilable
    Sketch standalone para validar VL53L7CX frontal U2 de la placa TOP.
    Skeleton minimo (banner + LED heartbeat) que solo prueba que la lib
    vendoreada VL53L7CX se linkea OK con Teensy 4.0. Sigue patron de
    main_diag_down.cpp / [env:diag_down].
    Modos por define (mutuamente excluyentes con #error):
    - DIAG_TOF_MODE_SINGLE
    - DIAG_TOF_MODE_4X4 (default)
    - DIAG_TOF_MODE_8X8
    NO toca firmware TOP vivo (sensors_tof.cpp sigue siendo stub).
    Setup() / loop() reales se completan en commits siguientes.
    Compile gate: pio run -e diag_top_tof => SUCCESS en 7.96s
    (FLASH 25.6KB / RAM1 ~42KB en Teensy 4.0). LDF detecto la lib
    vendoreada sin pa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
    [diag_top_tof.cpp]
2026-05-24 feat(diag): implementar setup() del diag_top_tof — I2C scan + init sensor
    Banner completo + I2C scan en bus Wire ANTES de tocar la lib (asi se
    distingue "no responde I2C" vs "lib falla en init"). XSHUT pin 2 HIGH
    con #ifndef DIAG_TOF_SKIP_XSHUT (fallback documentado). Init de la lib
    con manejo de error que printea causas posibles. Configura resolucion
    segun MODE define y arranca ranging continuo @ 15 Hz.
    Errores de init imprimen diagnostico humano-leible y dejan g_init_ok
    en false; loop() (proximo commit) entra a patron LED de error.
    Nota sobre nombres de API: la lib STM32duino_VL53L7CX expone los
    metodos con prefix vl53l7cx_ (no plain set_resolution). Confirmado en
    lib/STM32duino_VL53L7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
    [diag_top_tof.cpp]
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2026-05-24 feat(diag): implementar loop() + formatters del diag_top_tof
    loop() polla vl53l7cx_check_data_ready, vl53l7cx_get_ranging_data
    y dispatchea al formatter segun MODE compilado:
    - MODE_SINGLE: mean de zonas validas + valid_count
    - MODE_4X4: grilla 4x4 ASCII de distancias en mm
    - MODE_8X8: grilla 8x8 ASCII
    print_cell maneja status 5/6/9 como validos, resto como "XXXX".
    Error pattern LED (3 blinks/s) si init fallo.
    Nota: la lib STM32duino expone check_data_ready y get_ranging_data
    con prefix vl53l7cx_ (verificado en vl53l7cx_class.h:261,271).
    distance_mm es int16_t en el struct (no uint16_t), pero la lib
    clampea negativos a 0 (vl53l7cx_api.cpp:776), asi que el cast
    unsigned en print_singl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
    [diag_top_tof.cpp]
2026-05-24 fix(diag): excluir diag_top_tof.cpp del filter de [env:diag_down]
    Task 4 del plan diag_top_tof agrego un segundo .cpp a src/diag/. El env
    [env:diag_down] usa build_src_filter = +<diag/> (loose) que ahora agarra
    ambos sketches y rompe el link con duplicate setup()/loop().
    Fix: agregar -<diag/diag_top_tof.cpp> al filter de diag_down, siguiendo
    el mismo patron ya usado para -<down/main_down.cpp> en esa misma linea.
    Comentario actualizado.
    Validado: pio run -e diag_down -> SUCCESS. [env:diag_top_tof] sigue OK.
    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
2026-05-25 fix(task): TASK-032 — corregir referencia I2C/Wire1 a Wire I2C0
    El VL53L7CX frontal (U2) esta en bus Wire (I2C0) pines SDA=18/SCL=19,
    NO en Wire1. El error de doc en linea 26 podia confundir al equipo en
    banco hacia el bus equivocado. Texto corregido a "Wire (I2C0 — pines
    SDA=18/SCL=19)". El codigo del sketch y el spec ya eran correctos.
    Detectado por final reviewer del set diag_top_tof.
    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
2026-05-25 fix(diag): diag_top_tof — re-dump diagnostico en error loop cada 2s
    Cuando el init del VL53L7CX falla, el loop() entraba al patron LED de
    error pero quedaba MUDO al Serial. Si el operador conecta el monitor
    DESPUES del setup() (caso comun por timing USB CDC del Teensy: si el
    host no esta listo en 3s, los bytes se descartan), nunca veia el
    motivo del fallo — solo el LED parpadeando.
    Fix: cuando g_init_ok = false, loop() re-imprime el diagnostico cada
    2 segundos (banner, I2C scan fresco, lista de causas comunes con
    remediacion). Garantiza que cualquier monitor que conecte despues
    vea el problema sin tener que re-flashear.
    Detectado en hardware-up del 2026-05-24 con Gustavo: LED en error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
    [diag_top_tof.cpp]
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2026-05-25 fix(diag): DIAG_TOF_SKIP_XSHUT pasa lpn_pin=-1 al constructor de VL53L7CX
    Antes el #ifdef DIAG_TOF_SKIP_XSHUT solo saltaba el toggle manual del
    pin 2 en setup(), pero la lib STM32duino_VL53L7CX seguia haciendo
    pinMode/digitalWrite sobre PIN_XSHUT_TOF_FRONT durante begin() e
    init_sensor() (ver vl53l7cx_class.h:82,95,112,124 que chequean
    `if (lpn_pin >= 0)`).
    Para realmente desactivar el manejo de XSHUT en la lib hay que pasar
    lpn_pin=-1 al constructor. Este commit lo hace condicional al define.
    Para experimento next: build con -DDIAG_TOF_SKIP_XSHUT y ver si init
    del L7CX deja de fallar. Si pasa -> XSHUT mal ruteado fisicamente
    (pin 2 del Teensy NO esta conectado al XSHUT del U2). Si no pasa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
    [diag_top_tof.cpp]
2026-05-25 feat(diag): [env:diag_top_tof_no_xshut] variante con SKIP_XSHUT permanente
    Env hermano de [env:diag_top_tof] que agrega -DDIAG_TOF_SKIP_XSHUT
    al build_flags via extends. Evita el lio con PowerShell env vars
    (PLATFORMIO_BUILD_FLAGS no aplicaba consistentemente en hardware-up
    2026-05-24, sospecha de cache).
    Usar:
    pio run -e diag_top_tof_no_xshut -t upload
    Cuando el experimento SKIP_XSHUT termine y sepamos si el problema
    era LPn, este env queda como referencia historica (no se borra).
    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
2026-05-25 feat(diag): vendorear lib L5CX + sketch hermano para identificar sensor
    Hardware-up 2026-05-24: el equipo compro L5/L7/L8 mezclados sin trazabilidad
    y los carriers Pololu son fisicamente identicos (mismo PCB irs18a). La lib
    L7CX falla con err=255 porque el firmware blob no coincide con el silicon.
    Vendorea STM32duino_VL53L5CX + crea sketch hermano diag_top_tof_as_l5cx que
    prueba el sensor desconocido como L5CX. Si init pasa -> es L5CX. Si falla,
    proximo commit vendorea L8CX.
    Sketch tiene SKIP_XSHUT baked in (lpn_pin=-1) porque ya validamos que el
    toggle XSHUT no era necesario — el carrier no tiene ese pin ruteado al
    Teensy.
    Requested-by: Gustavo Violl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
    [diag_top_tof_as_l5cx.cpp]
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2026-05-25 feat(diag): vendorear Adafruit_VL53L7CX + sketch de control
    Tras 3 horas debugging con las 3 libs STMicroelectronics (L5/L7/L8 todas
    con err=255 o hang), agregamos la otra lib popular del VL53L7CX como test
    de control. Si Adafruit funciona donde ST falla, el problema esta en
    las libs ST (no en hardware ni cableado).
    El usuario va a probar este sketch en 2 setups:
    1. La placa TOP del robot (mismo sensor que estuvo fallando)
    2. Un setup de banco con Teensy 4.0 + VL53L7CX nuevo en protoboard
    (cableado: VIN->3.3V, GND->GND, SDA->pin18, SCL->pin19, otros al aire)
    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
    [diag_top_tof_adafruit.cpp]
2026-05-25 docs(journal): 2026-05-24 hardware-up VL53L7CX frontal + bug raiz en lib ST
    Sesion de 3h debugueando init fallido del VL53L7CX. Probadas 3 libs ST
    (L5/L7/L8), todas fallan. Lib Adafruit funciona en mismo hardware + cableado.
    Bug raiz: STM32duino_VL53L7CX vl53l7cx_platform.h:49-60 — DEFAULT_I2C_BUFFER_LEN
    en Teensy 4.0 desborda en 2 bytes el buffer Wire al cargar el firmware blob.
    Decision: migrar firmware vivo a lib Adafruit.
    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
2026-05-26 docs(top): banner en config_top.h sobre XSHUT no ruteado + actualizar canonicos
    config_top.h::PIN_TOF_XSHUT[] gana un banner aclaratorio explicando
    que los tracks NO existen en TOP rev 1.0 (NC flags explicitos en SCH,
    sin nets en PCB). NO se cambia la linea de codigo — sigue siendo
    {2,3,4,5} marcada como aspiracional. Se cambia cuando se haga el bodge.
    ESTADO-ACTUAL.md: TOP marcado como "1 VL53L7CX vivo, U3/U5/U17 NO sin
    rework". Deuda nueva agregada. Resuelto 2026-05-25 capturado.
    FUENTES-DE-VERDAD.md: nueva fila documentando la limitacion fisica
    XSHUT como deuda canonica.
    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
    [config_top.h]
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2026-05-26 fix(top): aclarar mapeo TOF index + canonizar convencion ejes en FUENTES-DE-VERDAD
    Fix-up del commit 651807f tras code quality review:
    1. Comentario en config_top.h dejaba de referir el array deprecated
    PIN_TOF_XSHUT como source de mapeo. Reemplazado por referencia a
    sensors_tof_get_distance_mm() (la API viva).
    2. Convencion de ejes nueva (FIELD_WIDTH_MM=2430 en X, FIELD_HEIGHT_MM=
    1820 en Y) contradice el doc legacy FIRMWARE-PLACA-ARRIBA.md §6.4
    que usaba la convencion opuesta. Agrega fila en FUENTES-DE-VERDAD.md
    documentando que el spec del Sprint 1 + config_top.h son ahora
    canonicos, y la seccion legacy queda superada.
    Requested-by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
    [config_top.h]
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2026-05-27 feat(diag): diag_localization_live env + sketch para validacion en banco
    Sketch standalone que reusa el modulo localization vivo (init/tick/
    get_pose) y printea pose cada 500 ms. Permite validar la trilateracion
    moviendo el robot a mano sobre la cancha y comparando con metro.
    Requiere bodge XSHUT terminado para usar los 4 TOFs. Sin el bodge,
    solo el TOF[0] frontal devuelve dato — pose.valid sera false la
    mayoria del tiempo.
    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
    [diag_localization_live.cpp]
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2026-05-29 feat(down): MuxWatchdog + EV_MUX_DEAD activado (Tema 1 P0 del research)
    Cierra el gap "EV_MUX_DEAD declarado pero nunca seteado" identificado en
    el research doc 2026-05-24-deteccion-linea-down. Si en Incheon un mux
    CD4051 muere (chip quemado, SEL flotantes, ESD), el robot ahora se entera.
    Detector (line_filters.{h,cpp}):
    - Estructura MuxWatchdog con stuck_start_ms, last_common_value, dead[4].
    - mw_update(raw, n_muxes, sensors_per_mux, now_ms, ...).
    - Heuristica: los 8 sensores de un mux dan EXACTAMENTE el mismo valor
    durante >= 100 ms consecutivos Y ese valor es extremo (<=50 o >=970).
    - Valor extremo filtra falso positivo donde 8 sensores coinciden por azar
    en valor medio (raro pero po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
    [down_model.cpp, down_model.h, line_filters.cpp, line_filters.h]
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2026-05-29 feat(down): sensor_health con exclusion dinamica de ruidoso/stuck (Tema 4 P1)
    Cierra el gap "exclusion dinamica de sensor roto" del research doc.
    Detecta dos modos de falla per-sensor que el filtro espacial existente
    no captura:
    1. RUIDOSO cronico: sensor que oscila blanco<->no-blanco mas de 20 veces
    por ventana de 1 segundo. Causa tipica: soldadura intermitente, ruido
    electrico local, LED desencajado parcialmente del lente.
    2. STUCK: sensor que devuelve EXACTAMENTE el mismo valor RAW durante
    mas de 5 segundos consecutivos. Causa tipica: fototransistor muerto,
    traza partida, sensor desoldado.
    Cuando un sensor entra en cualquiera de esos modos, dm_update lo FILTRA
    del calculo d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
    [down_model.cpp, down_model.h, sensor_health.cpp, sensor_health.h, types.h]
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2026-05-29 feat(top): pinout_robot1.h — config específica del arquero (HAL Sprint A T2)
    Pinout específico de ROBOT 1 (arquero). Contiene:
    - PIN_TOF_XSHUT[4]: pines del Teensy para el bodge XSHUT de Enzo
    (PLACEHOLDER hasta confirmar — actualizar acá y reflashear)
    - TOF_I2C_ADDR_ASSIGNED[4]: direcciones tras enumeración (0x29, 0x2A, 0x2B, 0x2C)
    - ROBOT_HAS_TOF_FRONT/BACK/LEFT/RIGHT: flags (1/0/0/0 al 2026-05-29)
    - ROBOT_HAS_OTOS: 0 (arquero sin OTOS)
    - NUM_TOF_ACTIVE: 2 (frontal + trasero, post-bodge)
    - PIN_ROLE_DIPSWITCH: 10
    NO está incluido por nadie todavía — el dispatch viene en T4 + T5.
    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
    [pinout_robot1.h]
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2026-05-29 feat(top): hardware_profile.h — selector central HAL (Sprint A T4)
    Selector central del HAL. Incluye pinout_common.h primero, despues
    dispatcha a pinout_robot1.h o pinout_robot2.h segun -DROBOT1 o -DROBOT2.
    Si ninguno esta definido, #error con mensaje claro.
    NO esta incluido por nadie todavia — la migracion del wrapper viene en T5.
    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
    [hardware_profile.h]
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2026-05-29 fix(down): atender hallazgos del audit independiente sobre Temas 1-4 (P0+P1)
    Audit independiente (Explore agent 2026-05-29, prompt no-sesgado) sobre
    los 4 commits previos del dia. Encontro:
    - 0 BLOCKER
    - 2 HIGH (millis wrap + bounds check sh_is_healthy)
    - 3 MEDIUM (negligible, pre-existentes, o decision de diseno OK)
    - 1 INFO (data_valid contrato vago)
    Este commit cubre las 2 HIGH + el INFO. Los 3 MEDIUM se dejan documentados
    como "aceptado por design" o "pre-existente fuera de scope".
    FIX HIGH-1: aritmetica wrap-safe en MuxWatchdog y SensorHealth.
    - Problema: millis() en Teensy 4.0 retorna uint32_t y wrappea cada ~49.7
    dias. Las restas como `now_ms - stuck_start_ms` daban valores gigant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
    [down_model.cpp, line_filters.cpp, sensor_health.cpp, sensor_health.h]
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2026-05-29 fix(top): heading del IMU al CENTRAL + HC-SR04 gateado + tests offline (auditoria pre-Incheon)
    Auditoria independiente completa de la placa TOP (cerebro sensorial) a
    pedido de Gustavo, espejo de la auditoria DOWN (02d08ae).
    Verificacion:
    - Suite host-native corrida punta a punta por PRIMERA vez: 246 tests /
    19 envs / 0 fallos, 100% offline. Antes estaba bloqueada porque
    `pio test` baja Unity del registry y Avast lo corta (TASK-025). La
    destrabe compilando los tests directo con g++ contra el Unity
    vendoreado. Dejado como script reusable scripts/run-host-tests.sh.
    - Ambos robots compilan limpio (top_robot1 + top_robot2), 0 warnings.
    3 fixes de firmware (riesgos de mal funcionamiento,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
    [comm_down.cpp, main_top.cpp, sensors_tof.cpp]
2026-05-29 fix(central): ingest de linea DOWN->CENTRAL a LineStatusV2 (P0)
    CENTRAL estaba ciego a la linea: comm_down.cpp exigia
    payload_len == sizeof(LineStatus) (5 B), pero DOWN encodea LineStatusV2
    (16 B). El check 16 == 5 daba false -> se descartaba el 100% de los
    frames de linea. En cancha: el robot no frenaba en el borde, el arquero
    no corria su logica de borde, y LINE_AVOID nunca veia datos.
    Fix (sin tocar el cerebro / strategy.cpp):
    - src/shared/line_view.h (nuevo, header-only, host-clean): helpers puros
    que interpretan LineStatusV2 (lsv2_from_frame valida type==LINE_URGENT
    y payload_len==16 como unico guard de schema; lsv2_imminent_exit gateado
    por data_valid Y !lifted; angle/penetratio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
    [comm_down.cpp, comm_down.h, main_central.cpp, world_model.cpp, world_model.h]
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2026-05-29 feat(central): sentido de giro por motor en diag_central_motors (MOTOR_DIR[])
    El diag solo permitia invertir los 3 motores juntos (-DDIAG_MOTORS_REVERSE).
    En este robot las ruedas omni estan montadas con orientaciones distintas, asi
    que tipicamente un motor necesita girar al reves de los otros.
    Cambio (1 archivo, sin tocar shared ni platformio.ini):
    - Nuevo arreglo MOTOR_DIR[3] = { +1, +1, +1 } (signo por motor, +1 horario /
    -1 antihorario). Default preserva el comportamiento anterior (los 3 horario).
    - apply_wave() ahora aplica DIRECTION_SIGN (global) x MOTOR_DIR[i] (por motor),
    con guard de rango sobre el indice.
    - El banner de arranque imprime el sentido efectivo por motor (M1 M2 M3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
    [diag_central_motors.cpp]
2026-05-29 fix(central): diag_central_motors no avanza solo al arrancar (boot/serial)
    Bug reportado en banco: la FSM saltaba sola WAITING->M1->M2->M3 al arrancar y
    recien se quedaba esperando el boton en M3. Cada motor giraba "un instante".
    Causa: serial_advance_request() avanzaba con CUALQUIER byte. Al abrir el Serial
    Monitor, el USB CDC mete bytes de handshake al conectarse -> se leian como 3
    "apretones" seguidos -> 3 transiciones automaticas. El boton fisico estaba bien
    (por eso esperaba correcto en M3, ya sin bytes entrantes).
    Fix:
    - serial_advance_request(): avanza SOLO con ENTER (\n / \r); los demas bytes se
    drenan sin avanzar. La basura del USB ya no dispara transiciones.
    - setup(): tras lev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
    [diag_central_motors.cpp]
2026-05-29 fix(central): diag_central_motors antirebote anti-ruido + doc operativa
    Segundo bug de banco reportado: tras arrancar un motor, el test NO esperaba
    los apretones siguientes y cascadeaba M1->M2->M3 solo. Causa: el RUIDO
    electrico del motor en el pin 9 generaba flancos de boton falsos (el antirebote
    viejo era debil: aceptaba cualquier cambio con 30 ms entre medio).
    - button_pressed_edge(): antirebote por ESTABILIDAD — la lectura cruda del pin
    debe mantenerse igual DEBOUNCE_MS (subido a 50 ms) para adoptar el cambio;
    los picos cortos de ruido reinician el timer y se descartan.
    - loop(): anti-cascada — ignora disparos los primeros MIN_DWELL_MS (300 ms) de
    cada estado, para que el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
    [diag_central_motors.cpp]
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2026-05-29 fix(hw-truth): UART TOP→CENTRAL es Serial5 (20/21), no Serial2 (7/8)
    Corrección de verdad de hardware (Gustavo, en banco): el diagrama del Teensy 4.0
    tiene doble numeración (externa/interna); vale la INTERNA (GPIO). El conector del
    TOP hacia CENTRAL cae en los pines 20/21 = Serial5, NO en 7/8 = Serial2.
    Firmware (compila OK — top_robot1 SUCCESS, test_native 262/262):
    - src/top/comm_central.cpp: Serial2 -> Serial5 (WORLD_SNAPSHOT a CENTRAL).
    - src/top/cameras_runtime.{cpp,h}: cámara trasera Serial5 -> Serial7 (28/29) para
    liberar Serial5 (PROVISIONAL; confirmar conector U9 con Enzo, TOP no armado aún).
    - src/down/config_down.h: corregido comentario RX/TX de Serial5 (20=TX5, 21=RX5)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
    [cameras_runtime.cpp, cameras_runtime.h, comm_central.cpp, config_down.h]
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2026-05-29 feat(central): panel humano en diag_central_comm_down (display legible)
    El receiver ya leia con el protocolo correcto (FrameDecoder), pero imprimia una
    linea densa de numeros. Ahora muestra un PANEL legible cada 500 ms:
    +=========== LINEA DOWN -> CENTRAL ===========+
    ESTADO : >>> SOBRE LA LINEA <<<
    DIRECCION: > DERECHA (45 grados)
    SENSORES : 04/32 [######------------------]
    PENETRA. : 15 mm [#####-----------]
    CALIDAD : 90/100
    EVENTOS : SALIDA-INMINENTE
    ----------------------------------------------
    ENLACE : 120 frames | 0 CRC err | 0 perdidos | hace 8 ms
    +==============================================+
    - ESTADO grande (fuera/sobre/inminente/levantado/no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
    [diag_central_comm_down.cpp]
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2026-05-31 docs+fix(central): unificar link DOWN->CENTRAL en Serial2/pin7 + pruebas de motores pendientes
    Tras sync de agente/central con main (FF), se unifica el bench del link
    DOWN->CENTRAL en el pin que YA se valido en banco.
    Decision (Gustavo, banco 2026-05-29): el enlace fisico se confirmo en
    Serial2 / pin 7 (par diag_down_send1 + diag_central_recv1, "mandar un 1").
    Mi diag_central_comm_down estaba en Serial7/pin28 (elegido para esquivar el
    conflicto 7/8) -> era el unico distinto. Se alinea a Serial2/pin7:
    - diag_central_comm_down.cpp: #define DOWN_UART Serial2 (era Serial7);
    comentarios + banner a RX2/pin7. El conflicto 7/8 solo aparece moviendo
    motores y este receiver no los maneja -> pin7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
    [diag_central_comm_down.cpp]
2026-05-31 diag(top): 3 sketches ToF bus unico + hallazgo: control LP no llega al Teensy
    Recableado 2026-05-30 (Enzo): 4 ToF VL53L7CX movidos al bus principal Wire
    (18/19) con bodge de la pata LP de cada uno a un pin del Teensy (reusando la
    traza de INT), para liberar Wire1 (24/25) hacia la placa DOWN.
    El bodge es fisico y NO esta en el schematic/PCB del repo, asi que los pines
    LP reales habia que medirlos. Se hicieron 3 sketches de banco (NO firmware de
    competencia, compilan limpio, 0 warnings, offline):
    - diag_top_tof_lp_discover: despierta candidatos de a uno, autodetecta polaridad
    - diag_top_tof_enumerate: estrategia de Gustavo, tolera 1 LP roto
    - diag_top_tof_census: definitivo - prueba AMBAS pol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
    [diag_top_tof_census.cpp, diag_top_tof_enumerate.cpp, diag_top_tof_lp_discover.cpp]
2026-05-31 fix(top): CORRECCION - los 4 ToF SI enumeran en bus unico (bodge LP OK) + quad_live
    Supersede la conclusion del commit 096108a, que era un FALSO NEGATIVO.
    QUE PASO: el censo de 096108a concluyo "ningun LP funciona, solo 1 ToF". Error
    de PROCEDIMIENTO, no de hardware: las direcciones I2C de los VL53L7CX PERSISTEN
    entre resets del Teensy; solo un corte real de energia las vuelve a 0x29. Las
    corridas se hicieron sin power-cycle, asi que el bus arrancaba sucio (ToF
    pegados de corridas previas) y la enumeracion no podia partir de fabrica.
    RESULTADO CORRECTO (banco, tras flashear + POWER-CYCLE): los 4 LP funcionan.
    LP pin 9 -> 0x2A , 10 -> 0x2B , 11 -> 0x2C , 12 -> 0x2D (ACTIVO-ALTO)
    Los 4 T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
    [diag_top_tof_quad_live.cpp]
2026-05-31 docs(top): propagar a TODA la doc el recableado ToF (4 en bus unico, LP {9,10,11,12})
    Sincroniza la documentacion del repo con la realidad de hardware confirmada en
    banco el 2026-05-30: los 4 ToF VL53L7CX cuelgan del bus Wire (18/19) con LP por
    bodge en pines {9,10,11,12} (activo-alto), enumeran a 0x2A/0x2B/0x2C/0x2D, y
    Wire1 (24/25) quedo libre para la placa DOWN.
    Reemplaza en todos lados la info vieja (XSHUT no ruteado / maximo 2 ToF / pines
    2,3,4,5 / direcciones 0x52..0x58 / "2 buses con 2 ToF cada uno" / ToF en STUB).
    Firmware (compila SUCCESS ambos robots):
    - pinout_robot1.h: PIN_TOF_XSHUT={9,10,11,12} confirmados, TOF_I2C_ADDR=0x2A..0x2D,
    ROBOT_HAS_TOF_*=1 (4), NUM_TOF_ACTIVE=4. No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
    [config_top.h, pinout_common.h, pinout_robot1.h, pinout_robot2.h]
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2026-05-31 fix(top): mapeo de posiciones ToF + corrige angulos cruzados der/izq + zonemap
    Posiciones confirmadas en banco (Gustavo, 2026-05-31):
    TOF0=FRENTE(0x2A) TOF1=ATRAS(0x2B) TOF2=DERECHA(0x2C) TOF3=IZQUIERDA(0x2D)
    BUG corregido (P1): TOF_MOUNT_ANGLE_DEG era {0,180,90,270}, que en
    localization.cpp::classify_wall asigna el indice 2 a IZQUIERDA (90=WEST) y el 3
    a DERECHA (270=EAST) -- CRUZADO respecto al hardware real (TOF2=derecha,
    TOF3=izquierda). Con eso la localizacion espejaba la pose en X. Corregido a
    {0,180,270,90}. Compila SUCCESS ambos robots; tests host-native sin cambio
    (es config, no logica).
    Nuevo diag: diag_top_tof_zonemap -- imprime la grilla 8x8 cruda de cada ToF
    para verificar l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
    [diag_top_tof_zonemap.cpp, pinout_common.h, pinout_robot1.h, pinout_robot2.h]
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2026-05-31 diag(top): verificacion BNO055 dual — orientacion + sentido de giro
    Nuevo sketch diag_top_bno (no es firmware de competencia) para verificar en
    banco los 2 BNO055 de la placa TOP, que nunca se probaron juntos (el test
    viejo en staging solo probaba UNO en Wire).
    Que verifica:
    - Init IMUPLUS de AMBOS sensores: LEFT en Wire (18/19), RIGHT en Wire1
    (remap 24/25). Replica la init ya validada de sensors_imu.cpp.
    - Orientacion en vivo (heading Euler de cada uno).
    - SENTIDO DE GIRO: muestra gyro-Z (deg/s) con signo + heading, para resolver
    sin ambiguedad el signo del giro contra la convencion del firmware
    (localization.cpp asume heading+ = giro CCW = izquierda; nadie lo midio aun).
    - Drift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
    [diag_top_bno.cpp]
2026-05-31 fix(top): heading del BNO a convencion CCW-positiva (medido en banco)
    Verificacion del BNO055 en hardware con diag_top_bno (sensor LEFT; el RIGHT
    no esta conectado). Resultado: el chip entrega yaw CW-positivo (girar a la
    DERECHA -> +90), pero el firmware asume CCW-positivo (izquierda sube el
    heading; ver TOF_MOUNT_ANGLE_DEG + localization.cpp::classify_wall). Era un
    bug de signo latente que el propio localization.cpp ya advertia.
    Fix en la FUENTE (un solo punto): sensors_imu.cpp aplica HEADING_SIGN = -1
    al yaw crudo de ambos sensores en sensors_imu_tick(). Desde ahi, todo el
    firmware (snapshot a CENTRAL, localizacion, world_model) recibe heading
    CCW-positivo y consistente. Verificado que NO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
    [sensors_imu.cpp]
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2026-05-31 fix(diag): diag_pose_live compila — define TOF_NO_READING local
    El commit anterior (2af52f1) subio diag_pose_live con un error de compilacion:
    usaba TOF_NO_READING / TOF_MAX_RANGE_MM que viven en sensors_tof.h, no en
    localization.h. Incluir sensors_tof.h arrastraria config_top.h/HAL (exige
    -DROBOT1/2), rompiendo la autonomia del diag. Solucion: definir ambos sentinels
    localmente en el namespace anonimo (mismo valor: 0xFFFF / 4000).
    Compila limpio ahora (FLASH code 48996, 0 warnings). diag_bno_dual_live no
    estaba afectado (ya compilaba).
    Author: Claude Opus 4.8 (Anthropic)
    Requested-by: Viollaz
    [diag_pose_live.cpp]
2026-05-31 feat(vision): scripts N6 listos para flashear (frontal + trasera) + guía de flasheo/calibración
    Port de los templates H7 a OpenMV N6 (módulo sensor → csi). La lógica de
    detección (find_blobs + LAB para pelota naranja/arco amarillo/arco azul) y el
    protocolo de 9 bytes por UART son IDÉNTICOS; bugs P0 ya corregidos (sentinel
    no-blob, clamp anti-crash [0,255], autos WB/gain/exposición OFF). UART, LAB,
    exposición y homografía quedan como bloque "confirmar/recalibrar en banco"
    (sensor PAG7936 de la N6 ≠ el de la H7). LEDs defensivos (no crashean si la API
    difiere). + CAMARAS-N6-FLASHEO-Y-CALIBRACION.md con el procedimiento paso a paso.
    NO probado en hardware (las N6 las tiene el equi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
    [cam-frontal-n6.py, cam-trasera-n6.py]
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2026-05-31 feat(top): modulo puro de fusion dual-BNO (salud/glitch/drift/failover) + EEPROM
    Capa 1 + 2 del aprovechamiento de los 2 BNO055, a pedido de Gustavo.
    Honestidad de diseno: con 2 giroscopos identicos en IMUPLUS (sin magnetometro)
    NO se elimina el drift de yaw de fondo (dos que derivan, promediados, siguen
    derivando). Eso requiere referencia absoluta (paredes ToF / arcos camara) =
    Capa 3 futura. Esta tanda da redundancia, menos ruido, y DETECCION de drift.
    Modulo PURO host-testeable (src/shared/imu_fusion.{h,cpp}):
    - Salud por sensor: OK / DEGRADED / DEAD.
    - Rechazo de glitches/impactos: si el heading salta mas de lo que el propio
    giroscopio justifica (gyro*dt), descarta ese ciclo (con str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
    [imu_fusion.cpp, imu_fusion.h]
2026-05-31 fix(top): conectar firmware vivo a la fusion dual-BNO + drift asimetrico
    Completa y corrige el commit anterior (21fdb85), que agrego el modulo de
    fusion pero cuyo mensaje describia una reescritura de la capa hardware que
    NO habia llegado a disco (los Write se cancelaron al caerse el clasificador
    de Bash a mitad de la tanda). Ademas un test destapo un bug de diseno real
    en la deteccion de drift. Ambas cosas se arreglan aca.
    1) sensors_imu.cpp REESCRITO para DELEGAR al modulo imu_fusion (antes seguia
    con la fusion inline simple). Ahora:
    - lee yaw + gyroZ + calib de cada BNO, presencia por ACK en el bus,
    - corre imu_fusion_update() y publica el heading FUSIONADO,
    - ejecuta los pedi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
    [imu_fusion.cpp, imu_fusion.h, sensors_imu.cpp, sensors_imu.h]
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2026-05-31 fix(vision): cam-frontal-n6 sin LEDs (crasheaban el loop en N6) + flag BRING_UP
    - Quitados los LEDs de diagnóstico: la API de pyb.LED de la N6 difiere del H7 y
    hacía crashear el loop (traceback line _set). Son cosméticos, no hacen falta.
    - Flag BRING_UP (default True): autos WB/gain/exposición en ON para VER imagen y
    calibrar (resuelve el preview negro). En competencia → False (autos OFF + fija).
    - csi API sin cambios (probada: alcanzó FPS 16-19 = snapshot funciona). Quitado
    el import `image` no usado. El main.py viejo de la cámara se pisa al guardar esta.
    [cam-frontal-n6.py]
2026-05-31 fix(vision): cam-frontal-n6 usa módulo `sensor` (csi daba preview NEGRO en la N6)
    Hallazgo en banco (Gustavo): current-generic.py (módulo `sensor`) muestra color en
    la N6 fw 4.8.1, pero la versión con `csi` daba preview negro (misma cámara/luz).
    → El módulo `sensor`, aunque deprecado, FUNCIONA en 4.8.1. Se copia el init exacto
    del generic (sensor.reset/set_pixformat/set_framesize/set_auto_*/skip_frames(2000))
    y se mantienen las mejoras: bugs P0 (sentinel, clamp), sin LEDs, flag BRING_UP.
    Migrar a `csi` queda post-Incheon (cuando se entienda por qué da negro acá).
    [cam-frontal-n6.py]
2026-05-31 fix(vision): cam-frontal-n6 UART → pyb.UART (machine.UART crasheaba en write en la N6) + print de bring-up
    El generic usa pyb.UART(3,19200) y transmite OK; machine.UART(3,19200) construía
    pero crasheaba en uart.write (Traceback línea 152). Mismo patrón que sensor vs csi:
    usar lo que el generic prueba que funciona. + print(packet) gateado por BRING_UP
    para verificar en consola que salen los 9 bytes.
    [cam-frontal-n6.py]
2026-05-31 fix(vision): cam-trasera-n6 mismo arreglo que el frontal (sensor + pyb.UART, sin LEDs, BRING_UP)
    Aplica a la trasera los 3 fixes probados en el frontal: módulo sensor (csi daba
    negro), pyb.UART (machine.UART crasheaba en write), sin LEDs (crasheaban), +
    BRING_UP + print de bring-up. Preserva lo propio: CAM_ID=1, UART→Serial7/U9, y la
    nota de que la rotación 'mira atrás' la hace el TOP (cameras_fusion cam_id=1), no acá.
    [cam-trasera-n6.py]
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2026-06-01 fix(top): swap UART — camara trasera -> Serial5, link CENTRAL -> Serial7 (TASK-204)
    La trasera quedo SOLDADA en Serial5 (pin 21), confirmado en banco con
    diag_top_cameras (FORMATO OK en Serial5, 0 bytes en Serial7). El commit 695e7b0
    la habia movido a Serial7 asumiendo placa sin armar y puso el link a CENTRAL en
    Serial5 -> cruzados. Se revierte ese movimiento (swap):
    - cameras_runtime.cpp/.h: trasera Serial7 -> Serial5 (init + drenado)
    - comm_central.cpp/.h: link TOP->CENTRAL Serial5 -> Serial7 (init/RX/TX)
    - pinout_common.h + main_top.cpp: comentarios UART reconciliados
    - diag_top_cameras.cpp: labels (Serial5=trasera, Serial7=link CENTRAL/TX)
    Lado CENTRAL: sin cambio de firmware (recibe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
    [cameras_runtime.cpp, cameras_runtime.h, comm_central.cpp, comm_central.h, diag_top_cameras.cpp, main_top.cpp, pinout_common.h]
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2026-06-01 fix(top): HC-SR04 movido a TRIG=pin4 / ECHO=pin3 (cableado real en banco)
    Gustavo lo soldo en pin 4 (TRIG) y pin 3 (ECHO) — pines ex-XSHUT ToF, hoy libres
    — no en 6/7. Codigo actualizado:
    - pinout_common.h: PIN_HCSR04_TRIG 6->4, PIN_HCSR04_ECHO 7->3.
    - diag_top_ultrasonic.cpp: PIN_TRIG/PIN_ECHO + cabecera + banner.
    - sensors_tof.cpp: reescrito el comentario del HC-SR04 — el viejo 'conflicto de
    pin 7' (ECHO en Serial2 RX2) YA NO APLICA (pines 3/4 no son UART). Sigue gateado
    OFF por default solo por el pulseIn bloqueante (25ms, TASK-014), no por pines.
    Build: diag_top_ultrasonic + top_robot1 SUCCESS. Docs en commit aparte.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
    [diag_top_ultrasonic.cpp, pinout_common.h, sensors_tof.cpp]
2026-06-01 docs(top): consistencia HC-SR04 (pines 3/4) + swap UART (trasera S5 / CENTRAL S7)
    Actualiza TODA la doc general/canonica del TOP a la realidad confirmada en banco
    2026-05-31, en dos ejes entrelazados:
    1) HC-SR04: TRIG=pin4 / ECHO=pin3 (no 6/7). El viejo 'conflicto pin 7' ya no
    existe (pin 7 libre). Agregada la alerta de 5V en ECHO (Teensy no tolera 5V).
    2) Swap UART (TASK-204): camara trasera en Serial5 (pin 21, FORMATO OK) y link
    TOP->CENTRAL movido a Serial7 (pin 29). Revierte el movimiento provisional del
    2026-05-29.
    Archivos: top-board-pack {01-pinout, 02-funcionalidad, 03-contrato, README},
    cameraBack-pack {01-hardware, README, cam-trasera-n6.py}, CAMARAS-N6-guia,
    docs {ARQUI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
    [cam-trasera-n6.py]
2026-06-01 feat(diag): diag_top_ultrasonic v2 — prueba ambas orientaciones de pin + idle
    El HC-SR04 daba eco~3us (sin eco real). v2 dispara las DOS orientaciones por ciclo
    (T4/E3 y T3/E4) y muestra el idle de cada pin, para distinguir: pines swapeados
    (una orientacion mide) vs sensor sin emitir (ninguna mide, tipico de Vcc=3.3V en
    HC-SR04 clasico) vs ECHO pegado en HIGH. Cabecera aclarada: Vcc=5V + divisor en
    ECHO; NO bajar Vcc a 3.3V (apaga el sensor clasico).
    [diag_top_ultrasonic.cpp]
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2026-06-01 feat(quick-wins): F2 DOWN 4 muxes/2 OTOS (default) + F1 multi-ToF y F3 arranque manual (gateados)
    De la auditoria holistica 2026-05-31. Gate: 287 tests nativos + builds de los 6
    envs (down, top_robot1/2, central_robot1/2, top_robot1_multitof) + compile-check
    de central con CENTRAL_ENABLE_MANUAL_START — todo SUCCESS.
    F2 (DEFAULT, alto impacto): [env:down] ahora -DDOWN_NUM_MUXES_CONNECTED=4 +
    -DDOWN_NUM_OTOS_CONNECTED=2 (placa fixeada, validada en banco 2026-05-24).
    Antes el default era 1 mux = 8 de 32 sensores. down_debug dedup (hereda).
    F1 (GATEADO -DTOP_ENABLE_MULTI_TOF, OFF por default): enumeracion de los 4 ToF
    (0x2A..0x2D, bus Wire, LP {9,10,11,12}) portada de diag_top_tof_quad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
    [config_central.h, main_central.cpp, sensors_tof.cpp, world_model.cpp, world_model.h]
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2026-06-01 docs+fix(central): MAPA-CONEXIONES-3-PLACAS (UART+I2C+USB) + CENTRAL ya no lleva BNO
    Doc nuevo: hardware/electronics/MAPA-CONEXIONES-3-PLACAS.md — referencia UNICA de
    puertos de las 3 placas (aclara que el USB = es independiente de los UART
    Serial1-8 entre placas; no hay nada que 'liberar' para programar/monitorear), + mapa
    I2C (TOP: 2 BNO + 4 ToF en un solo bus Wire; DOWN: 2 OTOS en 2 buses por misma dir 0x17).
    Correccion de hardware (Gustavo): la CENTRAL ya NO lleva BNO — los 2 BNO estan en el
    TOP. El heading viene del WORLD_SNAPSHOT de ARRIBA.
    - main_central.cpp: imu_init() gateado tras -DCENTRAL_HAS_LOCAL_BNO (default OFF) →
    el build normal no toca I2C ni pierde ~3s buscando un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
    [config_central.h, imu_zircon.h, main_central.cpp]
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2026-06-01 feat(central): reasignar UARTs — TOP en Serial7 (28/29), DOWN en Serial1 (0/1), libera 7/8
    Decision Gustavo + cableado en banco 2026-05-31: el link TOP->CENTRAL usa los pines
    28/29 (Serial7) de la CENTRAL. En consecuencia el link DOWN->CENTRAL se mueve a Serial1
    (0/1), liberando Serial2 (pines 7/8) para el driver del motor 2 (U17).
    ==> CONFLICTO F8/TASK-036 (Serial2 vs motor 2) RESUELTO.
    - comm_top.cpp: Serial1 -> Serial7 (recibe WORLD_SNAPSHOT del TOP).
    - comm_down.cpp: Serial2 -> Serial1 (recibe LINE_URGENT del DOWN; incl. los send de
    reset/calib).
    - config_central.h: UART_TOP_RX/TX = 28/29; agregado UART_DOWN_RX/TX = 0/1.
    - diag_central_comm_down.cpp: DOWN_UART Serial2 -> Serial1 + c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
    [comm_down.cpp, comm_top.cpp, config_central.h, diag_central_comm_down.cpp]
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2026-06-01 Arquero seguidor de linea: calibrador DOWN, fix line_ring/EEPROM, cross_track, PID heading
    [comm_central.cpp, diag_central_comm_down.cpp, diag_central_line_sweep.cpp, diag_down_calibracion.cpp, line_ring.cpp, line_ring.h, main_down.cpp]
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2026-06-01 fix(central): diag_central_strafe a OPEN-LOOP — el CENTRAL no tiene BNO
    Correccion (Gustavo): el CENTRAL NO tiene BNO055 (el heading viene del TOP). Mi
    version anterior usaba imu_zircon (BNO local) que NO existe fisicamente -> en la
    placa real imu_init() fallaba siempre. Lo rehago bien:
    - OPEN-LOOP: comanda vx lateral con omega=0. Para un omni-3 con ruedas parejas eso
    es traslacion pura sin rotar (mira al frente). La rotacion residual es deriva y
    NO se corrige (no hay sensor de heading en CENTRAL).
    - Saco la dependencia de imu_zircon + HeadingPID: el sketch solo usa motors_zircon
    + kinematics. Mas liviano y sin el timeout de ~6s del BNO inexistente.
    - Saco los flags de heading-hold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
    [diag_central_strafe.cpp]
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2026-06-02 fix(top): WP-1C recibir linea como LineStatusV2 (lsv2_from_frame), no LineStatus viejo
    [comm_down.cpp, comm_down.h]
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2026-06-02 wip(top): bring-up BNO/ToF — orden init (dim ToF->BNO->enum) + guard 2do BNO + diag
    Orden correcto (receta diag_pose_live): predim_lp duerme ToF -> init BNO -> enumerar ToF. Guard: solo init RIGHT si 0x29 chip-id=0xA0 (no colgar el bus por un 0x29 fantasma). + scan_wire + sondeo chip-id (diag). I2C a 100kHz fue experimento, revertir a 400kHz al resolver el HW. Bus I2C marginal = HARDWARE pendiente -> TASK-040. Co-Authored-By: Claude Opus 4.8 (1M context) <noreply@anthropic.com>
    [main_top.cpp, sensors_imu.cpp, sensors_tof.cpp, sensors_tof.h]
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2026-06-02 fix(top): I2C Wire a 400 kHz (bus sano al sacar el 2do BNO fallado) - boot ~10s + ToF 4/4 en banco
    El 100 kHz era parche de TASK-040 para el bus marginal; la causa real era el 2do BNO (0x29) fallado. Con 1 BNO bueno (0x28) + 4 ToF el bus quedo estable a 400 kHz (validado: diag_top_tof_quad_live = 4/4). Co-Authored-By: Claude Opus 4.8 (1M context) <noreply@anthropic.com>
    [sensors_imu.cpp, sensors_tof.cpp]
2026-06-02 fix(top): mapeo UART corregido - COMM=Serial2 (7/8), CENTRAL=Serial4 (16/17)
    El Teensy 4.0 del TOP NO expone Serial7 (28/29) en el borde (pads SMD traseros). TASK-204 habia puesto el enlace a CENTRAL en Serial7 por error -> el TOP nunca le llegaba a la CENTRAL (snap_fresh=N). Cableado real: Serial2 (7/8)=COMM, Serial4 (16/17)=CENTRAL. Cable TOP pin 17 (TX4) -> CENTRAL pin 28 (RX7, Serial7 del 4.1, que SI es de borde). Incluye diag rxB en comm_top (CENTRAL) + sync de MAPA-CONEXIONES + ESTADO. Co-Authored-By: Claude Opus 4.8 (1M context) <noreply@anthropic.com>
    [comm_arbiter.cpp, comm_arbiter.h, comm_central.cpp, comm_central.h, comm_top.cpp, comm_top.h, main_central.cpp, main_top.cpp]
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2026-06-03 feat(top): arbitro por NIVEL GPIO en pines 5/6 (TASK-039 resuelta)
    El arbitro RCJ llega al TOP como nivel logico (no UART): pin 5=OUT1 (PLAY/STOP), pin 6=OUT2 (espejo). 0=parado, 1=jugando (3.3V), probado en banco. comm_arbiter.read_referee_gpio() lee 5/6 con INPUT_PULLDOWN; match_running = pin5 AND pin6 (fail-safe a STOP). UART Serial2 (7/8) queda solo para partner ESP-NOW. Removido el probe temporal de main_top (queda arb[... p5/6=..] en debug). Cierra el E2E del arbitro (TASK-006/TASK-039). Co-Authored-By: Claude Opus 4.8 (1M context) <noreply@anthropic.com>
    [comm_arbiter.cpp, main_top.cpp]
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2026-06-03 fix(top): arbitro match_running = pin5 OR pin6 (era AND) - en PLAY sube solo 1 pin
    Banco 2026-06-02 (Gustavo): con AND el match nunca daba GO porque en PLAY sube SOLO UNO de los 2 pines del referee (el otro queda en 0). Con OR, si cualquiera dice PLAY el robot juega; en STOP los dos quedan en 0 -> STOP. Sigue fail-safe (desconectado -> ambos 0 con INPUT_PULLDOWN -> STOP). Co-Authored-By: Claude Opus 4.8 (1M context) <noreply@anthropic.com>
    [comm_arbiter.cpp]
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2026-06-03 diag(top): diag_bno_tof + _slow - bisect BNO+ToF en Wire (400/100 kHz) para el heading clavado
    BNO 0x28 leido directo + 4 ToF activos en el mismo bus, sin camaras/HCSR04/fusion. Aisla si el freeze del yaw es por coexistencia BNO+ToF en I2C, y prueba si 100kHz lo arregla. Co-Authored-By: Claude Opus 4.8 (1M context) <noreply@anthropic.com>
    [diag_bno_tof.cpp]
2026-06-03 fix(top): I2C de vuelta a 100 kHz - BNO055 + VL53L7CX NO coexisten a 400 kHz
    Bisect diag_bno_tof (banco 2026-06-02): a 400 kHz con los ToF rangeando, el read multi-byte del BNO se corrompe y el yaw queda CONGELADO; a 100 kHz (diag_bno_tof_slow) el yaw sigue el giro con los 4 ToF activos. Revierte el clock de c95ef5d (que solo se habia validado ToF-solo via quad_live y BNO-solo via diag_bno_left, nunca juntos). Costo: boot del TOP ~40 s (carga firmware de los 4 ToF). Optimizacion futura: cargar ToF a 400 kHz y bajar a 100 kHz para el steady-state. Co-Authored-By: Claude Opus 4.8 (1M context) <noreply@anthropic.com>
    [sensors_imu.cpp, sensors_tof.cpp]
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2026-06-03 fix(top): band-aid contencion BNO+ToF - leer BNO a ~20 Hz (sin ping i2c) -> yaw deja de congelarse
    Validado en banco (diag_top_all 2026-06-02): el heading SIGUE el giro con los 4 ToF + HC-SR04 + camaras activos. Causa: leer el BNO a 100 Hz (4 transacciones/tick) lo hacia chocar con los reads de los ToF en Wire y el read multi-byte se corrompia -> yaw congelado. A 20 Hz + sin el ping i2c_present, las colisiones bajan lo suficiente. Fix de fondo disponible si reaparece: BNO -> Wire1 (bus aparte). Co-Authored-By: Claude Opus 4.8 (1M context) <noreply@anthropic.com>
    [sensors_imu.cpp]
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2026-06-03 feat(top): velocidad de pelota (ball_velocity) + kit calibracion vision N6 (TASK-022)
    Pieza A - estimador puro de velocidad de la pelota (mm/s, marco robot) que enciende bt_classify (antes ball_vx/vy=0 -> siempre BT_STILL):
    - src/shared/ball_velocity.{h,cpp}: diferencias finitas sobre la posicion fusionada, solo deriva al llegar packet nuevo, EMA 0.4, reset al perder la pelota, re-siembra si gap>200ms, getter con clamp int16.
    - cableado en cameras_runtime (cameras_get_ball_vx/vy_mm_s) + 2 lineas en main_top::build_snapshot.
    - TDD: 13 tests test_ball_velocity (RED->GREEN). Suite host 324/26/0. Compilan top_robot1, top_robot2, diag_top_all.
    Pieza B - kit de calibracion LAB para las OpenMV N6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
    [ball_velocity.cpp, ball_velocity.h, calib-lab-n6.py, cameras_runtime.cpp, cameras_runtime.h, main_top.cpp]
2026-06-03 docs(central): fixes pre-banco mitad inferior + journal review GK
    Verificacion pre-banco (no HW): central_robot1 + 3 diag compilan SUCCESS; Serial verificado en codigo (DOWN=Serial1 pin0, TOP=Serial7 pin28; diag y produccion coinciden).
    Fixes de seguridad: removidas refs stale Serial2/pin7 en DIAG-CENTRAL-MOTORS (podian mandar a cablear un pin de motor); corregido comentario OTOS stale en diag_central_strafe.cpp (OTOS ya llega a CENTRAL, v2 local); caveat de cinematica no calibrada (circulos / M2 invertido, hallazgo 2026-06-01) en strafe.cpp + DIAG-CENTRAL-STRAFE.md.
    Solo docs/comentarios + journal; sin cambio de firmware funcional.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
    [diag_central_strafe.cpp]
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2026-06-03 feat: primitivas de navegacion por OTOS y ToF + fix comentarios desactualizados
    Backup de movimiento sin sensores de luz/camaras (modulos PUROS host-testeados, NO cableados a la FSM todavia):
    - src/shared/otos_position.{h,cpp} (10 tests): mover N mm adelante/al costado y parar, por odometria OTOS; rampa de frenado + tolerancia de llegada.
    - src/shared/tof_distance_hold.{h,cpp} (9 tests): acercarse/mantener X mm de una pared por ToF; fail-safe si la lectura es invalida.
    Fix de comentarios que contradecian main:
    - down/comm_central.cpp: el OTOS SI se difunde a CENTRAL (broadcast simetrico; 7/8 RESUELTO).
    - down/otos.{cpp,h}: la lib SparkFun YA esta activa (no comentada); 'Stub' -> 'modo single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
    [ball_velocity.h, comm_central.cpp, main_top.cpp, otos.cpp, otos.h]
2026-06-03 fix(top): freshness al boot en comm_down (last_ms==0 no es fresco)
    El helper fresh() del TOP daba 'fresco' los primeros DOWN_HEARTBEAT_TIMEOUT_MS post-boot porque millis()-0 < timeout, exponiendo el struct cero-inicializado (Pose2D/Velocity2D/LineStatusV2) como dato real. Guard last_ms != 0 (mismo patron que central/world_model.cpp). Hallazgo de la code-review (M1). Compila top_robot1 SUCCESS.
    [comm_down.cpp]
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2026-06-03 chore: limpieza post-kicker (rename, motion_target, flag muerto, comentarios, task banners)
    Hallazgos de las reviews del workflow anterior:
    - rename is_aligned_to_shoot -> is_aligned_to_push (behind_ball, strategy.cpp, strategy_transitions, test_behind_ball): el robot empuja, no patea.
    - motion_target: erradicado MI_KICK + campo MotionCmd.kicker (modulo no cableado) + test_central_motion actualizado.
    - tof_distance_hold: removido el flag muerto stop_if_invalid (sin lectura ToF SIEMPRE frena, fail-safe) + test.
    - otos_position.cpp: comentario de llegada corregido (no chequea t.active; contrato del caller).
    - otos.h y config_down.h: typo de bus I2C OTOS (Wire2 -> Wire1; U5=Wire/18-19, U6=Wire1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
    [behind_ball.cpp, behind_ball.h, config_down.h, motion_target.cpp, motion_target.h, otos.h, strategy.cpp, strategy_transitions.cpp]
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2026-06-03 feat(shared): localizacion TOP — geometria ToF (F1a/F1b) + filtro temporal + fusion OTOS (modulos puros)
    Mejoras de localizacion como logica PURA host-testeable en src/shared/, SIN
    cablear a build_snapshot todavia (eso queda para cuando se valide en cancha
    con datos reales). Generado via workflow multi-agente (diseno -> impl -> tests
    host -> sintesis), verificado de forma independiente.
    3 piezas:
    1. localization.cpp/.h (F1a + F1b) — arregla 2 errores de geometria:
    - F1a: suma TOF_OFFSET_MM (plano-sensor -> centro del robot) a la lectura
    cruda. Critico cuando solo 1 sensor del eje mide (sin opuesto que lo
    cancele). Campo nuevo LocalizationConfig.tof_offset_mm; SI 0 -> legac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
    [pinout_common.h]
2026-06-03 fix(ball_velocity): expirar la velocidad por tiempo (M4)
    ball_velocity_update ahora recibe now_ms: si la pelota sigue visible pero los packets se cortan (sample_ms no avanza) y now_ms-last_ms > max_gap_ms, invalida la velocidad (v=0) en vez de servir una estimacion fantasma hasta 1s (watchdog de camara). Conserva last_x/y/ms + has_point para re-derivar al volver el dato. Caller cameras_runtime.cpp pasa millis(). TDD: 16 tests (3 nuevos de expiry). Host 354/29/0; top_robot1/2 SUCCESS.
    [ball_velocity.cpp, ball_velocity.h, cameras_runtime.cpp]
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2026-06-03 fix(otos): heading dual por promedio circular + slip por velocidad (M2/M3)
    M2 (heading): en modo 2 OTOS, g_heading_deg pasa de atan2(dy,sep) [saturado +/-90, descartaba el heading absoluto] a PROMEDIO CIRCULAR de los headings absolutos pl.h/pr.h (cubre +/-180 con wrap). El atan2(dy,sep) queda solo como diagnostico (otos_get_heading_diag_deg()).
    M3 (slip): g_slip pasa de abs(right_x-left_x) [diferencia de POSICION integrada, monotona, satura a 255] a abs((right_vx-left_vx) - omega*SEPARATION) [diferencia de VELOCIDAD menos la rotacion esperada, mm/s, acotada].
    Sin cambio de conducta: nadie consume hoy heading/slip del OTOS (heading autoritativo = BNO del TOP) y el robot corre con 1 OTOS por d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
    [otos.cpp, otos.h]
2026-06-03 diag(central): veredicto de completitud en diag_central_rx_all (recibe TODO de TOP+DOWN?)
    Extiende el receiver existente con un bloque que responde de frente si la CENTRAL recibe la info COMPLETA: [OK]/[STALE]/[FALTA] + tasa Hz por cada mensaje esperado (DOWN: LineStatusV2+Pose2D+Velocity2D ; TOP: WorldSnapshot), salud por enlace (CRC+seqGap) y un PASS/FAIL global. LED fijo solo si los 4 frescos + ambos enlaces limpios. Pista DOWN-vs-CENTRAL cuando llega LINEA pero no OTOS.
    Doc operativo nuevo DIAG-CENTRAL-RX-ALL.md (cableado pin0/pin28, runbook, tabla de interpretacion) + fila en FUENTES-DE-VERDAD. Compila diag_central_rx_all SUCCESS. NO validado en HW (lo corre el equipo).
    Co-Authored-By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
    [diag_central_rx_all.cpp]
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2026-06-03 diag(central): diag_central_arbitro_strafe - patrulla del arquero gatillada por el arbitro
    Espera START del arbitro (match_running del WorldSnapshot del TOP, Serial7), patrulla lateral 30cm IZQ->pausa 3s->DER->pausa 3s->loop, STOP->frena (inmediato), START->retoma desde IZQ. Fail-safe: snapshot del TOP no fresco = STOP. Override de banco por Serial ('s'=START, 'x'=STOP) para probar el movimiento sin COMM/TOP. OPEN-LOOP (omega=0, distancia por tiempo) + mismos caveats de cinematica que diag_central_strafe (circulos/M2, ver TASK-101).
    Envs diag_central_arbitro_strafe_robot1/2 (compilan SUCCESS) + doc operativo DIAG-CENTRAL-ARBITRO-STRAFE.md + fila en FUENTES-DE-VERDAD. NO validado en HW (lo c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
    [diag_central_arbitro_strafe.cpp]
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2026-06-03 fix(diag): quitar kicker_fire de diag_central_arbitro_strafe (compila post-merge)
    El diag del agente CENTRAL branchó antes de la remoción del kicker y seteaba cmd.kicker_fire (campo ya inexistente en MotorCommand). Quitada la línea (riesgo cero: el robot no tiene kicker). diag_central_arbitro_strafe_robot1/2 SUCCESS.
    [diag_central_arbitro_strafe.cpp]
2026-06-03 fix: 9 correcciones de riesgo cero (comentarios/docs desactualizados) — eval holistica
    Todas verificadas, sin efecto en comportamiento ni build (host 389/0; down/central/top SUCCESS):
    - down_model.cpp:220 n<32 -> n<SENSOR_COUNT (constante equivalente, coherencia).
    - config_central.h: env 'zircon_robot1/2' -> 'central_robot1/2' (no existian); COMMAND_TIMEOUT_MS anotada SIN USO (watchdog real = SNAPSHOT_TIMEOUT_MS 500ms).
    - world_model.h: doc 'expone confidence=0' -> mecanismo real (snapshot_is_fresh()=false -> frena).
    - config_down.h: OTOS_I2C_ADDR anotada SIN USO (la lib la fija).
    - line_ring.h: timing calib ~500ms -> ~320ms (real).
    - comm_top.h (down): send_status envia 2 frames (POSE+VEL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
    [comm_top.h, config_central.h, config_down.h, down_model.cpp, line_ring.h, world_model.h]
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2026-06-03 fix: 3 bugs verificados de la eval holistica (overflow omega CRITICO, partner boot, sample_age)
    Fixes con riesgo de regresion NULO (la conducta vieja era el bug); gate verde 389/0 + 5 envs SUCCESS:
    - CRITICO overflow int16 de omega: HeadingPID.output_clamp 360->327 (pids.h). cmd.omega_centideg_s=omega*100 es int16; 360->36000 desbordaba y el robot giraba a FONDO al reves al saturar el PID (POSITION/APPROACH/GK CLEAR). 327 cabe (32700<32767); el rango normal (omega<<327) no cambia. Verificado: output_clamp no se sobreescribe; g_heading_pid default. test_pids 18/18 OK.
    - ALTO partner_alive falso al boot: comm_arbiter_partner_is_fresh() guard g_partner_last_rx_ms!=0 (mismo patron ya parcheado e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
    [comm_arbiter.cpp, drive_straight.cpp, line_ring.cpp, pids.h]
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2026-06-03 fix(convencion-ejes): corregir ejes de cancha — +Y(arco)=2430 largo, +X(lateral)=1820 corto
    El firmware y CONVENCION-EJES tenian FIELD_WIDTH=2430 en X y FIELD_HEIGHT=1820 en Y: el eje hacia el arco rival (+Y) quedaba con el valor del lado CORTO. Esta invertido respecto al reglamento.
    Verificado contra el field spec oficial RCJ Soccer 2026: cancha de juego 219x158 cm (linea blanca) + 12 cm de outer area por lado = 243x182 cm pared-a-pared. Los arcos van en las paredes cortas, asi que arco-a-arco es el lado LARGO. Los ToF miden a las paredes -> la localizacion usa 2430x1820.
    Cambios: FIELD_WIDTH_MM 2430->1820 (X lateral/corto) y FIELD_HEIGHT_MM 1820->2430 (Y arco-a-arco/largo) en pinout_co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
    [diag_pose_live.cpp, pinout_common.h]
2026-06-03 fix(central-motores): M2 (U17) invertido en produccion + alinear docs al banco
    motors_zircon.cpp manejaba los 3 motores igual (sin inversion por motor) -> M2 corria al reves del arquero validado en banco (Maria/Elias, diag_central_line_sweep: motor2 cruza INA/INB, ROT_M2=-1). Ese era el bug: produccion movia M2 invertido respecto a lo que anduvo.
    config_central.h: nuevo MOTOR_INVERT por robot. ROBOT1={+1,-1,+1} (M2/U17 invertido, validado). ROBOT2={+1,+1,+1} neutro + flag (delantero NO testeado; ahi U17 es el motor 1; pendiente correr diag_central_motors en el delantero). motors_zircon.cpp: apply_pwm_to_motor multiplica el PWM firmado por MOTOR_INVERT[i] antes de manejar INA/INB.
    DIAG-CENT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
    [config_central.h, motors_zircon.cpp]
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2026-06-03 fix(central-motores): ROBOT2 MOTOR_INVERT = ROBOT1 provisorio (pendiente banco)
    Por pedido: ROBOT2 (delantero) queda igual que ROBOT1 ({+1,-1,+1}) como placeholder. Comentado que FALTA VERIFICAR EN BANCO (correr diag_central_motors en el delantero) y que ahi los pines estan rotados: el indice 1 de este array es el driver U7, no el U17; si la inversion real es del driver U17 (indice 0 en el delantero) el array correcto seria {-1,+1,+1}. El banco lo dirime.
    [config_central.h]
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2026-06-03 fix(central): Tier-1 de la auditoria - omega int16, anti-windup, data_valid gates, resync telemetry (TDD host-verde)
    Etapa 2 autonoma (sin intervencion humana, host-testeable). Workflow TDD 2 lanes + integracion central. Suite host: 322 tests / 0 fallos; central_robot1+2 compilan.
    #9 overflow omega: nuevo helper puro omega_degps_to_centideg() en pids (satura a int16, anti sign-flip) + cableado en los 5 sitios de strategy.cpp (5 tests). #29 anti-windup real (conditional integration) en heading/lateral PID (4 tests, camino no-saturado bit-identico). #5/#13 line_view: lsv2_penetration_u8 y lsv2_line_angle_deg honran data_valid (3 tests). #25 surface resync_events del decoder en comm_top/comm_d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
    [comm_down.cpp, comm_down.h, comm_top.cpp, comm_top.h, config_central.h, main_central.cpp, pids.cpp, pids.h]
2026-06-03 fix(down): docs-config — comentarios/docs al dia con la realidad de produccion (audit 2026-06-03, #8 #12 #17 #22 #27)
    #8: config_down.h + platformio.ini ya no dicen 'default 1 mux/1 OTOS' (produccion compila 4/2); se aclara que los #define son fallback. #17: corregido comentario stale 'Wire2/I2C2' (es Wire/Wire1) + nota de que OTOS_SEPARATION_MM=200 es tentativo y solo aplica en modo 2-OTOS. #12: ESTADO-ACTUAL explicita tasas (LINE@200Hz, Pose/Vel@100Hz) y que TOP recibe LINE pero no la consume. #22: nota en types.h LineStatus v1 (legacy) -> umbral vivo sensors_on_line>=6, no el line_ring=3 muerto. #27: FIRMWARE-PLACA-ABAJO al dia (calib la dispara diag_down_calibracion por USB, EEPROM ya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
    [config_down.h, types.h]
2026-06-03 fix(down): line-comm — sample_age timestamp, dead cross_track block, live==tested TX, g_dm init (audit 2026-06-03, #2 #9 #10 #11 #18)
    #2: helper puro lsv2_sample_age_ms (resta unsigned + clamp) + line_ring expone TIMESTAMP del muestreo (line_ring_get_last_sample_us); comm_central deja de restar la duracion del tick (campo ya no pegado en 255). Cubierto por test_down_encode (now/sample, wrap, clamp).
    #9: borrado el bloque #ifdef DOWN_DEBUG_SERIAL que recalculaba cross_track DESPUES del broadcast (codigo muerto, nunca se enviaba); el print de banco ahora lee s.cross_track_mm ya difundido (valor real de dm_update).
    #10: DownModel g_dm{} value-init explicito (no depender del zero-init de .bss)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
    [comm_central.cpp, down_encode.cpp, down_encode.h, down_tx.cpp, line_ring.cpp, line_ring.h]
2026-06-03 fix(down): model — gate adapt por white[], corner+penetration geom real, doc rate sensor_health (audit 2026-06-03, #4 #16 #21 #25 #26 #28)
    #4 (P1): lc_adapt_carpet gatea con white[] (pre-espacial) no validated[], para que un
    sensor blanco array-singleton no contamine el baseline de carpet (auto-cegado del arquero).
    #16/#21: corner detection con sg_fill_angles_deg cuando n==32; penetration usa el K-esimo
    radio mas chico (K=3) en vez del min crudo, robusto a 1-2 internos espurios.
    #25/#26: doc — line_present es per-tick (sin debounce agregado); sensor_health corre a 200Hz
    (no 1kHz), ventanas wall-clock rate-independientes. #28: tests de caracterizacion del stuck.
    Cubierto por test_do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
    [down_model.cpp, sensor_health.h]
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2026-06-03 fix(central): Etapa 2 tanda 2 - OTOS vel freshness (#21) + honestidad de contrato (#16/#19/#41/#23)
    Compile-verified (src/central no host-testeable: usa Arduino/millis, fuera del harness). central_robot1+2 compilan; suite host 322/0 intacta.
    #21 OTOS vel con timestamp propio (world_model) + gateo en strategy KICKOFF/APPROACH: si la vel no esta fresca, no cancelar deriva con dato viejo (degradacion conservadora). #16 nota: accessors expuestos pero NO consumidos por la FSM (trampa para equipo nuevo). #19 referee_cmd marcado reservado/dead - contrato real binario por GPIO. #41 comentario honesto de motors_brake (coast vs brake depende del chip, pendiente #11). #23 semantica de frames_lost (se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
    [comm_down.cpp, motors_zircon.h, strategy.cpp, world_model.cpp, world_model.h]
2026-06-03 fix(down): otos — salud I2C real + fusion heading/slip pura + clamp telemetria (audit 2026-06-03, #6 #7 #13 #14 #15 #17 #19 #20)
    #6/#15: otos_tick chequea el retorno I2C; maquina de salud pura (otos_health.h,
    histeresis+latch) baja ready y confidence cuando un OTOS muere mid-match (antes
    mentia 100/60). #7: heading dual por promedio vectorial (otos_fusion.h) — el viejo
    atan2(dy,sep) saturaba en +-90. #20: slip sobre VELOCIDADES restando |w|*sep (antes
    crecia por drift). #14: omega/vx/vy saturan a int16 (telemetry_sat.h) — antes +6 rad/s
    wrappeaba de signo. #13: otos_reset re-detecta sin recalibrar (recuperacion en caliente).
    #19: sacado el handler CENTRAL_CALIB_LINE del enlace TOP (cal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
    [comm_top.cpp, otos.cpp, otos.h]
2026-06-03 fix(down): main-timing — enviar linea ANTES de otos_tick (audit 2026-06-03, #24)
    Reordena loop(): comm_central_send_line_urgent (200Hz, path de seguridad de borde)
    va ANTES del otos_tick bloqueante (~3-4ms I2C), para no agregarle esa latencia al
    frame de linea. Reorden de operaciones independientes (seguro). La mitigacion
    completa del jitter de 1kHz (bajar tx I2C del OTOS) queda para otro cambio.
    Compila down. NO validado en HW -> banco.
    Requested-by: Maria Viollaz (en la compu de Gustavo @gviollaz)
    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
    [main_down.cpp]
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2026-06-03 feat(vision): tests host del parser de camara + robustez deteccion N6 + kit calib + analisis eje X
    - test_cameras_parser (nuevo, 10 tests): cobertura host del parser src/top/cameras.cpp
    (decode, sentinel, caracterizacion del bug fantasma, resync, header-como-dato, reset).
    Unity-build (include del .cpp) sin tocar run-host-tests.sh ni mover a src/shared.
    - cam-frontal/trasera-n6.py: filtro de forma solo-pelota (is_ball_like por aspect/density,
    fail-open, flag BALL_SHAPE_FILTER), ROI opcional en None (verificar montaje en banco),
    fps en bring-up. Arcos sin filtro de forma. Contrato de 9 bytes INTACTO.
    - calib-lab-n6.py (x2 sincronizados): cicla 3 colores sin re-Run, draw_string, margene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
    [calib-lab-n6.py, cam-frontal-n6.py, cam-trasera-n6.py]
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2026-06-04 feat(top-sensores): ToF stale timeout + watchdog HW (WDOG1) + comentarios al dia
    P1-TOF-STALE: frescura por sensor + timeout 250ms -> un ToF colgado en 80mm expira a TOF_NO_READING en vez de propagarse para siempre como min_obstacle fantasma. Logica pura tof_fresh_or_no_reading host-testeada (10 tests, wrap-safe). P1-WDT: WDOG1 del IMXRT (1s) armado al final del setup (tras los begins lentos ~40s) + feed cada loop -> auto-reset si el I2C se cuelga (sin lib externa: WDT_T4 no vendoreada, Wire.setWireTimeout no existe en el core Teensy). P2-DOC: comentarios stale corregidos (sensors_tof 4 ToF, sensors_imu boot ~10s). El WDT y el glue son Arduino-only -> needs_bench (0 resets espurios en 30min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
    [main_top.cpp, sensors_imu.cpp, sensors_tof.cpp, sensors_tof.h]
2026-06-04 feat(top-enlaces): debounce arbitro + SEQ frames_lost + RX ring 512B
    P1-ARB-DEBOUNCE: debounce por estabilidad (40ms) del GPIO del arbitro (pines 5/6 OR) -> un glitch de EMI de motores ya NO da START espurio en STOP (moverse en STOP es penalizable); fail-safe preservado (boot/cable desconectado -> STOP). P1-SEQ-LINK-HEALTH: consumo de f.seq en RX + contador frames_lost por enlace (COMM/DOWN/CENTRAL); documentado que frames_lost solapa con crc_errors (huecos_de_cable ~= frames_lost - crc_errors). P0-LOOP-HCSR04 (parcial): addMemoryForRead(512B) en el enlace DOWN->TOP para que el ring RX no se desborde en silencio cuando el loop se bloquea (pulseIn HC-SR04 ~12ms). Logica pura (debounce FSM + s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
    [comm_arbiter.cpp, comm_arbiter.h, comm_central.cpp, comm_central.h, comm_down.cpp, comm_down.h]
2026-06-04 feat(gk+camara): activar bt_classify threat + telemetria CRC camara + cleanup docs
    bt_classify THREAT activado en GK_INTERCEPT: ante tiro al arco propio (BT_TO_OWN_GOAL) el arquero anticipa mas (lookahead/max_lead x1.5) y reacciona con mas KP (x1.5); fallback EXACTO byte-identico cuando no hay amenaza / velocidad N/A / sin arco rival visible (verificado por tests). Logica pura gk_threat_response host-testeada. Telemetria: cameras_runtime expone crc_errors/resync agregados (front+back) del parser v2 + diag_top_cameras los imprime por UART para contar errores de enlace de camara en banco. Cleanup: dead-code banner en motion_target, banners de colision de ID TASK-204 en los 2 team-tasks. +1 tes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
    [cameras_runtime.cpp, cameras_runtime.h, diag_top_cameras.cpp, motion_target.cpp, strategy.cpp]
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2026-06-04 fix(firmware): quick-wins seguros del analisis paralelo (SC-01/SI-03/SB-3/VIS-02)
    Aplica los 4 fixes marcados "seguro pre-Incheon" y gate-verificables del
    analisis 2026-06-04 (research/in-progress/2026-06-04-analisis-paralelo-modulos.md).
    Solo modulos puros + camaras; NO toca glue Arduino sin compilar ni strategy.cpp.
    - SC-01 (shared/pids.cpp): guarda NaN en omega_degps_to_centideg. Un heading
    corrupto del BNO (NaN) ya no es UB en el cast a int16 (omega no-finito => 0).
    + 2 tests (NaN => 0, +-Inf satura).
    - SI-03 (shared/proto.cpp): default: reset() en FrameDecoder::feed, red de
    seguridad ante estado corrupto (inalcanzable hoy, mantenibilidad).
    - SB-3 (shared/cameras_fusion.cpp): medi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
    [cam-frontal-n6.py, cam-trasera-n6.py, cameras_fusion.cpp, pids.cpp, proto.cpp]
2026-06-04 feat(diag): observabilidad de glue del analisis paralelo (CC-01 + SI-02)
    Aplica los 2 fixes de glue Arduino marcados seguros, verificados por COMPILACION
    (no por host: el runner solo linkea src/shared). Ambos aditivos, comportamiento
    identico en operacion normal:
    - CC-01 (central/comm_top.cpp+.h, main_central.cpp): contador
    g_snapshot_size_rejects que cuenta WorldSnapshots con payload_len != sizeof
    (una placa con schema viejo tras un deploy wire-breaking v2/v3). Expuesto en la
    telemetria DIAG como badsz=N. Sin esto, en el pit un schema desfasado se ve
    IGUAL que "sin link" -> diagnostico a ciegas.
    - SI-02 (top/comm_central.cpp+.h): gatea Serial4.write por availableForWrite
    antes de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
    [comm_central.cpp, comm_central.h, comm_top.cpp, comm_top.h, main_central.cpp]
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2026-06-04 mejoras(audit): legibilidad + correctitud de codigo y docs (workflow 4 tracks)
    Lote SEGURO de la auditoria paralela 2026-06-04 (tracks: audit critico,
    arquitectura de docs, legibilidad, pendientes). Gate: host 550/40/0, 5 placas OK.
    Codigo (host-verificado):
    - POSE-01: corrige ejes invertidos en pose_fusion (field_width=1820 X lateral,
    field_height=2430 Y arco-a-arco) + ajusta test_pose_fusion. Modulo no cableado.
    - POSE-03: simplifica rama muerta del tie-break en imu_fusion (else pick=a).
    - DC-2: helper puro sat_u8 (NaN/negativo/techo) + uso en down/comm_top.cpp
    (slip_estimate) + 3 tests (547->550).
    Codigo (compile-verificado, behavior-neutral):
    - TOPHAL-01: static_assert(NUM_TOF==4)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
    [cameras_runtime.cpp, comm_arbiter.h, comm_central.cpp, comm_top.cpp, imu_fusion.cpp, main_central.cpp, pinout_common.h, sensors_tof.cpp]
2026-06-04 feat(diag): diag_cam_acceptance — aceptacion de vision recalibrada en banco (TASK-022)
    Sketch de banco NUEVO que valida que la camara (ya recalibrada LAB+homografia)
    reporta la pelota en la posicion correcta. Reusa el PARSER DE PRODUCCION
    (src/top/cameras.cpp, CameraParser v2), asi que valida de paso el contrato de
    camara v2 (11 B, CRC8 + sentinel + END).
    - Lee las 2 camaras (Serial3 frontal / Serial5 trasera @19200) e imprime pelota
    (raw/mm/angulo/distancia) + salud del enlace (pkts/crc/resync) + arcos visibles.
    - Modo aceptacion PASS/FAIL: pelota a una distancia MEDIDA -> se escribe los cm
    por serial -> chequea contra tolerancia (la mayor entre +-5cm y +-10%). f/b/p/r.
    - Ataca el bl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
    [diag_cam_acceptance.cpp]
2026-06-04 fix(central+docs): CC-04 (tick void) + Serial1->Serial7 en CONTRATO-DATOS-CENTRAL
    Items menores de escritorio del backlog de auditoria:
    - CC-04: comm_top_tick()/comm_down_tick() de CENTRAL ahora son void (ningun caller
    usaba el contador de frames procesados; main_central y los diags los llaman como
    sentencia). Compila central_robot1/2 + diag_central_drive/arbitro_strafe.
    - Docs: 3 menciones de comm_top.cpp como "Serial1" corregidas a Serial7 en
    CONTRATO-DATOS-CENTRAL.md (resuelve la contradiccion interna; el doc ya decia
    Serial7 en sus secciones primarias). Las de comm_down.cpp quedan en Serial1 (correcto).
    [comm_down.cpp, comm_down.h, comm_top.cpp, comm_top.h]
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2026-06-04 feat(port-2025): heuristicas portadas del campeon 2025 (deadzone/grace/clear_aim/roundness)
    Port de las heuristicas SEGURAS de los programas anteriores (analisis en
    research/in-progress/2026-06-04-estrategias-anteriores-plan-port.md). Todo
    gated/aditivo/fail-open => el binario de competencia NO cambia. Gate: 44 envs /
    624 tests / 0 fallos; 5 placas compilan; py_compile OK.
    - DEADZONE/BREAKAWAY PWM (Delantero 2025 IMPULSO_INICIAL + CA-01): helper puro
    apply_pwm_floor() en kinematics + aplicado en motors_apply_command +
    MOTOR_MIN_PWM / MOTOR_PWM_NOISE_THRESH = 0 en config_central (DEFAULT 0 = no-op
    => binario identico). +tests. El equipo sube el piso en banco (tipico 25-45)
    para el st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
    [cam-frontal-n6.py, cam-trasera-n6.py, clear_aim.cpp, clear_aim.h, config_central.h, kinematics.cpp, kinematics.h, motors_zircon.cpp]
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2026-06-05 chore(compat): auditoria de compatibilidad — deprecar 2025+diags cumplidos, banners en pack-snapshots, fix comentarios stale
    Mueve programas 2025 incompatibles de raiz (robot-delantero/arquero, zirconLib, vision v1) a software/_deprecated-2025/ con README de advertencia (kicker, parser camara 9B v1, BNO local, sin framing proto.h).
    Mueve 7 diags ToF de bring-up CUMPLIDOS + diag_top_bno (arquitectura I2C vieja Wire1/24-25, BNO derecho 0x29 fallado) a _deprecated/ y quita sus 9 envs de platformio.ini (59->50). Reemplazos vigentes: diag_top_tof_quad_live, diag_bno_dual_live, diag_bno_left.
    Agrega ~75 banners 'SNAPSHOT CONGELADO 2026-05-24 — NO FLASHEAR' a los pack-snapshots (hardware/elec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
    [ball_velocity.h, behind_ball.cpp, behind_ball.h, calib_storage.cpp, calib_storage.h, cam-frontal-n6.py, cam-trasera-n6.py, cameras_fusion.cpp]
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2026-06-05 fix(reliability+docs): auditoría coach 2026-06-05 batch 1 — heading_valid en vivo, colchones RX, test omega-clamp + correcciones de docs de contrato
    R1 (HIGH reliability): heading_valid del WorldSnapshot ahora sale de la fusión EN VIVO (sensors_imu_get_heading_valid → g_fusion.fused_valid), no del readiness al boot. Byte-idéntico en op normal, pero cierra el agujero: si el único BNO se cae/congela en runtime, CENTRAL deja de navegar con heading muerto. Es la plomería que hace efectivo al freeze-detector (R3) cuando se active en banco.
    Confiabilidad: addMemoryForRead (colchón RX) en central/comm_down.cpp (Serial1, recibe el freno de borde a 200Hz) y en top/cameras_runtime.cpp (Seri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
    [cameras_runtime.cpp, comm_down.cpp, config_central.h, main_top.cpp, sensors_imu.cpp, sensors_imu.h, types.h]
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2026-06-05 fix(reliability): auditoría coach 2026-06-05 batch 2 — watchdogs HW gated, loop monitor, gk-clamp defensivo, CPU línea, helpers + tests
    Workflow paralelo de 4 tracks, todo GATEADO/ADITIVO (binario de competencia byte-idéntico hoy). R2 — watchdog de hardware WDOG1 portado a CENTRAL (main_central.cpp, #ifdef CENTRAL_ENABLE_WDT) y DOWN (main_down.cpp, #ifdef DOWN_ENABLE_WDT), default OFF: si el loop del master de motores (o DOWN) se cuelga, auto-resetea en vez de dejar los motores corriendo. Se activa tras validar boot en banco.
    loop_monitor.h (módulo PURO + test_loop_monitor): supervisor de loop-time (max/EMA, wrap-safe) cableado en main_central para detectar degradación antes del cu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
    [comm_down.cpp, config_central.h, config_down.h, drive_straight.h, line_geometry.h, line_ring.cpp, main_central.cpp, main_down.cpp]
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2026-06-05 fix(reliability+test): auditoria coach 2026-06-05 batch 3 — tail de escritorio (puro/gateado, gate 652/47/0)
    Workflow multi-agente, dueno unico por archivo, verificacion central (gate host).
    Cero cambio en el binario de competencia; sin tocar strategy.cpp/types.h/platformio.ini.
    - test(contract): golden round-trip + offsets del WorldSnapshot v3 (test_central_contract).
    Atrapa reorders de campos del mismo tamano que static_assert(sizeof==31) no detecta
    (verificado con mutation test swap ball_x/ball_y -> falla). Cierra worldsnapshot/snapshot-v3
    no-golden-roundtrip-test.
    - fix(localization): normaliza el wrap del heading de salida (bno-offset -> (-18000,18000])
    y satura los casts/pro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
    [config_central.h, strategy_transitions.h]
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2026-06-06 banco 2026-06-06: linea DOWN valid=1 + line-avoidance del arquero
    - comm_central.cpp: calib_min_margin 120->40 (el 120 era inalcanzable para los
    sensores reales de ROBOT1; valid=1 estable validado en banco)
    - diag_down_calibracion.cpp: MIN_MARGIN 80->40 (alineado con el firmware)
    - diag_central_line_sweep.cpp: arranque/stop por ENTER, heading-hold usando el
    OTOS de la base (DOWN), centrado y rumbo con signos corregidos, y line-avoidance
    por angulo de escape (huye siempre del lado opuesto a la linea)
    Validado en banco por Maria (ROBOT1) 2026-06-06.
    [comm_central.cpp, diag_central_line_sweep.cpp, diag_down_calibracion.cpp]
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2026-06-07 feat: modo PRUEBA fase 1 (nucleo puro) + estado de calib en la app + OS de calibracion (r-d-2027) + checklist Incheon
    Workflow de 4 hilos: (1) src/shared/bench_mode.{h,cpp} + test/test_bench_mode (maquina de estados PURA del modo PRUEBA/COMPETENCIA fail-safe: heartbeat+timeout+magic, revierte a COMPETENCIA; 10 tests incl. 2 ADVERSARIALES; gate 52/727/0). Cero glue: no toca ningun binario de competencia. (2) tools/monitor-base: boot_status.py + tests; las 3 GUIs anteponen '[Calibracion: EEPROM / FAIL-SAFE]' a la barra de estado para tener certeza de que cargo cada placa. (3) r-d-2027/decisions: decision de diseno del OS de calibracion (descentralizado + config-as-code + fail-safe + por-ToF in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
    [bench_mode.cpp, bench_mode.h]
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2026-06-07 fix(arquero): GOTO_LINE traslada SIN rotar (omega=0) — la orientacion la hace PATROL
    El GOTO_LINE ponia omega de orientacion-al-frente ademas de la diagonal: la omega domina la cinematica (el termino omega*R se suma IGUAL a las 3 ruedas) y el robot 'giraba' en vez de trasladar. Ahora GOTO_LINE es traslacion pura (diagonal atras-derecha) y PATROL orienta al llegar. NOTA: la traslacion sigue dependiendo de WHEEL_ANGLES_DEG (tentativo / TASK-101); validar con diag_central_strafe_robot1.
    [strategy.cpp]
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2026-06-08 docs(vision): fix comentario header trasera (usa la H compartida, no 'su propia H')
    [cam-trasera-n6.py]
2026-06-08 fix(top/ROBOT1): deconflict BNO/ToF en bus Wire + detector de freeze ON -> arregla yaw congelado en produccion
    Banco 2026-06-08: el BNO de ROBOT1 comparte el bus Wire con los 4 ToF; en produccion (loop mas cargado que el diag) el read del BNO caia pegado a un read de ToF y el yaw se CONGELABA (mismo mecanismo que el band-aid de 20Hz). HW sano (diag_top_all lo prueba); ROBOT2 ya tiene el BNO en Wire1 (no aplica).
    main_top.cpp (gateado TOP_BNO_TOF_DECONFLICT, solo ROBOT1; ROBOT2 byte-identico via #else): corre el ToF primero y SALTEA el read del BNO en la pasada donde corrio un ToF -> el read del BNO queda aislado en el bus (sigue a 20Hz, solo se corre la fase). platformio.ini [env:top_robot1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
    [main_top.cpp]
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2026-06-08 experiment(top/ROBOT1): noInterrupts() alrededor del read del BNO (hipotesis: interrupciones del ultrasonico/UART lo corrompen)
    Hipotesis Gustavo: el read multi-byte del BNO se corrompe en main_top por las interrupciones del HC-SR04 / UARTs (carga alta) y por eso anda en el diag (carga baja) pero no en produccion. Flag TOP_BNO_READ_NOINTERRUPTS (ROBOT1, gateado): envuelve los 3 reads del BNO en noInterrupts()/interrupts() (~2ms/tick @20Hz). Trade-off: puede perder algun byte de UART (recuperable por CRC; el DOWN puede mostrar mas seqGap). WDOG1 1s de backstop. Si destraba el yaw -> esa era la causa; si no -> fix de fondo BNO a bus aparte (Wire1).
    Gate host 742/53/0 (no toca src/shared). NO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
    [sensors_imu.cpp]
2026-06-08 revert(top/ROBOT1): quitar noInterrupts del BNO (probado, NO destrabo el yaw)
    El experimento noInterrupts no devolvio el heading (hdg=0/flags=0x0 igual). Junto con 100kHz+20Hz+deconflict, los 4 band-aids de software fallaron -> NO eran las interrupciones; es la contencion del BNO055 en el bus Wire compartido bajo la carga de main_top. Se quita el flag + el codigo (con IRQ off un read trabado podria colgar el loop). FIX DE FONDO pendiente: BNO a bus I2C aparte (como ROBOT2).
    [sensors_imu.cpp]
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2026-06-08 fix(central): slow-mo a 0.7 (0.4 quedaba bajo el stiction del motor -> no se movia)
    [motors_zircon.cpp]
2026-06-08 fix(central): WHEEL_ANGLES calibrados con disposicion fisica real {330,210,90} (arregla los circulos)
    Gustavo dio la disposicion fisica: M1=delantera IZQUIERDA, M2=delantera DERECHA, M3=trasera (omni 120 grados), los 3 motores giran horario desde el centro. La formula inverse_kinematics usa theta=posicion desde +X antihorario: M1=150, M2=30, M3=270. Como los motores giran horario (opuesto a CCW de la formula), +180 -> {330,210,90}. El viejo {60,-60,180} estaba expresado en eje +Y -> la formula usa +X -> daba circulos (strafe salia como rotacion). Tambien se corrigio el comentario que tenia M1/M2 izq/der al reves.
    Gate host 742/53/0. ⚠️ VERIFICAR SENTIDO en banco (diag_central_strafe_rob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
    [config_central.h]
2026-06-08 fix(central): MOTOR_MIN_PWM=40 (piso de PWM) — en strafe las ruedas delanteras quedaban bajo el stiction (~19 PWM) y no arrancaban
    Con {330,210,90} el strafe anda (M3 atras se mueve) pero M1/M2 (delanteras) reciben la mitad del PWM (~19, geometria del strafe a 60 grados) y no arrancan. MOTOR_MIN_PWM=40 (estaba 0/OFF) las eleva por encima del arranque. Trade-off conocido: el piso sobre-excita las delanteras (necesitan 19, reciben 40) -> puede meter algo de rotacion en el strafe (el PID de linea lo corrige; fix de fondo = mejores motores).
    [config_central.h]
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2026-06-08 refactor(central): MOTOR_MIN_PWM POR RUEDA (int[3]) reemplaza piso unico + MOTOR_GAIN
    Idea de Gustavo en banco: el piso (PWM minimo de arranque) depende de la friccion de cada rueda, asi que debe ser por rueda. Las delanteras van OBLICUAS (60 grados, rodillos de costado) -> mas friccion -> piso mas alto (70). La trasera va PARALELA al strafe -> arranca con menos -> piso mas bajo (42); con el mismo piso que las delanteras se adelantaba y rotaba. Reemplaza el piso unico (int) + la ganancia por rueda (MOTOR_GAIN) por una sola perilla: MOTOR_MIN_PWM[3] por-robot (ROBOT1={70,70,42}, ROBOT2={0,0,0} neutro). Mismo efecto que floor70+gain0.6 en el strafe, pero un solo concepto y fisicamente correcto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
    [config_central.h, motors_zircon.cpp]
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2026-06-08 feat(motion): Capas 1-2 del control de movimiento 2026 (modulos PUROS host-testeados) + plan
    Modulos nuevos en src/shared (PUROS, sin Arduino, tiempo/estado como parametros, host-testeables; NADIE los llama aun -> binario de competencia IDENTICO): gk_motion_speed (Capa 1: cuenta inversa PWM-objetivo->velocidad de comando + clamp al cap ~150; reproduce el ratio arquero 2025 front55/rear110 sin tocar la cinematica), motor_kickstart (Capa 2a: impulso inicial anti-inercia x1.8 por 40ms capeado a 153, gateado), motor_brake (Capa 2b: plugging/reversa x1.1=275/187 capeada a 150 + freno anticipado de la trasera 66ms x VEL/100). Tests Unity: +3 envs / +26 tests -> gate host 56 envs / 768 tests / 0 fa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
    [gk_motion_speed.cpp, gk_motion_speed.h, motor_brake.cpp, motor_brake.h, motor_kickstart.cpp, motor_kickstart.h]
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2026-06-10 docs+config: corregir Wire1->Wire2 del 2do BNO del TOP + convencion BNO primario(Wire2 solo)/secundario(Wire+ToF)
    Banco robot2 2026-06-09 confirmo (diag_top_i2c_scan, commit 9da8e9e) que el 2do BNO esta en Wire2 (24/25, LPI2C4), NO Wire1 (el repo los confundia; Wire1=16/17). Workflow de 3 agentes corrigio 25 docs+mirrors (dejando el Wire1 LEGITIMO del DOWN/OTOS intacto) + se documento la convencion: BNO PRIMARIO = el SOLO en Wire2 (sin ToF, no se congela) / SECUNDARIO = el que comparte Wire con los 4 ToF. Config vivo: robot2.h IMU_BNO_BUS {0,1}->{2,0} (idx0=PRIM Wire2, idx1=SEC Wire) + sensors_tof.h. PENDIENTE (proximo, gateado ROBOT2): el READ real en src/top/sensors_imu.cpp (leer el primar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
    [config_top.h, main_top.cpp, robot2.h, sensors_imu.cpp, sensors_imu.h, sensors_tof.h, types.h]
2026-06-10 fix(top): renombrar WIRE1_SCL/SDA_PIN(24/25) -> WIRE2_* + nota types.h (24/25 = Wire2 LPI2C4, no Wire1)
    Cierra el mislabel Wire1<->24/25 del lado TOP en el codigo vivo (pinout_common.h + types.h). Las constantes WIRE1_SCL_PIN/WIRE1_SDA_PIN NO tenian NINGUN consumidor (grep en todo el arbol Soccer 2026 = solo la definicion) -> rename byte-identico garantizado. types.h: la nota era del BNO bus del TOP (24/25), corregida a Wire2 nativo (sin remap). NO se toco el Wire1 LEGITIMO del DOWN/OTOS (16/17). ROBOT1 (top_robot1) byte-identico: solo comentarios + constante muerta renombrada, cero cambio de comportamiento. Gate host VERDE (types.h en src/shared recompila igual). ⚠️ Confirmar byte-diff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
    [pinout_common.h, types.h]
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2026-06-10 fix(central): motores ROBOT2 calibrados en banco - pines IGUALES a R1 (no rotados) + MOTOR_INVERT neutro {+1,+1,+1}
    Banco 2026-06-09 (Gustavo, diag_central_motors en robot2 armado): M1=U5(2/5/3)=delantera-IZQUIERDA, M2=U17(8/7/6)=delantera-DERECHA, M3=U7(11/12/4)=TRASERA, los 3 HORARIO desde el centro con drive directo. Dos correcciones: (1) la suposicion 'drivers ROTADOS, U17=motor 1' (heredada del delantero 2025) es FALSA en robot2 2026 -> tabla de pines = R1; (2) el U17 de la Zircon de R2 NO esta invertido por HW (el de R1 si) -> MOTOR_INVERT={+1,+1,+1} (diferencia real entre placas). WHEEL_ANGLES {330,210,90} ya era comun y aplica igual (misma disposicion fisica). MOTOR_MIN_PWM de R2 que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
    [config_central.h, robot2.h]
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2026-06-10 feat(central): rol ARQUERO sobre hardware de robot2 (robot1 en reparacion) - envs central_robot2_arquero(+_slow)
    Robot1 necesita reparacion -> el arquero se prueba en el cuerpo de robot2. El rol estaba atado a -DROBOT1, que tambien selecciona el HW de R1 (MOTOR_INVERT {+1,-1,+1}) -> flashear central_robot1 en robot2 inviertiria el M2 (la Zircon de R2 no tiene la inversion HW). Fix: override gateado -DCENTRAL_FORCE_ROLE_GOALKEEPER en main_central.cpp (glue, no toca strategy.cpp; default OFF -> binarios de competencia identicos) + envs central_robot2_arquero y central_robot2_arquero_slow (heredan TODO el hardware validado de central_robot2 y solo fuerzan el rol GK). TOP/DOWN sin cambios (top_r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
    [main_central.cpp]
2026-06-10 fix(central): GOTO_LINE recto atras (el diagonal daba circulos con los pisos) + plan paso-a-paso arquero-en-robot2
    Banco 2026-06-09 (Gustavo, central_robot2_arquero_slow): GOTO_LINE diagonal daba CIRCULOS y al detectar linea movimiento erratico a gran velocidad. Revision critica 3 lentes: CAUSA 1 (diseno) = patrullar con setpoint cross_track=0 (centrado SOBRE la linea) dispara EV_IMMINENT_EXIT (>=6 sensores) -> flapping PATROL<->LINE_AVOID violento sin histeresis; LineStatusV2 no distingue linea del area vs cancha. CAUSA 2 (matematica) = velocidades GK 150-250 mm/s bajo los pisos {70,70,107} -> direcciones aplastadas (x3.7-5.4 con slow-mo); minimo fiel ~420 mm/s; omega clamp 327 domina a vx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
    [strategy.cpp]
2026-06-10 feat(central): arquero Fase 0 completa - gyro hold (cascada de orientacion) + fix de eje cross_track->vy + anti-flapping + velocidades fieles (diseno Gustavo)
    Implementa el diseno de Gustavo (banco 2026-06-09): (1) GYRO HOLD - cascada de orientacion gk_orient_omega: arco propio visible -> de espaldas al arco (absoluto); solo heading valido -> PID al rumbo 0 del boot (mirando al frente SIN depender de la camara); nada -> w=0. Aplica en GOTO_LINE (recto-atras estabilizado por gyro: inestable por geometria con trasera=0), PATROL e INTERCEPT. Tope w<=10 grados/s (GK_ORIENT_OMEGA_MAX): con los pisos, w>11 hace saltar la trasera de 0 a 107 PWM (bang-bang); a <=10 la trasera queda bajo el umbral de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
    [strategy.cpp]
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2026-06-10 tune(central): trims anti-deriva del retroceso del arquero (banco: deriva suave a la derecha yendo atras)
    La deriva yendo atras tiene 2 componentes: (a) TRASLACIONAL (desliza de costado mirando al frente - el gyro NO la ve; asimetria de fuerza M1 vs M2) -> GK_GOTO_LINE_VX_TRIM_MM_S = -15 (empuje suave a la izquierda; tope fisico +-19 mm/s: mas y la componente de la trasera supera el umbral de ruido 5 PWM -> el piso la dispara a 107 = patada); (b) DE RUMBO (rota despacio, PID topeado a 10 grados/s corrige con atraso) -> GK_GOTO_LINE_HEADING_TRIM_DEG (default 0; sesga el rumbo objetivo, + = CCW). gk_orient_omega gana el parametro target_trim_deg (default 0 -> resto de los call sites identicos)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
    [strategy.cpp]
2026-06-10 fix(central): retroceso del arquero a GYRO PURO con bail-out 45 grados (banco: hacia una J/U) + vx-trim a 0 para aislar variables
    Banco 2026-06-09 4ta pasada: el retroceso empezo a hacer J/U creciente (antes era deriva suave). Diagnostico: una curva CRECIENTE = PID con realimentacion positiva (signo del heading de robot2 SIN confirmar) o target basura (la cascada podia perseguir el angulo del arco propio de la camara TRASERA - jamas validado - durante la reversa). Fix: (1) nuevo gk_gyro_hold_omega = rama 2 pura (solo gyro, nunca camara) para AMBAS fases de GOTO_LINE; (2) BAIL-OUT: si |error de rumbo| > 45 grados -> w=0 (un error que crece con el PID activo = signo invertido/heading basura ->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
    [strategy.cpp]
2026-06-10 fix(central): orientacion por camara DESHABILITADA en el arquero (GK_CAMERA_ORIENT_ENABLED=false) - el signo del gyro R2 se confirmo CORRECTO en banco
    Banco 2026-06-09: girado a la IZQUIERDA a mano el hdg SUBE (+62) = signo del heading de robot2 CORRECTO (CCW+; HEADING_SIGN=-1 vale). Por descarte, la J/U del retroceso la causaba la rama (1) de la cascada: el target derivado del angulo del ARCO PROPIO visto por la camara TRASERA (jamas validado en banco; la homografia se calibro para DISTANCIAS de la frontal). Fix: GK_CAMERA_ORIENT_ENABLED=false -> el arquero (GOTO_LINE+PATROL+INTERCEPT) se orienta SOLO por gyro (tracking confirmado suave +-90 por la cadena TOP->CENTRAL). Re-habilitar tras va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
    [strategy.cpp]
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2026-06-10 feat(central): FIX DE FONDO de los pisos - escalado UNIFORME + eficiencia por rueda (banco: el arquero perdia el frente patrullando)
    Banco 2026-06-09: a velocidad de patrulla el clamp por-rueda dejaba las 4 ruedas clavadas en su piso -> la correccion de gyro (w<=10) se COMIA entera -> cero autoridad de rumbo -> el arquero perdia completamente el frente y terminaba yendo a cualquier lado. FIX ESTRUCTURAL (F0.e del plan): modulo PURO motor_floor_scale (h/cpp + 7 tests verdes): (1) eficiencia relativa por rueda MOTOR_EFF_X100={100,100,131} (derivada del banco R2: strafe derecho con PWM 107/70=1.53 cuando la cinematica pide velocidad 2:1 -> trasera 1.31x mas eficiente); (2) piso por ESCALADO UNI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
    [config_central.h, motor_floor_scale.cpp, motor_floor_scale.h, motors_zircon.cpp]
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2026-06-10 fix(central): floor_scale - las componentes AUXILIARES no definen el escalado (banco: latigazos girando a lo loco) + delay de arranque 2s
    Banco 2026-06-09 (4ta iteracion arquero): tras detectar la linea giraba sobre su eje varias veces a maxima potencia. BUG en la politica de escalado uniforme: la componente AUXILIAR de omega en la trasera durante el avance (~14 PWM, sobre el ruido pero lejos de su piso 107) exigia k~8 -> el cap termico recortaba -> latigazo a maxima potencia con giro (limit cycle del PID sobre planta no lineal). FIX: solo las ruedas PRINCIPALES (>=35% de la mayor) definen k; las auxiliares que no llegan a su piso van a 0 (su aporte lo llevan las principales con proporciones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
    [motor_floor_scale.cpp, strategy.cpp]
2026-06-10 fix(central): OMEGA_SIGN=-1 - el termino de giro estaba INVERTIDO (causa raiz de las J/U/circulos) + tope de giro en CLEAR
    HALLAZGO CLAVE del log de banco 2026-06-09 (monitor CENTRAL): durante GOTO_LINE el hdg fue -3.7 -> -71.5 CON el gyro-hold activo y se clavo justo en el bail-out de 45 = firma inequivoca de REALIMENTACION POSITIVA. Causa raiz: el +180 sumado a WHEEL_ANGLES corrige la traslacion (sin/cos cambian de signo) pero el termino de giro omega*R NO depende del angulo -> quedo sin corregir: con motores horario-desde-el-centro, omega positiva (CCW) producia rotacion fisica OPUESTA -> todo PID de rumbo amplificaba el error. Explica las J/U/circulos del dia y retroactivamente parte de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
    [config_central.h, motors_zircon.cpp, strategy.cpp]
2026-06-10 feat(central): env central_robot2_arquero_patrol (-DGK_IGNORE_BALL) - validar la patrulla sin que la pelota secuestre el test
    Banco 2026-06-09 (post OMEGA_SIGN): el fix del signo FUNCIONA (retroceso -14 max vs -71 antes, recupera hacia 0) pero el log mostro PATROL->CLEAR->INTERCEPT en loop: la pelota visible (real o falso positivo naranja) secuestra el test de patrulla, el rumbo queda a +-90 de las maniobras de despeje y el strafe robot-frame sale adelante/atras en el campo. Nuevo env de banco con -DGK_IGNORE_BALL (PATROL nunca transiciona a INTERCEPT) para validar retroceso+despegue+patrulla+limites de pose aislados; la prueba CON pelota sigue en central_robot2_arquero. Gate host VERDE; pio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
    [strategy.cpp]
2026-06-10 feat(central): PATRULLA v3 SEGMENTADA mover-parar-corregir (banco: el strafe continuo acumulaba yaw ~80 grados/s imbatible en movimiento)
    Log de banco 2026-06-09 (env _patrol, sin pelota): durante PATROL el hdg giro continuo horario ~80 grados/s (+20->-72->+144->+49->-60 con wrap) = yaw FISICO del strafe sostenido (sesgo del mix de pisos + reversas), imposible de pelear con correccion en movimiento (tope 40). El patron VALIDADO del banco (diag de strafe 'anda bien') era MOVER-PARAR-MOVER. PATROL v3: tramo de strafe 1.2s (hold suave + limites por pose cortan el tramo) -> freno 300ms (mide rumbo QUIETO, re-arma el impulso) -> si quedo chueco >15 grados: PULSOS de rotacion pura (3ms/grado, 60-2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
    [strategy.cpp]
2026-06-10 fix(central): centro de patrulla AUTO-CAPTURADO al llegar al puesto (banco: dos tramos al mismo lado + giro - la ventana fija 910 no coincidia con la cancha)
    Banco 2026-06-09 (patrulla v3 ya lateral): los tramos salian SIEMPRE al mismo lado + giros entre medio. Causa: la ventana de patrulla con centro hardcodeado x=910 no coincide con la x real del puesto en la cancha de Gustavo -> el robot siempre se creia fuera de la ventana por el mismo lado -> direccion identica cada tramo. Fix: el centro se AUTO-CAPTURA con la x de la pose al terminar el posicionamiento (fin de GK_ADVANCE: recien despegado de SU linea frente a SU arco) -> ventana centrada en el puesto real, cero calibracion de cancha; f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
    [strategy.cpp]
2026-06-10 feat(central): juez desde la PC - GO/STOP por monitor serie (banco: la app del juez no funciona)
    ENTER o 'g' = GO, 's' = STOP en el monitor USB de la CENTRAL. Gateado por CENTRAL_ENABLE_MANUAL_START, agregado SOLO a los envs de banco del arquero (central_robot2_arquero/_slow/_patrol). STOP devuelve la FSM a WAIT_START -> un 'g' nuevo re-corre la secuencia completa (delay 2s incluido) sin tocar la bateria. En COMPETENCIA el flag no se define: el GO/STOP real llega de la app del juez por GPIO 5/6 del TOP (OR fail-safe) -> snapshot -> CENTRAL. Doc: docs/pruebas-banco/ARQUERO-EN-ROBOT2-PLAN.md seccion 'Juez desde la PC'.
    [config_central.h, main_central.cpp]
2026-06-10 feat(central): patrulla v3.2+v3.3 PEGADA A LA LINEA (rebote lateral + re-enganche) + pulsos para heading lento
    Sesion de banco 2026-06-10 con Gustavo, iterado sobre hardware real. (1) REBOTE POR LINEA (v3.2): la patrulla mantiene el sentido tramo tras tramo y al tocar la linea blanca LATERAL que ve DOWN invierte; pose del TOP queda de limite secundario y tope de 3 tramos de fail-safe; el router avanzar-al-tocar solo dispara con linea ATRAS. (2) PEGADA A LA LINEA (v3.3): margen del avance post-linea 350->100 ms (con ~10 cm el anillo JAMAS veia la linea y el rebote no podia guiar) + sub-fase RE-ENGANCHE: si en una parada no ve la linea retrocede suave (200 mm/s, tope 700 ms) hasta re-verla. (3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
    [strategy.cpp]
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2026-06-10 perf(top): ToF round-robin - UN VL53L7CX por tick, no los 4 (loop del TOP ~6 Hz -> esperado ~20-25 Hz)
    MEDIDO en banco 2026-06-10 (Gustavo, panel [TOP] de robot2): loop +3 por linea de 500 ms = ~6 Hz, contra cientos de disenio. Causa: los 4 getRangingData() del VL53L7CX en la misma pasada — cada uno trae un bloque grande de resultados por Wire a 100 kHz (decenas de ms) ~160 ms bloqueado por vuelta. Efectos medidos: WorldSnapshot a ~4 Hz en la CENTRAL (heading 250-500 ms viejo -> ping-pong de pulsos del arquero, J/U de reversa) + resyncs de camaras (RX rozando overflow). Fix: round-robin 1 sensor por tick (TOF_TICK_INTERVAL_MS=30) -> cada sensor se refresca cada ~120 ms (ranging interno 15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
    [sensors_tof.cpp]
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2026-06-10 docs: revision integral coach 2026-06-10 - 14 docs corregidos + 2 TASKs nuevas + reporte completo en journal
    Revision multi-agente (4 lentes + verificacion adversarial de bugs). CORREGIDO (inconsistencias doc vs codigo, verificadas una por una): CLAUDE.md (worktrees: mergear en soccer-main, el dir historico quedo en agente/vision - trampa real verificada con git worktree list), ESTADO-ACTUAL (lee 1 ToF -> 4; HAL Sprint B resuelto), RUNBOOK 3.2 (motores R2 validados), MAPA-CONEXIONES (camaras 9->11 bytes v2; OUT2 = OR no espejo), MOTION-CONTROL-PLAN (R2 superado), DOWN.md (margen 80->40), ENTREVISTA-PREP (pisos {70,70,42}->{70,70,107}), README (arbol software/ real), REFERENCIAS-POR-ROBOT (do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
    [main_top.cpp, pinout_robot1.h, pinout_robot2.h]
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2026-06-10 fix(top): env top_robot1_oscint (BNO con oscilador interno) - reanimacion del BNO-L de robot1 congelado por golpe + estado HW de R1 documentado
    Banco escritorio 2026-06-10 noche (Gustavo, robot1): CAMARAS x2 ANDAN (v2 ya flasheado, pkts subiendo, resync=0, pelota trackeada por ambas) pero el BNO-L quedo con el yaw CONGELADO tras el golpe de hace unos dias: ackea I2C (imu_L=Y) pero hdg clavado en -160.2 girandolo a mano. El BNO-R sigue muerto de antes (esperado). Sospecha tecnica: setExtCrystalUse(true) en sensors_imu.cpp:200 conmuta al cristal externo de 32 kHz - si el golpe lo dano, la fusion pierde el reloj y las salidas se congelan con el chip vivo (falla clasica del BNO055). Nuevo flag g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
    [sensors_imu.cpp]
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2026-06-10 fix(top): deconflict BNO/ToF por TIEMPO (no por pasada) + plan B BNO1-en-Wire2 para robot1 (freeze NO era el chip)
    Banco demo 2026-06-11 manana: el BNO trasplantado desde robot2 (sano) congelo IDENTICO al original en robot1 -> el freeze es del ENTORNO del bus Wire compartido, no de los chips (el repo ya lo decia: platformio nota 2026-06-08 'el software no resuelve la contencion... fix de fondo: bus aparte'; el diagnostico golpe-mato-al-BNO de anoche queda en duda - retestear el viejo post-demo). Ademas el deconflict por-pasada quedo ROTO con el loop nuevo: a ~200k pasadas/s la 'proxima pasada' llega 5 us despues del ToF -> reads pegados igual. FIX A (software, en top_robot1 ya): cuarentena T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
    [main_top.cpp, sensors_imu.cpp]
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2026-06-10 feat(central): CAJA NEGRA de corridas - log completo 50 Hz en RAM + volcado CSV por USB (envs *_bb)
    Pedido Gustavo 2026-06-11: el delantero se mueve rapido y para todos lados, imposible diagnosticar a ojo y sin cancha. Disenio v1 (experimento de ingenieria, doc en docs/pruebas-banco/CAJA-NEGRA.md): ring buffer en RAM2/DMAMEM de la Teensy 4.1 (4500 muestras x 36 B ~ 158 KB = ultimos ~90 s a 50 Hz, CERO impacto en el loop de 100 Hz) con la cadena completa sensado->decision->actuacion: estado FSM, flags (match/snap/pelota/arco/heading/linea/imminent), heading, pelota x/y/vx/vy, angulo arco, comando vx/vy/omega, PWM REAL por motor (nuevo getter motors_get_applied_pwm, post-pisos/kickstart), angu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
    [blackbox.cpp, blackbox.h, main_central.cpp, motors_zircon.cpp, motors_zircon.h]
2026-06-11 fix(top): env top_robot2_pri (BNO primario-solo) - el soft-resync arrastro el primario sano hacia el secundario CONGELADO (banco R1 recableado)
    Banco 2026-06-11, robot1 recableado a arquitectura R2: el BNO secundario (Wire, comparte bus con ToFs) se congelo en produccion (-142.4) y el arbitro de deriva del imu_fusion eligio al sensor CONGELADO como referencia (un frozen es perfectamente estable) y re-alineo al primario sano hacia el valor muerto: hdg 0.0 -> -142.4 clavado tras '[IMU] soft-resync sensor 0'. BUG real del soft-resync (tema-a-analizar post-demo: detectar freeze ANTES de arbitrar deriva; el detector TOP_ENABLE_BNO_FREEZE_DETECT existe pero esta OFF por falsos-DEAD). Mitigacion pa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
    [sensors_imu.cpp]
2026-06-11 fix(central): ROBOT1 post-reparacion - M2 RECABLEADO DERECHO (MOTOR_INVERT {+1,-1,+1} -> {+1,+1,+1}) + pisos {70,70,107} validados en piso
    Banco nocturno 2026-06-10/11 (Gustavo, robot1 reconstruido, diag_central_arbitro_strafe_robot1 en piso real): (1) el M2/U17 quedo recableado DERECHO en la reparacion -> la compensacion historica -1 lo invertia (sintoma: las delanteras se cancelaban entre si, 'apenas se mueven y la trasera les gana'); invert ahora neutro {+1,+1,+1}, historia documentada por si se recablea como estaba. (2) Pisos: se probo 90/90/107 persiguiendo el sintoma del M2 (frente giraba: ratio 0.84 vs ideal 0.5) y se VOLVIO a {70,70,107} = mix validado de robot2, que con el M2 correg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
    [config_central.h]
2026-06-11 audit(global): M2 de R1 garantizado en TODOS los programas + barrida de 18 docs invertidos + logging v1.1 (caja negra emerg+metadata, analizador PC)
    Auditoria global 2026-06-11 (13 agentes + verificacion adversarial), pregunta de Gustavo: el error del M2 era puntual o general? VEREDICTO: puntual del cableado fisico, fix GENERAL via el embudo motors_zircon::apply_pwm_to_motor (todos los central_robot* y diags de strafe/arbitro/drive lo heredan) — con 2 excepciones de pines-directos corregidas: (1) diag_central_line_sweep::motor2() tenia el cruce INA/INB hardcodeado del cableado VIEJO de R1 (movia el M2 al reves en AMBOS robots con el hardware de hoy) -> motor2=espejo de motor1 + banner re-v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
    [blackbox.cpp, blackbox.h, config_central.h, diag_central_drive_straight.cpp, diag_central_line_sweep.cpp, diag_central_motors.cpp, main_central.cpp, motors_zircon.cpp]
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2026-06-12 banco(maria/r2): monitor USB en competencia + fix sensores debiles + arquero strafe v6 PFM + skills de control + app calibracion guiada
    Sesion de banco completa de Maria Virginia con ROBOT 2 (2026-06-12). Detalle
    en journal/2026-06-12-banco-maria-r2-strafe-monitor-usb-calibracion.md.
    VALIDADO EN HARDWARE HOY:
    - Boton onboard Zircon (pin 9) clavado = GO permanente -> flag
    CENTRAL_MANUAL_START_NO_BUTTON + envs *_nobtn (validado banco).
    - MONITOR USB EN EL BINARIO DE COMPETENCIA de DOWN (TASK-306, pedido Maria):
    -DDOWN_USB_MONITOR en envs down/down_robot2 — dormido al boot, streamea con
    la app (PING keepalive), SE APAGA SOLO a ~3 s sin host (sacar el cable =
    modo partido, sin reflash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
    [comm_central.cpp, comm_central.h, down_model.cpp, down_model.h, down_telemetry_serial.cpp, down_telemetry_serial.h, line_calib.cpp, line_calib.h]
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2026-06-13 fix(down+monitor): saturación de sensibilidad + visual + 6 hallazgos de revisión adversarial
    CAMBIOS PEDIDOS POR GUSTAVO (banco 2026-06-13, probado en IDE):
    - SATURACIÓN: el slider de sensibilidad ahora SATURA en los extremos. Causa raíz
    doble: (1) el mapeo limitaba el umbral a [carpet,white] (±100 solo llegaba justo a
    carpet/white); (2) la app pintaba "ve blanco" desde el white_bits del line_ring,
    que usa el PUNTO MEDIO e ignora la sensibilidad (vive en dm_update). Fix:
    * line_calib: mapeo SATURANTE — total<0 interpola punto_medio→0 (a -100, umbral 0
    = TODOS blanco); total>0 interpola punto_medio→(2*white-carpet) (a +100, ninguno).
    * gui.py: "ve blanco" = raw >= umb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
    [comm_central.cpp, down_telemetry_serial.cpp, eeprom_calib.h, line_calib.cpp, line_calib.h]
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2026-06-13 docs(down): equivalencia competencia<->debug verificada + fix comentario/doc stale
    Verificacion adversarial (workflow 5+1 agentes) de que la calibracion fina v3
    (persistencia + deshabilitar + sensibilidad) se comporta IGUAL en el binario de
    competencia (down/down_robot2) que en down_debug_telemetry, que el equipo valido
    en banco sobre R1 real.
    Veredicto: minor_channel_differences_safe, confianza alta, 0 divergencias de logica.
    - Todo el path esta gateado por OR (DOWN_DEBUG_TELEMETRY || DOWN_USB_MONITOR) y
    [env:down] define DOWN_USB_MONITOR; boot (comm_central_load_persisted_calib) y
    dm_update son ungated -> corren en los 3 envs. Diferencias = solo de CANAL
    (monitor arranca dormido, ap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
    [down_telemetry_serial.cpp]
2026-06-13 feat(down): restaurar stream-desde-boot en down_debug_telemetry (monitor crudo)
    El monitor serie crudo no mostraba valores sobre la base: down_debug_telemetry
    habia quedado DORMIDO al heredar DOWN_USB_MONITOR de [env:down] (TASK-306, 06-12),
    asi que solo la app (STREAM ON + PING) lo despertaba. Retroceso del flujo de banco.
    Fix (pedido de Gustavo): precedencia DOWN_DEBUG_TELEMETRY > DOWN_USB_MONITOR via un
    macro interno DOWN_MONITOR_SLEEPY = (USB_MONITOR && !DEBUG_TELEMETRY).
    - down_debug_telemetry (banco): stream ON desde el boot, SIN auto-apagado -> el
    monitor crudo ve valores sin la app. Banner "[DOWN-TELEM] ... stream ON desde boot".
    - down / down_robot2 (competencia): DORMIDO, byte-I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
    [down_telemetry_serial.cpp]
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2026-06-14 fix(central): boton fisico de arranque DESHABILITADO por default (fail-safe)
    Pedido de Gustavo: en los DOS robots el pulsador onboard del Zircon (pin 9) dio
    problemas (se sospecha logica/polaridad invertida; el 2026-06-12 quedo CLAVADO -> GO
    permanente). Politica fail-safe: desactivar el boton fisico en TODOS los programas;
    el arranque va por el ARBITRO o por comandos por SERIE.
    Cambio de DEFAULT en el codigo (no por-env, para cubrir tambien programas futuros):
    - src/central/main_central.cpp: el pinMode(pin9) y el digitalRead(PIN_MANUAL_START_BUTTON)
    ==LOW -> GO pasaron de #ifndef CENTRAL_MANUAL_START_NO_BUTTON a #ifdef
    CENTRAL_ENABLE_PHYSICAL_BUTTON (opt-in que NINGUN env define -> bot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
    [config_central.h, main_central.cpp]
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2026-06-14 feat(top): A2.1 — config persistente de sensores en EEPROM (deshabilitar camara/BNO/ToF/US + ubicacion ToF)
    Fail-safe del Monitor de Posicionamiento (TASK-206): apagar un sensor que manda
    basura (la pelota fantasma de la camara dual) y que persista en la EEPROM de la TOP.
    - src/shared/top_config.{h,cpp} (PURO): struct TopConfig (enables cam F/B, BNO L/R,
    US, ToF entero + bearing por ToF; campos de zonas/rotacion A2.2 reservados) +
    serialize/deserialize byte-a-byte LE + CRC16-CCITT + defaults no-op. 12 tests host.
    - src/top/top_eeprom_config.{h,cpp} (glue Arduino): offset 368 (tras calib IMU
    [320,367]); EEPROM.update byte a byte; g_top_cfg global; load deja defaults si invalida.
    - ma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
    [cameras_runtime.cpp, main_top.cpp, sensors_imu.cpp, sensors_tof.cpp, top_config.cpp, top_config.h, top_eeprom_config.cpp, top_eeprom_config.h]
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2026-06-14 fix(central): arquero strafe — escape OPUESTO a la entrada + mas largo + signo de seguimiento de pelota
    Banco Maria 2026-06-14 (2a iteracion):
    - ESCAPE: la direccion ahora es -dir_simple (OPUESTO al sentido de entrada), NO por
    angulo de linea (que se lee mal rotado y a veces escapaba HACIA la linea). + dura
    mas: GKS_ESCAPE_MS 600->900.
    - PELOTA (GK_SIMPLE_BALL): el seguimiento iba al reves -> GK_BALL_TRACK_SIGN=-1
    (constante para re-flipear en banco si aun va al reves). Eje X camara<->strafe.
    pio SUCCESS (strafe_bb + strafe_cam_bb). NO validado en placa.
    [strategy.cpp]
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2026-06-14 tune(central): arquero strafe — escape mas largo (1700ms) + direccion robusta al rumbo (la_field)
    Banco Maria 2026-06-14 (3a iteracion):
    - ESCAPE: GKS_ESCAPE_MS 1300->1700, GKS_ESCAPE_SPEED 420->470 (la trasera satura ~420,
    el lever util es la duracion).
    - DIRECCION DE ESCAPE: clasificar la linea "de atras" en el MARCO CANCHA (la_field =
    la + heading) en vez del marco robot. Asi, rotado, ya no confunde una lateral con la
    de atras y deja de "meterse mas" al ir a la izquierda. (flip + por - si saliera al reves.)
    pio SUCCESS. NO validado en placa. La rueda trasera floja en lateral = motores (config
    compartida), tema-a-analizar aparte.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
    [strategy.cpp]
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2026-06-14 diag(central): env arquero strafe con PFM de rumbo APAGADO — aislar causa de la "medialuna"
    Banco Maria 2026-06-14. El diag_central_strafe (open-loop, omega=0) "anda derecho"; el
    arquero le suma el control de rumbo PFM y arquea. Hipotesis: la medialuna es el PFM
    sobre-corrigiendo, NO los motores (las band-aids de trasera/tiempo no la arreglaron).
    Flag -DGK_STRAFE_NO_PFM = omega=0 en el strafe + sin RESQUARE. env
    central_robot2_arquero_strafe_cam_noheading. Si va derecho -> era el PFM; si arquea -> motores.
    pio SUCCESS. Experimento de diagnostico, NO competencia.
    [strategy.cpp]
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2026-06-14 fix(central): freno de borde anti-latch — el arquero quedaba TRABADO sobre su linea
    Root cause (caja negra v1.2, banco Maria 2026-06-14, env noheading): el arquero se
    clavaba 5+ s sobre la linea izquierda. NO era el motor ni GKS_ESCAPE_MS.
    Mecanismo probado con el CSV: el FRENO DE BORDE (main_central.cpp, EMERGENCY_LINE)
    tiene prioridad sobre la FSM: si world_model_imminent_exit() && line_fresh -> motors_brake()
    + return, salteando strategy_tick(). En la linea izquierda imminent_exit quedaba en 1 ->
    se frenaba y se hacia return en CADA vuelta -> la huida (fase ESCAPE) NUNCA corria -> el
    robot no se movia -> la linea seguia inminente -> DEADLOCK (emerg=1 todo el tramo del log,
    state=ESCAPE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
    [main_central.cpp]
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2026-06-14 fix(central): revertir piso trasera 120->107 (medialuna) + pelota solo-centrar
    MEDIALUNA (banco Maria 2026-06-14, "esta PEOR"): el modelo MEDIDO (skills
    dinamica-omni-3-ruedas + control-pid-zona-muerta) dice que {70,70,107} da strafe
    DERECHO y estable a 200mm/s con omega=0 (validado banco R2 2026-06-09). En una
    sesion anterior subi la trasera 107->120 creyendo que "no compensaba" — al reves:
    con FLOOR_SCALE, subir el piso de la rueda DOMINANTE del strafe sobre-escala el
    vector de forma ASIMETRICA -> yaw parasito direccional = medialuna PEOR. La caja
    negra lo mostraba: trasera 140 a un lado, 120 (=piso) al otro, mismo |vx|. REVERTIDO
    a 107 (valor validado). La deriva sistematica residual la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
    [config_central.h, strategy.cpp]
2026-06-14 TASK-211: TA-2 carga de los ToF a 1 MHz (bench env opt-in top_robot2_pri_1mhz)
    Continua TASK-210 (TA-1, 400 kHz ya validado en banco: boot ~40 s -> ~14,4 s).
    TA-2 sube SOLO la carga del firmware a 1 MHz (Fast Mode Plus) para recortar otros
    ~4 s (tof_init ~12 s -> ~8 s esperado). Opt-in + fallback, sin tocar produccion:
    - sensors_tof.cpp: constante TOF_INIT_CLOCK_FAST_HZ=1000000; en el path MULTI,
    gateado por -DTOP_TOF_INIT_1MHZ, intenta 1 MHz y si falla RESETEA el sensor por
    LP y recae a 400 kHz (TA-1), con log por sensor. Sin el flag = byte-identico a TA-1.
    - platformio.ini: env de banco top_robot2_pri_1mhz (= top_robot2_pri + el flag).
    Compila OK: top_robot2_pri (SUCCESS, sin cambios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
    [sensors_tof.cpp]
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2026-06-14 fix(central): gate anti-pelota-fantasma en el centrado del arquero
    Banco Maria 2026-06-14 (caja negra v1.2, piso 107): el arquero se salia de la linea
    para los DOS lados. Root cause (probado con el CSV): la camara/TOP reporta una pelota
    FANTASMA clavada en saturacion (ball_x=1000, ball_y=1000) VISIBLE incluso con el robot
    QUIETO al boot, que SALTA de +1000 a -1000 con velocidades desbordadas (ball_vx=+-32768).
    El centrado (correcto) la persigue a izq y der -> fuera de la linea a ambos lados. NO es
    el centrado: persigue un sensor roto (pelota fantasma = 2 camaras promediadas en la TOP).
    Fix CENTRAL (mitigacion): gate GK_BALL_MAX_ABS_X_MM=900 -> ignora detecciones implausibles
    (|x|>=900mm o d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
    [strategy.cpp]
2026-06-14 docs(central): corregir "fantasma" -> pelota REAL con fusion saltarina (correccion Maria)
    Maria aclaro que HABIA una pelota real en la cancha; mi diagnostico "fantasma" fue
    errado (la lei constante en (1000,1000) al boot, pero una pelota real quieta da eso).
    El dato duro que QUEDA: la posicion reportada salta de +1000 a -1000 en 20 ms (t=15443
    -> 15463), imposible para una pelota real -> la FUSION de las 2 camaras de la TOP es lo
    no-confiable, no la existencia de la pelota. El gate (|x|>=900) y el fix de TOP (sticky)
    siguen siendo correctos; solo se corrige el encuadre en comentarios. Sin cambio funcional.
    [strategy.cpp]
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2026-06-14 fix(central): invertir signo del centrado de pelota del arquero (-1 -> +1)
    Banco Maria 2026-06-14: el arquero VE la pelota pero se ALEJA (corrige al lado
    contrario), no busca quedar de frente. GK_BALL_TRACK_SIGN estaba en -1 (fix viejo
    que quedo al reves); +1 -> va HACIA la pelota (bx>0 -> strafe derecha -> bx->0,
    queda enfrentada). Si volviera a alejarse, -1. pio SUCCESS (noheading + bb).
    [strategy.cpp]
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2026-06-14 feat(central): delantero R1 LINE_AVOID - despegue real con margen (replicado del arquero)
    Reemplaza el retroceso por tiempo CIEGO (4s fijos) por el patron del arquero
    (GK_ADVANCE, banco 2026-06-09): escapa un minimo (atraviesa la saturacion
    "todo blanco" del medio donde line_detected da false), sigue hasta que la linea
    deje de verse y se mantenga limpia un margen (si la re-ve, reinicia), con tope
    de seguridad. Arregla el "queda trabado en la linea" + loop escape-toque.
    Constantes nuevas: ATK_LINE_AVOID_MIN_MS=800, ATK_LINE_CLEAR_MARGIN_MS=300,
    ATK_LINE_AVOID_MAX_MS=3000. Var g_atk_line_clear_ms.
    SIN VALIDAR EN BANCO (solo compila SUCCESS). OJO: si el signo del escape esta
    invertido en R1,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
    [strategy.cpp]
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2026-06-15 tune(central): +potencia trasera M3 SIMETRICA via eff 131->115 (A/B banco Maria, sin BNO)
    Pedido Maria: mas potencia al M3 para enderezar el strafe open-loop. Lever LIMPIO = la
    eficiencia (eff_x100[2] 131->115 = mas PWM a la trasera a AMBOS lados), NO el piso (que
    metia asimetria y ya empeoro en open-loop, 18 vs 8 deg/s). Signo de la deriva sugiere
    trasera floja. A/B: si endereza, bien; si rota al otro lado, subir de vuelta; revertir=131.
    [config_central.h]
2026-06-15 feat(camaras): traer calibracion de camara de Elias (homografia + balance de blancos)
    De origin/elias se toman SOLO los 2 archivos de camara (camaras-openmv/main.py +
    cameraBack-pack/calibrar la matriz de homografia.md). El central .cpp de esa rama (base
    MUY vieja, strategy.cpp 1684 lineas) se EXCLUYE a proposito: hubiera revertido el laburo
    de hoy. main no habia tocado la carpeta de camara -> se toman limpios. Credito: Elias.
    [main.py]
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2026-06-15 feat(central): lazo de control del arquero - fast-BNO + amortiguacion PD (gateados)
    Analisis del lazo del arquero (medialuna): latencia del rumbo es la causa dominante (lazo 100 Hz vs BNO 20 Hz). Doc nuevo CONTROL-ARQUERO-LATERAL-Y-LATENCIAS.md (fila en FUENTES + journal).
    Dos mejoras OFF-by-default (binario de competencia intacto):
    P0 TOP_BNO_FAST (sensors_imu.cpp): BNO primario aislado Wire2 a 100 Hz (no 20) -> atraso ~35-70ms a ~15-30ms. #error exige TOP_BNO_PRIMARY_ONLY. Env top_robot2_pri_fastbno.
    P1 GK_PFM_RATE_DAMP: modulo puro heading_rate.h (velocidad de giro de muestras frescas) + termino kd_rate en pfm_heading.h (D de un PD), cableado en el strafe (GK_PFM_KD_RATE=0.30). Env cen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
    [sensors_imu.cpp, strategy.cpp]
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2026-06-15 feat(rt): integracion gateada del analisis RT — quick-wins CENTRAL + pose_fusion TOP + motor_slew
    Cablea parte del analisis RT al firmware vivo, TODO gateado off-by-default →
    binarios de competencia byte-identicos. Gate host 937/67/0 (sin cambios: glue
    Arduino, los modulos puros ya tenian sus tests).
    A) Quick-wins CENTRAL
    - A1 CENTRAL_DEBUG_SERIAL: gatea el bloque Serial.print de 500 ms del loop
    (pico de jitter). Flag DEFINIDO en central_robot1/2 → byte-identico hoy;
    borrarlo en banco saca el jitter.
    - A2 CENTRAL_TOP_RX_BIGBUF: addMemoryForRead(512) en Serial7 (TOP→CENTRAL),
    hoy 64 B. Default OFF = 64 B = binario de hoy.
    B) TOP estimacion
    - pose_fusion+pose_filter cable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
    [comm_top.cpp, main_central.cpp, main_top.cpp]
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2026-06-15 feat(top): cierre del estimador — pose_fusion numericamente correcto (rot_lut + seed-gate + heading_valid) + clamp drive_straight
    Cierre host-testeable de la placa TOP (pedido: terminar TODOS los modulos).
    Workflow de inventario (10 agentes + verif. adversarial) separo lo terminable
    host-testeable del glue Arduino de banco. Verdad central HONESTA: el pipeline de
    competencia ya esta vivo/byte-identico; el grueso del remanente es glue (ISR/DMA/
    timer/Wire) de banco. Lo terminable host-testeable = 3 agujeros NUMERICOS del
    estimador pose_fusion (cableado pero MAL al girar) + 1 clamp. Gate 993/71/0.
    H1 (bug #8) — des-rotacion del delta OTOS:
    - src/shared/rot_lut.h NUEVO: sin/cos Q12 de circ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
    [drive_straight.cpp, drive_straight.h, main_top.cpp]
2026-06-15 fix(top): imu_cross_validate exige CONSENSO entre refs independientes antes de MALO (gap H4/H5) + tests
    Endurecimiento del nucleo de salud del heading (TASK-212 Fase 1). Al revisar para
    H4/H5 (cobertura de borde) el coverage existente ya era fuerte (test_pose_filter
    cubre jump-gate/hold/median; test_cameras_parser cubre CRC8/bit-flips/resync) → NO
    se padea con tests redundantes. Pero se halló y cerro un GAP de correctitud real:
    - xval escalaba a MALO con n_indep>=2 SIN verificar que las 2 refs independientes
    (OTOS+camara) coincidan ENTRE SI. La spec de TASK-212 lo pide: "si discrepan, NO
    vetar, solo bajar score" (una puede mentir: camara por strafe/homografia, OTOS por
    patinazo). A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
    [imu_cross_validate.h]
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2026-06-16 feat(top): COMPLETAR programacion del glue de cross-validacion del heading (TASK-213) — gateado
    Pedido de Gustavo: completar la PROGRAMACION antes de testear ("no puedo compilar/
    banco NO es excusa para no programar"). Hecho: la cross-validacion de salud del
    heading ahora CORRE en el firmware, gateada off-by-default (binario de competencia
    byte-identico via --gc-sections con los flags OFF). Workflow de diseno del glue
    (8 agentes) + verificacion adversarial. Hallazgo: la arquitectura no-bloqueante
    ISR/DMA/timer es POST-Incheon; el centinela+xval corren ENTEROS en contexto de loop.
    PURO (host-tested, gate 1003/0):
    - imu_cross_validate.h: FIX sentinel_fresh_timeout_ms=1300 (sin esto la rama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
    [cameras_runtime.cpp, cameras_runtime.h, comm_down.cpp, comm_down.h, imu_cross_validate.h, main_top.cpp, sensors_imu.cpp]
2026-06-16 @ fix(top): TOP_BNO_TOF_GAP_MS visible en ambas ramas del #if/#else (xval no compilaba)
    El #define vivia DENTRO de la rama #if TOP_BNO_TOF_DECONFLICT (R1), pero el
    #else del centinela R2 (main_top.cpp:449) tambien lo usa -> con
    -DTOP_ENABLE_BNO_SENTINEL el env top_robot2_pri_xval no compilaba
    ("TOP_BNO_TOF_GAP_MS was not declared in this scope").
    Subo el #ifndef/#define ARRIBA del #if/#else para que lo vean las dos ramas.
    Cero cambio de codigo generado: es una macro (sin efecto en byte-identidad de
    top_robot1/2/pri). Verificado: pio run -e top_robot2_pri_xval SUCCESS +
    pio run -e top_robot2_pri SUCCESS (binario de competencia intacto).
    Cazado compilando localmente (pio Core 6.1.19 SI esta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
    [main_top.cpp]
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2026-06-16 @ fix(top): los 2 BNO de cada robot estan en 0x28 (no 0x29) — unificar robot1 + corregir docs
    Gustavo confirmo en banco (2026-06-15) que en AMBOS robots los 2 BNO055 quedaron en
    0x28, en BUSES SEPARADOS: primario solo en Wire2 (24/25, sin ToF) + secundario en Wire
    (18/19, con los 4 ToF). El viejo esquema de robot1 (2do BNO en 0x29 por ADR puenteado a
    3V3, mismo bus Wire) fue un ERROR ya corregido en hardware. No hay NINGUN BNO en 0x29
    (0x29 sigue siendo la dir de fabrica de los ToF VL53L7CX -> se reasignan a 0x2A..0x2D).
    Disparador: el pre-flight diag_bno_dual_live dio un falso "R --" porque buscaba el 2do
    BNO en 0x29 (cableado viejo). robot2 ya estaba bien; robot1 todavia arrastraba el 0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
    [diag_bno_addr_check.cpp, diag_bno_dual_live.cpp, diag_bno_left.cpp, main_top.cpp, pinout_common.h, robot2.h, sensors_imu.cpp, sensors_imu.h]
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2026-06-16 feat(top): modulos puros de la arquitectura RT no-bloqueante (pizarra + productores async + fail-safe)
    Programados y host-verificados (run-host-tests.sh: 78 envs / 1098 tests / 0 fallas). NUEVOS: freshness_policy.h (FRESH/STALE/NEVER + conf_gate), hcsr04_async.h (FSM async, mata el pulseIn 12ms, timeout->N/A), bno_read_sm.h (scheduler que hereda el deconflict 8ms; cfg_valid rechaza el caso que recongela el yaw), tof_schedule.h (round-robin + skip-caido, byte-equiv), snapshot_from_slots.h (la costura pizarra->ensamblador, 1 solo now, fail-safe por slot). MEJORAS: sensor_slot.h +slot_read_latest_capped (corta el for(;;) que colgaria la ISR del emisor), pose_fusion fix anti-free-run (>500ms sin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
    [bno_read_sm.h, freshness_policy.h, sensor_slot.h]
2026-06-16 feat(top): emisor del WorldSnapshot @100Hz desacoplado por IntervalTimer (gateado) + handoff
    snapshot_emitter.{h,cpp}: el loop publica los reads a la pizarra (sensor_slot); la ISR del timer @100Hz lee la pizarra (inputs_from_slots -> assemble_snapshot, fail-safe por frescura) y manda no-bloqueante por Serial4 -> el snapshot sale clavado a 100Hz aunque el loop este trabado en un read. GATEADO -DTOP_ENABLE_SNAPSHOT_TIMER: con el flag OFF el emit-en-loop de hoy es byte-identico (TU vacia + calls gateados). El WDT sigue SOLO en el loop (nunca en la ISR). Cableado gateado en main_top.cpp + env top_robot2_pri_snaptimer. Verificado: pio compila ON y OFF (los 7 modulos puros linkean en el firmware T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
    [main_top.cpp]
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2026-06-16 fix(top): endurecer el seqlock de la pizarra (volatile + __DMB + reader acotado en la ISR)
    Arquitectura RT no-bloqueante del TOP - Etapa 1 (fundacion del emisor seguro).
    Cierra los hallazgos D1-1/D1-2 de la auditoria RTOS 2026-06-16.
    - sensor_slot.h: seq ahora volatile + barreras IITA_SEQLOCK_FENCE() (dmb 0xF con
    clobber memory en Cortex-M7, barrera de compilador en host) en slot_publish y en
    ambos readers. Sin esto, bajo -O2 el M7 podia reordenar el store del buffer
    despues del de seq (torn read) y el compilador plegar before==after a siempre-true
    (matando la deteccion). Receta del review adversarial (HANDOFF-INTEGRACION-RT.md).
    - snapshot_from_slots.h: inputs_from_slots() (corre E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
    [sensor_slot.h]
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2026-06-16 feat(top): HC-SR04 no-bloqueante (FSM+ISR) + round-robin ToF con skip del caido - Etapa 3
    Arquitectura RT no-bloqueante del TOP - Etapa 3. Cierra el hallazgo D2-1 (pulseIn ~12 ms
    bloqueaba el loop/uplink) y D2-3 (round-robin desperdiciaba el tick del ToF caido).
    - sensors_tof.cpp, HC-SR04 (gateado -DTOP_ENABLE_HCSR04_ASYNC, off-by-default): cablea
    hcsr04_async.h. ISR de ECHO (CHANGE) -> hcsr04_on_edge; el tick dispara (hcsr04_due +
    pulso TRIG 10us + on_trig_sent) y cosecha por hcsr04_poll. CERO espera del eco en el loop
    -> se elimina el spike de 12 ms del pulseIn. RACE loop<->ISR cerrada con noInterrupts()
    alrededor de TODO acceso del loop a la FSM (la FSM NO es volatile: la SC seri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
    [sensors_tof.cpp]
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2026-06-16 @ feat(down): reingenieria RT de la placa DOWN — diseno validado + programado (gateado, host-tested)
    Pedido de Gustavo: optimizar el lazo DOWN (32 sensores de luz + 2 OTOS) con minima latencia
    sensor->envio (a CENTRAL y TOP) + SUPER confiable / fail-safe con degradacion coherente.
    La definicion funcional YA existia (docs/firmware/ARQUITECTURA-LAZO-DOWN-RT.md). Se VALIDO
    adversarialmente (workflow 7 agentes) y se PROGRAMO el glue gateado + modulos puros, mirroreando
    el patron del TOP. TODO off-by-default -> competencia [env:down] BYTE-IDENTICA. NADA en banco
    (regla 1) -> TASK-309 lo cierra el equipo.
    MODULOS PUROS NUEVOS (host-tested, 79 tests; full gate 84 envs / 1162 / 0):
    - adc_scan_pl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
    [comm_central.cpp, comm_central.h, comm_top.cpp, down_blackboard.h, down_model.cpp, down_model.h, line_ring.cpp, main_down.cpp]
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2026-06-16 feat(top): A2.2 — enmascarado de zonas ToF (anular zonas superiores) aplicado + comandos + monitor
    Cierra el gap A2.2 (spec 2026-06-13): la mascara de zonas (anular las que ven la
    estructura/techo) ahora SE APLICA al leer y se puede setear desde el monitor + persiste.
    Firmware:
    - tof_zone_mask.h (PURO, host-tested test_tof_zone_mask 8/8): tof_zone_masked_mean
    (promedio de zonas habilitadas+validas) + helpers. Default mask=~0 => byte-identico
    a mean_valid_zones (fail-safe, no-op).
    - sensors_tof.cpp: cablea la mascara en el tick (g_top_cfg.tof[i].zone_mask) -> las
    zonas anuladas no cuentan en la distancia/min_obstacle. UNGATED (no-op por default).
    Las zonas crudas (g_zones_mm) queda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
    [sensors_tof.cpp]
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2026-06-17 feat(central+monitor): pose XY del TOP a la app + fix trampa 'S' + cancha grafica + Hz
    Dos temas de la sesion 2026-06-17 (banco Gustavo):
    1) Fix de raiz a la trampa de la 'S' (P0, validado en banco): el USB handler de
    main_central.cpp trataba cualquier \n/\r como GO (legacy juez-PC); el STREAM ON
    + PING de la app de monitoreo arrancaba el robot solo. Unificado a una regla:
    linea vacia=GO, 1 char=comando (g/s/d/x), >1 char=IGNORAR. Ademas se agrego
    -DCENTRAL_USB_MONITOR a 9 envs base de practica R1/R2 (antes solo los _demo_bb)
    para que la app reciba datos en todos los programas de banco.
    2) Monitor CENTRAL ampliado: contrato JSON con pose XY del robot (my_x/my_y/my_hdg/
    hd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
    [central_telemetry_serial.cpp, main_central.cpp, main_top.cpp]
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2026-06-17 feat(central): modulo puro central_config — calibracion persistente sin reflashear (nucleo, TDD)
    Nucleo host-testeable del sistema de calibracion de la CENTRAL (Fase 2 del
    PLAN-MONITOR-Y-CALIBRACION-CENTRAL): permitira tunear potencias/PID en banco desde el
    monitor USB y guardarlas en EEPROM, SIN reflashear. Patron de top_config (blob + CRC16).
    Parametros (nombres claros, confirmados con Gustavo):
    - min_pwm[3] : piso de PWM de arranque por motor (del-izq / del-der / trasera)
    - eff[3] : eficiencia x100 por rueda (corrige el strafe lateral)
    - fwd_pwm_l/r : PWM rueda izq/der en AVANCE RECTO (compensa el motor que anda distinto)
    - gyro_kp/ki/kd : PID de rumbo con giroscopio (x1000) -> a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
    [central_config.cpp, central_config.h]
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2026-06-17 fix(competencia): auditoria de robustez + 3 mejoras pre-Incheon (delay arquero + BIGBUF R1 + paridad WDT)
    Revision adversarial de los binarios de competencia (4 agentes deteccion en paralelo ->
    analisis multi-angulo -> auditor independiente). Doc completo en
    research/completed/2026-06-17-auditoria-robustez-programas-competencia.md.
    Verificado OK (no tocar): contratos de datos (static_assert 31/16B, mismo ABI), CRC/resync,
    fail-safe TOP-muerto, timeouts coherentes, seqlock del TOP, R2-sin-OTOS degrada limpio.
    Aplicadas las 3 mejoras del ranking del auditor (cierre = BANCO, no marco done):
    #2 (delay arquero): GK_START_DELAY_MS 2000 -> 200 (strategy.cpp). Con 2000 el arco quedaba
    descubie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
    [strategy.cpp]
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2026-06-18 feat(top): zonas ToF (rotacion firmware-dueno + reductor robusto) + fix parser + scroll monitor
    Procesamiento de zonas del ToF al firmware, todo detras de un flag apagado por defecto
    (binario de competencia byte-identico; el apply de rot/robust no corre con el flag off).
    Banco lo cierra el equipo (regla #1) — nada validado en hardware.
    - tof_zone_mask_orient.h (puro, host 7/0): rota/espeja la mascara canonico->crudo con la
    MISMA convencion que la app (tof_layout.zone_source_map). Cableado en sensors_tof tras
    -DTOP_ENABLE_TOF_ROT. Comandos TOF n ROT/FLIP (enum+parser+handlers) -> g_top_cfg, persisten
    con CFG SAVE.
    - tof_zone_masked_robust en tof_zone_mask.h (puro, host 8/0): descarta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
    [sensors_tof.cpp]
2026-06-18 feat(top): prediccion de rumbo (predict step) gateada — heading + w*dt en vez del dato quieto
    Pedido Gustavo: transmitir a la CENTRAL el heading EXTRAPOLADO (heading_crudo + w*dt, con
    w MEDIDA del gyro) en vez del ultimo valor quieto, para descontar la latencia/staleness
    entre muestras del BNO. Es el predict step de un estimador predict/correct (dead reckoning
    de 1er orden / filtro alpha-beta).
    - Modulo PURO src/shared/heading_predict.h (host-tested test_heading_predict 14/14) con las
    3 reglas duras: w medida + CAP max_extrap_ms~60ms (<< SNAPSHOT_TIMEOUT_MS=500, hallazgo P0)
    + deadband + re-anclaje en muestra fresca.
    - Cableado gateado -DTOP_ENABLE_HEADING_PREDICT (default OFF) en sen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
    [main_top.cpp, sensors_imu.cpp, sensors_imu.h]
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2026-06-18 feat(arquero): patrulla SIMPLE izq<->der que anda en banco + fix clasificacion marco-cancha + escape hasta-salir
    Arquero R2: FSM SIMPLE ping-pong (-DGK_PINGPONG) que reemplaza la patrulla v3.3 (que hacia
    churn: se frenaba a reorientar y RETROCEDIA). Strafe continuo izq<->der; clasifica la linea en
    MARCO CANCHA (la + heading, no marco robot -> ya no confunde su linea de fondo con una lateral);
    escape al opuesto a maxima potencia HASTA SALIR (min 0.7s, tope 4s). VALIDADO en banco por
    Gustavo 2026-06-18 ("ahora si anda"). Todo detras de flags -> competencia byte-identica.
    - src/shared/gk_strafe_hold.h (PURO, host 7/7): PI de rumbo -> trim de la rueda TRASERA.
    - motors_set_rear_trim() en motors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
    [central_telemetry_serial.cpp, gk_strafe_hold.h, motors_zircon.cpp, motors_zircon.h, strategy.cpp]
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2026-06-18 fix(arquero): alinear tuneo a la guia canonica (escape 470, Y trim +-19, KP3/KI0.5) + referenciar docs en lectura obligatoria
    Tras buscar el prior-art (workflow): varios docs YA tenian estos valores tuneados. Correcciones a lo re-derivado mal:
    - escape de linea 590->470 (arriba de ~470 la trasera satura -> huida DIAGONAL; la distancia se saca con TIEMPO, no velocidad)
    - escala de trasera al arranque DESACTIVADA (1.0): el "diagonal" era esa misma saturacion de velocidad, no friccion de arranque
    - Y-hold vy_max 30->19 mm/s (tope fisico documentado; arriba la trasera patea)
    - heading-hold GK_STRAFE_KP 2.0->3.0 (=HeadingPID validado) + KI 1.0->0.5 (baja el hunting integral de ~3 s)
    - motors_zirc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
    [motors_zircon.cpp, motors_zircon.h, strategy.cpp]
2026-06-18 feat(arquero): escape con EXTRA en las DELANTERAS para salir RECTO (idea Gustavo, banco 2026-06-18)
    En el escape lateral la cinematica real (WHEEL_ANGLES={330,210,90}) da trasera=vx (pura lateral) y
    delanteras=0.5*vx; a 470 mm/s las delanteras quedan cerca/por debajo de su piso mientras la trasera
    empuja fuerte -> la huida se va DIAGONAL. Subir las delanteras (tienen holgura hasta 150) suma empuje
    lateral por las ruedas con headroom y la huida sale RECTA, sin saturar la trasera (que es la que diagonaliza).
    - motors_zircon: nuevo motors_set_front_scale() (escala de idx 0,1, cap 150, detras de -DCENTRAL_REAR_TRIM)
    - strategy.cpp: GK_ESCAPE_FRONT_SCALE=1.30 aplicado durante el escape; reset a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
    [motors_zircon.cpp, motors_zircon.h, strategy.cpp]
2026-06-18 tune(arquero): patrulla -30% (200->140) sin pulsar + escape FRONT_SCALE 1.30->1.45 (enderezar huida)
    Banco Gustavo 2026-06-18: con KP=3/KI=0.5 la oscilacion practicamente desaparecio. Quedaba deriva
    diagonal hacia adelante + a veces toca pared + no se centraba. Cambios SIMPLES, SIN pulsar:
    - GK_PATROL_SPEED_MM_S 200 -> 140 mm/s (-30%): control total aunque lento (strafe puro lo banca, ya probado)
    - GK_ESCAPE_FRONT_SCALE 1.30 -> 1.45: mas empuje SOLO en las delanteras durante el escape para enderezar
    la huida sin tocar la trasera (que ya esta al cap 150 a 470 mm/s); el burn_cap 150 lo limita.
    Competencia byte-identica (flags apagados por defecto). Pendiente validar en banco.
    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
    [strategy.cpp]
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2026-06-20 centralmix: candidato de órbita para centrar_* (flag OFF) + limpieza de retroceder
    Sobre el sync de Elías (e83d43c), a pedido de Gustavo:
    - mix_motors.cpp: comentarios de retroceder1/2/3 limpiados (saqué código muerto y
    comentarios desfasados; puse el decode correcto verificado contra el FSM).
    - centrar_horario/antihorario detrás del flag MIX_CENTRAR_ORBIT_2026 (APAGADO por
    defecto -> comportamiento actual intacto). El centrar_* del port 2025 decodifica a
    casi puro strafe en la geometría 2026 (no orbita: la pelota se escapa de costado);
    el candidato rebalancea a rotación-dominante manteniendo la dirección de órbita y
    limpiando los pisos {70,70,107}. Parametrizado por MIX_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
    [mix_config.h, mix_motors.cpp]
2026-06-20 diag(R1 TOP): causa raíz del freeze del heading = rangeo de los ToF (acople eléctrico)
    Sesión de banco (R1 por COM11): el BNO primario se congela cuando CUALQUIER ToF
    rangea -> acople ELÉCTRICO local en la placa (masa/3V3/EMI), NO el bus I2C (aislado,
    verificado por scan dual-bus), NO la batería (independiente no cambió), NO el
    chip/cristal/frecuencia/clock. El chip está SANO (trackea con ToF dormidos).
    Docs:
    - journal/2026-06-20-...-tof-ranging.md: investigación completa (todas las pruebas + veredictos).
    - team-tasks/...task-223...: revisión de conexiones BNO<->ToF (Enzo).
    - journal/...RESUMEN-WHATSAPP...: resumen para compartir.
    Herramientas (reusables; default OFF = competencia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
    [diag_bno_freeze_probe.cpp, main_top.cpp, sensors_tof.cpp]
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2026-06-21 fix(top): heading del BNO andaba clavado en 0.0 por bno_left_en=0 en EEPROM (no era el chip ni los ToF)
    CAUSA RAÍZ (confirmada en banco 2026-06-21): el EEPROM tenía bno_left_en=0 (primario
    deshabilitado por config, apagado con BNO_L_OFF en una sesión vieja). La fusión lo marcaba
    DEAD (imu_fusion.cpp:102) -> fused_heading=0.0 SIEMPRE, aunque el chip lea perfecto.
    FIX (sensors_imu.cpp:279): forzar g_scfg[0].enabled=true. El primario es la ÚNICA fuente de
    rumbo en primary-only; nunca debe quedar deshabilitado por un flag stale de EEPROM.
    CONFIRMADO con el firmware real de competencia (top_robot1_pri_rt, ToF PRENDIDOS):
    reposo hdg=-15.6 -> girado ~90° hdg=101.4 (sigue el giro). El chip n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
    [sensors_imu.cpp]
2026-06-21 docs+comments(top): corregir referencias equivocadas al BNO de R1 (sano, no desconectado)
    Barrido del repo (workflow paralelo, 5 agentes) + verificación adversarial, aplicado en
    soccer-main. Tras confirmar en banco (2026-06-21) que el heading de R1 anda, se corrigen las
    referencias FALSAS-HOY al BNO: "0x29 muerto/quemado", "BNO desconectados", "R1 sin gyro",
    "1 BNO / 1 sano", "cristal dañado", "los ToF congelan el BNO".
    Verdad reconciliada (dos BNO, dos historias; anclada a sensors_imu.cpp):
    - Ambos BNO055 SANOS, @0x28, buses separados. NO hay BNO en 0x29 (es la dir de los ToF).
    - PRIMARIO (Wire2, solo): el "hdg=0.0" era el flag bno_left_en=0 en EEPROM (fix sensors_imu.cpp:284,
    fuerza e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
    [sensors_imu.cpp]
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2026-06-21 fix(arqueromix): seguir la pelota por ÁNGULO (la cámara veía pero el robot no se movía)
    Banco Virginia: motores OK, la cámara detecta (LED prende) pero el arquero no hacía
    ningún movimiento para seguir/despejar.
    Causa raíz (comparando con cómo usa la cámara el delantero centralmix): el FSM decidía
    con ball_x_mm/ball_y_mm CRUDOS y umbrales en mm (CENTRADO=30/DESVIO=50/CERCANIA=140).
    Con la escala del snapshot SIN CALIBRAR (CAMERA_UNIT_TO_MM=10), una pelota más o menos
    al frente caía en la BANDA MUERTA -> parar() pisaba la patrulla -> freeze justo al ver
    la pelota. centralmix no sufre esto porque sigue por ÁNGULO (atan2), robusto a la escala.
    Fix (igual que centralmix):
    - amix_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
    [amix_comm.cpp, amix_config.h, amix_fsm.cpp, amix_io.h]
2026-06-21 fix(arqueromix): arranque más suave + perilla de signo de rumbo (180°) + bajar potencia despeje
    Banco Virginia (3ª iteración). Con el fix de cámara el arquero ya reacciona, pero:
    1. Al arrancar daba una vuelta de 180° y quedaba mirando nuestro arco.
    2. El despeje pegaba con mucha potencia.
    (1) El 180° = DERIVA DE RUMBO del strafe omni (yaw parásito). El strafe anda bien; la
    corrección de rumbo de 3 bandas del 2025 está al revés para este robot (tipo OMEGA_SIGN)
    o no tiene heading válido. Cambios:
    - impulso_inicial más suave (FRONT 90->70, REAR 153->110; 153 rozaba el techo térmico).
    - perilla -DARQMIX_FLIP_HEADING (env central_robot2_arqueromix_flip): invierte el signo de
    la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
    [amix_config.h, amix_motors.cpp]
2026-06-21 feat(arqueromix): signo de rumbo VALIDADO (-1 default) + pateo con rampa como el delantero
    Banco Virginia (4ª iteración):
    1. La versión con la corrección de rumbo invertida (signo -1) fue la que anduvo (arquero
    queda derecho, sin la vuelta de 180°). Se guarda como la CORRECTA:
    AMIX_HEADING_CORRECT_SIGN = -1 por default. Se removió el env _flip (se flashea directo
    central_robot2_arqueromix). Fallback al signo viejo: -DARQMIX_HEADING_SIGN_OLD.
    2. "Encuentra bien la pelota pero no apunta al despejar" -> copiar el pateo del delantero
    (centralmix) con RAMPA de aceleración. avanzar_patear pasó de PWM fijo asimétrico
    (180/120, veraba) a rampa SIMÉTRICA (0->180 de a 20 cada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
    [amix_config.h, amix_motors.cpp, amix_motors.h]
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2026-06-21 fix(arqueromix): inicio va para adelante → safety 50s + retroceso dedicado/flippable con PWM propio
    Banco Virginia: apenas el GO el robot va hacia ADELANTE (debería ir atrás a buscar la línea
    del área). Pide safety 50s (temporal) y recuerda que los motores deben ir por PWM.
    Diagnóstico (sin HW): dos causas posibles — (a) arranca SOBRE una línea (line_present=true →
    saltea el retroceso → inicio_avanzar va adelante); (b) el retroceso está invertido en este
    robot (las convenciones de este robot ya resultaron distintas: el signo de rumbo hubo que darlo
    vuelta). El patrón patear_atras debería ir atrás (el despeje vuelve bien), así que lo más probable
    es (a) o un sentido inver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
    [amix_config.h, amix_fsm.cpp, amix_motors.cpp, amix_motors.h]
2026-06-21 fix(arqueromix): re-hacer el homing del área en CADA go (no solo el primero)
    Banco Virginia: el base anduvo (homing va para atrás bien, sin _retroflip), pero el homing
    corría una sola vez (el primer GO). Tras STOP→GO sin apagar la batería, no volvía a retroceder
    (seguía patrullando).
    Causa: el estado del FSM es estático; amix_fsm_init solo corre en setup(). El gate del árbitro
    solo hacía parar(), no reiniciaba el estado.
    Fix: detección de flanco STOP→GO en amix_fsm_tick (s_was_running). Cada GO reinicia el FSM a
    inicio_retroceder (+ timer + pd) → el arquero re-hace el homing al área en cada arranque.
    Compila SUCCESS. Competencia byte-idéntica (build aislado). Sentido del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
    [amix_fsm.cpp]
2026-06-21 feat(arqueromix): salir de la línea lateral a ciegas + commit (no quedarse enganchado)
    Banco Virginia: patrullando, al llegar a la línea lateral el arquero se quedaba enganchado
    (oscilaba). Pide hacer lo mismo que el homing al ver el blanco: un movimiento sin leer sensores,
    y después seguir patrullando el otro lado sin volver.
    Fix: estados nuevos salir_linea_izq/der (reemplazan impulso_izq/der):
    - al tocar la línea lateral, strafe al lado OPUESTO A CIEGAS (sin leer ningún sensor) durante
    AMIX_T_SALIR_LINEA (~450 ms, ≈ el avance del homing) -> moverce_opuesto.
    - commit: al terminar, s_commit_until_ms = now + AMIX_T_PATRULLA_COMMIT (~1 s). Durante esa
    ventana la patrulla IGNORA el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
    [amix_config.h, amix_fsm.cpp, amix_fsm.h]
2026-06-21 fix(arqueromix): salida de línea con más impulso + rebote inteligente en commit (no meterse de vuelta)
    Banco Virginia: a veces toca la línea, sale y se vuelve a meter. Dos causas:
    1. La salida usaba el pd de patrulla -> poco impulso para despegarse.
    2. El DOWN NO distingue qué línea es (una sola señal). Si la salida no despejaba del todo, el
    moverce re-detectaba la MISMA línea y rebotaba al lado opuesto = de vuelta a la línea.
    Fixes:
    - AMIX_PD_SALIR=1.9: la salida a ciegas usa pd fuerte (vs 1.0 de patrulla).
    - Rebote inteligente en commit: si durante el commit el moverce vuelve a ver línea, asume que es
    la MISMA (no despejada) y sigue saliendo para el MISMO lado (no rebota de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
    [amix_config.h, amix_fsm.cpp]
2026-06-21 fix(arqueromix): avance del homing = impulso momentáneo (PWM dedicado) en vez de PWM 100 sostenido 400ms
    El avance tras detectar la línea del área mantenía PWM 100 los 400ms enteros → el omni-3
    acumulaba deriva de yaw → el robot se iba chueco y rozaba de nuevo la línea (banco Virginia).
    Ahora es un impulso breve: AMIX_T_INICIO_AVANCE 400→200, primitiva dedicada avanzar_inicio()
    con AMIX_INICIO_AVANCE_PWM=90 (suave pero sobre el piso de 70), desacoplada del avanzar()=100
    del despeje. Build aislado: competencia byte-idéntica. Compila SUCCESS; NO validado en banco.
    [amix_config.h, amix_fsm.cpp, amix_motors.cpp, amix_motors.h]
2026-06-21 fix(arqueromix): avance del homing — bajar fuerza (90→75) e invertir sentido (banco Virginia)
    El movimiento a ciegas tras detectar la línea iba con demasiada fuerza y para el lado contrario.
    Baja AMIX_INICIO_AVANCE_PWM 90→75 y agrega AMIX_INICIO_AVANCE_SIGN=-1 (default) en avanzar_inicio().
    Flag -DARQMIX_FLIP_INICIO_AVANCE vuelve al sentido viejo. OJO: al invertir queda igual que el
    retroceso → confirmar en banco que igual se despega (documentado). Build aislado: competencia
    byte-idéntica. Compila SUCCESS; NO validado en banco.
    [amix_config.h, amix_motors.cpp]
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2026-06-21 revert(arqueromix): deshace mis 2 cambios del avance del homing (pedido Virginia)
    Revierte 675381e (impulso dedicado avanzar_inicio, 400->200, PWM 90) y f872a8a (PWM 90->75 +
    sentido invertido): rompian el avance del homing que funcionaba. inicio_avanzar vuelve a avanzar()
    a 400ms. Hecho con git revert sobre la version nueva: la feature 'despeje al arco rival' del
    companiero (ff3a55c) queda INTACTA (es ortogonal, no usa ningun simbolo mio). Sin conflictos.
    Compila SUCCESS. Competencia byte-identica (build aislado).
    [amix_config.h, amix_fsm.cpp, amix_motors.cpp, amix_motors.h]
2026-06-21 fix(arqueromix): bajar SOLO la velocidad del avance del homing (banco Virginia)
    inicio_avanzar pasa de avanzar() (PWM 100) a avanzar_inicio() (PWM AMIX_INICIO_AVANCE_PWM=75),
    identico salvo la velocidad: MISMO sentido (M1=+,M2=-,M3=0), mismos 400ms. Solo se baja la
    velocidad de ese avance del homing que iba 'de golpe'; el avanzar() del despeje sigue a 100.
    NO es el cambio revertido (ese invertia sentido + acortaba). Compila SUCCESS. Build aislado.
    [amix_config.h, amix_fsm.cpp, amix_motors.cpp, amix_motors.h]
2026-06-21 feat(centralmix): el delantero apunta a goal_opp (arco rival por ROL, sin color) + cierra bug color↔rol
    Mismo patrón que arqueromix: la determinación propio/rival vive en la placa TOP
    (goal_polarity); la placa CENTRAL NUNCA pregunta por color. El delantero consume
    goal_opp (rival, ya resuelto por el TOP) y apunta el pateo a ese arco — el mecanismo
    de orbitar+alinear+patear (CENTRANDO_*, gate |arco_rival_angle|<=MIX_TOL_CENTRADO) NO
    se tocó, solo cambió la FUENTE del arco rival.
    Cierra un bug latente: kArcoRivalEsAmarillo=false + el mapeo default (goal_opp->yellow,
    goal_own->blue) hacían que arco_rival leyera goal_blue = goal_OWN (el arco PROPIO). O
    sea, el delantero se centraba con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
    [mix_comm.cpp, mix_comm.h, mix_fsm.cpp, mix_io.h]
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2026-06-21 revert(arqueromix): vuelve a la version anterior (sin re-homing por linea del area chica)
    Pedido Virginia 'volve a la version anterior'. Revierte 96d15d6: arqueromix queda IDENTICO al
    checkpoint arqueromix-ok-patrulla-arco-2026-06-21 (verificado: diff 0). Patrulla por arco propio,
    sin el re-homing por linea. Compila SUCCESS. Build aislado.
    [amix_config.h, amix_fsm.cpp]
2026-06-21 fix(arqueromix): patrulla por arco CON fallback a linea (no se va de largo si la camara no ve el arco)
    El programa de patrulla-por-arco estaba cargado (verificado: AMIX_PATRULLA_POR_ARCO=true por
    default, rebote por borde_arco_*), pero borde_arco_* solo dispara con goal_own_visible -> si la
    camara no veia el arco, no rebotaba nada y el arquero se iba de largo (parecia que no estaba el
    programa). Fix: en moverce_*, en_borde = goal_own_visible ? borde_arco_*() : linea(). Rebota por
    ARCO cuando lo ve (pedido Virginia) y por LINEA cuando no -> siempre patrulla. Diagnostico: rebote
    angosto=usa camara, ancho=fallback. Compila SUCCESS. Build aislado.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
    [amix_fsm.cpp]
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2026-06-21 feat(arqueromix): el avance de arranque sale de la linea HASTA despegar (no por reloj fijo)
    Banco Virginia: el arquero quedaba muy cerca de la linea de fondo / metido en el area chica.
    Raiz (workflow de analisis): el homing 'inicio_avanzar' salia por tiempo FIJO (400ms); si era
    corto, quedaba pisando la linea. Fix: el avance termina cuando (impulso MINIMO cumplido Y !linea())
    o tope de seguridad. avanzar_inicio va recto al frente (lejos del fondo) = saca del area. Reusa
    primitivas, no agrega estado, NO toca la patrulla. AMIX_T_INICIO_AVANCE -> _MIN(400)+_SAFETY(1200).
    100% local (sin camara). Default=comportamiento actual+seguro -> sin regresion. Compila SUCCESS.
    NO resuelve la deriva DURANT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
    [amix_config.h, amix_fsm.cpp]
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2026-06-21 feat(arqueromix): fixes patrulla (sesgo forward) + auditoria de comentarios + doc actualizada
    Pedido Virginia (banco) + workflow paralelo (motion + comentarios + doc). Confirmado: los estados
    de centrar-pelota y patear YA EXISTEN. Cambios:
    MOTION: AMIX_AI_REAR_ENEG 75->65 (sobrepaso izq=asimetria), AMIX_T_SALIR_LINEA 350->380 (no pegarse),
    AMIX_T_INICIO_AVANCE_MIN 400->500 (adelantarse mas), y NUEVO AMIX_FORWARD_BIAS_PWM=10 = sesgo forward
    (M1+=,M2-= signos fijos en ad/aiproporcional, geometria omni-3) para tendencia a avanzar y no derivar
    atras. Flag -DARQMIX_NO_FORWARD_BIAS.
    COMENTARIOS: amix_fsm.h 10->12 estados; valores hardcodeados viejos (250/150, 450ms, 90/153) ->
    referencia a constan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
    [amix_config.h, amix_fsm.cpp, amix_fsm.h, amix_motors.cpp]
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2026-06-21 revert(arqueromix): movimiento de patrulla al estado que andaba mejor (medialuna izq)
    Pedido Virginia: el ultimo programa (AI_REAR 65 + sesgo forward 10 + T_SALIR 380 + AVANCE 500) hacia
    MEDIALUNA a la izquierda. Vuelto a los valores del tag arqueromix-bueno-2026-06-21-patrulla-lenta:
    AI_REAR 65->75, T_SALIR 380->350, AVANCE_MIN 500->400, sesgo forward APAGADO por default (opt-in con
    -DARQMIX_FORWARD_BIAS). Strafe byte-equivalente al tag (bias=0 = no-op). Doc/comentarios NO revertidos.
    Compila SUCCESS.
    [amix_config.h]
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2026-06-22 fix(arqueromix quieto): el rebote por linea hacia oscilar de costado en cancha vacia
    Banco Virginia: el modo quieto no se quedaba quieto sin pelota (oscilaba de costado). El flag SI se
    aplica y el strafe estaba gateado, pero el REBOTE lateral (salir_linea) NO: en cancha vacia, con el
    arco no visible, en_borde caia al fallback por linea() -> al pisar una linea del piso rebotaba de
    costado. Fix: gatear el rebote lateral en moverce_* para que en quieto SOLO dispare si sigue la
    pelota (haypelota && !ball_alineada). Profundidad por linea sigue activa (forward). Default
    byte-identico. Quieto + default compilan SUCCESS.
    [amix_fsm.cpp]
2026-06-22 fix(arqueromix quieto): estado dedicado esperar_quieto - el quieto deja de usar la patrulla
    Banco Virginia: el quieto seguia moviendose para adelante sin parar. Causa raiz (analisis linea por
    linea): reusaba moverce_*, que tiene PROFUNDIDAD (goal_own_visible && linea() -> inicio_avanzar): con
    el arco visible + cancha llena de lineas, cada linea lo mandaba a avanzar -> caminaba al frente sin
    parar. Tambien el rebote por linea.
    SOLUCION: estado dedicado esperar_quieto (3 ramas: cerca->patea, descentrada->strafe a enfrentarla,
    si no->parar). NO usa moverce_*/rebote/profundidad. inicio_avanzar y avanzar_despues_de_patear van a
    esperar_quieto en quieto (constexpr). moverce_* limpiado (se quitaron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
    [amix_fsm.cpp, amix_fsm.h]
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2026-06-22 checkpoint(centralmix): delantero mix funcional - kickoff medialuna + pelota en cm + tuning de banco
    Version 'definitiva temporal' (Elias): anda en banco pero faltan cosas por afinar. Kickoff = medialuna una vez por encendido del robot (re-arma con el reboot del TOP). Pelota en cm crudo de la camara; heading del BNO del TOP por snapshot. Print debug de la pelota por USB. Tuning MIX_A/MIX_TOL_* ajustado en banco. Sobre origin/main (todo el trabajo del equipo intacto). Compila central_robot1_mix_bno.
    [main_centralmix.cpp, mix_config.h, mix_fsm.cpp, mix_fsm.h, mix_motors.cpp]
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2026-06-22 feat(arqueromix quieto): retroceso post-patada con control PROPORCIONAL de rumbo al arco rival
    Banco Virginia: al frenar la alineacion, la inercia desalineaba al robot. Fix: el retroceso post-patada
    (PATEANDO_atras en quieto) ahora MANTIENE el frente al arco rival con control proporcional. Skill
    control-pid-zona-muerta: P + banda muerta + tope (sin D contra actuador cuantizado). Nueva primitiva
    retroceder_rumbo_opp(angle,visible): suma rotacion ~ Kp*angulo (deadband 5, clamp 30) a las 3 ruedas;
    autoridad de rotacion = desbalance M1/M2. Mismo signo que ALINEAR (AMIX_GIRO_ALINEAR_SIGN). Constantes
    AMIX_KP_RUMBO_OPP=2.0, AMIX_DEADBAND_OPP_DEG=5, AMIX_ROT_MAX=30 (~validados del arquero). SOLO qu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
    [amix_config.h, amix_fsm.cpp, amix_motors.cpp, amix_motors.h]
2026-06-22 feat(centralmix patada): empuje fuerte/rapido + RECTO con heading-hold del OTOS
    avanzar_patear() dejaba de ser la rampa lazo-abierto del 2025 (curvaba si las 2
    ruedas delanteras no estaban parejas). Ahora:
    - FUERTE/RAPIDA: arranca sobre el piso del motor (MIX_KICK_VEL_START) y rampa
    agresiva hasta 255 en ~24 ms (era ~120 ms a 240).
    - RECTA: heading-hold con el OTOS (otos_heading_deg de DOWN, independiente del BNO
    del snapshot). Ancla el rumbo al iniciar la patada y agrega un termino de giro
    (mismo signo en las 3 ruedas, como girar()) proporcional al error, clampeado.
    Si el OTOS no esta fresco/sano -> recto a ciegas. Signo del Kp a confirmar en banco.
    Plomeria: mix_io expone otos_con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
    [main_centralmix.cpp, mix_comm.cpp, mix_config.h, mix_io.h, mix_motors.cpp, mix_motors.h]
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2026-06-22 feat(arqueromix quieto): giro de centrado post-patada CONTINUO y lento (era pulsado)
    orientar_frente: el giro para centrarse con el arco rival deja de ser PFM
    (pulsos a PWM 90, duty ~26%) y pasa a CONTINUO a PWM bajo y constante (70),
    sin ventana ON/OFF. Saca los tirones que molestaban a Virginia en banco.
    Trade-off fisico marcado (skill control-pid-zona-muerta): el continuo no baja
    del piso del motor, asi que NO llega a ser tan lento como el pulsado (que
    promediaba por debajo del piso). AMIX_GIRO_FRENTE_PWM = knob de banco: subir
    si tironea (stick-slip). T_GIRO_VENTANA/T_GIRO_ON quedan sin uso.
    central_robot2_arqueromix_quieto: SUCCESS. Patrulla intacta. NO testeado en HW.
    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
    [amix_config.h, amix_fsm.cpp]
2026-06-22 tune(arqueromix quieto): giro de centrado continuo 70->50 (banco: 70 giraba rapido)
    Banco Virginia: a PWM 70 el giro de orientar_frente salia CONTINUO pero muy
    rapido (no tironeaba) -> el piso de giro esta por debajo de 70 (en rotacion las
    3 ruedas se ayudan). Bajado a 50 para buscar el "lento". Si a 50 tironea
    (stick-slip), subir hacia 55/60.
    central_robot2_arqueromix_quieto: SUCCESS. NO testeado en HW.
    [amix_config.h]
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2026-06-22 fix(centralmix patada): saturacion que preserva direccion + gate de confidence + defaults seguros
    Revision del diseno de la patada recta tras analisis de cinematica + red-team
    multi-agente. Tres fixes sobre la version anterior:
    1. SATURACION: el clamp por-rueda de mix_set_motor (M1 satura a 255, M2 no) torcia
    el vector e inyectaba STRAFE LATERAL PARASITO (la patada salia de costado aunque
    apuntara bien). Ahora se ESCALA el vector de 3 ruedas por un factor uniforme si el
    pico pasa 255 -> preserva la direccion. Mismo patron que saturate_wheels() del shared.
    2. CONFIDENCE: el gate por-tick miraba solo frescura; apply_down_pose sella el timestamp
    incondicionalmente -> con OTOS ciego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
    [main_centralmix.cpp, mix_config.h, mix_io.h, mix_motors.cpp]
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2026-06-22 fix(arqueromix quieto): invertir sentido del orientar por giroscopio (banco: miraba a nuestro arco)
    Banco Virginia: el bang-bang de orientar_frente se detenia (lazo estable) pero
    el arquero quedaba mirando a NUESTRO arco (180 del oponente) = firma de sentido
    de giro invertido (control-pid-zona-muerta: signo invertido queda estable a 180).
    Fix AISLADO en orientar_frente: (heading_error>0)?-1:+1 -> ?+1:-1. El equilibrio
    pasa de 180 (nuestro arco) a 0 (oponente). NO se toca -DARQMIX_FLIP_GIRO_ALINEAR
    a proposito: ese flag tambien invierte la alineacion pre-patada (camara) y el
    retroceso, que pueden estar bien. Fix local > flag global.
    central_robot2_arqueromix_quieto: SUCCESS. NO testeado en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
    [amix_fsm.cpp]
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2026-06-22 feat(centralmix patada): feedforward MIX_KICK_FWD_TRIM para matar la deriva constante (M2 floja)
    Banco 2026-06-22 (Elías): la patada se va SIEMPRE a la derecha -> a M2 (delantera DER)
    le falta potencia. Un heading-hold P solo NO cancela un sesgo CONSTANTE (deja error de
    regimen), por eso "siempre" se desvia igual. Fix correcto = FEEDFORWARD, sin latencia:
    MIX_KICK_FWD_TRIM (default 20) trasvasa PWM de M1 (izq) a M2 (der):
    M1 = +(vel - TRIM) + corr ; M2 = -(vel + TRIM) + corr ; M3 = corr
    + = corrige deriva a la DERECHA; titular en banco hasta que vaya recto. El heading-hold
    del OTOS queda ENCIMA para el resto (el trim mata el sesgo fijo, el OTOS el variable).
    + Se reponen los w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
    [mix_config.h, mix_motors.cpp]
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2026-06-22 fix(centralmix patada): restaurar escalado-vector (el veer "solo al patear" era saturacion, no M2 floja)
    Elias: borro por accidente la version del red-team (fc73ef1) y aclaro que el M2 deriva
    SOLO al patear, no en avanzar. Eso CONFIRMA que NO es un motor flojo: es la SATURACION a
    PWM alto. Al patear (vel=240) M1=240+corr se pasa de 255 y el clamp POR-RUEDA lo recorta
    solo a el -> el vector se tuerce e inyecta strafe lateral parasito -> veer. En avanzar()
    (PWM 100) no satura -> por eso NO derivaba ahi. El escalado-vector (escala las 3 ruedas por
    el mismo factor, preserva direccion) es justo el fix.
    Restaurado avanzar_patear del red-team (4e20a68): escalado-vector + gate de confidence
    por-tic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
    [mix_config.h, mix_motors.cpp]
2026-06-22 fix(arqueromix quieto): retroceso mas lento (no meterse al area) + gate frescura DOWN
    Banco Virginia: el retroceso recto (Fase 2a) paraba en la linea pero a
    AMIX_ATRAS=120 se METIA al area chica (cruzaba la linea por inercia + latencia).
    Fix 1: velocidad separada del retroceso del quieto AMIX_ATRAS_QUIETO=80 (vs
    AMIX_ATRAS=120 de la patrulla, intacta) + primitiva retroceder_quieto(). Mas
    lento -> para mas justo en la linea sin cruzarla. Knob: si aun se mete, 75.
    Fix 2 (seguridad "nunca salirse de la cancha"): gate de frescura del enlace DOWN.
    La linea se lee cada tick (amix_comm refresca line_present/depth antes del FSM);
    ademas, si down_link_fresh==false (enlace caido >500ms) el arquero N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
    [amix_config.h, amix_fsm.cpp, amix_motors.cpp, amix_motors.h]
2026-06-22 feat(arqueromix quieto): consciencia de linea al BUSCAR la pelota (no meterse de costado)
    Banco Virginia: el arquero se metia al area de COSTADO mientras buscaba la pelota
    -> el strafe lateral de esperar_quieto (enfrentar pelota descentrada) no chequeaba
    la linea.
    Fix (idea de Virginia): en esperar_quieto, pelota descentrada + hay linea (o DOWN
    no fresco) -> avanzar() al frente a buscarla en vez de seguir lateral. El avance la
    aleja del fondo/area y la acerca a la pelota; apenas despega del borde (!linea())
    vuelve al strafe lateral. Avanzar va hacia el campo = seguro, nunca al area.
    Pendiente borde total: inicio_lateral_izq (strafe 1.6s a ciegas al arranque).
    central_robot2_arqueromix_qui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
    [amix_fsm.cpp]
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2026-06-22 feat(arqueromix quieto): FRENO ACTIVO de patada al detectar linea (la inercia lo sacaba)
    Banco Virginia 2026-06-22: cortar el golpe con parar() NO frenaba la inercia -> el
    arquero se salia igual de la cancha al detectar linea pateando.
    Fix (pedido "ir mas rapido hacia atras"): estado nuevo frenar_patada. Al detectar
    linea en PATEANDO_adelante (modo quieto), en vez de la pausa va al freno:
    contra-empuje FUERTE hacia atras (frenar_atras, AMIX_FRENO_PATADA_PWM=200) por un
    tiempo corto (AMIX_T_FRENO_PATADA=250ms) para MATAR el impulso del golpe (plugging,
    estilo 2025) y despegarse de la linea; recien ahi sigue la secuencia post-patada
    (pausa -> orientar -> retroceder). No chequea linea (esta so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
    [amix_config.h, amix_fsm.cpp, amix_fsm.h, amix_motors.cpp, amix_motors.h]
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2026-06-22 feat(centralmix): jugada "pelota atras" (camara trasera) - giro-encare sobre el piso
    Cuando la camara trasera ve la pelota (queda detras, ball_y_cm<0, angulo~=±180), el
    apuntado fino 2025 giraba a 35 PWM (bajo el piso {70,70,107} -> zumba clavado) y el
    angulo saltaba ±180 -> el delantero quedaba clavado ~10s. Ahora, guard en APUNTAR_PELOTA:
    gira EN EL LUGAR a MIX_ATRAS_PWM (120, sobre el piso) hasta encarar (|ang|<15), gateado
    por ball_y_cm (senal monotona, NO el angulo que salta), con LATCH de sentido (anti-±180)
    reseteado en las 5 salidas del case + init. Giro PURO (3 ruedas mismo signo) -> no traslada
    la pelota (no agrava gol en contra; CENTRANDO igual alinea al arco antes de patear).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
    [main_centralmix.cpp, mix_config.h, mix_fsm.cpp, mix_io.h]
2026-06-22 fix(arqueromix quieto): orientar de frente al ARCO CONTRARIO (el giroscopio derivaba)
    Banco Virginia 2026-06-22: orientar_frente y acomodar_orientar no dejaban al
    arquero de frente al arco. Causa: usaban el GIROSCOPIO (heading_error->0), pero el
    cero del giroscopio se sella al arranque y DERIVA -> heading=0 ya no apunta al arco
    real (riesgo P1-3 de la critica adversarial inicial).
    Fix (idea Virginia "que quede de frente al arco contrario"): helper comun
    orientar_de_frente_tick() que gira DESPACIO (al piso) hacia el ARCO CONTRARIO
    (goal_opp_angle->0, AMIX_TOL_ARCO_OPP_DEG=12), usando la CAMARA como referencia
    ABSOLUTA al arco (se ensucia al girar rapido, pero al piso/despacio se usa bien).
    F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
    [amix_fsm.cpp]
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2026-06-22 docs(top tof): marcar bus a 400 kHz VALIDADO en hardware (R1 + R2) y corregir info stale
    Gustavo confirmo en placa que AMBOS robots andan a 400 kHz. Se actualiza toda la
    info de "NO VALIDADO" -> "VALIDADO 2026-06-22" y se corrigen las afirmaciones
    ahora-falsas de "bus a 100 kHz / BNO+ToF no coexisten a 400".
    - doc TOF-BUS-400KHZ-PLAN-PRUEBAS: estado -> VALIDADO (registro del plan corrido)
    - sensors_tof.cpp / platformio.ini (R1+R2): comentarios -> VALIDADO
    - journal: seccion de validacion + frontmatter -> VALIDADO
    - ESTADO-ACTUAL: bus de ToF a 400 (primario en Wire2, ya coexisten; boot ~9,6 s)
    - ARQUITECTURA-SENSORIAL-TOP / FIRMWARE-PLACA-ARRIBA / REFERENCIAS-POR-ROBOT:
    baseline 100 kHz, r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
    [sensors_tof.cpp]
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2026-06-22 feat(arqueromix): S0 — exponer velocidad de pelota a g_aio (habilitador anticipacion)
    Analisis integral (workflow 6 agentes: otros equipos + codigo + planta + critica
    adversarial) de como el arquero puede anticipar/bloquear la pelota.
    Hallazgo clave (corrige premisa): la latencia del dato de pelota NO es 250ms (eso
    era de heading) -> el snapshot va a 100Hz, la pelota a ~30Hz -> ~40-80ms. La
    anticipacion ES factible; lo que limita es la velocidad del arquero. La MAGNITUD de
    vx/vy NO esta calibrada -> usar SOLO el SIGNO/direccion.
    S0 (este commit): amix_comm copia ball_vx/vy del snapshot a g_aio (campos nuevos en
    amix_io.h). HABILITADOR: nadie la lee aun -> conducta byte-identica. Paso de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
    [amix_comm.cpp, amix_io.h]
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2026-06-22 revert: deshacer +velocidad (PD_BALL 2.0) y orientado-busca-arco (anduvo peor en banco)
    Banco Virginia: el commit 67e820b (A: AMIX_PD_BALL 1.5->2.0; B: orientar_de_frente_tick
    sigue girando a buscar el arco) anduvo PEOR -> orientacion y "busqueda" empeoraron, y
    con pd alto el strafe se DESVIABA. git revert -> vuelta al estado que andaba mejor
    (PD_BALL=1.5, orientado original que se conforma con el giroscopio si no ve el arco).
    Aprendizaje: subir pd NO es la forma de ganar velocidad lateral (amplifica TAMBIEN la
    correccion de rumbo -> se desvia, confirmando la critica adversarial). Proximo intento:
    velocidad lateral PURA sin desviarse (kickstart lateral / subir solo traslacion / desacoplar
    t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
    [amix_config.h, amix_fsm.cpp]
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2026-06-22 feat(centralmix): camino CORTO al centrar - sentido de orbita por vision + heading respaldo
    Al orbitar la pelota para alinearla al arco, el robot arrancaba SIEMPRE para el mismo lado
    y a veces daba la vuelta larga. Ahora elige el sentido por el camino corto, en cascada
    (espejo del disparo de patada):
    1) VISION (medida verdadera): si ve el arco, orbita hacia su lado (signo de goal_opp_angle,
    perilla MIX_CENTRAR_SHORT_SIGN). Ya estaba; es correcta cuando se ve el arco.
    2) HEADING (respaldo, arco NO visible + heading_valid): orbita hacia el rumbo de arranque.
    PERILLA PROPIA MIX_CENTRAR_HEAD_SIGN, default 0 = APAGADO hasta titular en banco.
    3) DEFAULT: horario fijo (viejo).
    Red-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
    [mix_config.h, mix_fsm.cpp]
2026-06-22 refactor(centralmix): sacar la VIA 2 (heading respaldo) del camino-corto - pedido Elias
    Elias lo arregla a mano despues. Queda SOLO la VIA 1 (vision, MIX_CENTRAR_SHORT_SIGN) +
    default horario cuando no se ve el arco. Se removio MIX_CENTRAR_HEAD_SIGN y la rama de
    heading. No se toca la jugada pelota-atras ni la patada. El analisis del signo del heading
    queda en el journal para cuando Elias lo retome.
    Compila central_robot1_mix_bno -> SUCCESS.
    [mix_config.h, mix_fsm.cpp]
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2026-06-22 revert(centralmix): sacar el debug del estado (ST=/Ld=/mix_fsm_estado_nombre)
    El "diagonal a la derecha" era HARDWARE: un pedazo de cinta tapaba un sensor de linea de
    DOWN -> reportaba blanco siempre -> la FSM escapaba la linea (retroceder1 = diagonal) sin
    parar. No era bug de codigo. Elias lo encontro y lo saco. Se revierte todo el debug que
    habia agregado para diagnosticar (commit b35a78d + el Ld=): los 3 archivos quedan EXACTOS
    al estado previo (23e15ec).
    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
    [main_centralmix.cpp, mix_fsm.cpp, mix_fsm.h]
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2026-06-25 feat(top): espera de 3s al boot antes de calibrar el BNO (gateado) + lectura de los 2 BNO en el promediador
    Virginia: el BNO055 sella MAL el heading si el robot se MUEVE durante el arranque (bias del
    giroscopio + captura del heading inicial). Pasaba en banco: lecturas invalidas; reseteo sin
    mover -> heading OK. (Descarta que el modo continuo de los ToF sea el culpable.)
    - main_top.cpp: delay TOP_BNO_SETTLE_MS al boot, DESPUES de dormir los ToF (bus quieto) y ANTES
    del cronometro de imu_init (no infla el boot timing). Avisa por consola "MANTENE EL ROBOT
    QUIETO". GATEADO: competencia (top_robot2_pri) sigue BYTE-IDENTICA (md5 .hex a36e934e..., igual
    al baseline). Recomendacion: activarlo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
    [main_top.cpp]
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2026-06-29 feat(arqueromix): PATEO CORTO sobre la línea (gateado) — env central_robot2_arqueromix_kickcorto
    Problema (banco/cancha Virginia): al despejar, el arquero se SALE de la línea — el golpe completo (450 ms)
    lo lleva por inercia y el freno reactivo (frenar_patada) llega tarde.
    FIX opcion 1 (como el delantero centralmix con su PATEANDO_corto): si el despeje ARRANCA con el arquero
    SOBRE la línea (s_kick_corto = linea() al entrar a PATEANDO_adelante, en ALINEAR), el golpe es CORTO
    (AMIX_T_PAT_ADELANTE_CORTO=250 ms vs 450) → menos envión → no se sale. Si hay lugar, golpe completo. La
    línea + frenar_patada siguen igual (red de seguridad).
    GATEADO -DARQMIX_KICK_SHORT_ON_LINE: el candida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
    [amix_config.h, amix_fsm.cpp]
2026-07-01 feat(arqueromix): retroceso post-pateo "hasta la línea + escape adelante" (gateado, env _retrofreno)
    El arquero volvía del pateo y cruzaba / se metía a su línea. Fix espejo del homing,
    gateado en -DARQMIX_RETRO_BRAKE_ON_LINE (env central_robot2_arqueromix_retrofreno):
    - PATEANDO_atras retrocede HASTA detectar la línea (sin el gate de frescura ni el safety
    corto de 4 s que lo cortaban antes; queda una red anti-cuelgue grande).
    - Al pisar la línea -> estado nuevo escapar_adelante: avanza al frente HASTA despegarse
    (avanzar_inicio, condición no tiempo), espejo de inicio_avanzar del homing.
    - Revisión adversarial: re-agregado corte por DOWN-muerto (!down_link_fresh) en el
    retroceso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
    [amix_config.h, amix_fsm.cpp, amix_fsm.h]
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2026-07-03 centralmix: fix kickoff — avanzar_patear() (faltaban paréntesis) + recoil
    El case KICKOFF_SEEK tenía `avanzar_patear;` SIN paréntesis → no llamaba a la
    función (instrucción vacía) → el robot no pateaba al saque. Fix:
    - fase 1 (0..MIX_KICKOFF_ARC_MS): avanzar_patear() → empuje recto del saque.
    - fase 2 (+200 ms): retroceder_patear() → recoil corto; ADEMÁS
    cierra la rampa de patada (s_kick_active) para que la 1ª patada real posterior
    vuelva a arrancar desde el piso y con rumbo nuevo (si no, saldría a 240 fija
    hacia el rumbo del saque).
    - fase 3: parar() → IMPULSO_INICIAL_GIRANDO.
    Conserva los escapes de línea y el knob MIX_KICK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
    [mix_fsm.cpp, mix_fsm.h]
2026-07-03 centralmix: kickoff SOLO avanza (sin recoil) — pedido Elías
    Saca el retroceso del saque: el kickoff solo hace avanzar_patear() durante
    MIX_KICKOFF_ARC_MS y luego parar() → IMPULSO_INICIAL_GIRANDO. El recoil ya no
    hace falta para resetear la rampa de patada: parar() YA cierra s_kick_active
    (mix_motors.cpp:132), así que la próxima patada real re-ancla bien igual.
    Solo mix_fsm.cpp/.h. Syntax-check host OK. NO testeado en hardware.
    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
    [mix_fsm.cpp, mix_fsm.h]
2026-07-03 feat(arqueromix): _evita_lejos — anti-choque + golpe mas largo + escape al buscar mayor (gateado)
    6to programa (pedido Maria 2026-07-03): copia del _evita (anti-choque) con 2 tweaks,
    todo gateado y aditivo:
    - golpe MAS LARGO: AMIX_T_PAT_ADELANTE 450 -> 550 ms bajo -DARQMIX_KICK_FAR (la pelota va mas lejos).
    - escape de linea al BUSCAR mayor: AMIX_T_BUSCAR_AVANCE 400 -> 500 ms bajo -DARQMIX_BUSCAR_AVANCE_LARGO.
    Env central_robot2_arqueromix_evita_lejos = base + AVOID_OBSTACLE + KICK_FAR + BUSCAR_AVANCE_LARGO.
    Los 5 checkpoints (_quieto/_kickcorto/_retrofreno/_evita/_retrotiempo) BYTE-IDENTICOS
    (md5 sin cambio). Hereda el chequeo bloqueante del _evita (pelota vs anti-choque, TASK-121).
    NO v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
    [amix_config.h]
2026-07-03 feat(arqueromix): _evita_lejos_rehome — re-homing por perdida de pelota (7mo, gateado)
    7mo programa (pedido Maria 2026-07-03) = copia del _evita_lejos + una funcion nueva
    gateada -DARQMIX_REHOME_NO_BALL: si el arquero pasa AMIX_T_REHOME_NO_BALL = 15 s SIN ver
    la pelota (esperando quieto), vuelve una vez HACIA ATRAS hasta detectar la linea y se
    acomoda (escape), luego sigue esperando. Reusa el homing (inicio_retroceder -> inicio_avanzar
    -> acomodar_linea -> orientar -> esperar). Reloj s_rehome_ref_ms se resetea al ver la pelota
    y al disparar (no loop). Env central_robot2_arqueromix_evita_lejos_rehome.
    Los 6 checkpoints anteriores BYTE-IDENTICOS (md5 sin cambio). OJO: el retroceso del re-ho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
    [amix_config.h, amix_fsm.cpp]
2026-07-03 feat(arqueromix): _centrado_fino — banda muerta angular 8->5 grados (8vo, gateado)
    8vo programa (pedido Maria 2026-07-03) = copia del _evita_lejos_rehome + flag nuevo
    -DARQMIX_CENTRADO_FINO: AMIX_TOL_CENTRADO_DEG 8 -> 5 grados. Motivo (banco Maria con
    _evita_lejos): la banda del seguimiento es POR ANGULO -> el corrimiento lateral aceptado
    crece con la distancia (~14% a 8 grados; pelota a 1,5 m = hasta ~21 cm corrido y el FSM
    lo daba por centrado). A 5 grados baja a ~9%. NO arregla el 'queda torcido' (nada
    re-orienta en la espera; lo mitiga el re-homing heredado del #7).
    Env central_robot2_arqueromix_centrado_fino. Riesgo a titrar: banda angosta + piso de
    PWM = micro-strafes que no terminan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
    [amix_config.h]
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
